AkimaraYouki/SummerProject/docs/reports/jetson_workorder_2026-08-10.md

# 작업지시 — v40 실기 주저앉음 수정 (2026-08-10)

대상: 잿슨 `parksuho@192.168.137.7` 의 `~/rl_walk.py`, `~/rustypot_hwi.py`
로봇: Open Duck Mini V2, 2.7430 kg, XM430-W350 14축, U2D2 `/dev/ttyUSB0`

이 문서만 읽고 작업할 수 있게 썼다. 배경 지식은 아래 "무슨 일이 있었나" 로 충분하다.

---

## 무슨 일이 있었나

10:07 에 배포한 `~/policy_v40/policy.onnx` 로 10:11 에 돌린 `~/rl_walk_log.csv`
(237 스텝 / 4.96 s) 분석 결과, **로봇이 0.5 초 만에 뒤로 주저앉았다.**

| t (s) | 몸통 피치 | 왼무릎 목표 | 왼무릎 실제 | 차 |
|---|---|---|---|---|
| 0.04 | −2.3° | −90.7° | −92.0° | −1.3° |
| 0.30 | −10.1° | −98.7° | −94.1° | +4.6° |
| 0.42 | −12.9° | −82.2° | −102.7° | **−20.5°** |
| 0.50 | −21.7° | −76.2° | −102.9° | **−26.7°** |
| 0.60 | −39.7° | −62.8° | −104.2° | **−41.3°** |

정책은 무릎을 **펴라고** (−99° → −63°) 명령하는데 실제 무릎은 −103° 에 붙박여 있다.
오차가 한 방향으로 단조 증가한다 — 진동이 아니라 밀림이다. 모터가 몸무게에
역구동된 것이다.

원인은 두 가지이고 **서로 독립**이다.

---

## 원인 1 — 전류 상한이 정책이 기대하는 토크의 40 % 밖에 안 된다

`~/rustypot_hwi.py`:
```python
CURRENT_UNIT_MA = 2.69
def __init__(self, port="/dev/ttyUSB0", current_limit=350):
```
`~/rl_walk.py`: `ap.add_argument("--current", type=int, default=350, ...)`

```
350 unit × 2.69 mA = 941 mA
XM430-W350 : 스톨 4.1 N·m @ 2.3 A   (토크 ∝ 전류)
→ 실기에서 낼 수 있는 토크 ≈ 4.1 × 0.941 / 2.3 ≈ 1.68 N·m
```

학습한 심의 `effort_limit_sim` 은 **4.1 N·m** 이다. 심에서 이 정책의 보행 중
무릎 토크를 실측하면:

| 관절 (심, 보행) | RMS | 99 % | 최대 | 실기 천장 |
|---|---|---|---|---|
| left_knee | 1.229 | **3.393** | 4.100 (심 클램프) | **1.68** |
| right_knee | 1.193 | 3.032 | 4.100 | 1.68 |
| left_hip_roll | 1.039 | 2.934 | 4.100 | 1.68 |

평균은 천장 아래지만 **99 퍼센타일이 천장의 두 배**다. 정책이 의존하는 피크
토크를 실기가 못 낸다.

`rl_walk.py` 주석이 이미 예고하고 있었다:
> 전류 제한 (기본 350 unit = 0.94 A) — 다리가 실제 보행 부하를 못 버티고
> 멈추면(주저앉으면) `--current` 를 올릴 것. **이 값은 걷기용으로 검증된 적이 없다.**

### 할 일 1

`--current` 를 **350 → 700** (1.88 A ≈ 3.35 N·m) 으로 올려 시험한다.
**코드 기본값은 바꾸지 말고 실행 인자로만 준다** — 되돌리기 쉽게.

```bash
python3 ~/rl_walk.py --current 700 ...   # 나머지 인자는 기존과 동일하게
```

**안전 조건 (반드시 지킬 것)**
* 로봇을 **매달아 놓고** 먼저 돌린다. 바닥에 세우지 않는다.
* 한 번에 **10 초 이내**로 끊는다.
* 매 시험 전후로 모터 온도를 읽는다. **55 °C 넘으면 즉시 중단하고 식힌다.**
  (XM430 기본 셧다운 온도는 80 °C 지만 그 전에 멈춘다.)
* 스톨 전류를 지속하면 코일이 탄다. 700 은 **피크 여유용**이지 상시 운전값이 아니다.
* 이상한 소리·발열·관절 걸림이 보이면 `sss` + 엔터로 즉시 비상정지.

**700 으로도 무릎이 안 펴지면 더 올리지 말 것.** 그건 전류 문제가 아니라는 뜻이고,
그때는 기계적 간섭이나 감속비/링키지를 의심해야 한다. 보고만 하고 멈춘다.

---

## 원인 2 — 중력 관측이 생 가속도라 오염돼 있다

`~/rl_walk.py` 413 행 근처:
```python
accel_arr = np.array(accel, dtype=np.float32)
grav_norm = np.linalg.norm(accel_arr) or 1.0
projected_gravity = -accel_arr / grav_norm     # ← 생 가속도계를 정규화한 것
```

정책이 학습한 심의 `projected_gravity_b` 는 몸통 쿼터니언에서 뽑은 **참 중력 방향**
이라 잡음이 0 이다. 실기는 접지 충격 가속도가 그대로 섞인다:

| 측정 | 값 |
|---|---|
| accel 크기 평균 | 10.09 m/s² (중력만이면 9.81 고정이어야 함) |
| 9.81 에서 벗어난 정도 | 평균 1.63, 최대 **9.01** m/s² |
| 1 m/s² 넘게 벗어난 스텝 | **64.6 %** |
| 피치 인접샘플 변화 | 평균 7.0°, 최대 **35.1°** (20 ms 간격) |

2.7 kg 로봇이 20 ms 에 35° 를 기울일 수는 없다. **정책이 매 스텝 거짓 자세를
관측하고 있다.** 관측 107 차원 중 3 개가 쓰레기면 그 위에서 나오는 액션도 쓰레기다.

### 이미 칩 안에 정답이 있다

IMU 는 **BNO055** 이고 `~/rl_walk.py` 의 `Imu._wake()` 가 `MODE_NDOF (0x0C)` 로
설정한다 — 9축 센서 융합이 **이미 돌고 있다**. NDOF 모드에서 BNO055 는 융합 결과로
중력만 분리한 벡터를 `GRV_DATA (0x2E)` 에 내놓는다. 그런데 코드는 생 가속도인
`ACC_DATA (0x08)` 를 읽고 있다. **레지스터 주소 하나 문제다.**

BNO055 레지스터 (참고):
| 주소 | 내용 |
|---|---|
| 0x08 | ACC_DATA — 생 가속도 (중력 + 선형가속도) ← 지금 읽는 것 |
| 0x14 | GYR_DATA — 자이로 |
| 0x28 | LIA_DATA — 선형가속도만 (중력 제거) |
| **0x2E** | **GRV_DATA — 중력만 (선형가속도 제거)** ← 써야 할 것 |

`GRV_DATA` 의 LSB 스케일은 `ACC_DATA` 와 같다 (m/s² 단위 모드에서 100 LSB = 1 m/s²).
즉 `ACC_LSB = 100.0` 을 그대로 쓰면 된다.

### 할 일 2

`~/rl_walk.py` 를 다음과 같이 고친다.

**(a) 레지스터 상수 추가** — `REG_ACC_DATA = 0x08` 옆에:
```python
REG_GRV_DATA = 0x2E     # BNO055 NDOF 융합 중력벡터 (선형가속도 제거됨)
```

**(b) `Imu.read()` 가 중력벡터도 돌려주게 한다.** 현재:
```python
def read(self):
    """(gyro_trunk[rad/s], accel_trunk[m/s^2, 중력 포함]) — 몸통 프레임으로 리맵."""
    a = self._vec(REG_ACC_DATA, ACC_LSB)
    g = self._vec(REG_GYR_DATA, GYR_LSB)
    g = tuple(v * math.pi / 180.0 for v in g)
    m = self.axis_matrix
    a_t = tuple(sum(m[i][j] * a[j] for j in range(3)) for i in range(3))
    g_t = tuple(sum(m[i][j] * g[j] for j in range(3)) for i in range(3))
    ...
```
여기에 `grv = self._vec(REG_GRV_DATA, ACC_LSB)` 를 추가하고, **`axis_matrix` 를
가속도와 똑같이 적용해서** (같은 센서 좌표계다) 세 번째 값으로 함께 돌려준다.
생 가속도(`a_t`)는 로그에 계속 남겨야 하니 **지우지 말 것**.

**(c) `projected_gravity` 를 융합 출력으로 바꾼다.**
```python
grv_arr = np.array(grav_trunk, dtype=np.float32)
n = np.linalg.norm(grv_arr) or 1.0
projected_gravity = -grv_arr / n
```
부호 규약은 **기존과 똑같이 유지한다** (`-vec/|vec|`). 심의
`projected_gravity_b` 는 똑바로 섰을 때 `(0, 0, -1)` 이다. 로그 첫 줄에서
기존 코드가 `(0.0394, −0.0488, −0.9980)` 을 냈으니 규약은 맞다 —
**바꾸면 안 된다.**

**(d) CSV 로그에 열 3개를 추가한다**: `grav_x, grav_y, grav_z` (융합 원값).
기존 `accel_*` 와 `proj_grav_*` 열은 **그대로 두고 추가만** 한다. 그래야 이번
로그와 다음 로그를 같은 분석기로 비교할 수 있다.

---

## 검증 (각 수정을 따로 확인할 것)

**두 수정을 한꺼번에 넣고 돌리지 말 것.** 하나씩 넣고 각각 로그를 남긴다.
그래야 어느 쪽이 효과였는지 알 수 있다. 이 프로젝트의 원칙이 "한 번에 하나만" 이다.

순서는 **원인 2 (중력) 먼저** — 코드 한 줄이고 과열 위험이 없다.

### 시험 1 — 중력 수정만 (전류는 350 그대로)
매달아 놓고 정지 명령으로 10 초. 로그를 `~/rl_walk_log_grv.csv` 로 남긴다.

합격 기준 (분석기로 자동 확인 가능):
| 항목 | 지금 | 목표 |
|---|---|---|
| 중력벡터 크기가 9.81 에서 벗어난 정도 (평균) | 1.63 m/s² | **< 0.3** |
| 피치 인접샘플 변화 (최대, 20 ms) | 35.1° | **< 5°** |

중력벡터는 정의상 크기가 항상 ~9.81 이어야 한다. 여전히 흔들리면 융합이 아직
캘리브레이션 안 된 것이다 — BNO055 캘리브레이션 상태 레지스터 `CALIB_STAT (0x35)`
를 읽어서 sys/gyro/accel/mag 각 2 bit 가 3 인지 확인하고 보고할 것.

### 시험 2 — 중력 수정 + 전류 700
**매달아 놓고** 전진 명령으로 10 초 이내. 로그를 `~/rl_walk_log_grv_cur700.csv` 로.

합격 기준:
| 항목 | 지금 | 목표 |
|---|---|---|
| 무릎 목표−실제 오차 RMS (왼) | 28.10° | **< 8°** |
| 무릎 오차가 단조 증가하는가 | 예 (41° 까지) | **아니오** |
| 몸통 피치 평균 | −35.0° | **> −10°** |

무릎 오차가 여전히 단조로 벌어지면 전류 문제가 아니다 — 더 올리지 말고 보고할 것.

### 분석 도구
랩PC 쪽 리포에 심 측정과 **같은 정의**로 재는 분석기가 있다:
```
scripts/hw/analyze_hw_log.py <로그.csv>
```
로그를 랩PC 로 가져가 이걸 돌리면 위 표의 항목이 전부 한 번에 나온다.

---

## 하지 말 것

* **전류를 700 초과로 올리지 말 것.** 안 되면 원인이 다른 데 있는 것이다.
* **바닥에 세워놓고 시험하지 말 것.** 전부 매달아 놓고 한다.
* `projected_gravity` **부호 규약을 바꾸지 말 것** (`-vec/|vec|` 유지).
* 기존 CSV 열을 **지우거나 순서를 바꾸지 말 것** (추가만).
* `~/policy_v40/policy.onnx` 를 포함해 **기존 정책 파일을 지우지 말 것.**
* `rustypot_hwi.py` 의 `current_limit` **기본값(350)을 바꾸지 말 것** — 실행 인자로만.

## 보고할 것

1. 각 시험의 CSV 파일 경로
2. 위 합격 기준 표의 실제 수치
3. 모터 온도 (시험 전/후)
4. `CALIB_STAT (0x35)` 값 (시험 1 에서 중력이 여전히 흔들릴 경우)
5. 눈으로 본 것 — 관절이 걸리는지, 소리, 발열

## 참고

* 원인 분석 전문: 랩PC 리포 `docs/reports/hw_v40_collapse_2026-08-10.md`
* 원본 로그: `docs/hw_logs/rl_walk_v40_2026-08-10.csv`
* 남은 별개 문제 (이번 작업 범위 아님): 제어 주기가 평균 21.0 ms (47.6 Hz),
  최대 76.2 ms 로 튄다. 목표는 20 ms 다. 주된 원인은 아니지만 여유를 깎는다.
* 심 쪽에서는 `effort_limit_sim` 을 실기 천장에 맞춰 재학습하는 작업이 별도로
  진행될 예정이다. 이번 시험에서 확정되는 "실제로 쓸 수 있는 전류/토크" 가
  그 목표값이 된다 — 그래서 위 수치 보고가 중요하다.
