AkimaraYouki/SummerProject/docs/versions.md

# 버전 색인

`scripts/diag/versions.py` 가 cfg 독스트링에서 생성한다. 손으로 고치지 말 것.

점수는 6 방향 우선순위 가중(앞뒤 3 : 회전 2 : 옆 1), 낮을수록 좋다.
roll RMS 는 이동 5 방향 평균, 낙상은 |roll| > 40 도 표본 비율의 최댓값 —
`scoreboard.py` 와 같은 정의다. 빈칸은 아직 측정하지 않은 버전이다.

| 버전 | 부모 | 무엇을 바꿨나 | 점수 | rollRMS | 낙상 |
|---|---|---|---|---|---|
| **V35** | V34C10 | v34c10 + 정지 시 몸통 수직을 중력벡터로 직접 요구 | 0.0232 |  |  |
| **V36** | V35 | v35 + 정지 좌우 대칭 + 액션 저역통과를 학습에 포함 | 0.0195 |  |  |
| **V37** | V36 | v36 에서 저역통과를 정지에만 건다. 한 가지만 바뀐다 | 0.0145 |  |  |
| **V38** | V37 | v37 에서 hip_inward 를 보행 중에만 건다. 한 가지만 바뀐다 |  |  |  |
| **V39** | V38 | 저역통과 필터를 완전히 빼고, 진동을 리워드로 억제한다 | 0.0179 |  |  |
| **V40** | V39 | v39 에서 action_rate 를 절반으로 낮춘다. 한 가지만 | 0.0183 | 6.28 | 2.1% |
| **V41** | V40 | 액추에이터를 DCMotor 로. 토크-속도 결합 하나만 바뀐다 | 0.0205 |  |  |
| **V42** | V41 | 대칭으로 다시 뽑은 레퍼런스(ref_g125sym). 하나만 바뀐다 | 0.0107 | 6.57 | 0.6% |
| **V43** | V42 | 액션 지연을 실측 고정값으로. 하나만 바뀐다 |  |  |  |
| **V44** | V42 | 질량 무작위화 범위를 넓힌다. 하나만 바뀐다 | 0.0336 | 6.31 | 0.6% |
| **V46** | V44 | 몸통을 10 mm 더 세운다 (ref_g135sym). 하나만 바뀐다 | 0.0169 | 6.10 | 0.8% |
| **V47** | V46 | 액션 지연을 실측에 맞춘다 (2~3 스텝). 하나만 바뀐다 | 0.0241 | 5.80 | 0.6% |
| **V48** | V47 | action_rate 를 v40 이전으로 되돌린다 (-0.25 -> -0.5). 하나만 | 0.0314 | 7.57 | 1.2% |
| **V49** | V48 | v48 + 속도 한계를 직접 낮춘다 (4.82 -> 3.50 rad/s) |  |  |  |
| **V50** | V47 | 지면 마찰을 1.0 -> 0.5 로 낮춘다. 하나만 |  |  |  |
| **V51** | V47 | 발 들림을 절반으로 (ref_g135fh20). 레퍼런스만 바뀐다 |  |  |  |
| **V52** | V51 | 보간격을 좁힌다 (feet_spacing 0.18 -> 0.14). 레퍼런스만 |  |  |  |
| **V53** | V48 | 발의 좌우 움직임을 직접 벌한다. 리워드 두 항 |  |  |  |
| **V55** | V48 | 부드러움 패키지. 발은 직선으로, 몸통·다리는 감쇠 | 0.0463 | 2.64 | 0.0% |
| **V56** | V55 | v55 + 부드러운 착지. "퉁퉁거림" 의 정체를 잡았다 |  |  |  |
| **V57** | V47 | 순수 단일축 명령을 학습에 넣는다. 1 순위를 직접 겨냥 | 0.0310 | 5.56 | 0.3% |
| **V58** | V47 | 액션 지연을 다시 넓힌다 (2~3 -> 0~3). 하나만 바뀐다 | 0.0349 | 6.17 | 0.9% |
| **V59** | V58 | v58 + 질량 무작위화를 원래 범위로. 하나만 바뀐다 | 0.0165 | 6.66 | 0.8% |
| **V60** | V59 | v59 + 몸통 각속도 감쇠. 2 순위(안정성)를 정공법으로 | 0.0304 | 3.73 | 0.6% |
| **V61** | V59 | 흔들림의 원인을 친다. 명령 상대 발 좌우 억제 | 0.0221 | 4.97 | 0.7% |
| **V62** | V61 | v61 + 옆 명령일 때 발 좌우 억제를 푼다. 하나만 | 0.0223 | 5.39 | 1.0% |
| **V63** | V59 | v59 + 미끄러운 바닥도 겪게 한다. 하나만 바뀐다 | 0.0294 | 7.06 | 1.4% |
| **V64** | V59 | 보간격을 넓힌다 (0.18 -> 0.22). 레퍼런스만 바뀐다 | 0.0303 | 5.52 | 1.2% |
| **V65** | V59 | 레퍼런스는 몸통을 수평으로 유지하라고 이미 말하고 있다 | 0.0138 | 4.89 | 1.9% |
| **V66** | V65 | 딛는 발은 정지해 있어라. 미끄러짐의 진짜 처방 | 0.0219 | 5.81 | 1.4% |
| **V67** | V65 | 쩍벌을 막는다. 벌어지는 쪽엔 제동이 없었다 | 0.0194 | 5.41 | 2.1% |
| **V68** | V65 | 낙상은 보수적으로, 토크는 세게. 탐색은 넓혀서 벌충 | 0.0204 | 4.05 | 1.1% |
| **V69** | V68 | v68 + 토크 벌점을 절반으로. 후진을 되찾는다 | 0.0232 | 4.22 | 1.8% |
| **V70** | V65 | 몸통 CoM 을 뒤로 10 mm | 0.0307 | 4.32 | 0.9% |
| **V71** | V65 | 몸통 CoM 을 뒤로 15 mm |  |  |  |
| **V72** | V65 | 몸통 CoM 을 뒤로 20 mm |  |  |  |
| **V73** | V70 | v70 + 발바닥 접지면을 키운다. 발 하나만 바뀐다 | 0.0269 | 4.71 | 1.2% |
| **V74** | V73 | 큰 발 + CoM -10 mm 위에 토크·낙상·탐색 묶음 | 0.0140 | 5.05 | 1.1% |
| **V75** | V74 | v74 + 토르소 각속도 벌점. 좌우 휘청거림을 직접 친다 | 0.0170 | 2.25 | 0.0% |
| **V76** | V75 | v75 + robustness. 도메인 랜덤화 폭만 넓힌다 |  |  |  |
| **V77** | V75 | v76 의 재시도. 외란은 그대로 두고 바닥·서보만 넓힌다 | 0.0265 | 3.11 | 0.3% |
| **V33N** | ZNeck | v33 에서 CAD 모델과 보행 궤적만 새것으로 바꾼 것 | 0.0319 |  |  |
| **V34C** | V33N | v33n 그대로 + 정지에서 보행 위상 고정 하나만 | 0.0244 |  |  |
| **V34U** | V34C10 | v34c10 + 정지 목표 자세를 몸통 수직으로 | 0.0191 |  |  |
| **V34C2** | V34C | v34c 로 부족할 때 쓸 후속: 정지 벌점을 5배로 | 0.0242 |  |  |
| **V34C10** | V34C | v34c(정지 위상 고정) + 레퍼런스 높이 +10 mm (ref_g125) | 0.0195 |  |  |
| **V34C20** | V34C | v34c(정지 위상 고정) + 레퍼런스 높이 +20 mm (ref_g135) | 0.0216 |  |  |
