AkimaraYouki/SummerProject/docs/map.md

# 어디에 뭐가 있나

2026-07-30 작성. `scripts/`에 34개 파일이 평평하게 쌓여 있어서 뭘 열어야 할지
알 수 없다는 지적을 받고, 폴더를 나누면서 같이 쓴 지도다.

## 먼저 이것만 알면 된다

거의 모든 일은 `odm` 하나로 한다. 나머지는 대부분 "그때 한 번 쓴 것"이다.

    odm train  [ver] [iters] [envs]   학습
    odm watch  [ver]                  진행 한 줄
    odm play   [ver]                  재생 (네이티브 창)
    odm play   [ver] --joystick       Xbox 패드로 실시간 조종
    odm measure[ver] [iter]           6방향·주기성·리워드 성분 (iter 주면 그 체크포인트)
    odm tb     [from]                 텐서보드 (기본 v26부터 겹침)
    odm test                          테스트 전부
    odm stop / odm list

## 실험을 판정할 때 쓰는 것 (2026-07-30 추가)

학습 중에는 Isaac Sim 을 두 개 못 띄우므로 `odm measure` 를 못 쓴다. 그래서
**학습 중에 쓰는 것**과 **끝난 뒤에 쓰는 것**이 갈린다.

학습 중 (GPU 불필요, 텐서보드 이벤트만 읽는다):

    scripts/train_health.py --run <런디렉터리>
        lr 바닥 / std 붕괴 / 에피소드 포화 / **리워드 해킹**을 판정한다.
        판정 기준은 이 프로젝트가 실제로 겪은 실패에서 가져왔다.
    scripts/diag/compare_runs.py <런A> <런B> [--at 500 1000 ...]
        여러 런을 **같은 iteration** 에서 맞댄다. 최종값 비교는 더 오래 돈 쪽이
        이기므로 무의미하다.

학습 후 (GPU 필요):

    odm measure <ver> [iter]              6방향 명령 추종
    scripts/diag/reward_terms.py          학습된 정책의 항목별 리워드 균형
    scripts/diag/torso_vs_hip.py          몸통 roll RMS, 고관절 이탈, 둘의 상관

**같은 iteration 끼리 재라.** v26 은 v25@1500 의 두 배를 학습하고도 명령 추종이
89% -> 81% 로 나빠졌다. 학습량이 다르면 무엇 때문인지 갈라낼 수 없다.

## 레퍼런스 보행을 새로 만들 때

    odm refgen --height 0.175 --out ref_h175

로봇 키 손잡이는 medium 프리셋의 `walk_com_height` 다 (0.16 -> 서는 높이 121 mm).
`fast.json` 의 0.21 은 `auto_waddle` 이 `preset_speeds = ["medium"]` 로 고정돼
있어 **쓰이지 않는다** — 그걸 고쳐봐야 아무 일도 안 일어난다.

**이 PC 에서 돈다 (2026-08-08 부터).** 전에 "placo 를 못 깐다" 고 적어둔 건 원인
진단이 틀렸다 — 설치하려던 `~/.odm-tools` 의 numpy 가 2.x 라서 cmeel 스택이
wheel 을 못 고르고 소스 빌드로 떨어진 것이었다. numpy==1.26.4 를 먼저 박은 전용
venv(`~/.placo-env`)에 깔면 42개가 전부 wheel 로 들어온다. 랩PC 와 같은 프리셋·
같은 URDF 로 생성해 비교했더니 **500x55 프레임이 비트 단위로 일치**했다.
순수 CPU(32코어, `-j16`) 라 GPU 학습과 병행된다.
랩PC 원격판은 `scripts/setup/gen_reference_remote.sh` 로 남겨 뒀다.

**레퍼런스만 바꿔서는 키가 안 바뀐다.** 이어서:
  1. `scripts/diag/calc_home.py --pkl <새pkl>` -> READY_JOINT_POS
  2. `scripts/diag/settle_height.py --task <새태스크>` -> 실제 안착 높이
     (cfg.ready_base_height / 스폰 높이). settle_pose.py 는 전역 설정만 재서
     새 태스크에 못 쓴다 — legacy/ 로 옮겼다.
  3. 새 cfg 클래스 + 태스크 등록 + 학습
기본 자세와 레퍼런스가 어긋나면 액션이 도달 불가능해진다 — v1~v9 가 아홉 번
실패한 원인이 그것이다.

## 실제 코드는 여기 (source/)

RL 환경과 정책 설정. **고칠 게 있으면 십중팔구 여기다.**

    source/open_duck_mini_isaaclab/
      tasks/velocity/
        joystick_env.py        환경 본체 — 관측·리워드·종료·리셋
        joystick_env_cfg.py    버전별 설정 (v13, v17, v24, v25/v26 Path ...)
        rewards.py             리워드 항 계산식
        observations.py        관측 잡음·지연 버퍼
        events.py              도메인 무작위화
      agents/
        rsl_rl_ppo_cfg.py      PPO·네트워크 설정 (obs_groups 포함)
        rsl_rl_compat.py       rsl-rl 2.x -> 5.0.1 이식 계층
      reference_motion/
        poly_reference_motion.py   레퍼런스 보행을 다항식에서 복원
      joint_order.py           관절 순서·인덱스 — 여기 틀리면 전부 조용히 틀린다
      robot_cfg.py             로봇 자산(USD)·액추에이터 설정
      joystick_input.py        Xbox 패드 (joydev 직접 읽기, 의존성 없음)
      symmetry.py              좌우 미러 (관절·관측) + rsl-rl symmetry_cfg 연결
      tasks/task_registry.py   태스크 -> 환경/러너 설정 매핑 (여기 한 곳만 고친다)

## scripts/ — 목적별로 나눠뒀다

**최상위 = 매일 쓰는 것.** `odm`이 부르거나, 손으로 자주 부르는 것들.

    odm                    진입점
    _isaaclab_launch.py    gym.register 를 먼저 돌리는 런처 shim
    play_fixed_cmd.py      재생 (명령 고정/순환/조이스틱, 오버레이, HUD)
    gait_compare.py        6방향 명령 추종      ┐
    joint_periodicity.py   관절 주기성          ├ odm measure 3단계
    imit_internals2.py     모방 리워드 내부     ┘
    train_health.py        학습 중 건강 체크 + 리워드 해킹 판정 (GPU 불필요)
    joystick_check.py      패드 입력 눈으로 확인 (--raw 로 축 번호)
    leg_fk.py              다리 순기구학 — play_fixed_cmd 가 import 한다
    mujoco_infer.py        sim2real 검증 (ONNX 이식 때 쓸 것, 아직 미착수)

**scripts/diag/ — 진단.** 뭔가 이상할 때만 연다. 대부분 한 번 쓰고 결론이
`docs/training_log.md`에 적힌 것들이다.

    reward_terms.py               학습된 정책의 항목별 리워드 균형 (환경이 기록한 값을 그대로 읽는다)
    torso_vs_hip.py               몸통 roll RMS · 고관절 이탈 · 둘의 상관
    compare_runs.py               여러 런을 같은 iteration 에서 비교 (GPU 불필요)
    settle_height.py              태스크의 READY 자세로 놓았을 때 실제 안착 높이 (GPU 필요)
    derive_mirror.py              좌우 미러 매핑을 레퍼런스에서 유도 (GPU 불필요)
    reward_at_ready.py            READY 자세로 가만히 있을 때 각 항이 주는 값
    contact_diagnostic.py         몸통/머리/발 접촉력 실측
    selfcol_diag.py               자기충돌 켜면 어떤 종료가 터지는지
    eval_policy_stability.py(.sh) 정책 안정성 지표
    check_joint_stability.py(.sh) 액추에이터 게인 점검 (RL 무관)
    ref_stats.py                  레퍼런스 신호 분포
    ref_vs_robot.py               레퍼런스 vs 실제 관절각
    pose_detail.py                몸통 roll/pitch/yaw + 드리프트
    viz_home.py                   홈 자세 시각화
    calc_home.py / head_level.py  홈 자세·머리 수평 계산
    lock_test.py                  머리 관절 잠금이 실제로 먹는지

**scripts/setup/ — 자산 준비.** 로봇을 처음 들여올 때 한 번.

    gen_reference_local.sh                 레퍼런스 보행 생성 (이 PC, odm refgen)
    gen_reference_remote.sh                레퍼런스 보행 생성 (랩PC 원격, 예비)
    convert_urdf.sh / convert_urdf_cd.py   URDF -> USD (cd 는 convex decomposition)
    patch_urdf_for_placo.py                Placo 가 요구하는 프레임 별칭 확인
    apply_local_urdf_overrides.py          임포트가 덮어쓰는 로컬 수정 재적용
    generate_reference_motion.sh           레퍼런스 보행 생성 (placo 필요)

**scripts/legacy/ — 더 나은 것으로 대체됐다.** 지우지 않고 남겼을 뿐,
새로 쓰지 말 것.

    train.sh / play.sh              -> odm
    reward_breakdown.py / _v2.py    -> diag/reward_terms.py
         (리워드 수식을 스크립트에 복제해 놔서 환경과 어긋난다.
          실제로 Path 태스크를 몰라 KeyError 로 죽었다.)
    imit_internals.py               -> imit_internals2.py
    settle_pose.py                  -> diag/settle_height.py
         (전역 설정만 재서 새 태스크에 못 쓴다.)

## 나머지

    tests/                 Isaac Sim 없이 도는 테스트. `odm test` 로 한 번에.
    docs/
      map.md               (이 파일)
      training_log.md      v1~v26 무엇을 왜 바꿨고 어떻게 됐는지 — 가장 중요한 기록
      decisions.md         포팅 단계에서의 설계 결정
      handoff/             기계를 옮기며 남긴 인수인계 + 세션 메모리
      isaaclab_setup.md, onshape_import.md, webrtc_streaming.md
    robot/                 URDF / USD / 메시
    reference_motion_generator/   레퍼런스 보행 생성기 (upstream 코드)
    logs/rsl_rl/...        학습 런 (체크포인트 + 텐서보드 이벤트)
    outputs/               일회성 산출물

## 알아둘 함정

- **경로에 공백이 있다** (`Extreme SSD`). `$(ls ...)`를 `for`에 쓰면 단어가
  쪼개진다. glob 이나 `while read` 를 쓸 것.
- **Isaac Sim 두 개 동시 실행 금지.** 한쪽이 조용히 죽는다. `odm`이 막는다.
- **ROS Humble 의 PYTHONPATH 가 샌다.** Isaac 파이썬(3.11)에 ROS 의 3.10
  site-packages 가 들어와 엉뚱한 곳에서 죽는다. `odm test` 는 그래서
  `env -u PYTHONPATH` 로 돈다.
- **드라이버 595.84 는 RTX 렌더러를 깬다.** 580.173.02 를 쓴다.
  (`docs/handoff/README.md` 참고)
- **안착 높이는 스폰이 낮으면 측정이 오염된다.** 발이 지면을 파고들면 PhysX 가
  튕겨내서 안착값이 스폰보다 높게 나온다. 충분히 높은 데서 떨어뜨릴 것.
- **오래 학습할수록 명령 추종을 잃는다** (v25@1500 > v26@2999,
  v27@1500 > v27@2000). 1500 과 최종을 둘 다 재고 같은 iteration 끼리 비교.
- **리워드 수렴은 행동 수렴이 아니다.** v26 은 곡선이 평평해진 뒤에도
  명령 추종이 계속 나빠졌다.
