AkimaraYouki/SummerProject/docs/poster/poster.html

학부 여름 연구 · 2026-07-17 → 2026-08-14

# 측정이 뒤집은 네 가지 믿음

이족 보행 로봇 Open Duck Mini V2 를 강화학습으로 걷게 하고 실제 하드웨어로 옮기는 과정. 4 주 동안 그럴듯한 가설이 네 번 측정에 뒤집혔고, 그 기록이 이 연구의 실제 내용이다.

발표자 박수호 소속 지도 Isaac Lab 0.54 · rsl-rl 5.0 · RTX 5080 · Jetson Orin Nano

29 일CAD 에서 실기 보행까지

6.3 ×회전 추종 회복

290커밋

59학습 런 (v1 → v59)

14 축Dynamixel XM430-W350

151.8 초최장 연속 보행

## 00결과

2026-08-13, 로봇이 처음으로 자기 발로 걸었다. 시뮬레이터에서 학습한 정책을 수정 없이 그대로 실기에 올려서다. 며칠 동안 "앞으로 꼬꾸라진다" 던 것의 원인은 정책도, 게인도, 무릎 고장도 아니었다.

📷 실기 보행 연속 사진 가로로 긴 사진 또는 스트립 (권장 3:1)

정책은 Isaac Lab 에서 PPO 로 학습한 뒤 ONNX 로 내보내 Jetson 에서 50 Hz 로 추론한다. 관절 목표각은 Dynamixel 전류제한 위치제어(모드 5)로 나간다.

## 01파이프라인

CADOnShape 조립체

→

MODELURDF → USD
질량·관성 기입

→

REFplaco 로 뽑은
모방용 보행 궤적

TRAINIsaac Lab PPO
4096 env · 3000 iter

→

EXPORTONNX
107 → 512 → 256 → 128 → 14

→

DEPLOYJetson 50 Hz
XM430 × 14

정책은 관측 107 차원(관절각·각속도·자이로·투영중력·명령·모방 위상· 이전 액션)을 받아 14 관절의 목표각 오프셋을 낸다. 보행 궤적을 모방하는 리워드가 전체의 지배적 항이다.

## 02연구 방법

이 프로젝트에서 반복해서 확인한 것은 지표가 사람을 속인다 는 사실이다. 그래서 방법을 규칙으로 굳혔다.

- 심과 실기를 같은 자로 잰다. 같은 열 이름, 같은 정의로 로그를 남긴다. 정의가 다르면 sim2real 갭인지 측정 방법 차이인지 구분할 수 없다.
- 한 번에 하나만 바꾼다. 학습 런마다 부모 설정과 바뀐 항목 하나, 그리고 판정 기준을 문서에 적고 시작한다.
- 리워드 계수를 추정하지 않는다. 새 항을 넣기 전에 기존 정책에서 원시값을 재고 목표 비중으로 역산한다.
- 보상으로 걸음을 판정하지 않는다. 보상이 오르면서 걸음이 나빠지는 경우가 실제로 있었다.

규칙이 생긴 계기는 대부분 실패다. 아래 원장의 네 항목이 각각 위 규칙 하나씩을 만들었다.

## 03진단 원장 — 측정이 뒤집은 것들

1 "왼쪽 무릎이 고장났다"

믿음

왼무릎만 목표각을 22.9° 못 따라간다. 분해해 보니 유독 뻣뻣하다. 서보 교체를 검토했다.

측정

서보 49 개 레지스터를 전 축 덤프해 좌우 비교 → 설정 동일. 보행 중 버스 전압을 로깅 → 8.6 V 로 붕괴 (XM430 최소 동작전압 9.5 V).

사실

전원 문제였다. USB-PD 어댑터의 12 V / 3 A 로는 보행 전류를 못 댄다. 측정된 5.22 A 는 로봇의 수요가 아니라 어댑터의 상한이었다.

2 "발을 7 Hz 로 떨고 있다"

믿음

접지 전환을 세니 걸음 주기가 195 ms — 레퍼런스 540 ms 의 4 분의 1. 리워드 해킹으로 판단하고 해당 정책을 실기에서 배제했다.

측정

접지 신호를 디바운스해 다시 계산 → 40 ms 에서 모든 정책이 540 ms 로 수렴.

사실

걸음 주기는 처음부터 옳았다. 달랐던 것은 한 스텝 안에서 발이 착지하며 튀는 정도다. 걸음이 가짜였던 게 아니라 착지가 거칠었던 것 — 사용자가 계속 말한 "퉁퉁거림" 의 정체였다.

3 "발 리워드가 걸음을 부드럽게 했다"

믿음

발의 좌우 속도를 벌하는 항을 넣자 몸통 roll 이 20.7° → 11.0° 로 절반이 됐다. 성공으로 보고했다.

측정

발 링크의 월드 좌표 z 를 찍어 보니 [0.329, 0.016] m. 몸통이 0.19 m 인데 "발" 하나가 0.33 m 에 있을 수 없다.

사실

접촉센서의 body 인덱스를 아티큘레이션에 그대로 썼다. 두 목록의 순서가 달라 [5] 가 발이 아니라 머리였다. roll 이 준 것은 발이 아니라 머리의 좌우 속도를 벌한 결과였고, 그래서 옆걸음이 명령의 60 % 로 무너졌다.

4 "좌우와 회전은 리워드로 고친다"

믿음

측정한 25 개 정책 전부 좌/우가 전진보다 2~4 배 나빴고, 회전은 한 시점에 17 배 꺾인 뒤 돌아오지 않았다. 리워드 계수를 여러 방향으로 바꿨지만 안 고쳐졌다.

측정

학습의 명령 분포를 의심해 순수 단일축 명령을 35 % 넣었다 → 회전 0.0672 → 0.0666, 변화 없음. 가설 기각. 그래서 회전이 꺾인 구간의 변경 셋을 하나씩 되돌리는 대조 실험을 했다.

사실

두 개의 독립된 원인이 서로를 가리고 있었다. 액션 지연 범위를 좁힌 것이 회전을, 질량 무작위화 범위를 넓힌 것이 앞뒤를 망쳤는데 — 좁은 지연이 질량 손해를 가려 주고 있어서 하나만 되돌리면 매번 다른 쪽이 나빠졌다. 둘 다 되돌리자 회전이 6.3 배 회복됐다.

✓ 대조 실험 — 한 번에 하나씩 되돌리기

구성 | 지연 | 질량 | 앞뒤 | 회전 | 점수
v42 | 0~3 | 원래 | 0.0098 | 0.0040 | 0.0131
v47 | 2~3 | 확대 | 0.0115 | 0.0672 | 0.0241
v57 +순수축 명령 | 2~3 | 확대 | 0.0199 | 0.0666 | 0.0310
v58 지연만 되돌림 | 0~3 | 확대 | 0.0377 | 0.0342 | 0.0349
v59 둘 다 되돌림 | 0~3 | 원래 | 0.0153 | 0.0106 | 0.0165

v58 한 줄만 보면 "지연을 넓히면 앞뒤가 6.7 배 나빠진다" 로 읽힌다. 실제로는 넓은 지연이 이미 있던 질량 손해를 드러냈을 뿐이다. 교란된 두 변수는 한쪽만 바꿔서는 정체를 알 수 없다.

## 04전원 — 단일 최대 효과

전원만 바꾸고 다른 것은 하나도 안 바꾼 대조 실험.

항목 | PD 어댑터 | 전원 교체 후
버스 전압 최저 | 8.6 V | 11.2 V
다리 합계 전류 최대 | 5.22 A | 10.12 A
왼무릎 평균 추종오차 | +22.9° | +2.7°
접지 전환 | 1.56 /s | 8.26 /s
몸통 pitch 범위 | −33 ~ +34° | −0.4 ~ +16.9°

부하 쪽 계측만 보고 공급이 충분하다고 판단하면 안 된다. 전류계는 어댑터의 상한을 로봇의 수요로 보여 준다.

## 05sim2real 계약

심의 액추에이터 파라미터와 실기 서보 레지스터를 같은 물리 단위로 환산해 하나씩 맞췄다.

항목 | 심 | 실기 (조정 후) | 일치
관절 강성 | 37.65 | 37.65 (P=1402) | 100 %
관절 감쇠 | 1.352 | 1.010 (D=4700) | 75 %
토크 상한 | 4.10 N·m | 3.16 N·m | 77 %
속도 상한 | 4.82 rad/s | 4.82 rad/s | 100 %

강성 환산: kp = (P/128) × 토크/전류단위 ÷ 틱당 라디안. 기본값 P=800 은 21.48 N·m/rad 로 심의 57 % 였다 — 정책이 명령한 위치에 실제 관절이 못 가던 것의 정체다.

### 관절 추종 · vx = +0.15

관절 | 심 이득 | 실기 이득 | 심 지연 | 실기 지연
L.knee | 0.69 | 0.76 | 40 ms | 64 ms
R.knee | 0.71 | 0.83 | 20 ms | 64 ms
L.hip_roll | 0.70 | 0.86 | 20 ms | 43 ms

강성을 맞추자 실기가 심보다 잘 따라간다. 무릎이 명령보다 25 % 덜 움직이는 것은 하드웨어 부족이 아니라 심에서도 똑같이 일어나는 물리(체중)다. 남은 갭은 지연 하나이고, 그것이 다음 문제로 이어진다.

## 06발 미끄러짐

실기가 걷기 시작하자 제자리에서 도는 드리프트가 나타났다. 두 발이 모두 땅에 있는 이중지지 구간의 요 각속도를 보면 미끄러짐이 직접 드러난다 — 두 발이 땅에 있으면 몸통은 돌 수 없어야 한다.

항목 | 패드 전 | 3 mm 고무패드
이중지지 요 각속도 | 0.672 | 0.167 rad/s
요 드리프트 | 24 °/s | ~1 °/s
연속 보행 시간 | 26.6 s | 151.8 s
수직 가속도 RMS | 6.46 | 3.92
착지 피크 (중앙값) | 2.39 g | 2.12 g

심의 이중지지 요 각속도는 −0.069 rad/s 다. 패드 후 0.167 은 아직 심보다 크지만, 패드 전 0.672 은 물리적으로 불가능한 값이었고 그것이 미끄러짐의 증거였다.

📷 발바닥 고무패드 패드 전 / 후 비교 (권장 4:3)

## 07평가 — 무엇을 재느냐가 결론을 정한다

한동안 판정을 전진 한 방향으로만 했다. 그 자로는 두 정책이 0.0231 대 0.0234 로 구분되지 않았는데, 여섯 방향으로 재자 최악 방향이 0.0298 대 0.0878 로 3 배 갈렸다. 평가 기준을 바꾸자 "성공" 이라고 보고했던 정책이 최하위가 됐다.

### 우선순위 가중 판정 · 앞뒤 3 : 회전 2 : 옆걸음 1

정책 | 앞뒤 | 회전 | 옆걸음 | 가중 점수 | 비고
v40 | 0.0065 | 0.0114 | 0.0294 | 0.0121 | 추종 최고점
v42 | 0.0098 | 0.0040 | 0.0318 | 0.0131 | 회전 최고
v47 | 0.0115 | 0.0672 | 0.0190 | 0.0241 | 액션지연 2~3 스텝
v48 | 0.0211 | 0.0644 | 0.0258 | 0.0307 | action_rate 되돌림
v55 | 0.0242 | 0.0782 | 0.0806 | 0.0463 | 발 인덱스 버그
v59 | 0.0153 | 0.0106 | 0.0263 | 0.0165 | 지연·질량 둘 다 되돌림

### 퇴행 역추적

무엇이 | 언제 | 바뀐 것 | 얼마나
회전 붕괴 | v42 → v47 | 액션 지연 0~3 → 2~3 스텝 | 0.0040 → 0.0672 (17×)
앞뒤 붕괴 | v47 → v48 | action_rate −0.25 → −0.5 | 0.0115 → 0.0211 (1.8×)
회전 회복 | v47 → v59 | 지연 2~3 → 0~3, 질량 확대 → 원래 | 0.0672 → 0.0106 (6.3×)
옆걸음 | 전 버전 | 원인 미확정 | 항상 전진의 2~4 배

지연은 줄일 수 없었다. 통신 타이밍을 직접 재니 매 루프 약 13 ms 로 20 ms 예산의 65 % 다. Return Delay 를 낮추면 반이중 버스의 방향 전환이 모자라 통신이 깨지고, FTDI 지연 타이머는 이미 최소, 읽기는 이미 한 블록으로 합쳐져 있다. 43 ms 는 하드웨어의 사실이므로, 지연을 없애는 대신 그 지연 아래에서 회전을 제대로 가르치는 방향으로 갔다.

## 08도구

결론을 바꾼 것은 모델이 아니라 측정 도구였다. 각 도구는 한 번의 오진에서 태어났다.

- track_stats.py — 심과 실기의 관절추종을 같은 정의로. 강성이 맞았는지 판정
- verdict.py — 6 방향을 우선순위 가중으로 판정. 전진만 보던 것을 교정
- probe_terms.py — 새 리워드 항의 원시 크기를 재고 계수를 역산. 정지 명령에서 0 인지 확인
- bus_timing.py — 제어 루프의 시간이 어디로 가는지. 지연을 못 줄인다는 근거
- gain_report.py — 서보 레지스터를 물리 단위로 환산해 출력. "1402 가 800 보다 크다" 이상을 보려고

📷 실험 환경 로봇 · Jetson · 전원 (권장 4:3)

## 09현재 최고 · 남은 것

### 실기에 올라간 정책

배포 v59 — 우선순위 점수 0.0165. 회전 명령의 99 %, 전진의 109 % 를 달성한다. 토크 제곱합(7.91)과 접지 바운스(1.22)도 측정한 전 버전 중 가장 낮다.

명령 | 달성률 | | 명령 | 달성률
전진 | 109 % | | 좌 | 89 %
후진 | 92 % | | 우 | 89 %
회전 | 99 % | | 정지 | 최대 기울기 16°

### 확인되지 않은 것

- 미확정실기 무게를 아직 안 쟀다. 심 모델은 2.6404 kg 인데 문서에는 2.7430 kg 으로 적혀 103 g 이 어긋나 있다. 질량 무작위화 범위를 실측 근처로 좁히는 것이 다음 개선이다.
- 미확정옆걸음은 여전히 전진의 2 배다. 지연·질량 어느 쪽으로도 설명되지 않았다.
- 미확정실제 바닥 마찰계수. 심은 0.5~1.0 을 가정한다.
- 미확정오도메트리가 없어 실기에서는 경로 오차를 정책에 되먹일 수 없다. 요 드리프트의 잔여분이 여기서 온다.

## 10배운 것

### 측정 없이 말하지 않는다

네 번의 오진이 모두 같은 형태였다 — 그럴듯한 인과를 먼저 세우고 그것에 맞는 지표를 골랐다. 전류계는 어댑터의 상한을 로봇의 수요로 보여 줬고, 접지 카운터는 착지 바운스를 리워드 해킹으로 보여 줬다. 지표가 무엇을 재는지 확인하는 것이 지표를 읽는 것보다 먼저다.

### 평가 기준이 곧 최적화 대상이다

전진만 재는 동안 정책은 전진만 잘하게 됐고, 실제로 한 정책은 우선순위와 정확히 반대로 — 가장 덜 중요한 옆걸음만 제일 잘하도록 — 최적화돼 있었다. 무엇을 재느냐가 무엇을 얻느냐를 정한다.

### 교란된 원인은 하나씩 되돌려야 보인다

회전과 앞뒤를 망친 원인은 서로 달랐고, 한쪽이 다른 쪽을 가리고 있었다. 하나만 되돌릴 때마다 매번 다른 지표가 나빠져서 "이 변경은 해롭다" 는 잘못된 결론이 나왔다. 변경 이력을 하나씩 되돌려 격자로 채우기 전에는 어느 것도 범인이라 부를 수 없다.

### 실패를 기록으로 남긴다

모든 학습 설정에 부모 · 바뀐 항목 하나 · 판정 기준 · 결과를 적었다. 철회한 가설도 지우지 않고 왜 틀렸는지 함께 남긴다. 같은 길을 두 번 파지 않기 위해서다.

Open Duck Mini V2 · Isaac Lab sim-to-real 2026-07-17 → 2026-08-14 · 300+ commits · v1 → v59 측정치는 모두 실측이며 재현 절차가 저장소에 있다
