AkimaraYouki/SummerProject/docs/kspe/figures/그림1_6방향_추종평가.png

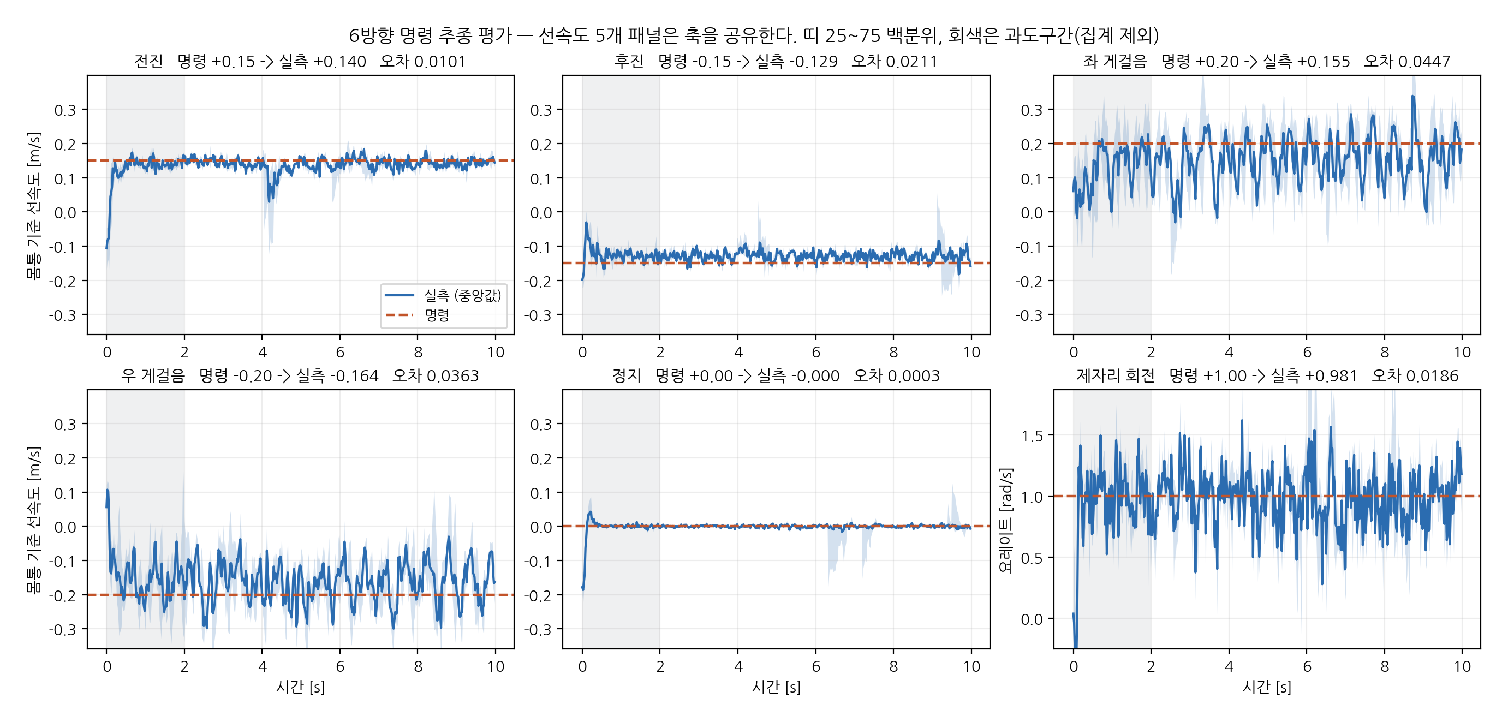
docs/kspe/figures/그림1_6방향_추종평가.png
