AkimaraYouki/SummerProject/docs/kspe/figures/그림2_학습곡선.png

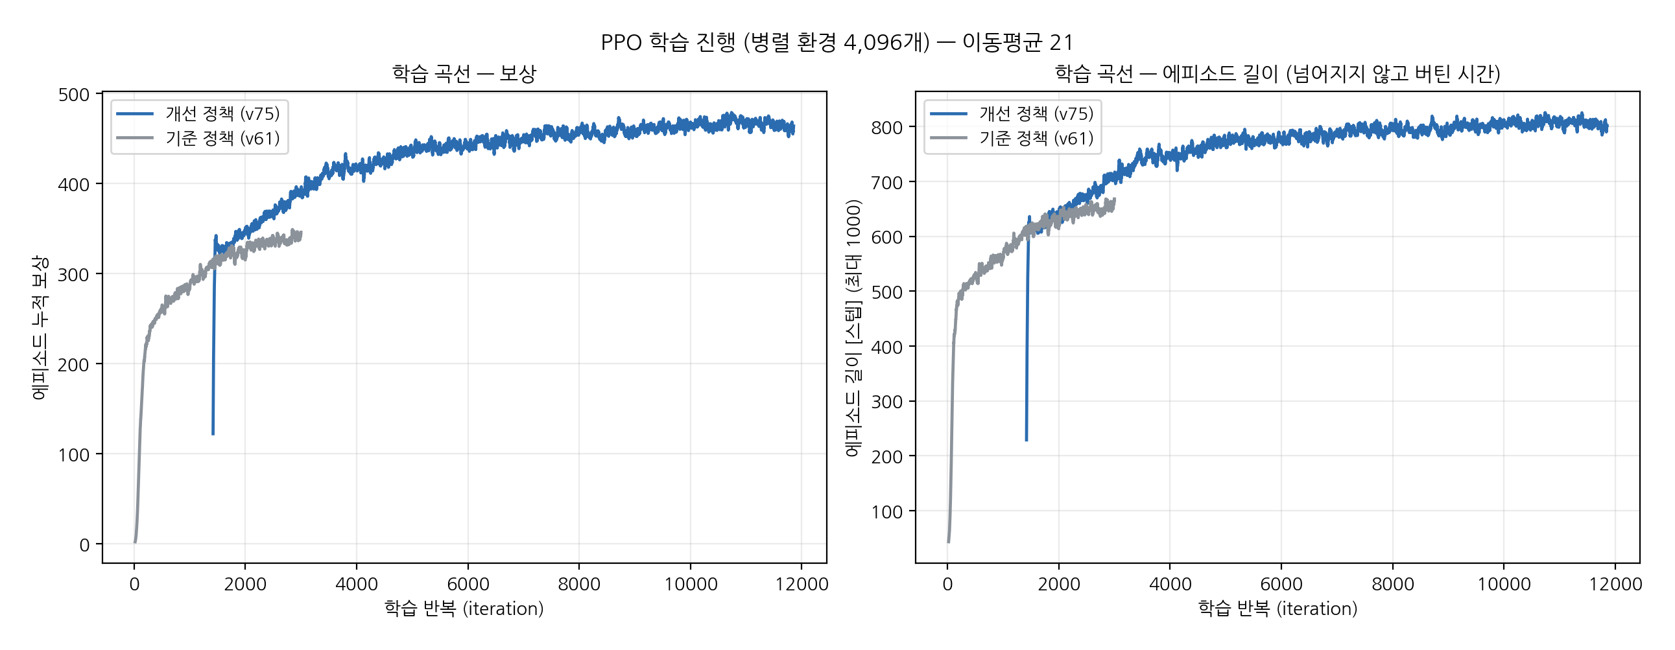
docs/kspe/figures/그림2_학습곡선.png
