AkimaraYouki/SummerProject/docs/kspe/figures/그림3_성능개선_비교.png

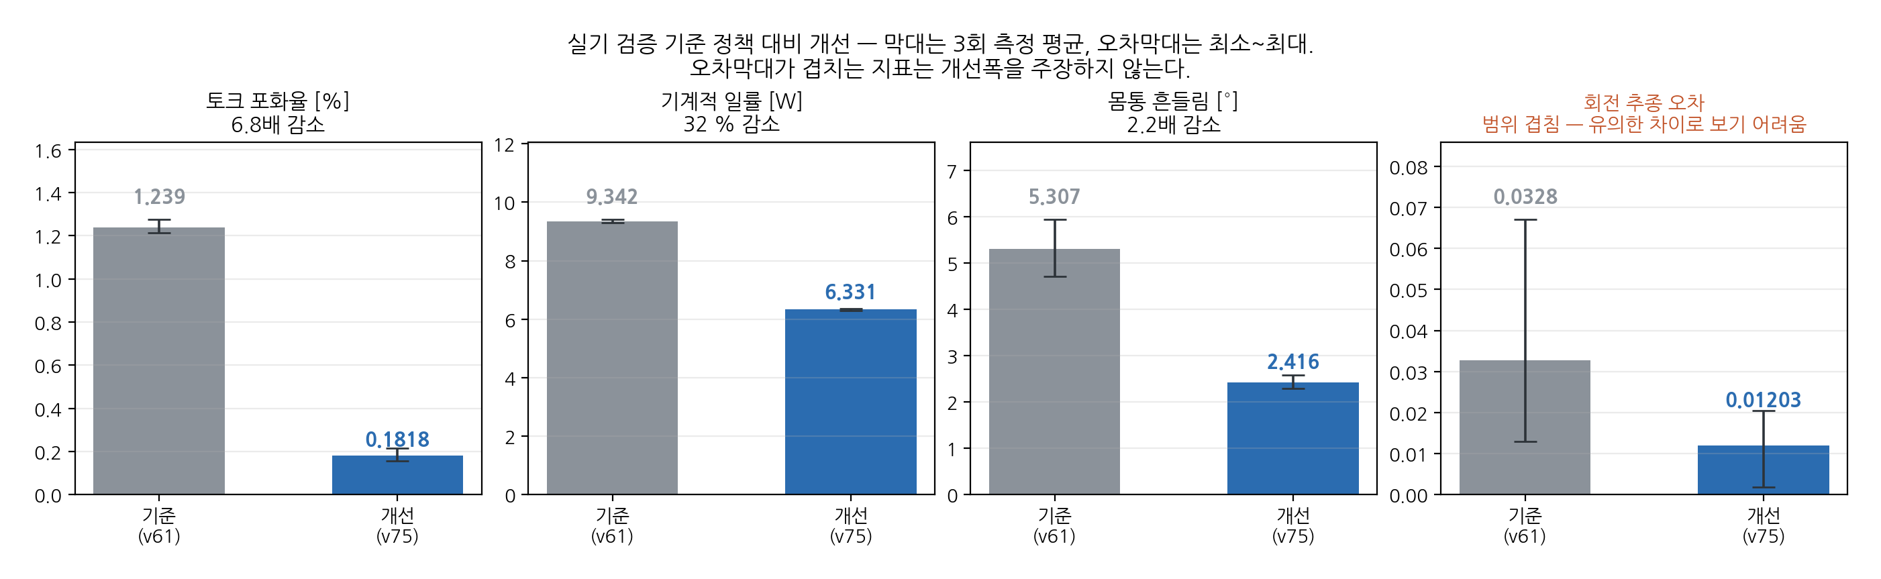
docs/kspe/figures/그림3_성능개선_비교.png
