AkimaraYouki/SummerProject/docs/kspe/figures/그림4_측정_재현성.png

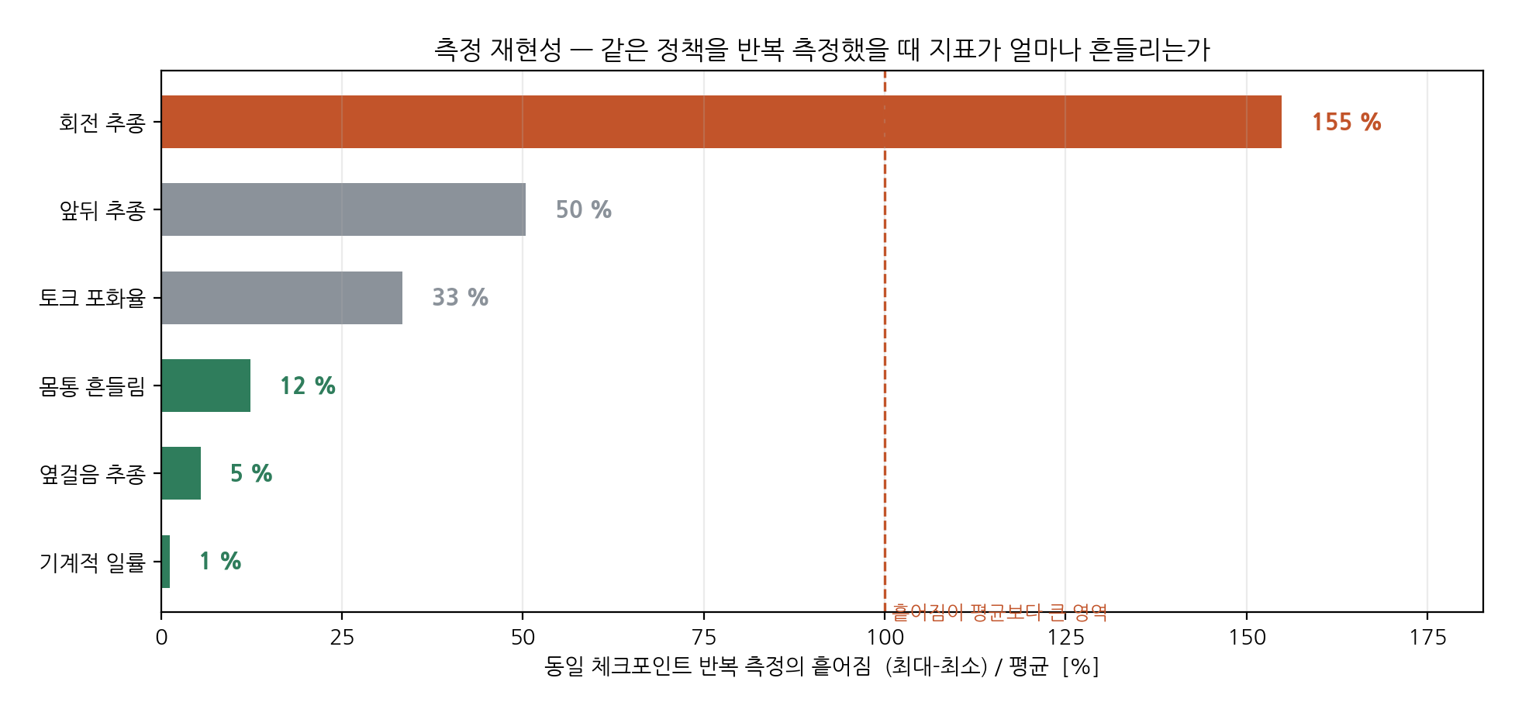
docs/kspe/figures/그림4_측정_재현성.png
