AkimaraYouki/SummerProject/docs/kspe/figures/그림5_관절별_피크토크.png

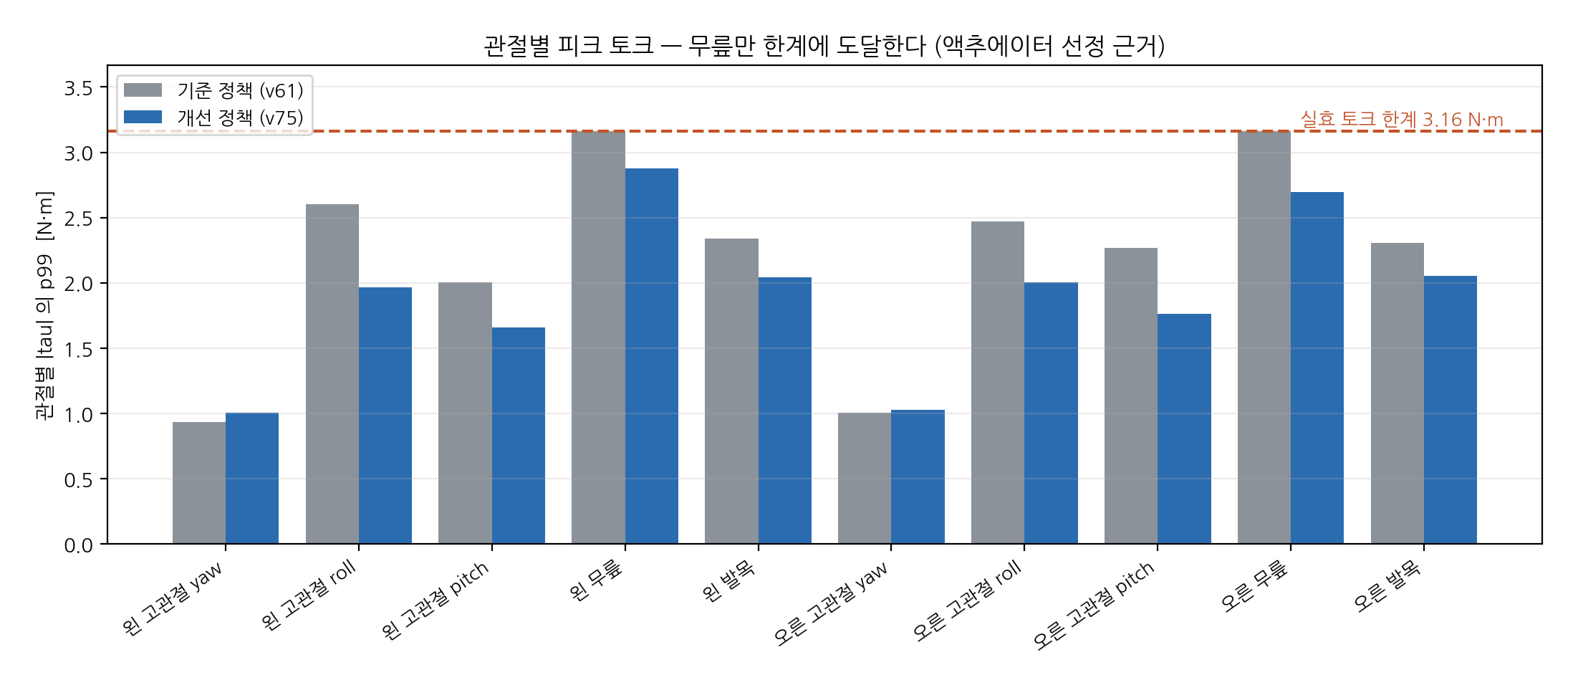
docs/kspe/figures/그림5_관절별_피크토크.png
