AkimaraYouki/SummerProject/docs/kspe/figures/그림6_정책_성능분포.png

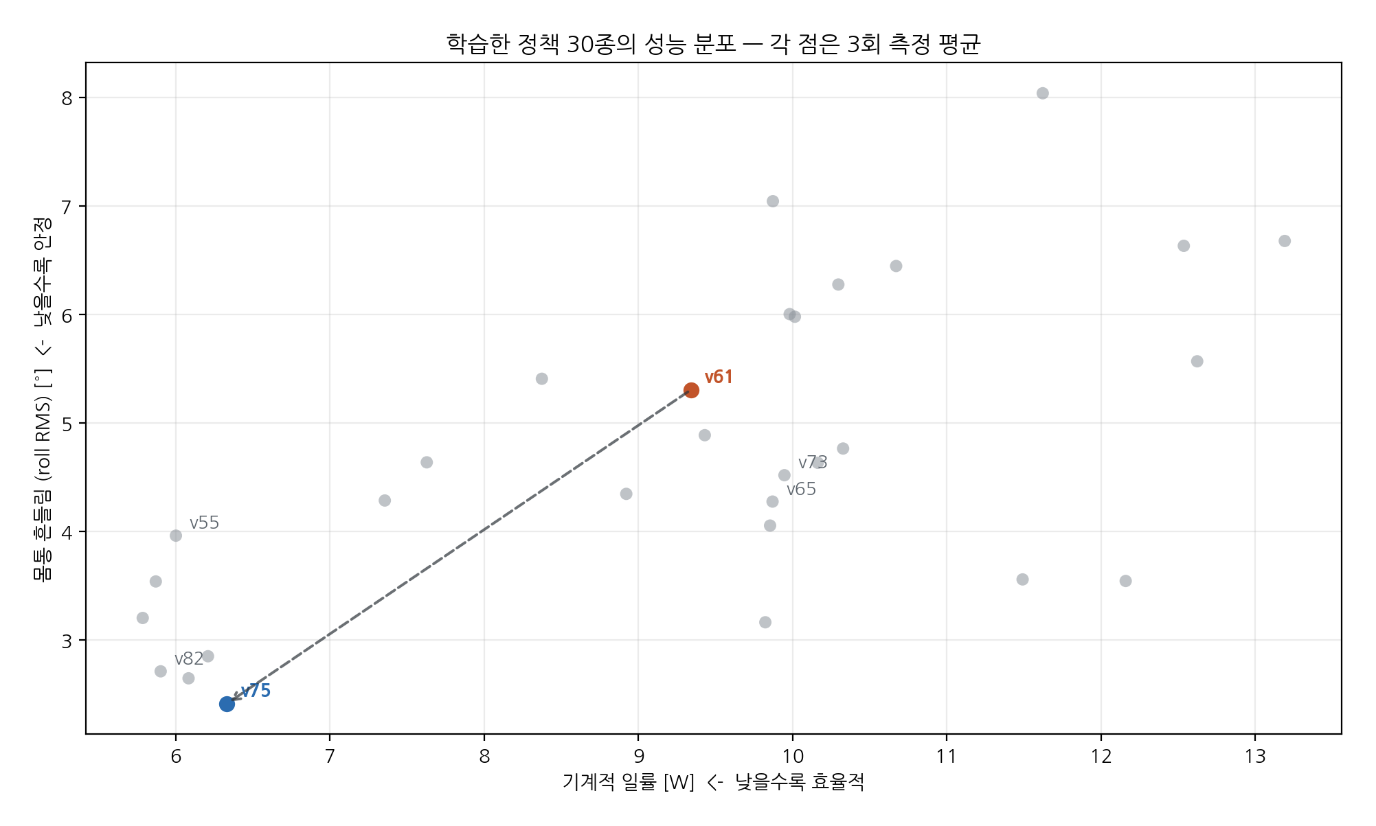
docs/kspe/figures/그림6_정책_성능분포.png
