AkimaraYouki/SummerProject/big_foot/assets/body_middle.stl

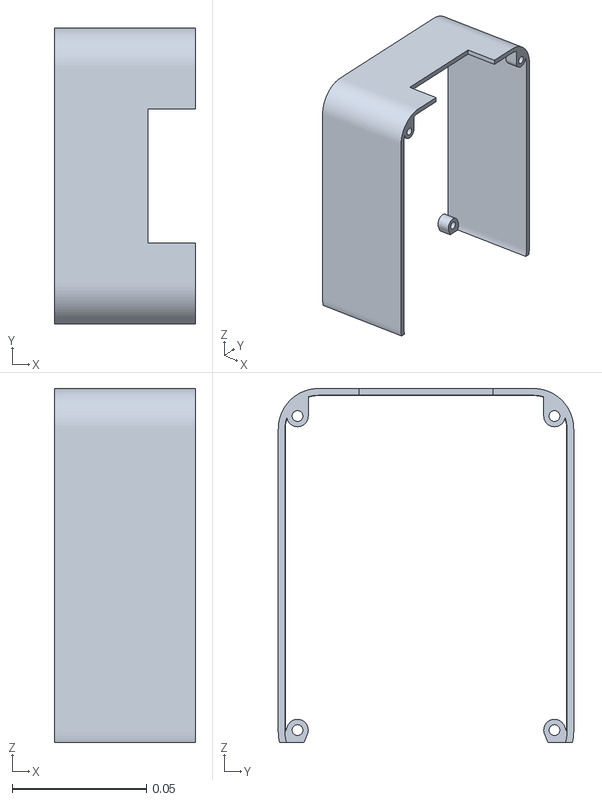
[picture p7: CAD file, 2026-08-19]
big_foot/assets/body_middle.stl
0.0525 x 0.11 x 0.132
