AkimaraYouki/SummerProject/reference_motion_generator/open_duck_reference_motion_generator/robots/go_bdx/assets/head_body_yaw.stl

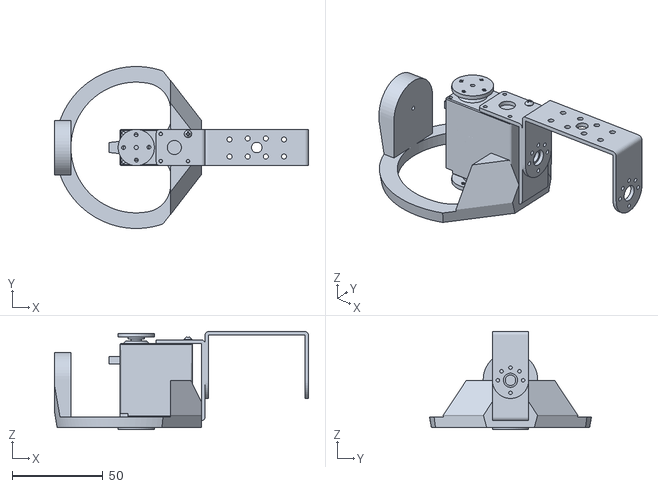
[picture p8: CAD file, 2026-07-16]
reference_motion_generator/open_duck_reference_motion_generator/robots/go_bdx/assets/head_body_yaw.stl
140.0 x 89.2 x 54.1
