AkimaraYouki/SummerProject/reference_motion_generator/open_duck_reference_motion_generator/robots/open_duck_mini_v2/assets/relay.stl

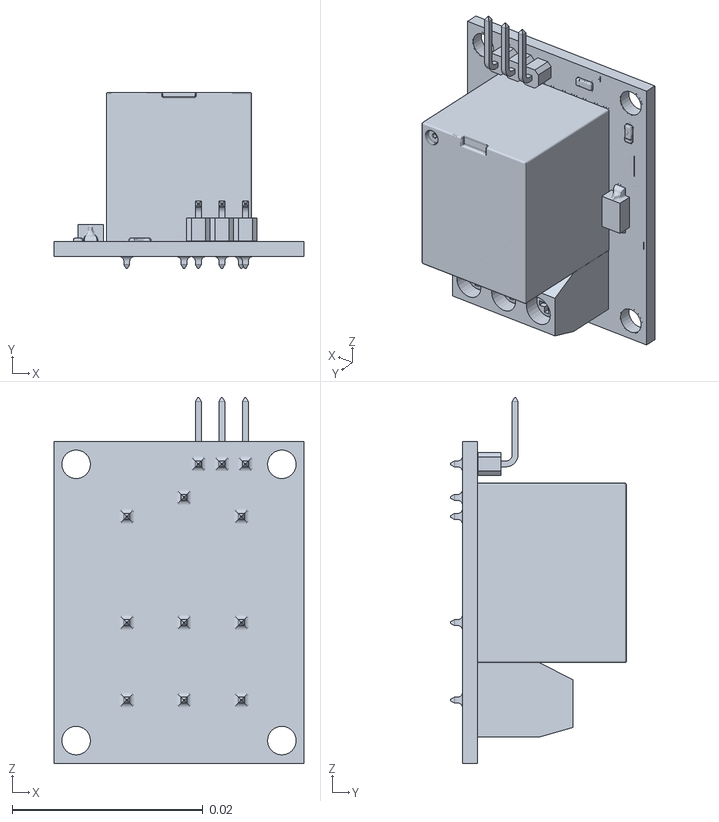
[picture p9: CAD file, 2026-08-06]
reference_motion_generator/open_duck_reference_motion_generator/robots/open_duck_mini_v2/assets/relay.stl
0.0261 x 0.0185 x 0.0383
