AkimaraYouki/SummerProject/robot_bigfoot/assets/head_yaw_to_roll.stl

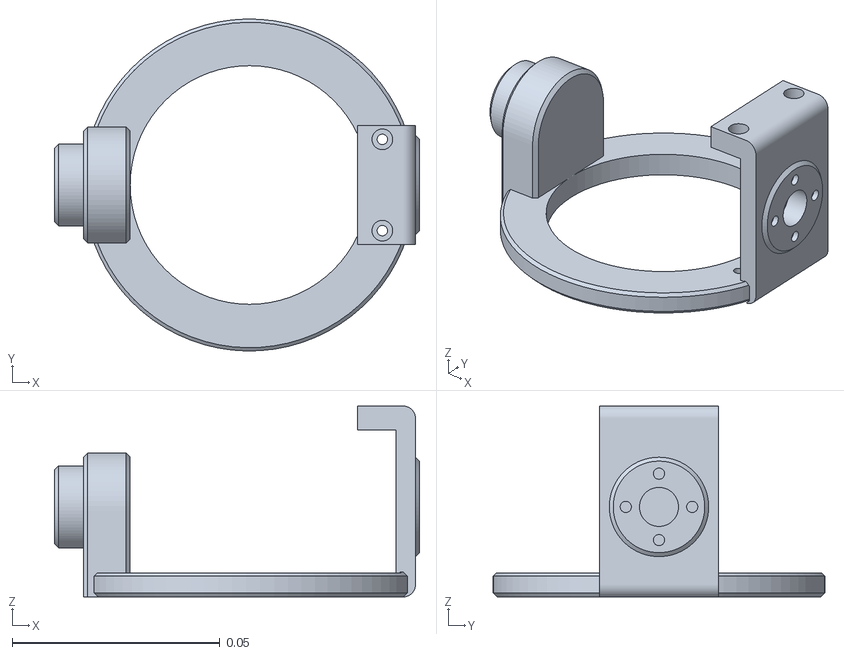
[picture p10: CAD file, 2026-08-19]
robot_bigfoot/assets/head_yaw_to_roll.stl
0.088 x 0.08 x 0.046
