AkimaraYouki/SummerProject/big_foot/assets/neck_left_sheet.stl

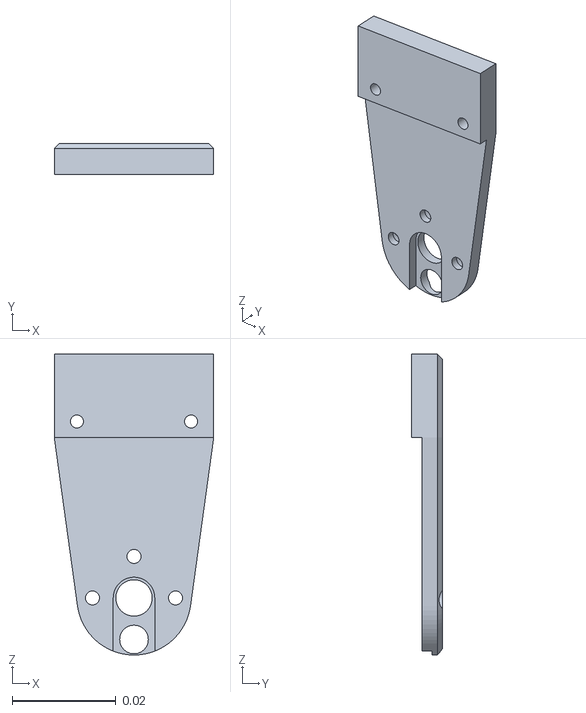
[picture p11: CAD file, 2026-08-19]
big_foot/assets/neck_left_sheet.stl
0.0307 x 0.006 x 0.058
