AkimaraYouki/SummerProject/reference_motion_generator/open_duck_reference_motion_generator/robots/go_bdx/assets/left_thigh.stl

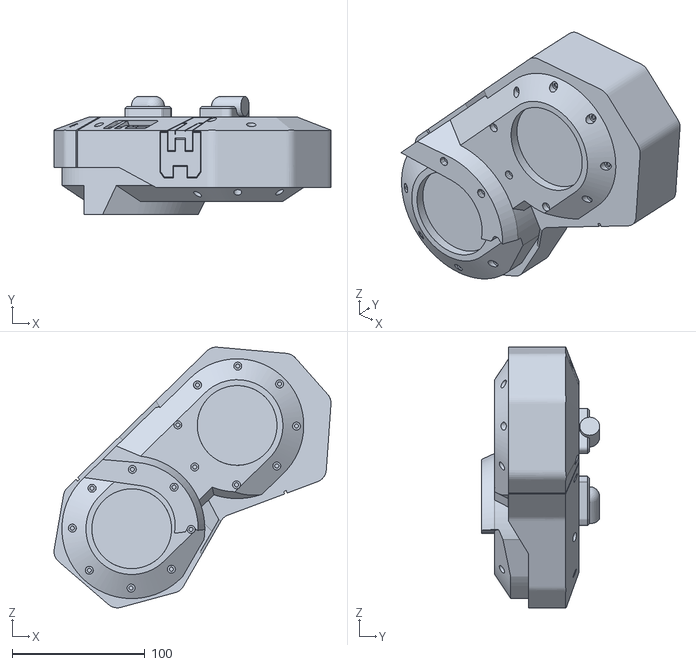
[picture p12: CAD file, 2026-07-16]
reference_motion_generator/open_duck_reference_motion_generator/robots/go_bdx/assets/left_thigh.stl
208.4 x 89.0 x 196.1
