AkimaraYouki/SummerProject/big_foot/assets/trunk_top.stl

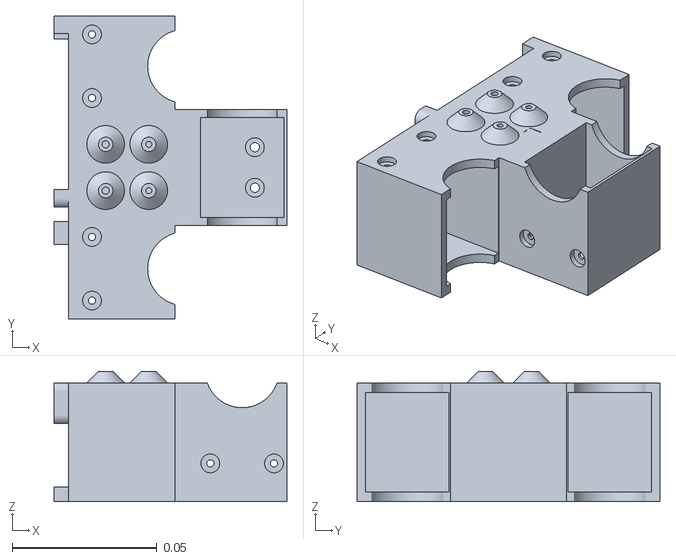
[picture p13: CAD file, 2026-08-19]
big_foot/assets/trunk_top.stl
0.0805 x 0.105 x 0.045
