AkimaraYouki/SummerProject/reference_motion_generator/open_duck_reference_motion_generator/robots/go_bdx/assets/left_hip_rotation.stl

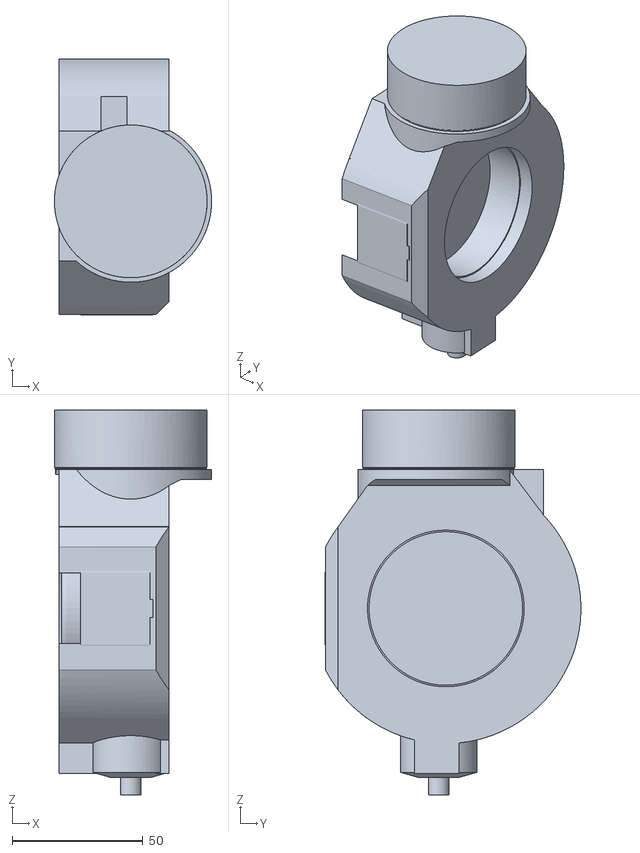
[picture p14: CAD file, 2026-07-16]
reference_motion_generator/open_duck_reference_motion_generator/robots/go_bdx/assets/left_hip_rotation.stl
60.2 x 98.0 x 147.5
