AkimaraYouki/SummerProject/big_foot/assets/body_bottom.stl

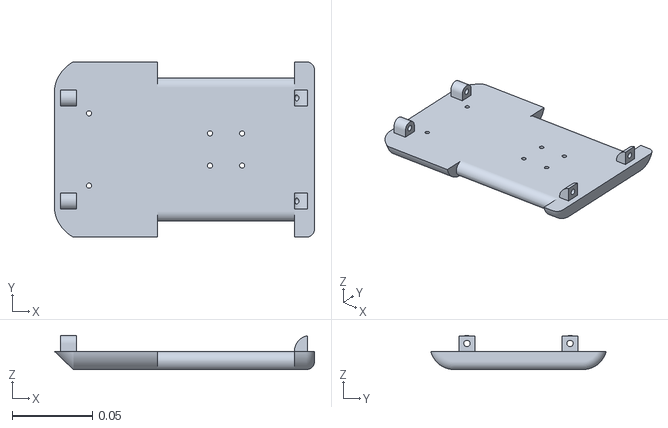
[picture p15: CAD file, 2026-08-19]
big_foot/assets/body_bottom.stl
0.162 x 0.109 x 0.0212
