AkimaraYouki/SummerProject/reference_motion_generator/open_duck_reference_motion_generator/robots/go_bdx/assets/head_body_roll.stl

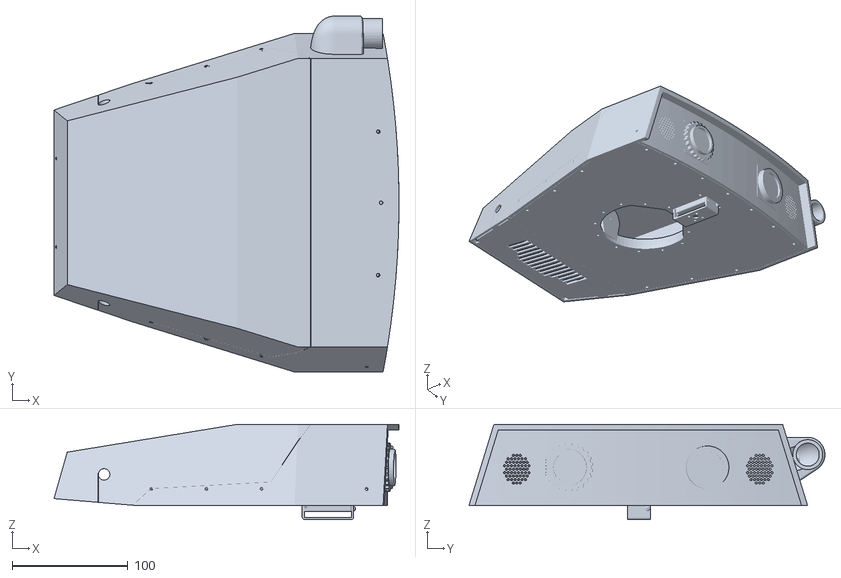
[picture p16: CAD file, 2026-07-16]
reference_motion_generator/open_duck_reference_motion_generator/robots/go_bdx/assets/head_body_roll.stl
298.7 x 308.2 x 82.4
