AkimaraYouki/SummerProject/robot_bigfoot/assets/l_roll_motor_top.stl

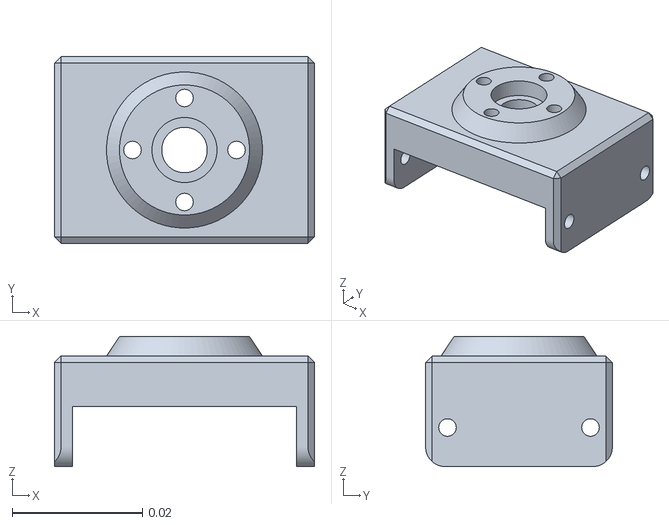
[picture p17: CAD file, 2026-08-19]
robot_bigfoot/assets/l_roll_motor_top.stl
0.04 x 0.0287 x 0.02
