AkimaraYouki/SummerProject/big_foot/assets/foot_bottom_tpu.stl

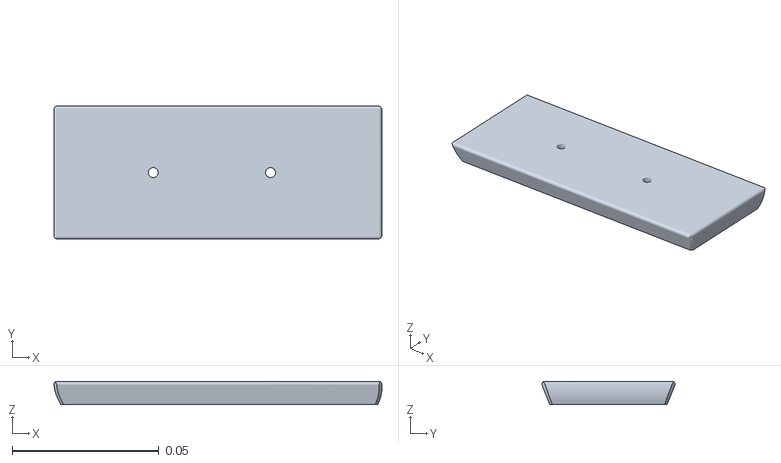
[picture p18: CAD file, 2026-08-19]
big_foot/assets/foot_bottom_tpu.stl
0.112 x 0.0454 x 0.008
