AkimaraYouki/SummerProject/reference_motion_generator/open_duck_reference_motion_generator/robots/go_bdx/assets/right_foot.stl

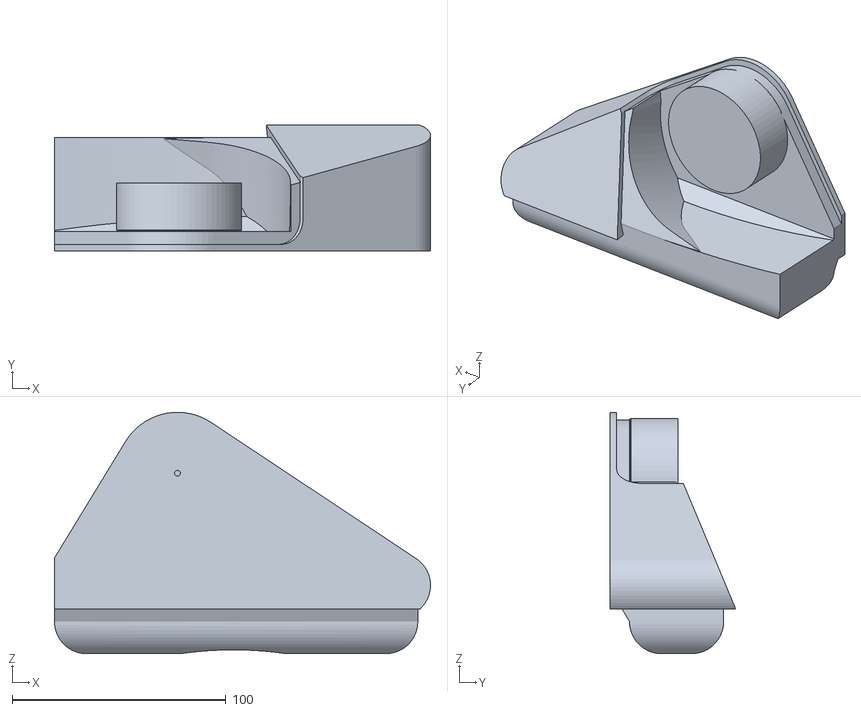
[picture p19: CAD file, 2026-07-16]
reference_motion_generator/open_duck_reference_motion_generator/robots/go_bdx/assets/right_foot.stl
175.9 x 58.7 x 112.9
