AkimaraYouki/SummerProject/robot_bigfoot/assets/body_front.stl

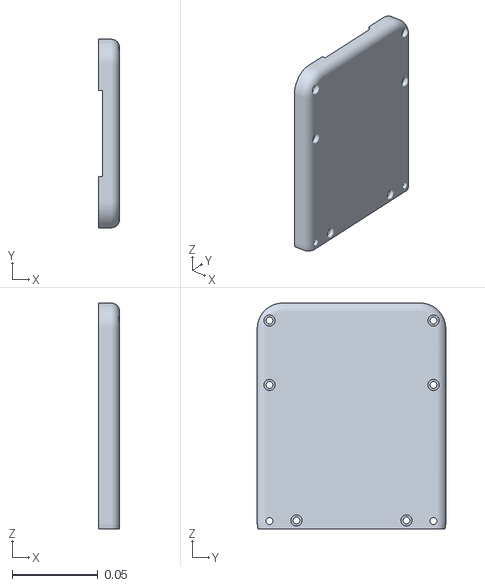
[picture p20: CAD file, 2026-08-19]
robot_bigfoot/assets/body_front.stl
0.0125 x 0.11 x 0.132
