AkimaraYouki/SummerProject/big_foot/assets/head_pitch_to_yaw.stl

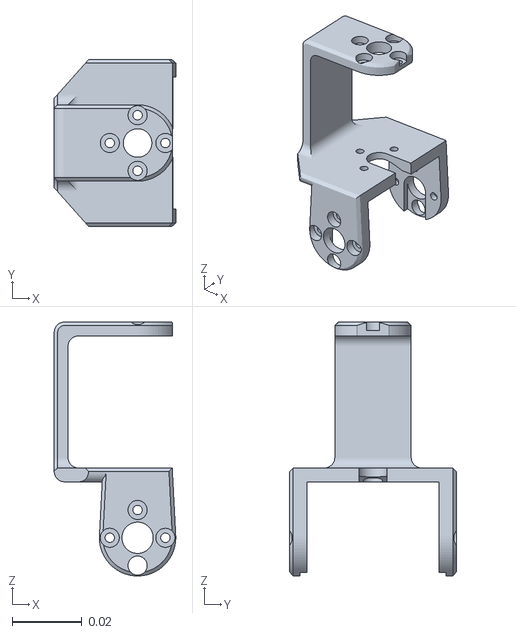
[picture p21: CAD file, 2026-08-19]
big_foot/assets/head_pitch_to_yaw.stl
0.035 x 0.048 x 0.0731
