AkimaraYouki/SummerProject/robot_bigfoot/assets/l_foot_side.stl

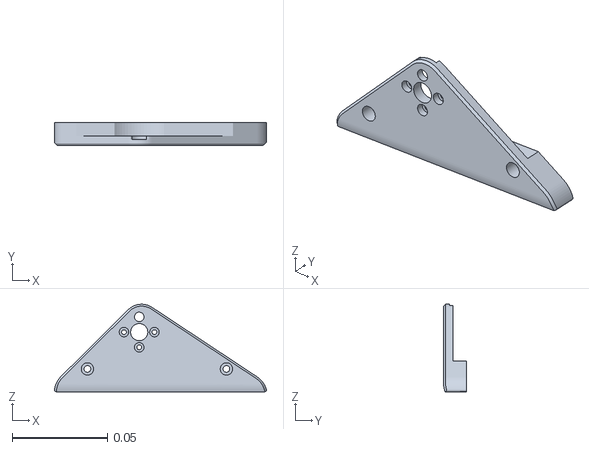
[picture p24: CAD file, 2026-08-19]
robot_bigfoot/assets/l_foot_side.stl
0.111 x 0.012 x 0.046
