AkimaraYouki/SummerProject/big_foot/assets/l_roll_motor_bottom.stl

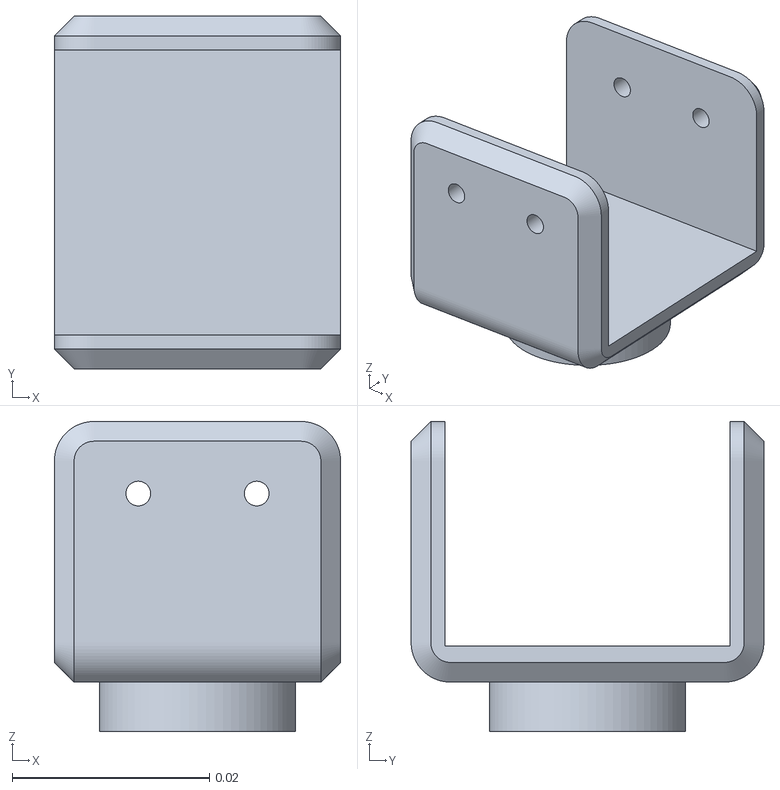
[picture p26: CAD file, 2026-08-19]
big_foot/assets/l_roll_motor_bottom.stl
0.029 x 0.0357 x 0.0314
