AkimaraYouki/SummerProject/robot_bigfoot/assets/left_knee_to_ankle_left_sheet.stl

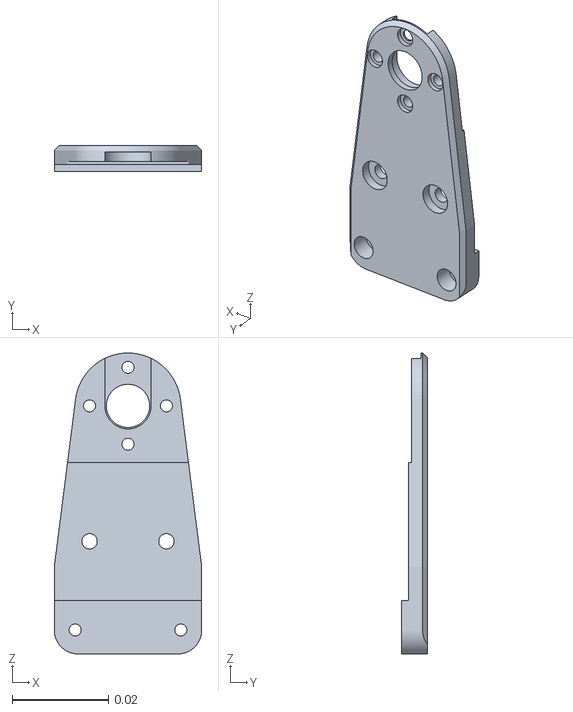
[picture p27: CAD file, 2026-08-19]
robot_bigfoot/assets/left_knee_to_ankle_left_sheet.stl
0.0307 x 0.00535 x 0.0626
