AkimaraYouki/SummerProject/reference_motion_generator/open_duck_reference_motion_generator/robots/go_bdx/assets/head_body_pitch.stl

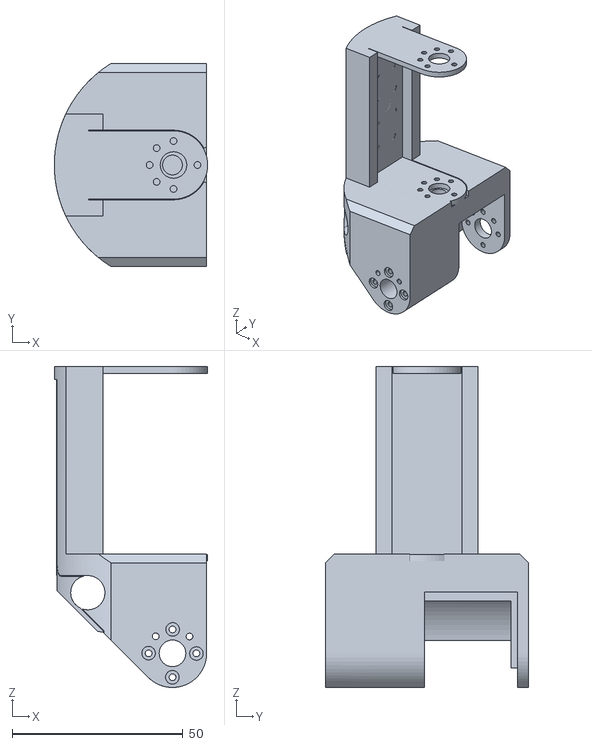
[picture p28: CAD file, 2026-07-16]
reference_motion_generator/open_duck_reference_motion_generator/robots/go_bdx/assets/head_body_pitch.stl
44.9 x 59.5 x 94.0
