AkimaraYouki/SummerProject/big_foot/assets/foot_top.stl

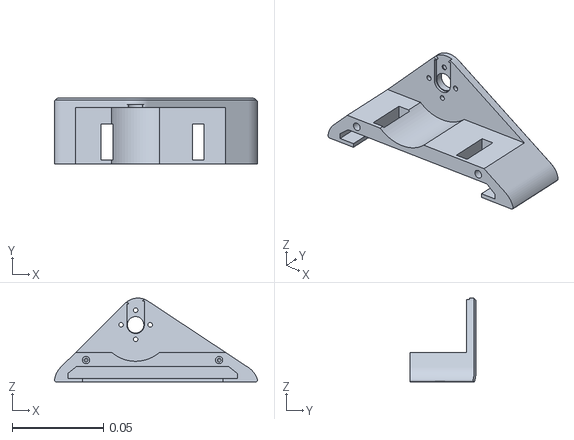
[picture p29: CAD file, 2026-08-19]
big_foot/assets/foot_top.stl
0.111 x 0.036 x 0.046
