AkimaraYouki/SummerProject/big_foot/assets/body_tail.stl

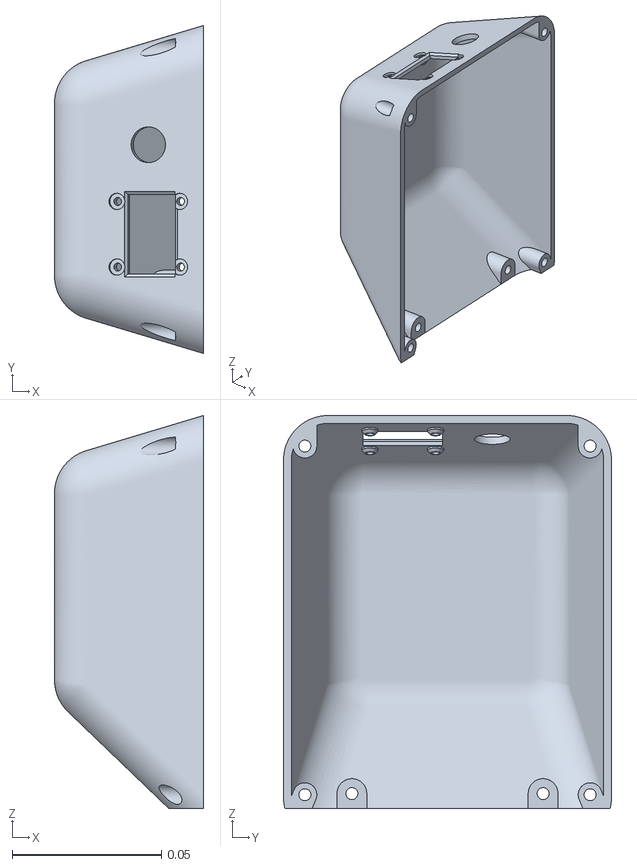
[picture p32: CAD file, 2026-08-06]
big_foot/assets/body_tail.stl
0.05 x 0.11 x 0.132
