AkimaraYouki/SummerProject/robot_bigfoot/assets/part_32.stl

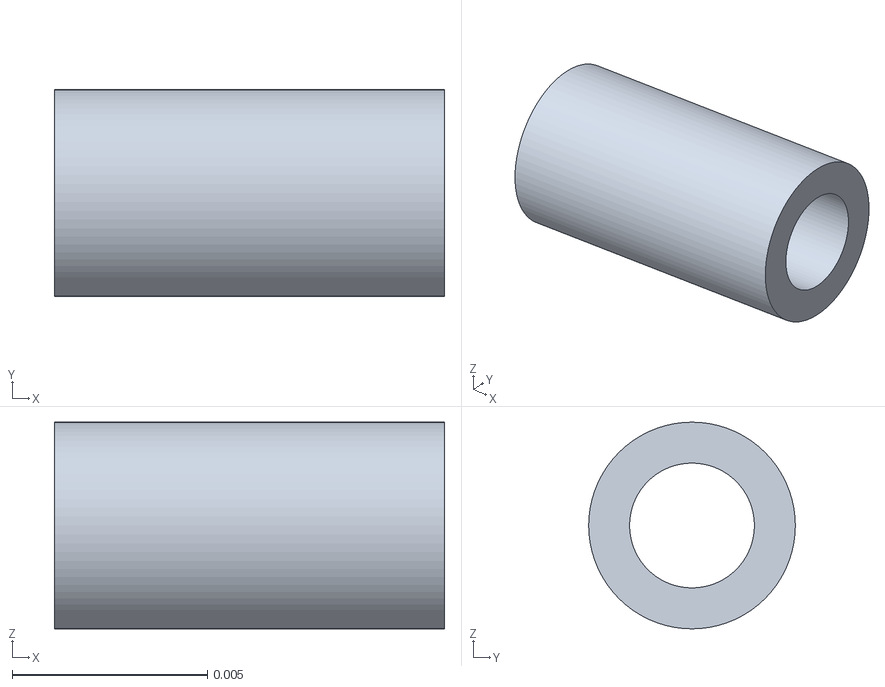
[picture p33: CAD file, 2026-08-06]
robot_bigfoot/assets/part_32.stl
0.01 x 0.0053 x 0.0053
