AkimaraYouki/SummerProject/big_foot/assets/part_1.stl

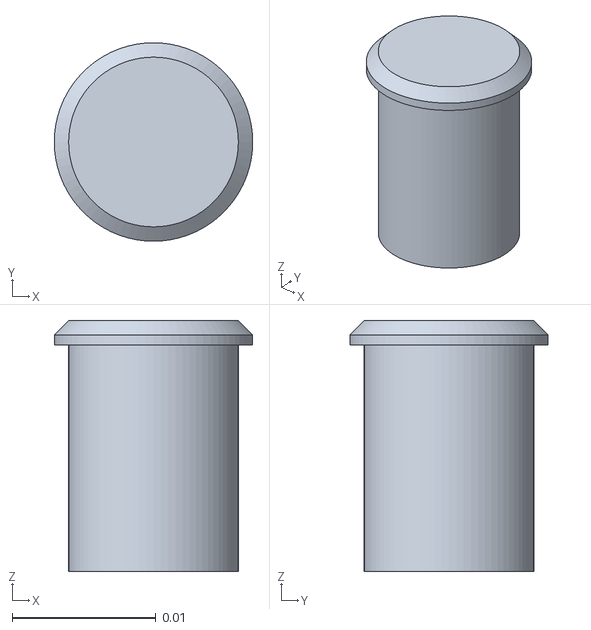
[picture p34: CAD file, 2026-08-06]
big_foot/assets/part_1.stl
0.0138 x 0.0138 x 0.0175
