AkimaraYouki/SummerProject/robot_bigfoot/assets/ss_10_actuator__none.stl

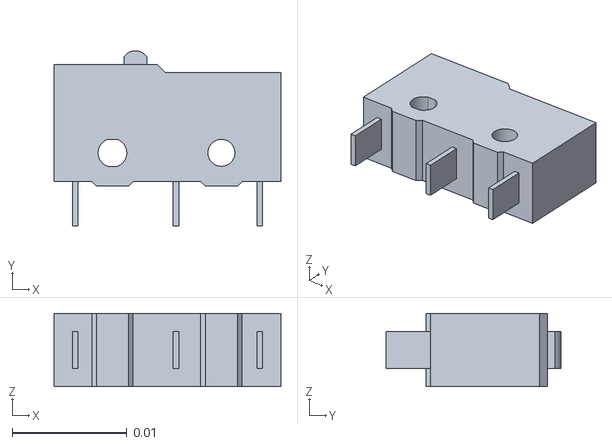
[picture p35: CAD file, 2026-08-06]
robot_bigfoot/assets/ss_10_actuator__none.stl
0.0198 x 0.0153 x 0.0064
