AkimaraYouki/SummerProject/big_foot/assets/left_roll_to_pitch.stl

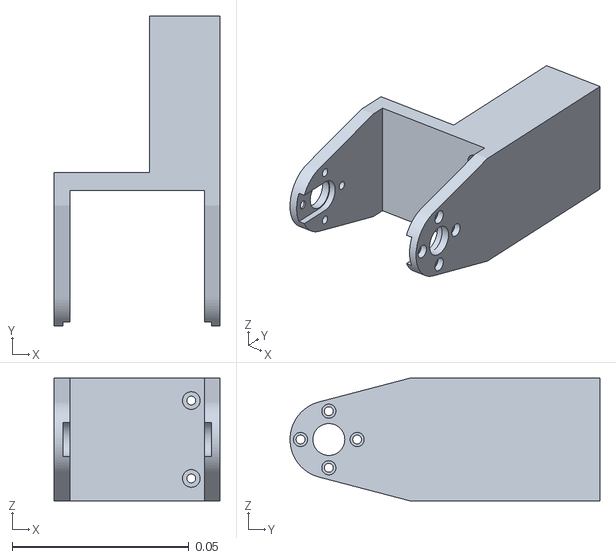
[picture p36: CAD file, 2026-08-06]
big_foot/assets/left_roll_to_pitch.stl
0.0469 x 0.0876 x 0.0347
