AkimaraYouki/SummerProject/robot_bigfoot/assets/part_27.stl

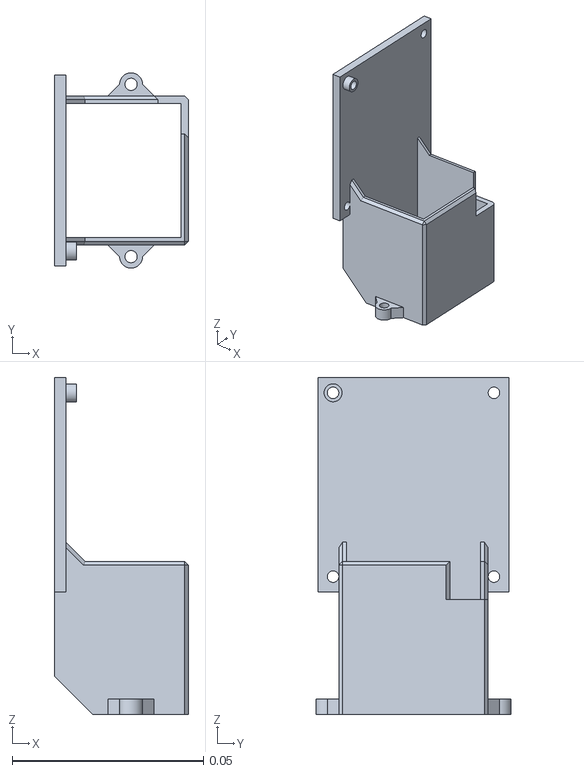
[picture p37: CAD file, 2026-08-06]
robot_bigfoot/assets/part_27.stl
0.035 x 0.051 x 0.088
