AkimaraYouki/SummerProject/big_foot/assets/bno055.stl

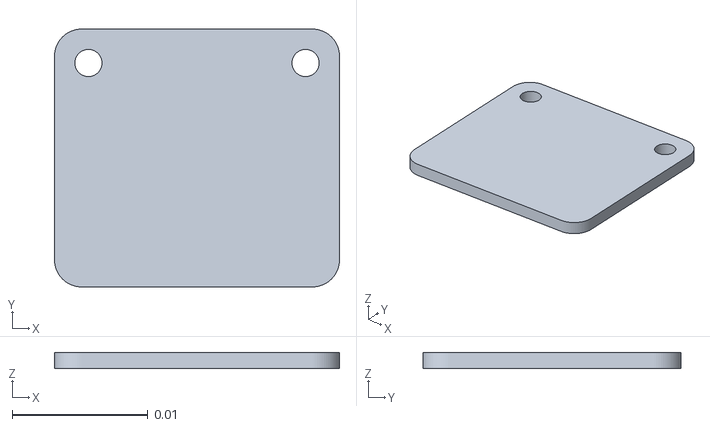
[picture p38: CAD file, 2026-08-06]
big_foot/assets/bno055.stl
0.021 x 0.019 x 0.0012
