AkimaraYouki/SummerProject/robot_bigfoot/assets/extrude___annular_rings.stl

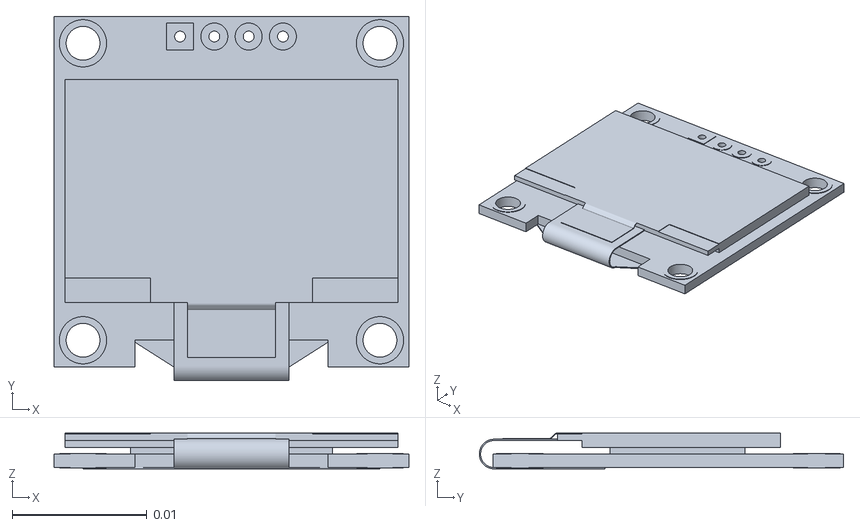
[picture p39: CAD file, 2026-08-06]
robot_bigfoot/assets/extrude___annular_rings.stl
0.0263 x 0.027 x 0.00265
