AkimaraYouki/SummerProject/big_foot/assets/part_1__5.stl

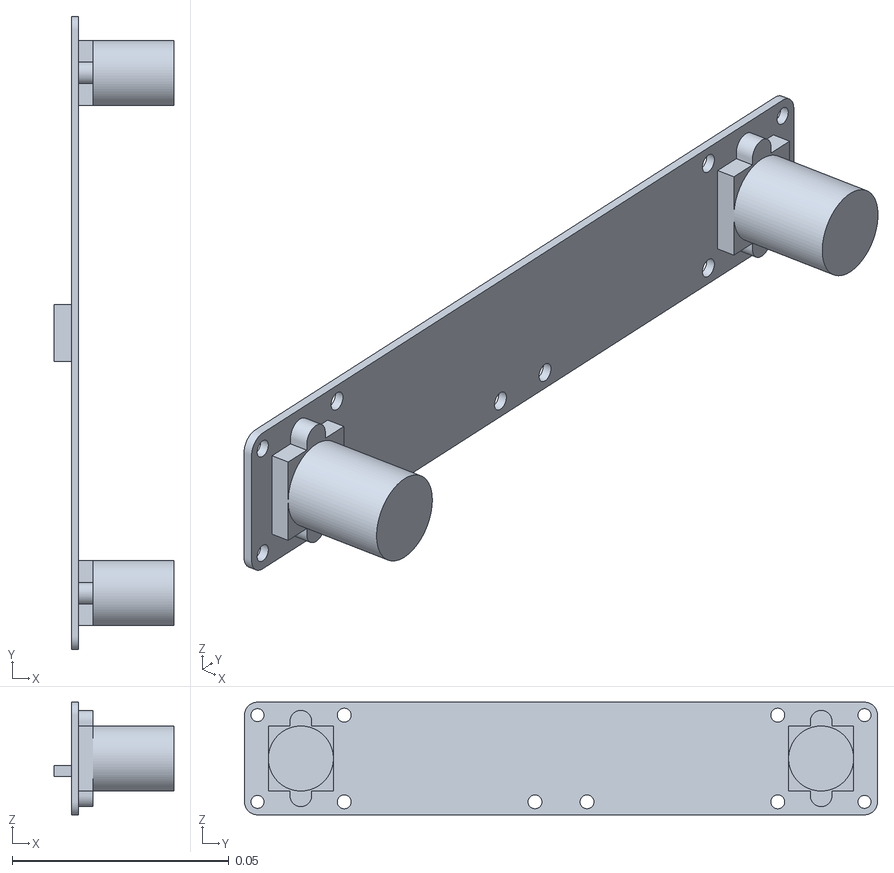
[picture p40: CAD file, 2026-08-06]
big_foot/assets/part_1__5.stl
0.0276 x 0.146 x 0.026
