AkimaraYouki/SummerProject/robot_bigfoot/assets/part_1__2.stl

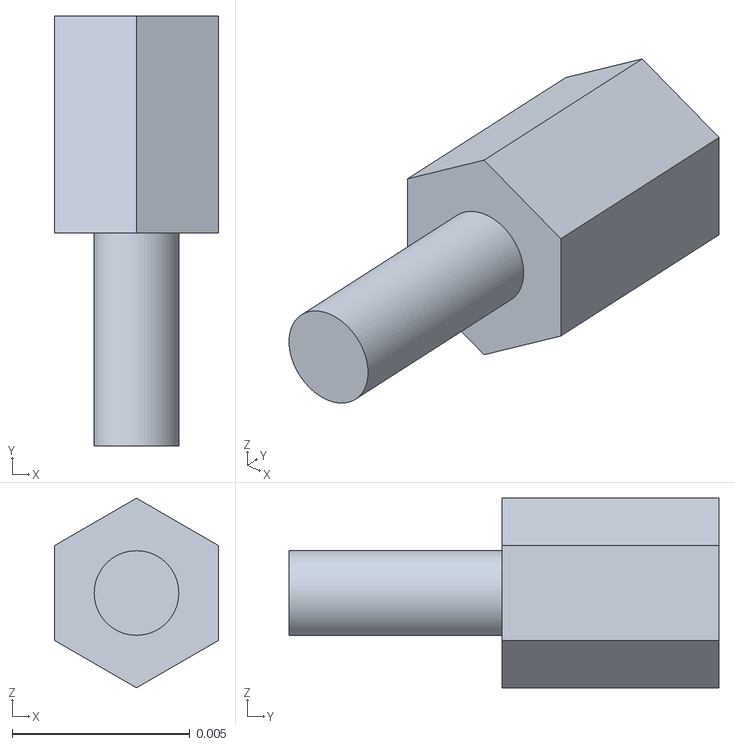
[picture p41: CAD file, 2026-08-06]
robot_bigfoot/assets/part_1__2.stl
0.00462 x 0.0121 x 0.00533
