AkimaraYouki/SummerProject/robot_bigfoot/assets/part_30.stl

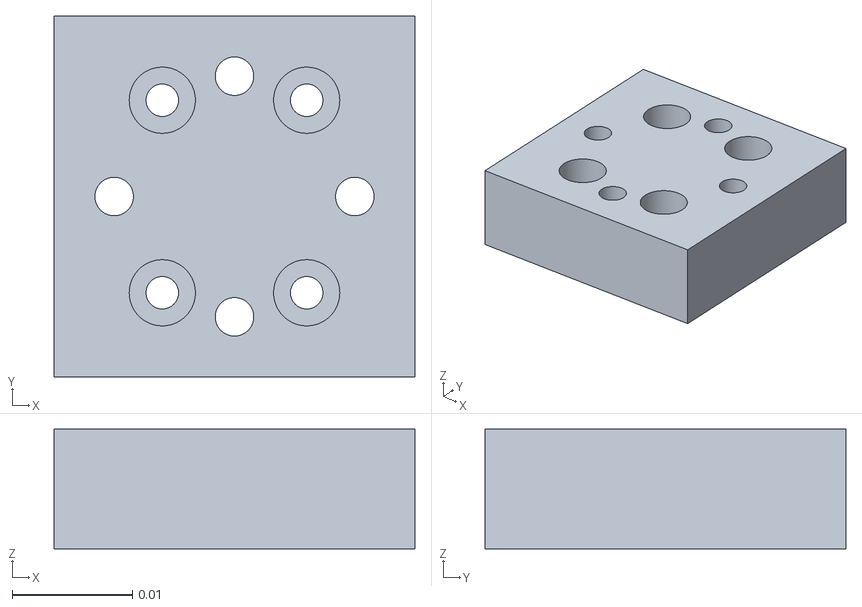
[picture p42: CAD file, 2026-08-06]
robot_bigfoot/assets/part_30.stl
0.03 x 0.03 x 0.00994
