AkimaraYouki/SummerProject/big_foot/assets/body_top_right.stl

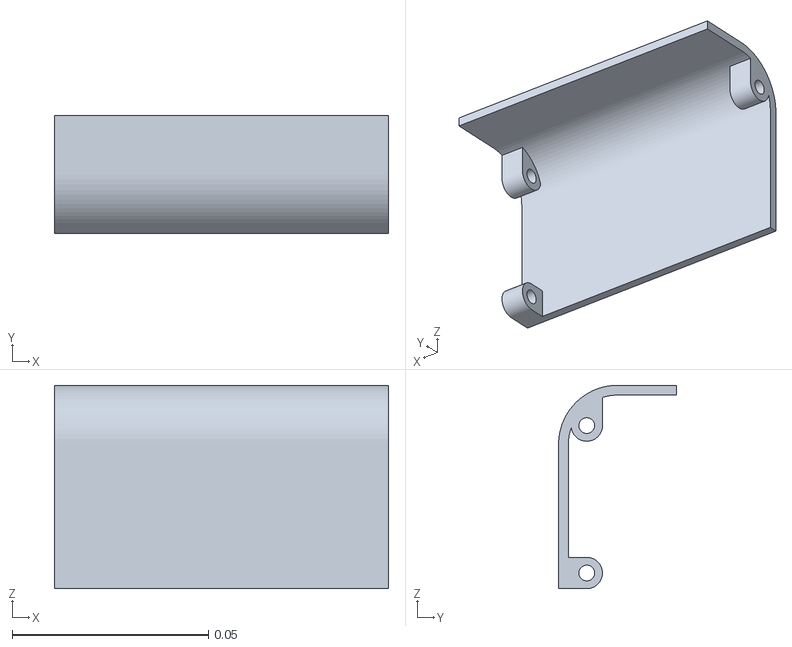
[picture p43: CAD file, 2026-08-06]
big_foot/assets/body_top_right.stl
0.085 x 0.03 x 0.0518
