AkimaraYouki/SummerProject/robot_bigfoot/assets/jst_b4b_eh_a_prt_1_3.stl

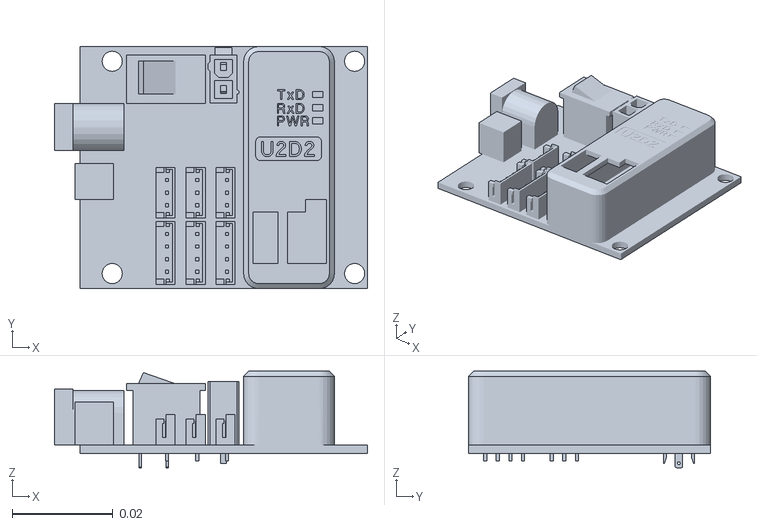
[picture p44: CAD file, 2026-08-06]
robot_bigfoot/assets/jst_b4b_eh_a_prt_1_3.stl
0.062 x 0.048 x 0.0191
