AkimaraYouki/SummerProject/big_foot/assets/part_29.stl

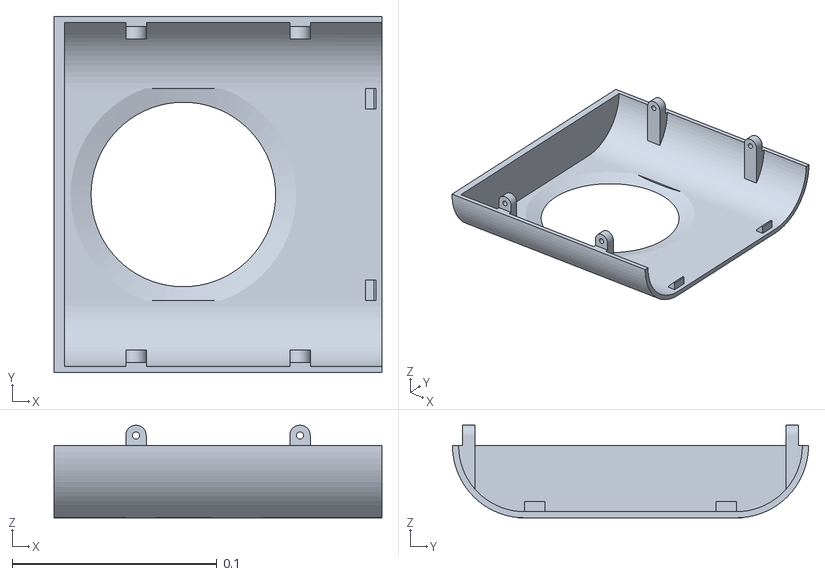
[picture p45: CAD file, 2026-08-06]
big_foot/assets/part_29.stl
0.16 x 0.174 x 0.0452
