AkimaraYouki/SummerProject/robot_bigfoot/assets/head_bot_sheet.stl

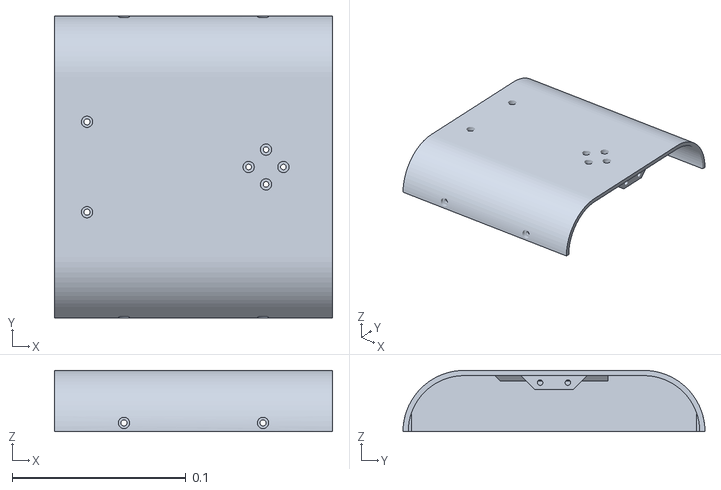
[picture p46: CAD file, 2026-08-06]
robot_bigfoot/assets/head_bot_sheet.stl
0.16 x 0.174 x 0.0352
