AkimaraYouki/SummerProject/robot_bigfoot/assets/part_26.stl

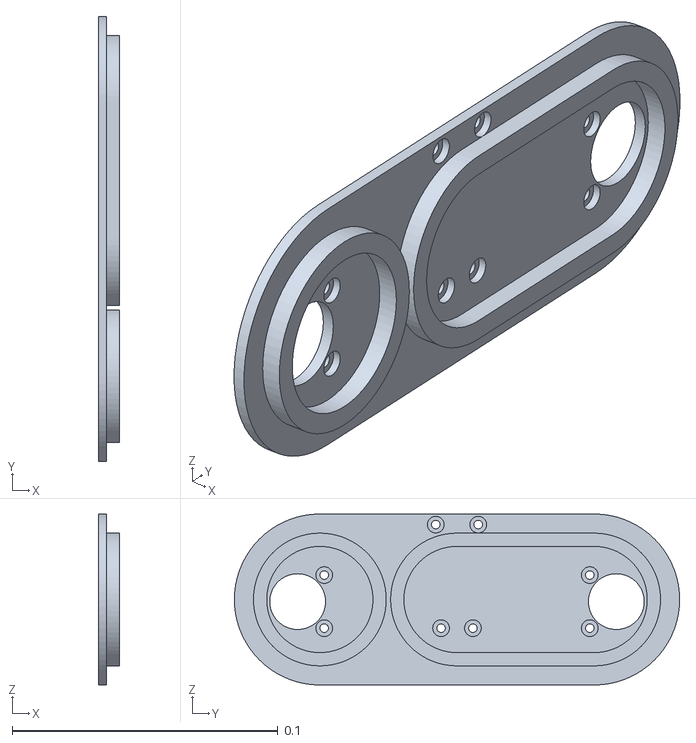
[picture p47: CAD file, 2026-08-06]
robot_bigfoot/assets/part_26.stl
0.008 x 0.168 x 0.0644
