AkimaraYouki/SummerProject/robot_bigfoot/assets/part_31.stl

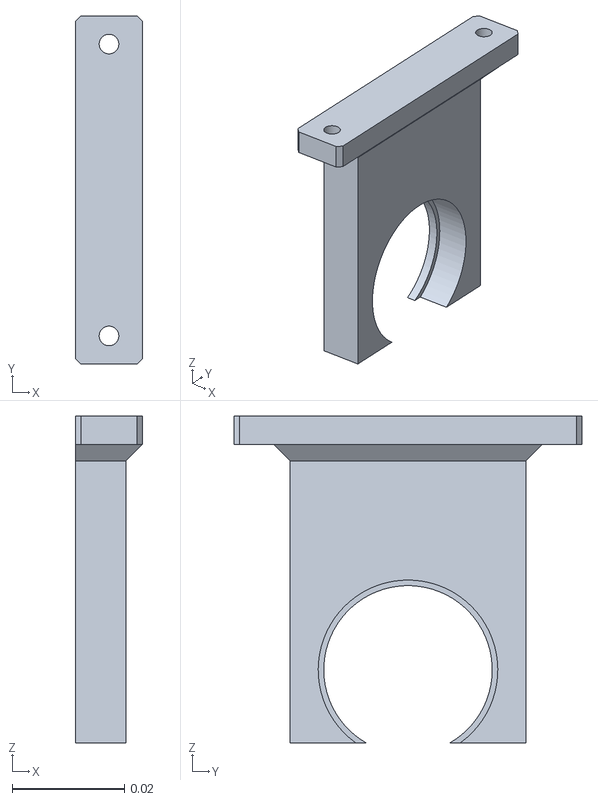
[picture p48: CAD file, 2026-08-06]
robot_bigfoot/assets/part_31.stl
0.012 x 0.062 x 0.0582
