AkimaraYouki/SummerProject/robot_bigfoot/assets/trunk_bottom.stl

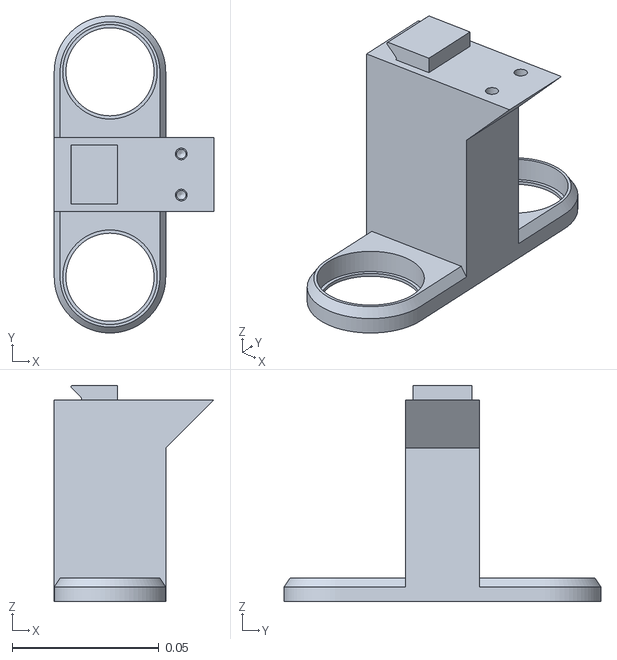
[picture p49: CAD file, 2026-08-06]
robot_bigfoot/assets/trunk_bottom.stl
0.0544 x 0.108 x 0.0737
