AkimaraYouki/SummerProject/big_foot/assets/leg_spacer.stl

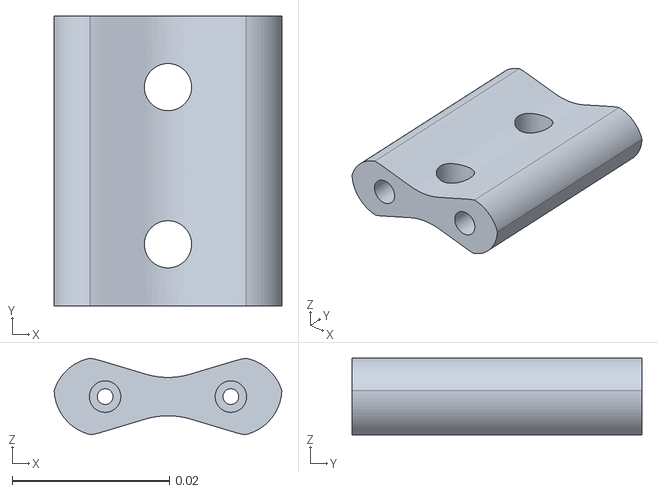
[picture p50: CAD file, 2026-07-26]
big_foot/assets/leg_spacer.stl
0.029 x 0.0369 x 0.00974
