AkimaraYouki/SummerProject/big_foot/assets/batt.stl

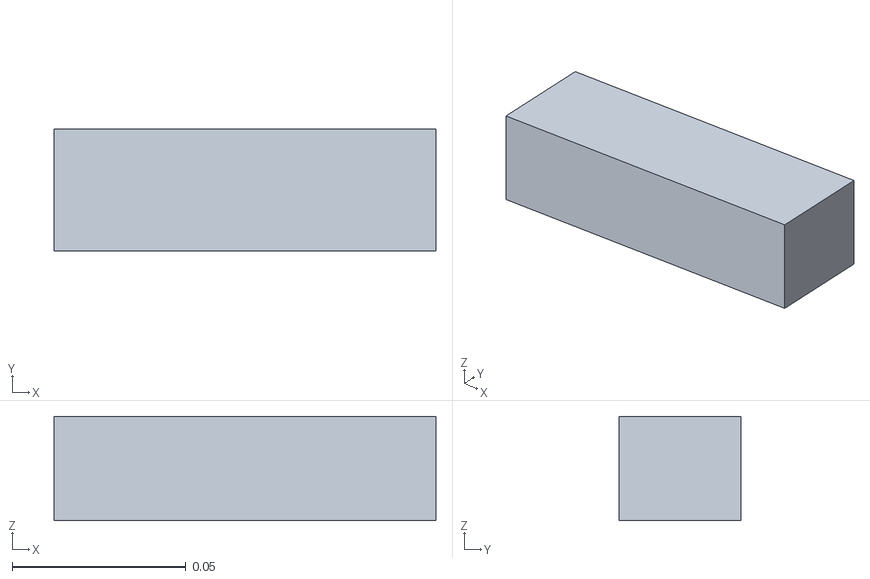
[picture p51: CAD file, 2026-07-26]
big_foot/assets/batt.stl
0.11 x 0.035 x 0.03
