AkimaraYouki/SummerProject/big_foot/assets/part_1__3.stl

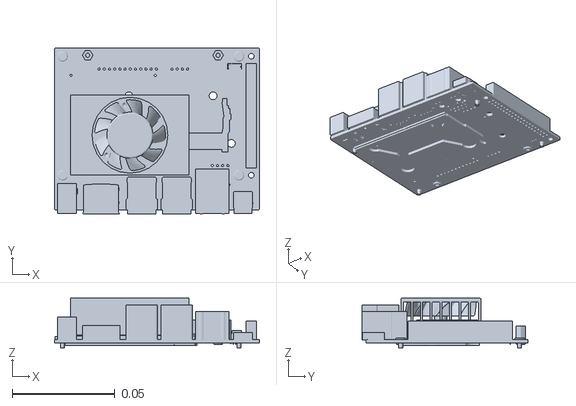
[picture p52: CAD file, 2026-07-25]
big_foot/assets/part_1__3.stl
0.1 x 0.0809 x 0.0242
