AkimaraYouki/SummerProject/big_foot/assets/part_3.stl

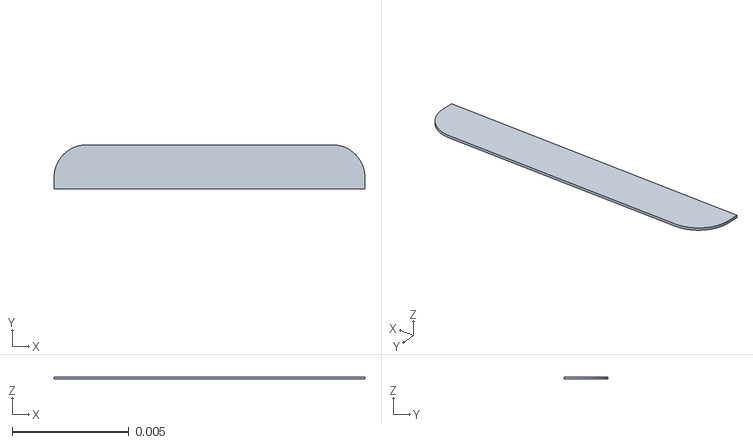
[picture p53: CAD file, 2026-07-25]
big_foot/assets/part_3.stl
0.0133 x 0.0019 x 0.0001
