AkimaraYouki/SummerProject/big_foot/assets/part_9.stl

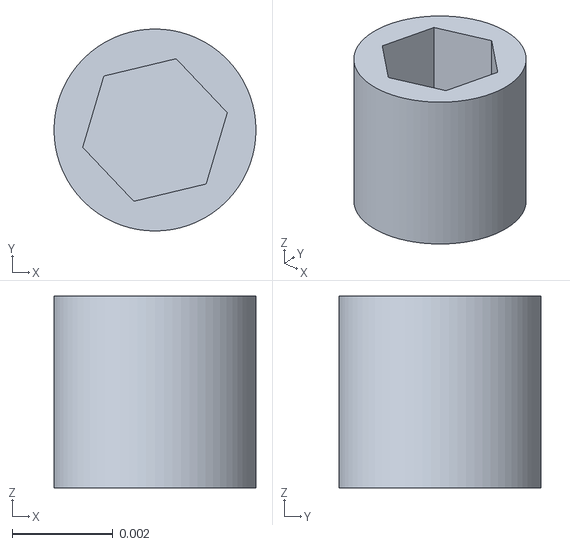
[picture p54: CAD file, 2026-07-25]
big_foot/assets/part_9.stl
0.004 x 0.004 x 0.0038
