AkimaraYouki/SummerProject/robot_bigfoot/assets/part_11.stl

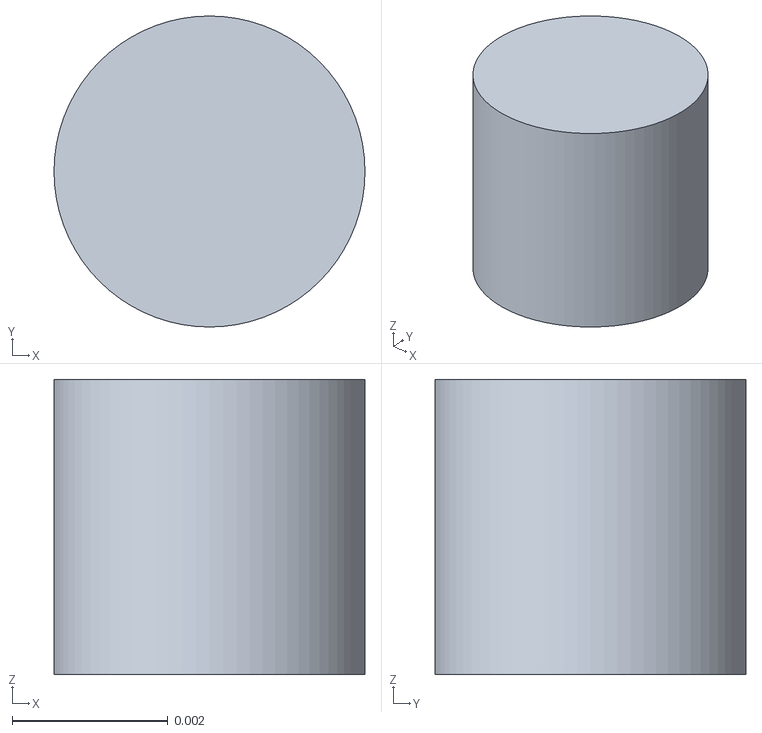
[picture p55: CAD file, 2026-07-25]
robot_bigfoot/assets/part_11.stl
0.004 x 0.004 x 0.0038
