AkimaraYouki/SummerProject/big_foot/assets/part_16.stl

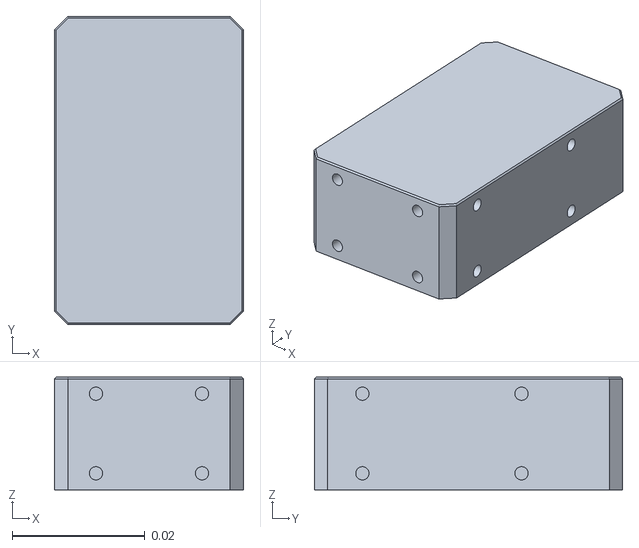
[picture p56: CAD file, 2026-07-25]
big_foot/assets/part_16.stl
0.0285 x 0.0465 x 0.017
