AkimaraYouki/SummerProject/big_foot/assets/foot_bottom_pla.stl

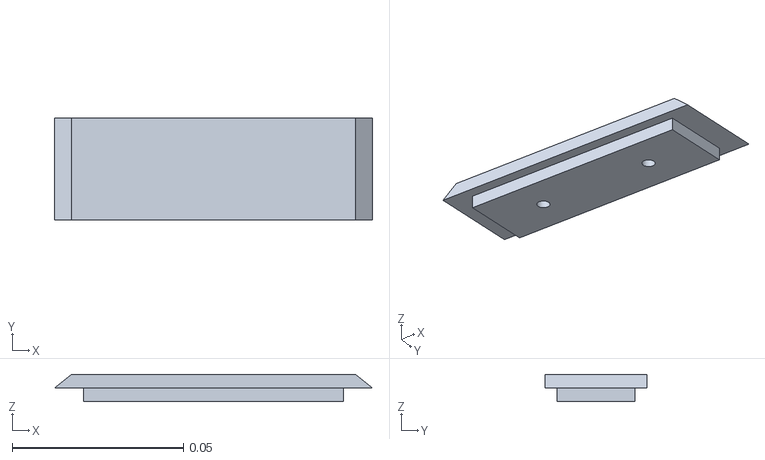
[picture p57: CAD file, 2026-07-25]
big_foot/assets/foot_bottom_pla.stl
0.093 x 0.0299 x 0.008
