AkimaraYouki/SummerProject/robot_bigfoot/assets/part_5.stl

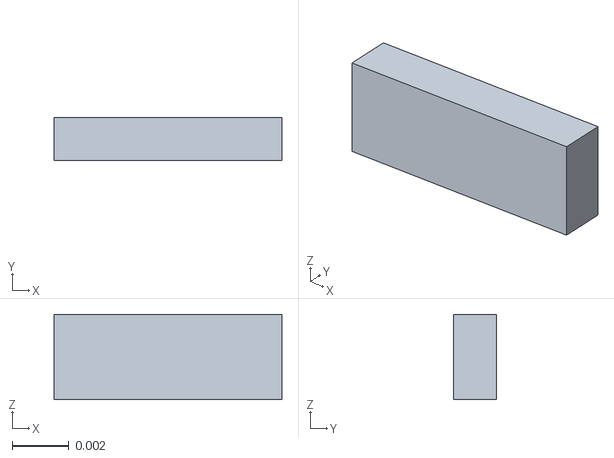
[picture p58: CAD file, 2026-07-25]
robot_bigfoot/assets/part_5.stl
0.008 x 0.0015 x 0.003
