AkimaraYouki/SummerProject/big_foot/assets/part_2.stl

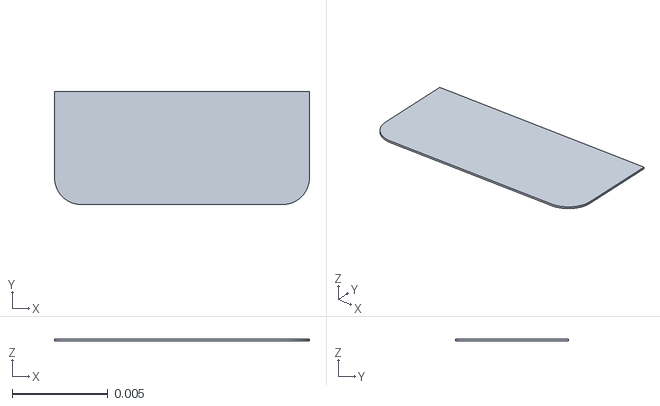
[picture p59: CAD file, 2026-07-25]
big_foot/assets/part_2.stl
0.0133 x 0.0059 x 0.0001
