AkimaraYouki/SummerProject/robot_bigfoot/assets/part_4.stl

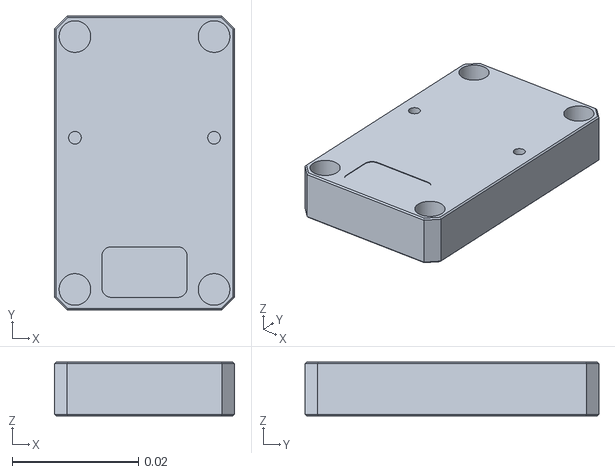
[picture p60: CAD file, 2026-07-25]
robot_bigfoot/assets/part_4.stl
0.0285 x 0.0465 x 0.0085
