AkimaraYouki/SummerProject/big_foot/assets/roll_bearing.stl

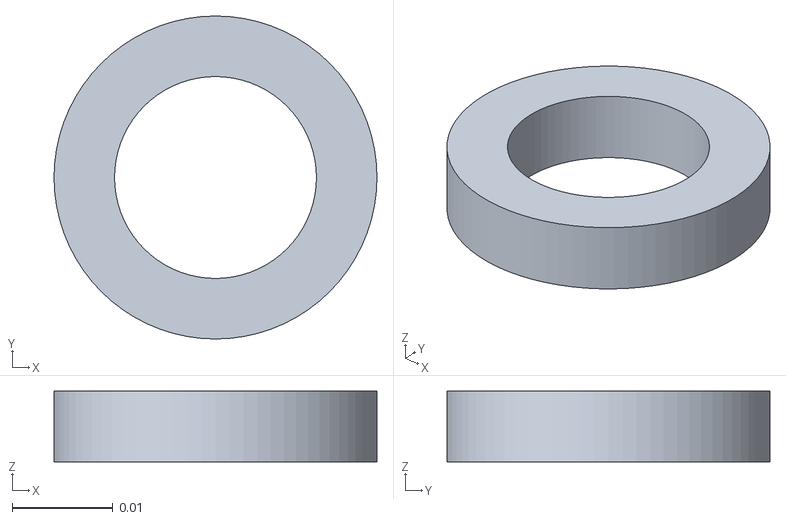
[picture p61: CAD file, 2026-07-16]
big_foot/assets/roll_bearing.stl
0.032 x 0.032 x 0.007
