AkimaraYouki/SummerProject/(list of files, cad)

Other CAD files:
robot_bigfoot/assets/neck_right_sheet.stl
big_foot/assets/neck_right_sheet.stl
reference_motion_generator/open_duck_reference_motion_generator/robots/go_bdx/assets/ear_left.stl
reference_motion_generator/open_duck_reference_motion_generator/robots/go_bdx/assets/left_hip.stl
reference_motion_generator/open_duck_reference_motion_generator/robots/go_bdx/assets/left_foot.stl
reference_motion_generator/open_duck_reference_motion_generator/robots/go_bdx/assets/right_thigh.stl
reference_motion_generator/open_duck_reference_motion_generator/robots/go_bdx/assets/right_shin.stl
reference_motion_generator/open_duck_reference_motion_generator/robots/go_bdx/assets/right_hip_rotation.stl
big_foot/assets/right_roll_to_pitch.stl
robot_bigfoot/assets/right_roll_to_pitch.stl
robot_bigfoot/assets/body_top_left.stl
big_foot/assets/body_top_left.stl
big_foot/assets/part_7.stl
robot_bigfoot/assets/part_8.stl
robot_bigfoot/assets/part_10.stl
big_foot/assets/part_14.stl
robot_bigfoot/assets/part_14.stl
big_foot/assets/part_6.stl
robot_bigfoot/assets/part_6.stl
big_foot/assets/part_8.stl
robot_bigfoot/assets/part_7.stl
big_foot/assets/part_10.stl
big_foot/assets/part_12.stl
big_foot/assets/part_13.stl
big_foot/assets/part_15.stl
big_foot/assets/part_1__4.stl
reference_motion_generator/open_duck_reference_motion_generator/robots/open_duck_mini/assets/39281023.prt.stl
reference_motion_generator/open_duck_reference_motion_generator/robots/open_duck_mini/assets/antenna.stl
reference_motion_generator/open_duck_reference_motion_generator/robots/open_duck_mini/assets/antenna_holder_left.stl
reference_motion_generator/open_duck_reference_motion_generator/robots/open_duck_mini/assets/antenna_holder_right.stl
reference_motion_generator/open_duck_reference_motion_generator/robots/open_duck_mini/assets/antenna_motor_holder.stl
reference_motion_generator/open_duck_reference_motion_generator/robots/open_duck_mini/assets/antenna_tip.stl
reference_motion_generator/open_duck_reference_motion_generator/robots/open_duck_mini/assets/axis_to_axis.stl
reference_motion_generator/open_duck_reference_motion_generator/robots/open_duck_mini/assets/block_to_axis.stl
reference_motion_generator/open_duck_reference_motion_generator/robots/open_duck_mini/assets/bms.stl
reference_motion_generator/open_duck_reference_motion_generator/robots/open_duck_mini/assets/bno055.stl
reference_motion_generator/open_duck_reference_motion_generator/robots/open_duck_mini/assets/board.stl
reference_motion_generator/open_duck_reference_motion_generator/robots/open_duck_mini/assets/body_part.stl
reference_motion_generator/open_duck_reference_motion_generator/robots/open_duck_mini/assets/cage_back.stl
reference_motion_generator/open_duck_reference_motion_generator/robots/open_duck_mini/assets/cage_bottom.stl
reference_motion_generator/open_duck_reference_motion_generator/robots/open_duck_mini/assets/cage_bottom_battery_hold.stl
reference_motion_generator/open_duck_reference_motion_generator/robots/open_duck_mini/assets/cage_top.stl
reference_motion_generator/open_duck_reference_motion_generator/robots/open_duck_mini/assets/cell.stl
reference_motion_generator/open_duck_reference_motion_generator/robots/open_duck_mini/assets/dc15_a01_case_b_dummy.stl
reference_motion_generator/open_duck_reference_motion_generator/robots/open_duck_mini/assets/dc15_a01_case_f_dummy.stl
reference_motion_generator/open_duck_reference_motion_generator/robots/open_duck_mini/assets/dc15_a01_case_m_dummy.stl
reference_motion_generator/open_duck_reference_motion_generator/robots/open_duck_mini/assets/dc15_a01_horn_dummy.stl
reference_motion_generator/open_duck_reference_motion_generator/robots/open_duck_mini/assets/dc15_a01_horn_idle2_dummy.stl
reference_motion_generator/open_duck_reference_motion_generator/robots/open_duck_mini/assets/double_u.stl
reference_motion_generator/open_duck_reference_motion_generator/robots/open_duck_mini/assets/foot.stl
reference_motion_generator/open_duck_reference_motion_generator/robots/open_duck_mini/assets/foot_contact.stl
reference_motion_generator/open_duck_reference_motion_generator/robots/open_duck_mini/assets/front_cover.stl
reference_motion_generator/open_duck_reference_motion_generator/robots/open_duck_mini/assets/head.stl
reference_motion_generator/open_duck_reference_motion_generator/robots/open_duck_mini/assets/head_roll_pitch.stl
reference_motion_generator/open_duck_reference_motion_generator/robots/open_duck_mini/assets/hip_left_roll_to_pitch.stl
reference_motion_generator/open_duck_reference_motion_generator/robots/open_duck_mini/assets/hip_right_roll_to_pitch.stl
reference_motion_generator/open_duck_reference_motion_generator/robots/open_duck_mini/assets/holder.stl
reference_motion_generator/open_duck_reference_motion_generator/robots/open_duck_mini/assets/holder_u2d2_power_hub.stl
reference_motion_generator/open_duck_reference_motion_generator/robots/open_duck_mini/assets/jst-b3b-eh-a.prt.1.stl
reference_motion_generator/open_duck_reference_motion_generator/robots/open_duck_mini/assets/jst-b3b-eh-a.prt.stl
reference_motion_generator/open_duck_reference_motion_generator/robots/open_duck_mini/assets/jst-b4b-eh-a.prt.1.stl
reference_motion_generator/open_duck_reference_motion_generator/robots/open_duck_mini/assets/jst-b4b-eh-a.prt.stl
reference_motion_generator/open_duck_reference_motion_generator/robots/open_duck_mini/assets/jst-b4b-ph-k-s.prt.stl
reference_motion_generator/open_duck_reference_motion_generator/robots/open_duck_mini/assets/micro_usb_2_0_connector__ab_rec.prt.stl
reference_motion_generator/open_duck_reference_motion_generator/robots/open_duck_mini/assets/pcb_u2d2.prt.stl
reference_motion_generator/open_duck_reference_motion_generator/robots/open_duck_mini/assets/power_switch.stl
reference_motion_generator/open_duck_reference_motion_generator/robots/open_duck_mini/assets/rasp_spacer.stl
reference_motion_generator/open_duck_reference_motion_generator/robots/open_duck_mini/assets/raspberrypizerow.stl
reference_motion_generator/open_duck_reference_motion_generator/robots/open_duck_mini/assets/renfort_head_link.stl
reference_motion_generator/open_duck_reference_motion_generator/robots/open_duck_mini/assets/renfort_leg.stl
reference_motion_generator/open_duck_reference_motion_generator/robots/open_duck_mini/assets/sg90.stl
reference_motion_generator/open_duck_reference_motion_generator/robots/open_duck_mini/assets/spacer.stl
reference_motion_generator/open_duck_reference_motion_generator/robots/open_duck_mini/assets/u2d2_casing.prt.stl
reference_motion_generator/open_duck_reference_motion_generator/robots/open_duck_mini/assets/usb_c_charger.stl
robot_bigfoot/assets/part_12.stl
robot_bigfoot/assets/part_13.stl
robot_bigfoot/assets/part_15.stl
robot_bigfoot/assets/part_1__4.stl
