AkimaraYouki/SummerProject/docs/hw_logs/joint_step_left_knee_2026-08-10.csv

t | step_sign | goal_deg_left_knee | pos_deg_left_knee | cur_A_left_knee | vel_rads_left_knee | torque_en_left_knee | hw_err_left_knee
0.0073 | 1 | -97.900 | -92.812 | 0.0000 | 0.0000 | 1 | 1
0.0653 | 1 | -97.900 | -97.383 | 0.2233 | -0.9592 | 1 | 1
0.1214 | 1 | -97.900 | -97.559 | -0.0673 | -0.4317 | 1 | 1
0.1773 | 1 | -97.900 | -97.559 | -0.0619 | 0.0000 | 1 | 1
0.2333 | 1 | -97.900 | -97.559 | -0.0646 | 0.0000 | 1 | 1
0.2894 | 1 | -97.900 | -97.559 | -0.0699 | 0.0000 | 1 | 1
0.3453 | 1 | -97.900 | -97.559 | -0.0726 | 0.0000 | 1 | 1
0.4013 | 1 | -97.900 | -97.559 | -0.0673 | 0.0000 | 1 | 1
0.4573 | 1 | -97.900 | -97.559 | -0.0538 | 0.0000 | 1 | 1
0.5133 | 1 | -97.900 | -97.559 | -0.0646 | 0.0000 | 1 | 1
0.5693 | 1 | -97.900 | -97.559 | -0.0673 | 0.0000 | 1 | 1
0.6253 | 1 | -97.900 | -97.559 | -0.0673 | 0.0000 | 1 | 1
0.6813 | 1 | -97.900 | -97.559 | -0.0673 | 0.0000 | 1 | 1
0.7373 | 1 | -97.900 | -97.559 | -0.0699 | 0.0000 | 1 | 1
0.7937 | 1 | -97.900 | -97.559 | -0.0699 | 0.0000 | 1 | 1
0.8513 | 1 | -97.900 | -97.559 | -0.0673 | 0.0000 | 1 | 1
0.9074 | 1 | -97.900 | -97.559 | -0.0646 | 0.0000 | 1 | 1
0.9633 | 1 | -97.900 | -97.559 | -0.0646 | 0.0000 | 1 | 1
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
