AkimaraYouki/SummerProject/reference_motion_generator/verification_plots/polynomial_fit_quality.png

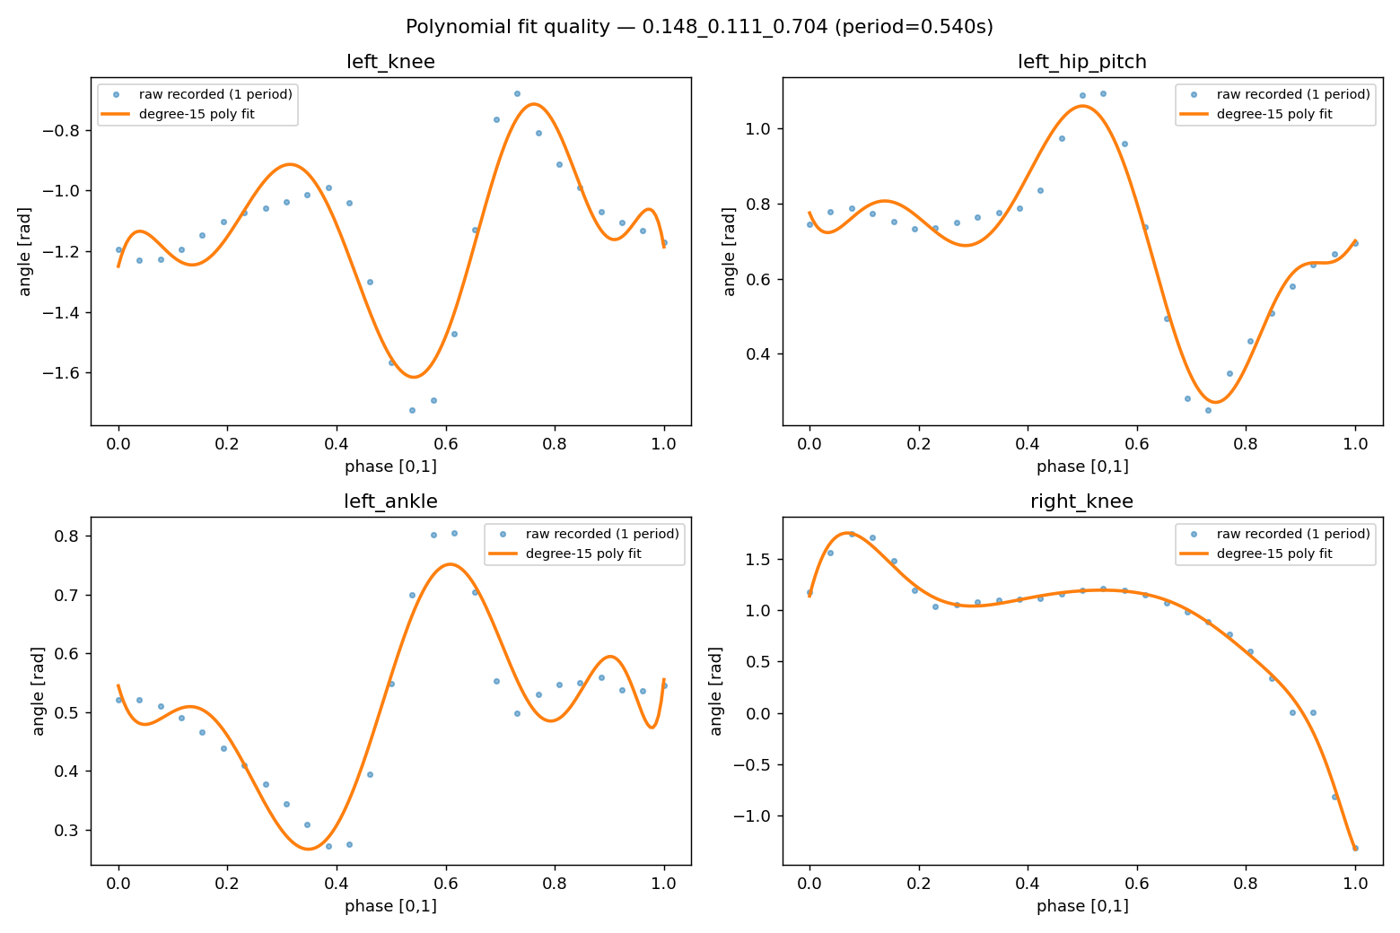
reference_motion_generator/verification_plots/polynomial_fit_quality.png
