AkimaraYouki/SummerProject/reference_motion_generator/verification_plots/single_gait_verification.png

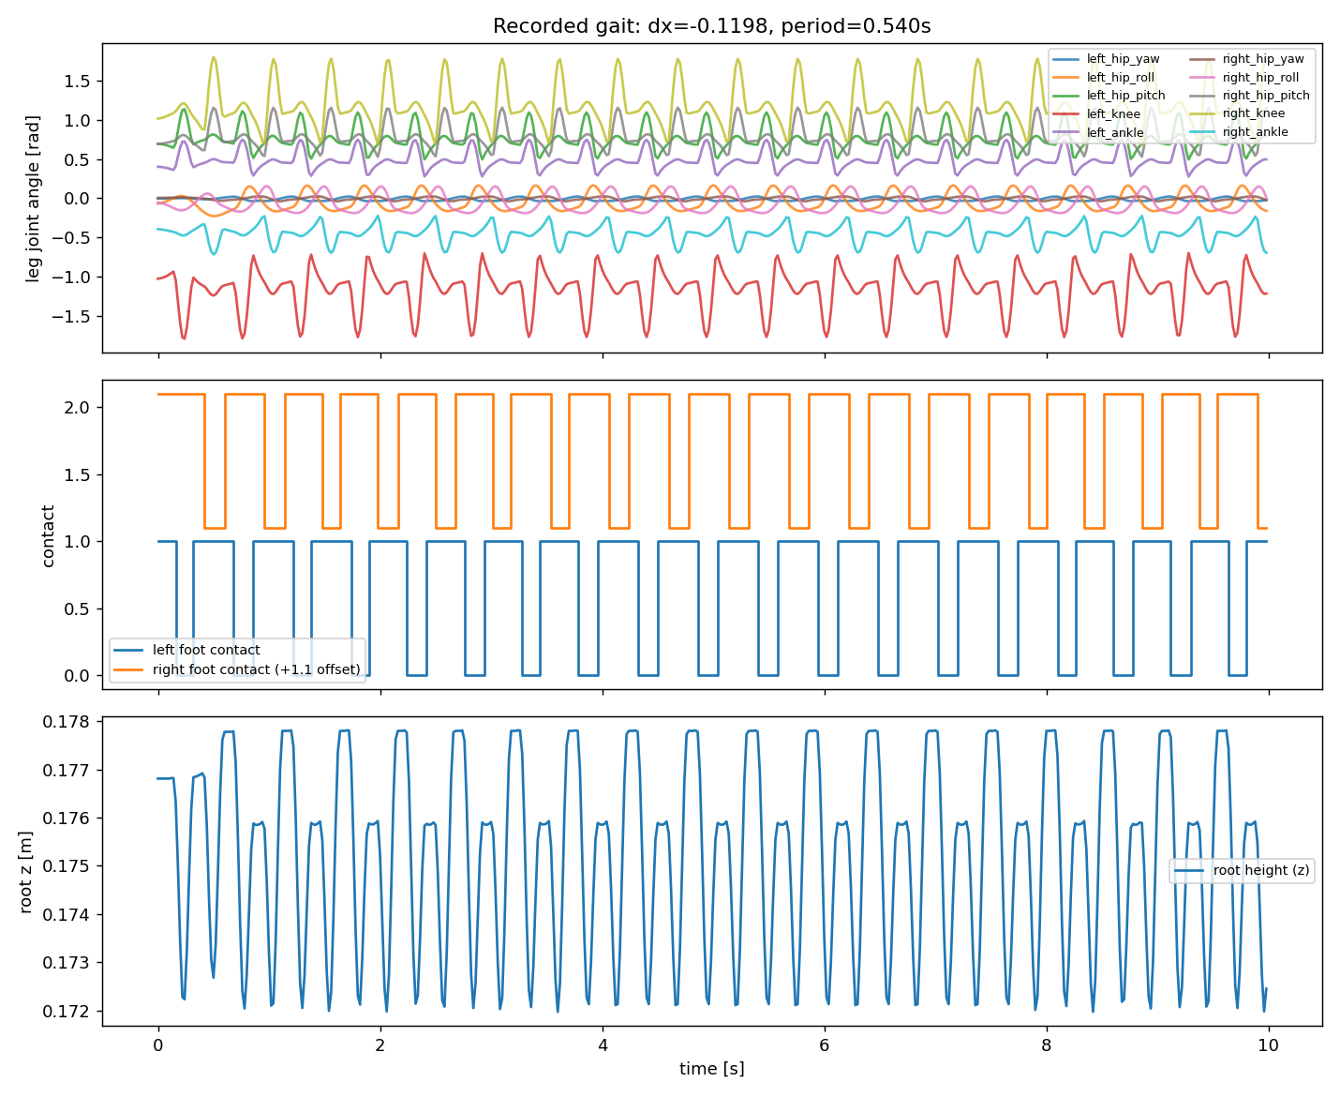
reference_motion_generator/verification_plots/single_gait_verification.png
