AkimaraYouki/SummerProject/reference_motion_generator/verification_plots/sweep_coverage_120.png

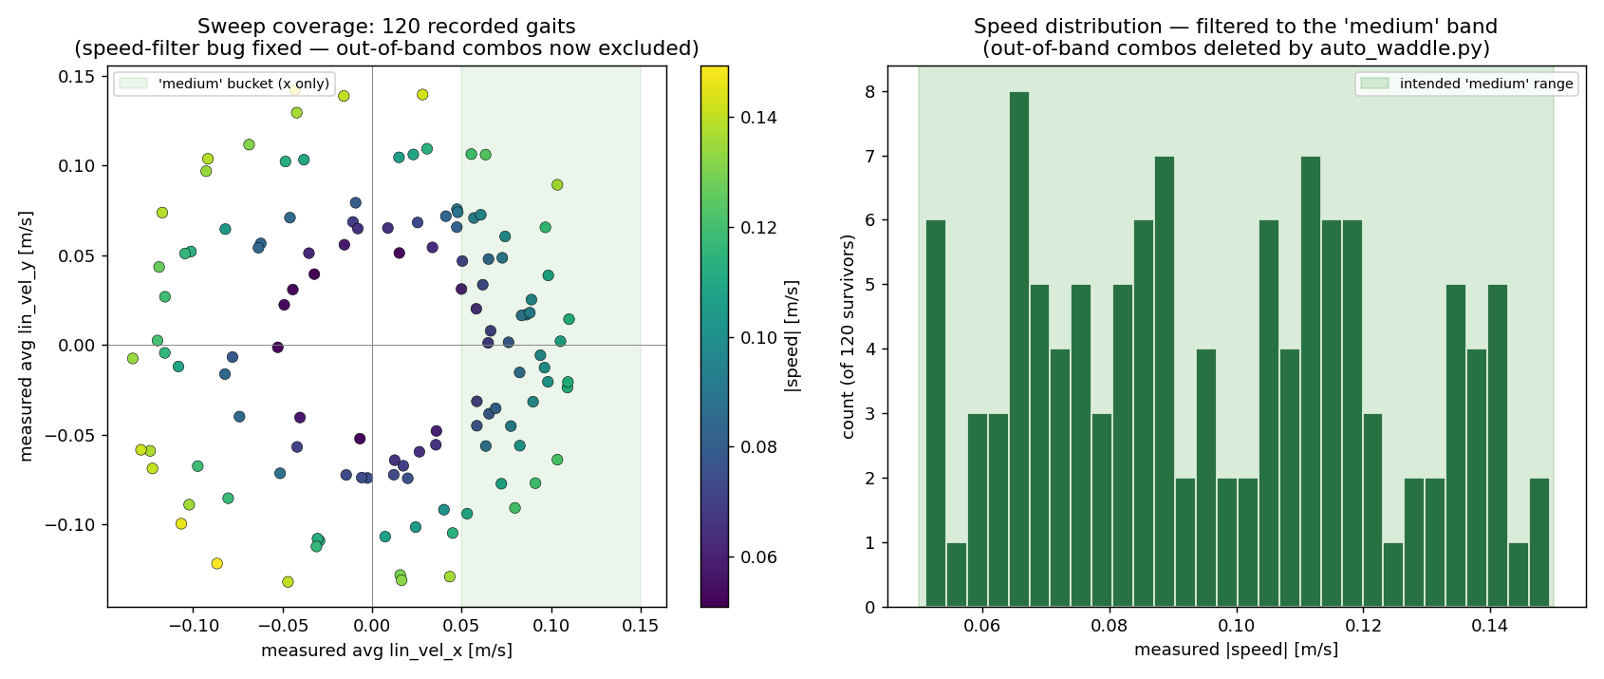
reference_motion_generator/verification_plots/sweep_coverage_120.png
