AkimaraYouki/SummerProject/big_foot/robot.urdf

<?xml version="1.0" ?>
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
<robot name="foot_big">
  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
  <link name="trunk_assembly">
    <inertial>
      <origin xyz="-0.0640311 0.0003319 0.0422838" rpy="0 0 0"/>
      <mass value="1.15295"/>
      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
    </inertial>
    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
  </link>
  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
  <link name="trunk">
    <origin xyz="0 0 0" rpy="0 -0 0"/>
    <inertial>
      <origin xyz="0 0 0" rpy="0 0 0"/>
      <mass value="1e-9"/>
      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
    </inertial>
  </link>
  <joint name="trunk_frame" type="fixed">
    <origin xyz="-0.024 -0 0.0893424" rpy="-0 -0 -0"/>
    <parent link="trunk_assembly"/>
    <child link="trunk"/>
    <axis xyz="0 0 0"/>
  </joint>
  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
  <link name="imu">
    <origin xyz="0 0 0" rpy="0 -0 0"/>
    <inertial>
      <origin xyz="0 0 0" rpy="0 0 0"/>
      <mass value="1e-9"/>
      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
    </inertial>
  </link>
  <joint name="imu_frame" type="fixed">
    <origin xyz="-0.038493 0 0.0896424" rpy="-0 -0 0"/>
    <parent link="trunk_assembly"/>
    <child link="imu"/>
    <axis xyz="0 0 0"/>
  </joint>
  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
  <link name="hip_roll_assembly">
    <inertial>
      <origin xyz="-0.000681614 -0.000101097 0.0336873" rpy="0 0 0"/>
      <mass value="0.100996"/>
      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
    </inertial>
    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
  </link>
  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
  <link name="left_roll_to_pitch_assembly">
    <inertial>
      <origin xyz="0.0516121 0.000186598 -0.021323" rpy="0 0 0"/>
      <mass value="0.106996"/>
      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
    </inertial>
    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
  </link>
  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
  <link name="knee_and_ankle_assembly">
    <inertial>
      <origin xyz="-1.87036e-07 0.0601954 -0.0183304" rpy="0 0 0"/>
      <mass value="0.102496"/>
      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
    </inertial>
    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
  </link>
  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
  <link name="knee_and_ankle_assembly_2">
    <inertial>
      <origin xyz="-1.87036e-07 0.0601954 -0.0183304" rpy="0 0 0"/>
      <mass value="0.102496"/>
      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
    </inertial>
    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
  </link>
  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
  <link name="foot_assembly">
    <inertial>
      <origin xyz="0.0106462 0.0244212 -0.0187472" rpy="0 0 0"/>
      <mass value="0.0799077"/>
      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
    </inertial>
    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
  </link>
  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
  <link name="left_foot">
    <origin xyz="0 0 0" rpy="0 -0 0"/>
    <inertial>
      <origin xyz="0 0 0" rpy="0 0 0"/>
      <mass value="1e-9"/>
      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
    </inertial>
  </link>
  <joint name="left_foot_frame" type="fixed">
    <origin xyz="0.0005 0.036225 -0.01955" rpy="1.5708 0 0"/>
    <parent link="foot_assembly"/>
    <child link="left_foot"/>
    <axis xyz="0 0 0"/>
  </joint>
  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
  <joint name="left_ankle" type="revolute">
    <origin xyz="0 0.07865 1.537e-09" rpy="-0 0 0"/>
    <parent link="knee_and_ankle_assembly_2"/>
    <child link="foot_assembly"/>
    <axis xyz="0 0 1"/>
    <limit effort="10" velocity="10" lower="-1.5708" upper="1.5708"/>
  </joint>
  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
  <joint name="left_knee" type="revolute">
    <origin xyz="-0 0.07865 1.537e-09" rpy="0 0 -0"/>
    <parent link="knee_and_ankle_assembly"/>
    <child link="knee_and_ankle_assembly_2"/>
    <axis xyz="0 0 1"/>
    <limit effort="10" velocity="10" lower="-2.0944" upper="2.0944"/>
  </joint>
  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
  <joint name="left_hip_pitch" type="revolute">
    <origin xyz="0.0755 -1.7e-11 -0.035685" rpy="3.14159 -1.5708 0"/>
    <parent link="left_roll_to_pitch_assembly"/>
    <child link="knee_and_ankle_assembly"/>
    <axis xyz="0 0 1"/>
    <limit effort="10" velocity="10" lower="-0.523599" upper="1.22173"/>
  </joint>
  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
  <joint name="left_hip_roll" type="revolute">
    <origin xyz="0.019 -0.00011 0.04599" rpy="-1.5708 2.2e-10 -1.5708"/>
    <parent link="hip_roll_assembly"/>
    <child link="left_roll_to_pitch_assembly"/>
    <axis xyz="0 0 1"/>
    <limit effort="10" velocity="10" lower="-0.436332" upper="0.436332"/>
  </joint>
  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
  <joint name="left_hip_yaw" type="revolute">
    <origin xyz="-0.019 0.035 0.0474424" rpy="3.14159 0 0"/>
    <parent link="trunk_assembly"/>
    <child link="hip_roll_assembly"/>
    <axis xyz="0 0 1"/>
    <limit effort="10" velocity="10" lower="-0.523599" upper="0.523599"/>
  </joint>
  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
  <link name="neck_pitch_assembly">
    <inertial>
      <origin xyz="-2.01816e-07 0.0512025 0.0197247" rpy="0 0 0"/>
      <mass value="0.0949947"/>
      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
    </inertial>
    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
  </link>
  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
  <link name="head_pitch_assembly">
    <inertial>
      <origin xyz="-0.00908431 -0.0264769 -0.019" rpy="0 0 0"/>
      <mass value="0.0139999"/>
      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
    </inertial>
    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
  </link>
  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
  <link name="neck_yaw_assembly">
    <inertial>
      <origin xyz="0.000944043 1.54606e-07 -0.0213254" rpy="0 0 0"/>
      <mass value="0.124002"/>
      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
    </inertial>
    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
  </link>
  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
  <link name="xm430_assem">
    <inertial>
      <origin xyz="0.0160191 -6.80304e-05 0.00792267" rpy="0 0 0"/>
      <mass value="0.380052"/>
      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
    </inertial>
    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
  </link>
  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
  <link name="head">
    <origin xyz="0 0 0" rpy="0 -0 0"/>
    <inertial>
      <origin xyz="0 0 0" rpy="0 0 0"/>
      <mass value="1e-9"/>
      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
    </inertial>
  </link>
  <joint name="head_frame" type="fixed">
    <origin xyz="0.05369 -0 0.0228062" rpy="1e-12 1.5708 0"/>
    <parent link="xm430_assem"/>
    <child link="head"/>
    <axis xyz="0 0 0"/>
  </joint>
  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
  <joint name="head_roll" type="revolute">
    <origin xyz="0.04095 0 -0.0205" rpy="-0 -1.5708 0"/>
    <parent link="neck_yaw_assembly"/>
    <child link="xm430_assem"/>
    <axis xyz="0 0 1"/>
    <limit effort="10" velocity="10" lower="-0.523599" upper="0.523599"/>
  </joint>
  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
  <joint name="head_yaw" type="revolute">
    <origin xyz="0 -0.0581 -0.019" rpy="1.5708 -0 0"/>
    <parent link="head_pitch_assembly"/>
    <child link="neck_yaw_assembly"/>
    <axis xyz="0 0 1"/>
    <limit effort="10" velocity="10" lower="-2.79253" upper="2.79253"/>
  </joint>
  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
  <joint name="head_pitch" type="revolute">
    <origin xyz="-0 0.066 -0" rpy="3.14159 0 0"/>
    <parent link="neck_pitch_assembly"/>
    <child link="head_pitch_assembly"/>
    <axis xyz="0 0 1"/>
    <limit effort="10" velocity="10" lower="-0.872665" upper="0.872665"/>
  </joint>
  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
  <joint name="neck_pitch" type="revolute">
    <origin xyz="0.0009 0.019 0.0911524" rpy="1.5708 -0 -0"/>
    <parent link="trunk_assembly"/>
    <child link="neck_pitch_assembly"/>
    <axis xyz="0 0 1"/>
    <limit effort="10" velocity="10" lower="-0.349066" upper="1.13446"/>
  </joint>
  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
  <link name="hip_roll_assembly_2">
    <inertial>
      <origin xyz="-0.000681614 -0.000101097 0.0336873" rpy="0 0 0"/>
      <mass value="0.100996"/>
      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
    </inertial>
    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
  </link>
  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
  <link name="right_roll_to_pitch_assembly">
    <inertial>
      <origin xyz="-0.0512944 -0.000345831 0.021323" rpy="0 0 0"/>
      <mass value="0.106996"/>
      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
    </inertial>
    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
  </link>
  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
  <link name="knee_and_ankle_assembly_3">
    <inertial>
      <origin xyz="-1.87036e-07 0.0601954 0.0196696" rpy="0 0 0"/>
      <mass value="0.102496"/>
      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
    </inertial>
    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
  </link>
  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
  <link name="knee_and_ankle_assembly_4">
    <inertial>
      <origin xyz="-1.87036e-07 -0.0601954 0.0183304" rpy="0 0 0"/>
      <mass value="0.102496"/>
      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
    </inertial>
    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
  </link>
  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
  <link name="foot_assembly_2">
    <inertial>
      <origin xyz="0.0106462 -0.0244212 0.0187472" rpy="0 0 0"/>
      <mass value="0.0799077"/>
      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
    </inertial>
    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
  </link>
  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
  <link name="right_foot">
    <origin xyz="0 0 0" rpy="0 -0 0"/>
    <inertial>
      <origin xyz="0 0 0" rpy="0 0 0"/>
      <mass value="1e-9"/>
      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
    </inertial>
  </link>
  <joint name="right_foot_frame" type="fixed">
    <origin xyz="0.0005 -0.036225 0.01955" rpy="-1.5708 -0 -0"/>
    <parent link="foot_assembly_2"/>
    <child link="right_foot"/>
    <axis xyz="0 0 0"/>
  </joint>
  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
  <joint name="right_ankle" type="revolute">
    <origin xyz="0 -0.07865 -1.537e-09" rpy="-0 0 0"/>
    <parent link="knee_and_ankle_assembly_4"/>
    <child link="foot_assembly_2"/>
    <axis xyz="0 0 1"/>
    <limit effort="10" velocity="10" lower="-1.5708" upper="1.5708"/>
  </joint>
  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
  <joint name="right_knee" type="revolute">
    <origin xyz="0 0.07865 0.038" rpy="-3.14159 -0 -0"/>
    <parent link="knee_and_ankle_assembly_3"/>
    <child link="knee_and_ankle_assembly_4"/>
    <axis xyz="0 0 1"/>
    <limit effort="10" velocity="10" lower="-2.0944" upper="2.0944"/>
  </joint>
  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
  <joint name="right_hip_pitch" type="revolute">
    <origin xyz="-0.0751 -0.0002 0.035685" rpy="0 1.5708 0"/>
    <parent link="right_roll_to_pitch_assembly"/>
    <child link="knee_and_ankle_assembly_3"/>
    <axis xyz="0 0 1"/>
    <limit effort="10" velocity="10" lower="-0.523599" upper="1.22173"/>
  </joint>
  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
  <joint name="right_hip_roll" type="revolute">
    <origin xyz="0.019 -0.00011 0.04599" rpy="1.5708 -0 -1.5708"/>
    <parent link="hip_roll_assembly_2"/>
    <child link="right_roll_to_pitch_assembly"/>
    <axis xyz="0 0 1"/>
    <limit effort="10" velocity="10" lower="-0.436332" upper="0.436332"/>
  </joint>
  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
  <joint name="right_hip_yaw" type="revolute">
    <origin xyz="-0.019 -0.035 0.0474424" rpy="3.14159 -0 0"/>
    <parent link="trunk_assembly"/>
    <child link="hip_roll_assembly_2"/>
    <axis xyz="0 0 1"/>
    <limit effort="10" velocity="10" lower="-0.523599" upper="0.523599"/>
  </joint>
</robot>
