AkimaraYouki/SummerProject/reference_motion_generator/open_duck_reference_motion_generator/robots/open_duck_mini/open_duck_mini.urdf

<robot name="open_duck_mini">
    <mujoco>
        <compiler meshdir="assets/" balanceinertia="true" discardvisual="false" fusestatic="true"/>
    </mujoco>
    <link name="body_module">
        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
        <inertial>
            <origin xyz="-0.00675679511969270747 -0.006637466546945220737 0.0078705246973564610413" rpy="0 0 0"/>
            <mass value="0.50186117579999178773"/>
            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
        </inertial>
    </link>
    <link name="trunk">
        <inertial>
            <origin xyz="0 0 0" rpy="0 0 0"/>
            <mass value="1e-9"/>
            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
        </inertial>
    </link>
    <joint name="trunk_frame" type="fixed">
        <origin xyz="0.032527100485028298538 -0.0066038964305764145252 0.012578922950962011587" rpy="1.5111348801390835856e-14 -6.2433989600656048221e-14 9.1593399531630240418e-16"/>
        <parent link="body_module"/>
        <child link="trunk"/>
        <axis xyz="0 0 0"/>
    </joint>
    <link name="double_u_module">
        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
        <inertial>
            <origin xyz="-0.017000000000027194746 -8.4248510725113835815e-05 0.01158451252812944636" rpy="0 0 0"/>
            <mass value="0.018818301231819770797"/>
            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
        </inertial>
    </link>
    <link name="right_hip_pitch_roll_module">
        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
        <inertial>
            <origin xyz="0.011912825164996051694 -0.011752076745460894591 -0.0064503420228230780309" rpy="0 0 0"/>
            <mass value="0.050685765935093662904"/>
            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
        </inertial>
    </link>
    <link name="leg_module">
        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
        <inertial>
            <origin xyz="-0.039901628351739881762 -7.7113301695330656099e-06 0.011400440323216621402" rpy="0 0 0"/>
            <mass value="0.034530807353386039349"/>
            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
        </inertial>
    </link>
    <link name="leg_module_2">
        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
        <inertial>
            <origin xyz="-0.039901628351740887901 -7.7113301699271358301e-06 0.011400440323216496502" rpy="0 0 0"/>
            <mass value="0.034530807353386039349"/>
            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
        </inertial>
    </link>
    <link name="foot_module">
        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
        <inertial>
            <origin xyz="-0.026873167661377921067 0.0076028406460558663887 0.011556240850102265233" rpy="0 0 0"/>
            <mass value="0.028234070013912770242"/>
            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
        </inertial>
    </link>
    <link name="right_foot">
        <inertial>
            <origin xyz="0 0 0" rpy="0 0 0"/>
            <mass value="1e-9"/>
            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
        </inertial>
    </link>
    <joint name="right_foot_frame" type="fixed">
        <origin xyz="-0.037499999999999034106 -6.6570013390609972248e-17 0.011499999999999982458" rpy="1.5707963267948954478 -9.9920072216265019494e-15 1.570796326794896558"/>
        <parent link="foot_module"/>
        <child link="right_foot"/>
        <axis xyz="0 0 0"/>
    </joint>
    <joint name="right_ankle" type="revolute">
        <origin xyz="-0.065000000000002070011 -9.0726037793587011038e-16 1.249000902703301108e-16" rpy="-1.028864493624538396e-14 7.7715611723731079723e-16 2.0438598593485175549e-14"/>
        <parent link="leg_module_2"/>
        <child link="foot_module"/>
        <axis xyz="0 0 1"/>
        <limit effort="0.80" velocity="8.48" lower="-1.570796326794896558" upper="1.570796326794896558"/>
        <joint_properties friction="0.1"/>
    </joint>
    <joint name="right_knee" type="revolute">
        <origin xyz="-0.065000000000000890399 -1.8409752888803865289e-16 2.3592239273284576484e-16" rpy="1.1102230529243367767e-16 2.2204460492507932999e-16 -1.1500818382616808057e-13"/>
        <parent link="leg_module"/>
        <child link="leg_module_2"/>
        <axis xyz="0 0 1"/>
        <limit effort="0.80" velocity="8.48" lower="-2.0943951023931952626" upper="2.0943951023931952626"/>
        <joint_properties friction="0.1"/>
    </joint>
    <joint name="right_hip_pitch" type="revolute">
        <origin xyz="0.025000000000000646705 -0.024500000000000743405 -0.013499999999999783007" rpy="1.5707963267948972241 -9.4876329561990965088e-14 -3.141592653589793116"/>
        <parent link="right_hip_pitch_roll_module"/>
        <child link="leg_module"/>
        <axis xyz="0 0 1"/>
        <limit effort="0.80" velocity="8.48" lower="-0.52359877559829881566" upper="1.570796326794896558"/>
        <joint_properties friction="0.1"/>
    </joint>
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
        <parent link="body_module"/>
        <child link="head_link"/>
        <axis xyz="0 0 1"/>
        <limit effort="0.4" velocity="10.7" lower="-1.3089969389957472057" upper="0.1745329251994329478"/>
        <joint_properties friction="0.1"/>
    </joint>
</robot>
