AkimaraYouki/SummerProject/scripts/hw/rustypot_hwi.py

#!/usr/bin/env python3
"""14축 다이나믹셀(XM430) ↔ 실기 하드웨어 인터페이스. rustypot(Rust) 백엔드.

원본 리포(Open_Duck_Mini_Runtime)의 rustypot_position_hwi.py 를 이 로봇의 실기
구성(ID/부호/제한각)에 맞춰 이식한 것. dxl_bridge.py/play_ref_gait.py 가 쓰던
dynamixel_sdk(순수 파이썬) 대신 rustypot(Rust + PyO3 바인딩)을 쓴다.

rustypot 은 XM430 전용 클래스가 없지만, XM430 은 XL430 과 같은 Protocol 2.0
X-시리즈 레지스터 맵(주소 완전 동일: torque_enable=64, goal_current=102,
goal_position=116, present_position=132, hw_error_status=70 등)을 쓰므로
`Xl430PyController` 를 그대로 쓸 수 있다. 2026-08-07 실기 14축 전부 ping/읽기
확인 완료.

JOINTS 표는 기본적으로 dxl_bridge.py 와 같다 — 2026-08-06 실기에서 부호까지
확인된 값이다. neck_pitch(ID2)/head_pitch(ID12)는 2026-08-08 실측(Z자 목
수평유지 테스트로 확인)으로 부호를 뒤집었고, dxl_bridge.py/goto_ready.py/
play_ref_gait.py 도 같은 날 전부 맞춰 고쳤다 — 이제 네 파일 모두 일치한다.
"""

import math
import os
import struct
import time

import rustypot

BAUD = 1_000_000
TICK_RAD = 2.0 * math.pi / 4096.0
CENTER = 2048
CURRENT_UNIT_MA = 2.69
VEL_UNIT_RAD_S = 0.229 * 2.0 * math.pi / 60.0  # 0.229 rpm/unit -> rad/s

ADDR_OPERATING_MODE = 11
ADDR_HW_ERROR_STATUS = 70
MODE_CURRENT_POSITION = 5

# (관절, ID, 부호, URDF 하한, 상한) — dxl_bridge.py / goto_ready.py / play_ref_gait.py 와 같은 표.
JOINTS = [
    ("left_hip_yaw",     3, -1, -0.5236, 0.5236),
    ("left_hip_roll",    8, -1, -0.4363, 0.4363),
    ("left_hip_pitch",   9, -1, -0.5236, 1.2217),
    ("left_knee",       10, +1, -2.0944, 2.0944),
    ("left_ankle",      11, +1, -1.5708, 1.5708),
    ("neck_pitch",       2, +1, -0.3491, 1.1345),  # 2026-08-08: -1 이었으나 실측(손으로 앞으로 젖히면 reading 증가,
                                                     # +45 명령 시 실제로 앞으로 쏠림 확인)으로 부호 반전. 아래 참고.
    ("head_pitch",      12, -1, -0.7854, 0.7854),  # 2026-08-08: +1 이었으나 실측(+30 명령이 반대로 움직임)으로 부호 반전.
    ("head_yaw",        13, -1, -2.7925, 2.7925),
    ("head_roll",       14, -1, -0.5236, 0.5236),
    ("right_hip_yaw",    1, -1, -0.5236, 0.5236),
    ("right_hip_roll",   4, +1, -0.4363, 0.4363),
    ("right_hip_pitch",  5, +1, -0.5236, 1.2217),
    ("right_knee",       6, -1, -2.0944, 2.0944),
    ("right_ankle",      7, -1, -1.5708, 1.5708),
]
NAMES = [j[0] for j in JOINTS]
IDS = [j[1] for j in JOINTS]
BY_NAME = {j[0]: j for j in JOINTS}

# lock_head_joints=True 환경에서는 머리 4축을 정책이 안 건드리고 항상 READY로
# 고정 명령만 나간다 — 매 루프 SyncRead 에 넣을 이유가 없다. 뺀 만큼(14->10축)
# 버스 시간이 대략 비례해서 줄어든다(SyncRead 는 ID 당 응답 패킷 하나).
HEAD_NAMES = ("neck_pitch", "head_pitch", "head_yaw", "head_roll")
LEG_NAMES = [n for n in NAMES if n not in HEAD_NAMES]
LEG_IDS = [BY_NAME[n][1] for n in LEG_NAMES]

# 머리 3축(head_pitch 12 / head_yaw 13 / head_roll 14) 위치 PID 게인.
#
# 2026-08-08 에 head_roll 떨림을 잡겠다고 P=800->200, D=4700->0 으로 낮췄었는데
# **그게 틀렸다.** 그때는 평형 위치에서만 봐서 조용해 보였을 뿐, D=0 은 감쇠를
# 완전히 없앤 것이라 외란(런 중 몸통 진동)이 들어오면 크게 출렁인다.
#
# 2026-08-09 계단응답 실측(+100 tick, 정착 후 잔여 변동):
#     축          P=200/D=0    P=200/D=2000   P=800/D=4700(모드5 기본)
#     head_pitch    9 tick        1 tick          1 tick
#     head_yaw     66 tick        0 tick          1 tick
#     head_roll    95 tick        1 tick          3 tick
# P=200/D=2000 이 세 축 모두에서 잔여 진동이 가장 작고 오버슈트도 작다
# (head_roll +4 tick). 기본값도 안정적이지만 강성이 높아 전류를 더 쓴다.
# neck_pitch(ID2)는 요청 범위 밖이라 기본값 그대로 둔다.
HEAD_GAIN_IDS = (12, 13, 14)
#
# 2026-08-19: **축마다 다르게** 건다.
#
# 세 축을 다 800/4700 으로 올렸더니 실측 잔여 진동이 이렇게 나왔다
# (토크 ON, 자세 유지 중 10 초, p-p tick):
#
#     head_pitch(12)  1 tick  (0.09 도)   <- 4 축 중 가장 조용하다
#     head_yaw(13)    5 tick  (0.44 도)
#     head_roll(14)   6 tick  (0.53 도)
#
# 처짐이 문제인 축은 **중력 모멘트를 받는 head_pitch 하나뿐**이다. yaw 와
# roll 은 축이 중력과 나란해서 눌릴 일이 없으므로 강성을 올릴 이유가 없고,
# 올린 만큼 떨림만 늘었다. 그래서 12 만 높게 두고 13/14 는 되돌린다.
HEAD_P_PITCH = int(os.environ.get("ODM_HEAD_P", 800))
HEAD_D_PITCH = int(os.environ.get("ODM_HEAD_D", 4700))
HEAD_P_YAWROLL = int(os.environ.get("ODM_HEAD_P_YR", 200))
HEAD_D_YAWROLL = int(os.environ.get("ODM_HEAD_D_YR", 2000))
#: 옛 이름 호환 (다른 스크립트가 참조할 수 있다).
HEAD_P, HEAD_D = HEAD_P_PITCH, HEAD_D_PITCH


def head_gain(i: int) -> tuple[int, int]:
    """머리 축 ID -> (P, D). 12 만 높고 13/14 는 낮다 — 위 주석 참고."""
    return ((HEAD_P_PITCH, HEAD_D_PITCH) if i == 12
            else (HEAD_P_YAWROLL, HEAD_D_YAWROLL))

# ── 위치 PID 게인이 어디서 오는가 ─────────────────────────────────────────
#
# 800/0/4700 은 **아무도 쓰지 않았다.** Operating Mode(11) 를 바꾸면 펌웨어가
# 그 모드에 맞는 게인을 다시 넣는다. 2026-08-12 실측 (left_knee, 토크 off):
#
#     모드 3 (위치제어)          P 800  I 0  D    0
#     모드 5 (전류기반 위치제어)  P 800  I 0  D 4700   <- 우리가 쓰는 모드
#     모드 4 (확장위치제어)       P 800  I 0  D    0
#
# 그래서 이 값들은 RAM 이고, 전원 재인가·reboot **그리고 모드 전환** 때마다
# 되돌아간다. arm() 이 모드를 5 로 쓴 **뒤에** 게인을 걸어야 하는 이유다.
# 순서를 뒤집으면 조용히 무효가 된다.
#
# e매뉴얼 환산: KPP = P/128, KPI = I/65536, KPD = D/16.

#: 위치 PID 출력 1 단위가 만드는 관절 토크 (N·m).
#: 모드 5 에서 위치 PID 의 출력은 곧 목표 전류다 (Goal Current 로 잘린다).
#: 전류 1 단위 = 2.69 mA, 토크 = 1.96·(I − 0.27) 이므로 기울기는 1.96 N·m/A
#: (robot_cfg.py 와 같은 값 — ROBOTIS 성능그래프에서 뽑았다).
TORQUE_PER_AMP = 1.96
TORQUE_PER_CURRENT_UNIT = TORQUE_PER_AMP * CURRENT_UNIT_MA / 1000.0


def joint_stiffness(p_gain: int) -> float:
    """Position P Gain 레지스터값 -> 실효 관절강성 (N·m/rad).

    심의 액추에이터 `stiffness` 와 **같은 단위**라 바로 비교할 수 있다.

        kp = (P/128) [전류단위/tick] × TORQUE_PER_CURRENT_UNIT [N·m/전류단위]
                                     ÷ TICK_RAD [rad/tick]

    2026-08-12: P=800 -> 21.5 N·m/rad. 심은 37.65 다 — **실기가 1.75 배 무르다.**
    같은 부하에서 실기 관절이 1.75 배 더 밀린다는 뜻이고, 정책이 명령한
    위치에 실제 관절이 못 따라가던 것의 정체다.
    """
    return (p_gain / 128.0) * TORQUE_PER_CURRENT_UNIT / TICK_RAD


def p_gain_for_stiffness(stiffness: float) -> int:
    """원하는 관절강성(N·m/rad) 을 내는 Position P Gain 레지스터값. 위의 역함수."""
    return int(round(stiffness * TICK_RAD / TORQUE_PER_CURRENT_UNIT * 128.0))


#: 위치 PID 제어주기 (s). X 시리즈 펌웨어의 위치 루프는 1 kHz 다.
#: D 항이 이 주기당 오차 변화에 곱해지므로 감쇠 환산에 들어간다.
POS_LOOP_DT = 1.0e-3


def joint_damping(d_gain: int) -> float:
    """Position D Gain 레지스터값 -> 실효 관절감쇠 (N·m·s/rad).

    심의 액추에이터 `damping` 과 **같은 단위**라 바로 비교할 수 있다.

        kd = (D/16) [전류단위/(tick/주기)] × TORQUE_PER_CURRENT_UNIT [N·m/전류단위]
                                           ÷ TICK_RAD [rad/tick]
                                           × POS_LOOP_DT [s/주기]

    마지막 항이 핵심이다. 펌웨어는 미분을 **주기당 오차 차분**으로 계산하지
    dt 로 나누지 않는다. 나눈다고 보면 D=4700 이 1010 N·m·s/rad 가 나와
    물리적으로 말이 안 된다 (심이 1.352 다).

    ⚠️ 이 1 ms 가정은 e매뉴얼 블록도에서 읽은 것이고 **실측한 적 없다.**
    다만 자기점검이 하나 붙는다: 펌웨어 기본값 D=4700 을 넣으면 1.010 이
    나와 심의 1.352 와 25 % 안에 든다. 같은 실물 모터를 두고 각각 정한
    값이므로 이 정도로 맞는 것은 우연이 아닐 가능성이 높다. 그래도
    실기에서 감쇠를 바꿔야 한다면 추종오차를 재고 결정할 것.

    2026-08-14: 기본 4700 -> 1.010, 심 1.352. P 가 기본 800 에서 1.75 배
    어긋났던 것에 비하면 D 는 이미 거의 맞다.
    """
    return (d_gain / 16.0) * TORQUE_PER_CURRENT_UNIT / TICK_RAD * POS_LOOP_DT


def d_gain_for_damping(damping: float) -> int:
    """원하는 관절감쇠(N·m·s/rad) 를 내는 Position D Gain. 위의 역함수."""
    return int(round(damping * TICK_RAD / TORQUE_PER_CURRENT_UNIT / POS_LOOP_DT * 16.0))


#: 레지스터가 받을 수 있는 최대값 (XM430-W350).
#: 전류 1193 틱 = 3.21 A 인데 12 V 스톨 전류가 2.3 A(=855 틱)라 855 를 넘기면
#: **물리적으로 안 걸린다** — 1193 은 "전류 상한 없음" 과 같은 뜻이다.
CURRENT_LIMIT_MAX = 1193
#: 1023 틱 = 234 rpm. 출하 초기값 200(=45.8 rpm)이 이 모델의 무부하 속도라
#: 여기를 올려도 더 못 돈다. 중력에 끌려 순간적으로 넘을 때 서보가 제동을
#: 거는 것만 없어진다.
VEL_LIMIT_MAX = 1023

#: 심 `robot_cfg.py` 의 다리 액추에이터 stiffness. 실기를 여기에 맞춘다.
SIM_STIFFNESS = 37.65
#: 위 강성을 내는 P 게인 (= 1402). 기본값 800 이 아니라 이 값을 걸어야
#: 실기 관절이 심에서 학습한 만큼 따라간다.
LEG_P_MATCHED = p_gain_for_stiffness(SIM_STIFFNESS)

#: robot_cfg.py 의 액추에이터 `damping`.
SIM_DAMPING = 1.352
#: 위 감쇠를 내는 D 게인. 펌웨어 기본 4700 은 1.010 이라 이미 25 % 안이다.
#: 기본값을 이걸로 바꾸지 않는 이유는, 추종오차를 재기 전에 두 변수를 동시에
#: 움직이면 무엇이 들었는지 못 가리기 때문이다.
LEG_D_MATCHED = d_gain_for_damping(SIM_DAMPING)
#: 펌웨어가 모드 전환 때 되돌려 놓는 값 (모드 5 기준).
LEG_D_FIRMWARE_DEFAULT = 4700


def tick_of(name, rad):
    _, _, sign, lo, hi = BY_NAME[name]
    a, b = CENTER + sign * lo / TICK_RAD, CENTER + sign * hi / TICK_RAD
    lo_t, hi_t = int(round(min(a, b))), int(round(max(a, b)))
    return max(lo_t, min(hi_t, int(round(CENTER + sign * rad / TICK_RAD))))


def rad_of(name, tick):
    return BY_NAME[name][2] * (tick - CENTER) * TICK_RAD


class HWI:
    """14축 일괄 read/write. 각도는 전부 rad (URDF 관절각), 내부에서만 tick 변환."""

    def __init__(self, port="/dev/ttyUSB0", current_limit=350, leg_p=None, leg_d=None,
                 vel_limit=None):
        #: 다리 10축 Position P/D Gain. None 이면 펌웨어 모드 기본값(800/4700)
        #: 을 그대로 둔다. arm() 이 모드를 건 **뒤에** 적용한다 — 위 주석 참고.
        self.leg_p = leg_p
        self.leg_d = leg_d
        self.current_limit = current_limit
        #: 버스 통계. 런 끝에 찍어서 배선/전원이 나빠지는 걸 추세로 본다.
        self.read_timeouts = 0            # 타임아웃 발생 횟수(재시도 포함)
        self.read_timeout_recovered = 0   # 그 중 재시도로 살린 스텝 수
        self.read_corrupt = 0             # 응답 길이 손상 횟수
        #: Velocity Limit(44). None 이면 안 건드린다. **EEPROM 이라 한 번 쓰면
        #: 전원을 내려도 남는다** — 매번 쓰지 않고 값이 다를 때만 쓴다.
        self.vel_limit = vel_limit
        self.io = rustypot.Xl430PyController(port, BAUD, 0.05)
        # Shutdown 레지스터(addr 63, EEPROM)에 켜진 비트만 실제로 토크를 끊는다.
        # 여기 없는 에러 비트는 상태 기록일 뿐 모터는 계속 돈다. 이 로봇은
        # 0b00110100 = 과열(2)/전기충격(4)/과부하(5) 이고 **Input Voltage(0)는
        # 빠져 있다** — 2026-08-09 확인. 이걸 모르고 전압 비트에 반응해 리부팅
        # 하다가 보행 중 1초마다 400ms 씩 제어를 멈추는 사고를 냈다.
        self.shutdown_mask = [b[0] for b in self.io.sync_read_raw_data(IDS, 63, 1)]

    def arm(self):
        """토크 켜기 전 준비: 토크 끄고 -> 전류제한위치제어 모드 -> 전류상한 -> 토크 켜기.

        이전 세션에서 겪은 문제(재연결 후 stale 레지스터로 예상 밖 동작)를
        피하려고 매번 명시적으로 전 축을 같은 상태로 강제한다.
        """
        self.io.sync_write_torque_enable(IDS, [0] * 14)
        self.io.sync_write_operating_mode(IDS, [MODE_CURRENT_POSITION] * 14)
        self.io.sync_write_current_limit(IDS, [self.current_limit] * 14)
        self._apply_vel_limit()
        self.io.sync_write_torque_enable(IDS, [1] * 14)

        # 게인은 반드시 모드 전환 **뒤** — 모드를 쓰면 펌웨어가 게인을 덮는다.
        self._apply_head_gains()
        self._apply_leg_gains()

    def _apply_vel_limit(self):
        """Velocity Limit(44) 을 vel_limit 으로 맞춘다. 토크가 꺼진 동안만 쓸 수 있다.

        EEPROM 이라 쓰기 수명이 있다 — **이미 그 값이면 안 쓴다.** ProfileVelocity
        가 0(궤적생성 끔)이면 이 레지스터가 곧 속도 캡이 된다.
        """
        if self.vel_limit is None:
            return
        want = int(self.vel_limit)
        cur = self.io.sync_read_velocity_limit(IDS)
        if all(v == want for v in cur):
            return
        self.io.sync_write_velocity_limit(IDS, [want] * 14)
        got = self.io.sync_read_velocity_limit(IDS)
        bad = [(NAMES[k], got[k]) for k in range(14) if got[k] != want]
        if bad:
            print(f"[hwi] !! Velocity Limit {want} 을 못 걸었다: {bad}")
        else:
            print(f"[hwi] Velocity Limit {cur[0]} -> {want} (EEPROM 에 저장됐다)")

    def _apply_leg_gains(self):
        """다리 10축 위치 PID 게인. leg_p/leg_d 가 None 이면 건드리지 않는다."""
        if self.leg_p is None and self.leg_d is None:
            return
        for i in LEG_IDS:
            if self.leg_p is not None:
                self.io.write_position_p_gain(i, int(self.leg_p))
            if self.leg_d is not None:
                self.io.write_position_d_gain(i, int(self.leg_d))

    def read_leg_gains(self):
        """다리 10축의 (P, D) 를 LEG_NAMES 순서로 읽어 온다. 검증용."""
        raw = self.io.sync_read_raw_data(LEG_IDS, 80, 6)   # D(80,2) I(82,2) P(84,2)
        out = []
        for b in raw:
            if len(b) != 6:
                out.append((None, None))
                continue
            d, _i, p = struct.unpack("<HHH", bytes(b))
            out.append((p, d))
        return out

    def read_leg_limits(self):
        """다리 10축의 (전류상한, 속도상한) 을 실제로 읽어 온다. 검증용."""
        return list(zip(self.io.sync_read_current_limit(LEG_IDS),
                        self.io.sync_read_velocity_limit(LEG_IDS)))

    def _apply_head_gains(self, ids=None):
        """머리 3축(head_pitch/yaw/roll)의 위치 PID 게인을 HEAD_P/HEAD_D 로 건다.

        P/D 는 RAM 레지스터라 전원 재인가·reboot 시 공장값으로 돌아간다 —
        arm() 과 reboot 복구에서 매번 다시 걸어야 한다.
        """
        for i in (ids if ids is not None else HEAD_GAIN_IDS):
            if i in HEAD_GAIN_IDS:
                gp, gd = head_gain(i)
                self.io.write_position_p_gain(i, gp)
                self.io.write_position_d_gain(i, gd)

    def disarm(self):
        self.io.sync_write_torque_enable(IDS, [0] * 14)

    def set_position_all(self, joints_rad: dict):
        """joints_rad: {관절이름: rad}. 없는 관절은 건드리지 않는다."""
        ids, ticks = [], []
        for name, rad in joints_rad.items():
            ids.append(BY_NAME[name][1])
            ticks.append(tick_of(name, rad))
        self.io.sync_write_goal_position(ids, ticks)

    def set_position_vec(self, rad_vec):
        """rad_vec: NAMES 순서의 14-길이 배열/리스트.

        **실제로 서보에 나간 각도를 rad 로 돌려준다** (14-길이). tick_of 가 URDF
        한계에서 자르므로 이 값이 지령과 다를 수 있다 — 로그에는 이걸 남겨야
        한다. 2026-08-10 에 이걸 안 남겨서, 계단시험의 "18.7° 잔여오차" 가 실제
        추종오차인지 클램프인지 구분하느라 한참 헤맸다 (클램프였다).
        """
        ticks = [tick_of(NAMES[k], rad_vec[k]) for k in range(14)]
        self.io.sync_write_goal_position(IDS, ticks)
        return [rad_of(NAMES[k], ticks[k]) for k in range(14)]

    def get_present_positions(self):
        """NAMES 순서의 14-길이 리스트 (rad)."""
        ticks = self.io.sync_read_present_position(IDS)
        return [rad_of(NAMES[k], ticks[k]) for k in range(14)]

    def get_present_velocities(self):
        """NAMES 순서의 14-길이 리스트 (rad/s). 부호는 위치와 같은 관절 부호를 따른다."""
        raw = self.io.sync_read_present_velocity(IDS)
        return [BY_NAME[NAMES[k]][2] * raw[k] * VEL_UNIT_RAD_S for k in range(14)]

    def _sync_read_pos_vel_raw(self, ids, retries=6, timeout_retries=2):
        """sync_read_raw_data(ids, 124, 12) 을 하되, 응답이 손상된(12바이트가 아닌)
        축이 있으면 몇 번 재시도한다.

        2026-08-08 실기에서 겪음: arm() 직후 램프인(연속 SyncWrite)이 끝나자마자
        첫 SyncRead 가 struct.unpack 에서 죽었다 — 축 하나의 응답이 8바이트가
        아니었다(버스 전환 시점의 일시적 충돌로 추정, 재현은 못 함). 한 축
        읽기가 가끔 깨지는 것 때문에 전체 루프가 죽으면 안 되니 재시도로
        흡수한다. 재시도로도 안 되면 진짜 문제이니 그대로 예외를 던진다 —
        조용히 stale 값을 쓰는 것보다 멈추는 게 안전하다.

        2026-08-09: FTDI latency_timer 를 16->1ms 로 낮추자 이 손상이 훨씬 잦아졌다
        (응답 패킷이 USB 전송 여러 개로 쪼개져 도착하는 빈도가 늘어난 것으로 추정).
        2ms 로 절충하고, 재시도 횟수도 2->6 으로 올려 여유를 더 뒀다.

        2026-08-10: 주소를 128->126 으로 내리고 8->10 바이트로 늘렸다. 126 은
        present_current 라, 전류를 **공짜로** 같이 얻는다 (레지스터가 126/128/132
        로 붙어 있어 read 가 하나 더 늘지 않는다; 실측 12.1 -> 12.4 ms). 전류는
        토크 포화를 직접 재는 유일한 신호다 — current_limit=350 이 심의
        effort_limit_sim=4.1 N·m 의 41% 밖에 안 된다는 게 v40 주저앉음의 1번
        원인으로 지목됐고, 다음 런에서 그걸 로그로 확인해야 한다.

        2026-08-10(2): 다시 124/12 로 늘려 present_pwm 까지 넣었다. 보행 중
        left_knee 가 목표에서 33° 벌어진 채 **전류 0.000 A, 속도 0** 으로 100~240ms
        씩 멈춰 서는 구간이 7번 나왔는데(다른 축은 없음), 전류만으로는
        "제어기가 출력을 안 낸다" 와 "출력은 내는데 전류가 안 흐른다" 를 못 가른다.
        PWM 은 제어기 출력 그 자체라 그 둘을 가른다:
          PWM 0    + 오차 큼 -> 제어기가 목표를 그 위치로 알고 있다(토크off/지령문제)
          PWM 최대 + 전류 0  -> 구동단/배선 쪽

        2026-09-18: **타임아웃도 재시도한다.** 이 재시도는 지금까지 "응답이
        왔는데 길이가 틀린" 경우만 흡수했고, 아예 응답이 없어 rustypot 이
        RuntimeError("Operation timed out") 를 던지면 루프를 그냥 뚫고 나가
        런이 통째로 죽었다. 실제로 18.1 초까지 잘 걷던 런이 패킷 하나 빠진
        것으로 끝났다 (그 런 전압 최소 11.0 V — 전원은 정상이었다).
        1 Mbps 버스에서 10 축을 50 Hz 로 읽으면 수천 번에 한 번은 빠진다.

        예산을 손상/타임아웃으로 나눈 이유: 손상 응답은 **바로** 돌아와서
        재시도가 싸지만(6 회 써도 몇 ms), 타임아웃은 한 번에 컨트롤러
        timeout(50 ms)을 통째로 쓴다. 6 회면 300 ms 동안 제어가 멈춰 오히려
        더 위험하므로 타임아웃은 2 회(≈100 ms)까지만 본다.

        여기서 stale 값을 돌려주지 않는 것은 의도적이다 — 관측이 한 스텝
        밀리면 정책이 그걸 모르고 전 관절에서 어긋난 명령을 낸다.
        """
        timeouts = 0
        for attempt in range(retries + 1):
            try:
                raw = self.io.sync_read_raw_data(ids, 124, 12)
            except RuntimeError as e:
                if "time" not in str(e).lower():
                    raise            # 타임아웃이 아닌 RuntimeError 는 그대로
                timeouts += 1
                self.read_timeouts += 1
                if timeouts > timeout_retries:
                    raise RuntimeError(
                        f"SyncRead 무응답 — 타임아웃 {timeouts}회 연속"
                        f"{self._volt_hint()}") from e
                continue
            bad = [i for i, r in enumerate(raw) if len(r) != 12]
            if not bad:
                if timeouts:
                    self.read_timeout_recovered += 1
                return raw
            self.read_corrupt += 1
            if attempt == retries:
                raise RuntimeError(
                    f"SyncRead 응답 손상 (ID {[ids[i] for i in bad]}, "
                    f"바이트수 {[len(raw[i]) for i in bad]}) — 재시도 {retries}회 실패")
        return raw  # unreachable

    def _volt_hint(self):
        """예외 메시지에 붙일 전압 힌트. 이것도 실패하면 조용히 포기한다."""
        try:
            b = self.io.sync_read_raw_data(LEG_IDS[:1], 144, 2)[0]
            v = struct.unpack("<H", bytes(b[:2]))[0] / 10.0
            tag = " — 전원이 원인이다" if v < 11.0 else " — 전원은 정상, 버스/배선을 볼 것"
            return f" (지금 {v:.1f} V{tag})"
        except Exception:
            return " (전압도 못 읽었다 — 버스가 죽었거나 전원이 끊겼다)"

    def get_present_pos_vel(self):
        """위치+속도를 한 번의 SyncRead 로. (positions_rad, velocities_rad_s) 튜플, 둘 다 NAMES 순서.

        Present Velocity(addr 128, 4바이트) 와 Present Position(addr 132, 4바이트)이
        레지스터 맵에서 붙어 있어(128~135) 8바이트 한 번에 읽을 수 있다 — read를
        둘로 나누면 각각 고정 오버헤드(~16ms/축14개)가 또 붙는다. 이 버스에서
        14축 SyncRead 하나가 ~16-28ms 걸리는 게 실측됐다(2026-08-08) — 50Hz(20ms)
        예산 안에서 read를 여러 번 쪼개면 못 맞춘다.
        """
        raw = self._sync_read_pos_vel_raw(IDS)
        pos, vel = [], []
        for k in range(14):
            _w, _c, v_raw, p_raw = struct.unpack("<hhii", raw[k])
            sign = BY_NAME[NAMES[k]][2]
            pos.append(rad_of(NAMES[k], p_raw))
            vel.append(sign * v_raw * VEL_UNIT_RAD_S)
        return pos, vel

    def get_leg_pos_vel(self):
        """다리 10축만 pos+vel+current+pwm 을 한 번의 SyncRead 로.
        (positions_rad, velocities_rad_s, currents_A, pwm_frac) 튜플, 넷 다 LEG_NAMES 순서. 머리 4축을 뺀 버전 — get_present_pos_vel() 참고
        (같은 8바이트 결합 read, ID 수만 14->10).

        2026-08-08 실측: 14축 combined read 가 ~28ms 로 50Hz(20ms) 예산을 그 자체로
        넘겼다. 머리 4축(lock_head_joints=True 라 정책이 안 씀)을 빼면 ID 수가
        10/14 로 줄어 버스 시간도 대략 그 비율로 준다.
        """
        raw = self._sync_read_pos_vel_raw(LEG_IDS)
        pos, vel, cur, pwm = [], [], [], []
        for k, name in enumerate(LEG_NAMES):
            w_raw, c_raw, v_raw, p_raw = struct.unpack("<hhii", raw[k])
            sign = BY_NAME[name][2]
            pos.append(rad_of(name, p_raw))
            vel.append(sign * v_raw * VEL_UNIT_RAD_S)
            cur.append(c_raw * CURRENT_UNIT_MA / 1000.0)   # A, 부호는 모터 방향
            pwm.append(w_raw / 885.0)                      # -1..+1 (885 = 100% 듀티)
        return pos, vel, cur, pwm

    def get_hw_errors(self, confirm=True):
        """NAMES 순서의 14-길이 리스트. 값은 원본 hw_error_status 비트마스크
        (0=정상, bit0=Input Voltage, bit2=Overheating, bit3=MotorEncoder,
        bit4=ElectricalShock, bit5=Overload).

        confirm=True 면 두 번 연속 읽어서 같은 축이 에러일 때만 믿는다 —
        sync_read_raw_data 처럼 길이체크가 있는 게 아니라 rustypot 내장 파서라,
        응답이 쪼개져 도착하면 예외 없이 조용히 틀린 값을 만들 수 있어서다.

        confirm=False 는 **한 번만** 읽는다(SyncRead 1회 ~16ms). 제어 루프처럼
        예산이 빡빡한 곳에서 쓰고, 확인은 다음 루프에서 다시 읽어서 하면 된다.
        (2026-08-09: 보행 중 Input Voltage 비트가 거의 항상 떠 있어 confirm 경로가
        상시 2회 read 로 동작했고, 루프에서 이 함수를 두 번 부르는 바람에 10스텝마다
        4회 read = +65ms 스톨이 났다.)

        2026-08-09 실기 확인: 램프인 직후 첫 체크에서 여러 축에 Input Voltage
        Error(bit0)가 반복적으로 뜬다(그때그때 다른 조합) — 전압 자체는 재보면
        14축 다 11.7~11.8V 로 정상이라, 급격해진 다축 동시 가감속의 역기전력
        스파이크가 래치되는 것으로 추정(latency_timer 를 낮춰 루프가 빨라진 뒤
        생겼다). reboot 로 풀리는 걸 확인했다 — recover_input_voltage_errors() 참고.
        """
        first = list(self.io.sync_read_hardware_error_status(IDS))
        if not confirm or not any(first):
            return first
        second = list(self.io.sync_read_hardware_error_status(IDS))
        return [a if (a and b) else 0 for a, b in zip(first, second)]

    def mask_fatal(self, raw_errors):
        """이미 읽어둔 원본 에러 리스트를 Shutdown 마스크로 거른다. 루프에서
        read 를 한 번만 하고 치명/비치명을 둘 다 판단할 때 쓴다."""
        return [e & m for e, m in zip(raw_errors, self.shutdown_mask)]

    def get_fatal_errors(self):
        """get_hw_errors() 를 각 축의 Shutdown 마스크로 걸러, **실제로 토크가
        끊기는 에러만** 남긴 14-길이 리스트. 정지 판단은 이걸로 해야 한다.

        마스크 밖 비트(이 로봇에서는 Input Voltage)는 모터가 계속 도는 상태라
        멈출 이유가 없다 — 알고 싶으면 get_hw_errors() 원본을 따로 보면 된다.
        """
        return self.mask_fatal(self.get_hw_errors())

    def recover_input_voltage_errors(self, raw_errors):
        """get_hw_errors() 결과 중 **Input Voltage Error(bit0)만 단독으로** 켜진
        축을 reboot 후 재설정해서 복구한다. 다른 비트가 섞였으면 안 건드리고
        그대로 돌려준다 — 과열/과부하/전기충격/인코더 에러는 진짜 문제일 수
        있으니 호출자가 정지 여부를 판단해야 한다.

        reboot 은 그 축의 RAM 설정(토크/모드/전류상한, head_roll 이면 P/D 게인)을
        전부 날리므로 arm() 과 같은 순서로 다시 건다.

        반환: (recovered_names, remaining_names).
        """
        recovered_names, remaining_names, recovered_ids = [], [], []
        for name, err in zip(NAMES, raw_errors):
            if not err:
                continue
            if err == 1:  # bit0 단독
                recovered_names.append(name)
                recovered_ids.append(BY_NAME[name][1])
            else:
                remaining_names.append(name)
        if recovered_ids:
            for i in recovered_ids:
                self.io.reboot(i)
            time.sleep(0.3)
            self.io.sync_write_torque_enable(recovered_ids, [0] * len(recovered_ids))
            self.io.sync_write_operating_mode(recovered_ids, [MODE_CURRENT_POSITION] * len(recovered_ids))
            self.io.sync_write_current_limit(recovered_ids, [self.current_limit] * len(recovered_ids))
            self.io.sync_write_torque_enable(recovered_ids, [1] * len(recovered_ids))
            self._apply_head_gains(recovered_ids)
        return recovered_names, remaining_names

    def hold_here(self):
        """현재 위치를 목표로 덮어써 그 자리에 고정한다 (토크는 켠 채)."""
        pos = self.get_present_positions()
        self.set_position_vec(pos)
        return pos
