AkimaraYouki/SummerProject/(commit log)

2026-07-16 Initial commit: Open Duck Mini v2 Isaac Lab training pipeline
    Isaac Lab (PyTorch/PhysX) port of the Open Duck Mini v2 gait RL
    pipeline, replacing the previous MJX/Brax-based training. Wraps
    IsaacLab's own train/play scripts rather than reimplementing them,
    and adds a pure-MuJoCo CPU verification step (mujoco_infer.py) that
    runs independent of Isaac Sim.
    Two CPU-only unit tests pass on macOS:
    - test_poly_reference_motion_cpu.py
    - test_reward_leg_index_alignment.py
    Everything requiring Isaac Sim (URDF->USD conversion, train, play)
    needs a Linux/NVIDIA GPU machine — see README.md.
    [39281023.prt.stl, antenna.stl, antenna_holder_left.stl, antenna_holder_right.stl, antenna_motor_holder.stl, antenna_tip.stl, axis_to_axis.stl, battery_pack_lid.stl]
2026-07-20 Initial commit: miniduck — ManagerBasedRLEnv/skrl walking pipeline
    Backs up 원우's Open Duck Mini walking RL work: the miniduck IsaacLab
    extension package (skrl PPO, ManagerBasedRLEnv, 4-DOF knee/ankle-only
    action space, 18-term hand-crafted reward, no imitation), plus 49
    training runs (2026-04-28 to 2026-05-11, 200k timesteps each) with
    full checkpoint ladders and TensorBoard logs.
    Also includes external/isaaclab_assets_robots/open_duck_mini.py, a
    backup copy of the untracked custom robot definition that miniduck's
    env cfg imports from an IsaacLab checkout (robot make/IsaacLab) —
    that file was previously unprotected (untracked inside the official
    isaac-sim/IsaacLab clone).
    Known lim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
2026-07-20 Gate reference-motion/imitation behind use_imitation flag
    Stage 1 (use_imitation=False, new default) trains without the reference
    motion subsystem at all: PolyReferenceMotion is never instantiated, so
    reference_motion_pkl doesn't need to exist yet, and the "imitation"
    reward term is omitted from _get_rewards entirely rather than
    zero-weighted (avoids scoring against an all-zero reference frame).
    The 101-dim observation layout is unchanged either way — the
    imitation_phase (cos, sin) channel still runs off a periodic gait-phase
    counter, now driven by cfg.gait_period_steps as a fallback when no
    PolyReferenceMotion is loaded, instead of the reference motion's own
    nb_steps_in_period.
    Stage 2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
2026-07-25 Establish robot/ as canonical OnShape import location + record first import
    [bno055.stl, foot_bottom_pla.stl, foot_bottom_tpu.stl, foot_top.stl, head_bot_sheet.stl, head_pitch_to_yaw.stl, head_yaw_to_roll.stl, l_foot_side.stl]
2026-07-25 Verify no-mass warnings dont produce zero-mass links; refresh robot/ re-import
    [module_board_me.stl, part_1.stl, part_1__2.stl, part_1__3.stl, part_27.stl, robot.urdf]
2026-07-25 Close out board-inclusion investigation: was a stale name, not a bug
    [robot.urdf]
2026-07-25 Set --joint-damping from BAM XM430 characterization
2026-07-25 Confirm Korean-name USD path warning resolved after OnShape rename
    [robot.urdf]
2026-07-25 Fix body name mismatches against the real OnShape-derived URDF
2026-07-25 Set effort/velocity limits from XM430-W350 datasheet at confirmed 12.0V
2026-07-25 Fix stale docs claiming STS3215 is the real actuator (its XM430)
2026-07-25 Symlink reference_motion_generator URDF/assets to robot/ (was 10 days stale)
    [antenna.stl, battery_pack_lid.stl, bms.stl, bno055.stl, board.stl, body_back.stl, body_front.stl, body_middle_bottom.stl]
2026-07-25 Fix: restore URDF/assets as real files (exFAT cannot symlink, unlike Mac)
    [bno055.stl, body_bottom.stl, body_middle.stl, body_tail.stl, foot_bottom_pla.stl, foot_bottom_tpu.stl, foot_top.stl, head_bot_sheet.stl]
2026-07-25 Fix Stage 2 pipeline: pin placo==0.6.3, patch URDF with Placo frame aliases
    [open_duck_mini_v2.urdf]
2026-07-25 Fix Placo crash: remove antenna joint references (our rebuild has none)
2026-07-25 Log Stage 2 pipeline bug hunt (3 fixes) in training_log.md
2026-07-25 Remove antenna joint concept from reference-motion pipeline entirely
2026-07-25 Generate the first real polynomial_coefficients.pkl (240 gait samples)
2026-07-25 Log Stage 2 pipeline full success: antenna removal + auto_waddle python3 fix
2026-07-25 Flip use_imitation=True, restore alive_scale=20.0 (Stage 2 launch)
2026-07-25 Fix hardcoded 40-dim reference-frame allocation
2026-07-25 Log Stage 2 first real training launch (imitation_v1) + 2 more bugs fixed
2026-07-26 docs: Stage2 imitation_v1 결과 기록 - FAIL, twitching/reward-hacking
2026-07-26 fix: auto_waddle.py 속도필터가 preset_name의 인덱스 접두사 때문에 한 번도 매치 안 되던 버그 수정
2026-07-26 docs: 속도필터 버그 수정 후 레퍼런스 모션/검증 플롯 재생성 (117/117 in-band)
2026-07-26 docs: 좌우 비대칭 CAD/익스포트 이슈 기록, 학습 보류 결정
2026-07-26 docs: 재임포트로 무릎 관절방향/프레임 이슈 해결 확인, 질량 비대칭은 CAD에서 마저 수정 예정
2026-07-26 fix: HOME_JOINT_POS→0/HOME_BASE_HEIGHT→0.193 for new upright-fixed URDF; frame aliases now native from OnShape; sparse-grid nearest-neighbor fallback in PolyReferenceMotion
2026-07-26 docs: 좌우 비대칭 최종 해결 - OnShape 네이티브 프레임 메이트로 근본 수정
2026-07-26 docs: 좌우 대칭 최종 수정 후 검증 플롯 재생성 (120개, 100% in-band, 진짜 대칭)
2026-07-26 fix: enable Placo joint-limit enforcement + lower walk_com_height 0.2->0.16m
2026-07-26 fix: medium.json neck/head joint_angles + revert solver weight
2026-07-26 fix: medium.json walk_com_height 0.16 + feet_spacing 0.18
    [batt.stl, frame.stl, open_duck_mini_v2.urdf]
2026-07-26 fix: 무릎 굽힘 방향 강제 (left<0, right>0)
2026-07-26 data/viz: 무릎방향 강제 최종 pkl + 재생 뷰어 스크립트
2026-07-26 fix: 참조 속도채널 드리프트 편향 제거
2026-07-26 data: 드리프트 편향 제거된 pkl 재피팅
2026-07-26 docs: Run 7 착수 기록
2026-07-26 docs: Run 7 중단 기록
2026-07-26 fix: 무릎 ±120° + URDF-따라가는 방향강제, 무릎 ROM 부활 pkl
    [batt.stl, body_bottom.stl, body_middle.stl, body_tail.stl, frame.stl, left_knee_to_ankle_left_sheet.stl, leg_spacer.stl, open_duck_mini_v2.urdf]
2026-07-26 docs: Run 7 결과 기록 - FAIL
2026-07-26 feat: alive x w_joint_pos 조합 스윕 4종
2026-07-26 docs: BAM 재측정 불필요로 판정
2026-07-26 docs: 스윕 결과 기록
2026-07-26 feat: 몸통/머리 접촉 기반 종료조건 추가 (Disney BD-X 논문 V-B 참고)
    높이비율/뒤집힘 조건만으로는 우회 가능한 붕괴 자세가 있었음.
    ContactSensor로 trunk_assembly/head의 지면 접촉을 직접 감지해
    기존 조건에 OR로 추가 - 논문(Grandia et al. 2024)이 쓰는 접촉
    기반 종료조건과 동일한 방식.
2026-07-26 fix: 접촉기반 종료조건의 head 바디명 오류 수정 (head -> head_pitch_assembly)
    URDF의 head 링크는 관성이 없어 물리 바디로 안 남고 부모(head_pitch_assembly)에
    병합됨 - find_bodies가 head를 못 찾아 eval 실행 시 즉시 크래시했음.
2026-07-26 docs: imitation_v3(A20J5 풀런) FAIL 기록 + 리워드 클램프/rewbuffer 조사 + 접촉기반 종료조건 도입 배경
2026-07-27 docs: 접촉기반 종료조건 검증 통과 + WebRTC 육안 확인 기록, imitation_v4 착수
2026-07-27 feat: A30J25 (alive_scale=30, w_joint_pos=25) config 추가
    imitation_v3(A20J5 풀런)가 v2보다 악화된 뒤, 사용자 지시로 스윕 방향을
    뒤집어 시험: alive_scale/w_joint_pos 둘 다 낮추는 대신 올려본다.
    스윕 근거(alive=5 붕괴, w_joint_pos=15가 v2 트위칭 용의자)와는 반대
    방향이라 미검증 영역 - imitation_v4 완료 후 이어서 실행 예정.
2026-07-27 feat: imitation_v6 사전승인 fallback 추가 (imitation_scale=2.0 + init_noise_std=2.0)
    imitation_v5(A30J25)도 실패할 경우를 대비한 다음 레버 - 사용자 지시:
    이미테이션 관련 가중치 전체(imitation_scale 1.0→2.0)를 더 올리고,
    PPO 초기 탐험 노이즈(init_noise_std 1.0→2.0)도 넓혀서 로컬미니멈
    ("관절 고착 후 튕겨나감") 탈출을 시도. gym task
    Isaac-OpenDuckMini-Joystick-A30J25Im2N2-v0로 등록, v5 실패 시에만 실행.
2026-07-27 docs: imitation_v4 크래시(iter 2983 value function 폭주) + model_2900 eval FAIL 기록
2026-07-27 fix: 몸통/머리 종료조건 임계값을 발접촉 리워드와 분리, 0.5N으로 낮춤
    사용자가 WebRTC로 정책이 머리+발로 플랭크 자세를 잡아 종료조건을
    우회하는 걸 직접 목격 - 자기충돌이 꺼져있어 머리가 자기 다리에
    기대도 힘이 안 생기는 게 원인 후보. 발접촉 리워드용 임계값은
    그대로 두고 종료조건 전용 임계값만 1.0N -> 0.5N으로 분리.
2026-07-27 fix: 크로치 리워드해킹 대응 - min_base_height_ratio 상향 + 무릎/발목 접촉종료 추가
    contact_diagnostic.py로 확인: imitation_v4 수렴 정책이 base_z=0.133~0.134
    (HOME 대비 ratio~0.69)에서 완벽히 안정된 크로치 자세를 잡고 있었고, 이
    자세는 뒤집힘/높이(0.6)/몸통·머리 접촉(0N) 종료조건을 전부 동시에 피함.
    - min_base_height_ratio: 0.6 -> 0.75 (이 크로치가 새 기준 밑으로 들어감)
    - 접촉기반 종료조건에 양쪽 다리 knee_and_ankle_assembly(1~4) 추가
    (트렁크/머리는 안 닿아도 다리가 접혀서 자세를 낮추는 경우 감지 못했음)
2026-07-27 docs+feat: 크로치 리워드해킹 발견/대응 기록, contact_diagnostic.py 저장소에 추가, imitation_v5 시작
2026-07-27 fix: reward_breakdown.py가 --task 무관하게 A20J5 cfg로 하드코딩돼있던 버그 수정
    parse_env_cfg로 --task의 실제 등록된 env_cfg를 쓰도록 변경 - v5(A30J25)
    체크포인트 대상으로 처음 돌릴 때 발견, 안 고치면 alive=20/w_joint_pos=5로
    잘못 계산될 뻔했음.
2026-07-27 feat: Reference State Initialization(RSI) 도입 - DeepMimic/Disney 계보의 표준 기법
    v3(A20J5)/v4(A20J5+접촉종료)/v5(A30J25, 최악의 toggle=159.1)까지 alive_scale/
    w_joint_pos만 계속 조정했지만 전부 실패. 문헌조사 결과 원조 DeepMimic(Peng et
    al. 2018)이 쓰는 RSI를 우리는 빼먹고 있었음이 확인됨 - 매 에피소드가 항상
    레퍼런스 모션 phase=0(그리고 항상 같은 기본자세)에서 시작해서, 정책이 걸음
    주기 중간 구간을 아예 연습해볼 기회가 없었을 가능성.
    _reset_idx()에서 imitation_i를 0 고정 대신 [0, gait_period_steps) 균등샘플로
    바꾸고, 다리 관절(ACT_LEG_JOINT_IDX)의 초기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
2026-07-27 fix: RSI가 액추에이터 순서 인덱스를 네이티브 순서 텐서에 잘못 적용하던 버그 수정
    검증학습(rsi_validation)에서 에피소드 길이가 8 근처에 고정된 걸로 발견 -
    ACT_LEG_JOINT_IDX는 ACTUATOR_JOINT_NAMES 순서인데 joint_pos/joint_vel은
    네이티브(USD) 순서라 self._joint_ids로 매핑해야 했음.
2026-07-27 docs: imitation_v5 FAIL(toggle 159.1, 최악) 기록 + RSI 도입/버그수정 + imitation_v6 착수
2026-07-27 docs: v6 크래시(USD출력 실험 후 렌더파이프라인 손상)+재시작 경위 기록
2026-07-27 docs: imitation_v6 결과(toggle 29.4 역대최저, ROM 1.31 역대최대 - 첫 유의미 진전) + imitation_v7(RSI+num_envs 4096 스케일업) 착수 기록
2026-07-27 feat: RSI 켜고끄기 플래그(use_rsi) 추가 - Disney 논문엔 RSI가 없음을 확인
    사용자가 디즈니의 간단한 모방학습만 쓰고싶다고 요청. RSI(DeepMimic
    기법)는 확인 결과 Disney BD-X 논문 원문 어디에도 없음 - Disney는 항상
    고정된 레퍼런스 상태에서 에피소드를 시작하는 것으로 보임.
    RSI 코드를 삭제하는 대신 cfg.use_rsi 플래그로 켜고끌 수 있게 해서
    RSI 켠 버전(v6/v7)과 Disney 원본 방식(항상 phase=0)을 같은
    코드베이스에서 직접 비교 가능하게 함. 접촉기반 종료조건/크로치방지는
    그대로 유지 - 이건 Disney 논문에 실제로 나오는 방식(머리/몸통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
2026-07-27 docs: Disney 논문에 RSI 없음 확인 + use_rsi 토글 구현 배경 + v8(No-RSI) 계획 기록
2026-07-27 docs: imitation_v7 FAIL(toggle 90.6, v6보다 3배악화) 기록 - num_envs 스케일업이 오히려 역효과, v8(No-RSI) 착수
2026-07-27 docs: v8(No-RSI) 검증통과+본학습 시작 기록
2026-07-27 docs: imitation_v8 FAIL(toggle 96.7) 기록 + v6/v7/v8 RSI on/off 종합비교 결론
2026-07-28 docs: v7 WebRTC 육안확인(FAIL 정합) + reward_breakdown 재시도 계획 기록
2026-07-28 fix: reward_breakdown.py를 parse_env_cfg 대신 직접 cfg 인스턴스화로 되돌림
    parse_env_cfg 도입 후 매번 원인불명으로 조용히 크래시(5회 연속) -
    contact_diagnostic.py의 검증된 직접 인스턴스화 패턴으로 되돌리되,
    --task별 정확한 cfg 클래스 매핑 딕셔너리로 잘못된 가중치 버그는 유지 수정.
2026-07-28 feat: 리워드 쉐이핑 - imitation 관절각 항을 exp로 제한 (클램프 81.6%->0%)
    reward_breakdown_v2.py 실측: alive +0.400/step vs imitation -1.011/step,
    합계 -0.585 -> 81.6% 스텝이 clip으로 0이 되어 학습신호 소멸.
    원인은 관절각 항만 상한 없는 -err^2*w 형태였던 것.
    조치: bounded_joint_pos(exp 제한) + w 5.0->0.25(포화방지) +
    imitation_scale 1.0->4.0(alive와 균형). 검증 후 클램프 0.0% 확인.
2026-07-28 docs: 리워드 항목별 실측(클램프 81.6%) + 쉐이핑 수정(->0%) + imitation_v9 착수 기록
2026-07-28 fix: READY 자세 도입 - 액션이 레퍼런스에 도달 불가능하던 근본원인 해결 (action 8.1시그마 -> 1.30, joint_pos_rew 0.012 -> 0.510, 클램프 0%)
2026-07-28 feat: 다리만 학습(머리 잠금) + Z자 목 자세 + 리워드 해킹 3종 대응 (contact 스윙전용/alive 20->10/tracking_lin_vel 2.5->10)
2026-07-28 imitation_v12: fix lin_vel_xy reward discrimination + restore RSI
    Root cause of v10/v11: ~92% of imitation reward collectable while standing
    still; lin_vel_xy exp sharpness k=8 paid 0.57/1.0 for missing the reference
    speed entirely. Walk2 = k 8->20, w_lin_vel_z 1.0->0.1, w_ang_vel_xy 0.5->0.1,
    w_contact 1.0->2.0, alive_scale 10->3, use_rsi on.
    [antenna.stl, battery_pack_lid.stl, bms.stl, bno055.stl, board.stl, body_back.stl, body_front.stl, body_middle_bottom.stl]
2026-07-29 spawn 130mm; playback no pushes
2026-07-29 imitation_v25: path frame
2026-07-29 port to rsl-rl 5.0.1 so lab-PC checkpoints open here
    기계를 옮기며 IsaacLab이 바뀌었다: 랩PC는 isaaclab_rl 0.2.0 + rsl-rl 2.x,
    이 PC는 0.5.1 + rsl-rl 5.0.1. 그 사이 API가 두 군데 끊겨 재생/측정이 전부
    `KeyError: 'class_name'`으로 죽었다.
    1. 설정 스키마 — `policy` 하나가 `actor`/`critic` + `obs_groups`로 갈라졌다.
    상류의 `handle_deprecated_rsl_rl_cfg`를 부른다. 설정은 계속 `policy`로
    적어 두 세대 모두에서 뜨게 한다.
    2. 체크포인트 포맷 — `model_state_dict` 한 덩어리(정규화기는 러너 밖)에서
    `actor_state_dict`/`critic_state_dict`(정규화기는 모델 안)로 바뀌었다.
    v25의 mod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
2026-07-29 handoff: rsl-rl 5.0.1 이식 결과와 남은 RTX 문제 기록
2026-07-29 handoff: RTX 크래시 원인은 드라이버 595.84 — 580.173.02로 해결
    랩PC(같은 RTX 5080, 같은 커널/OS)와 비교하니 렌더러 바이너리의 GPU 아키텍처
    목록과 번들 CUDA가 완전히 동일한데 거기서는 멀쩡했다. 남는 변수는 드라이버뿐.
    595.84 -> 580.173.02 로 내리니 네이티브 창이 정상 동작한다.
    혼자 세웠던 가설(IOMMU / sm_120 미지원 / IsaacLab 설정 / 셰이더 캐시 /
    Isaac Sim 6.0 업그레이드 필요)은 전부 틀렸음도 함께 기록했다.
2026-07-29 odm: tb는 v26부터만 겹치고, watch의 잠복 실패 두 개를 고친다
    tb — v25 이하는 rsl-rl 2.x 산출물이라 5.0.1 런과 같은 그래프에 놓으면
    구현 차이를 알고리즘 차이로 오독한다. 기본 임계값을 v26으로 두고
    'odm tb 1' 처럼 낮춰 부르면 옛 런도 볼 수 있게 남겨뒀다.
    watch — 두 군데가 set -e 와 맞물려 조용히 죽고 있었다.
    1) grep -c 는 0건일 때 exit 1 이라, 크래시가 없는 정상 상황에서만 실패했다.
    2) rsl-rl 이 로그 문구를 'Mean action noise std:' -> 'Mean action std:' 로
    바꿔 해당 grep 이 빈손이 됐다. 양쪽 문구를 다 받도록 했다.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
2026-07-29 Xbox 패드로 시뮬을 실시간 조종한다 + 학습 중 건강 체크
    joystick_input.py — 리눅스 joydev(/dev/input/js0)를 직접 읽는다. pygame/evdev를
    안 쓰는 이유는 Isaac 파이썬에 그것들이 있으리라는 보장이 없고, joydev가 8바이트
    고정 구조라 struct 만으로 충분하기 때문이다. 의존성이 없으니 컨트롤러도 Isaac Sim
    도 없이 테스트가 돈다 — 파이프에 같은 바이트를 흘리면 커널과 구분되지 않는다.
    붙잡아 둔 함정들(테스트로 고정):
    - 장치를 열면 커널이 현재 상태를 JS_EVENT_INIT 로 한 번 보낸다. 버리면
    사용자가 스틱을 건드리기 전까지 축 상태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
2026-07-29 조이스틱: 축 배치를 하드코딩하지 말고 판별한다 + 확인용 스크립트
    실제 Xbox Wireless 패드에 물려보니 틀렸다. 오른쪽 스틱 X라고 믿은 3번이 그
    패드에서는 오른쪽 스틱 Y였고, 스틱에서 손을 뗐는데 yaw 명령이 -1.0 rad/s 로
    꽉 차 있었다 -- 로봇이 계속 제자리에서 도는 상태.
    실측한 두 배치:
    고전 xpad (유선) 2=LT, 5=RT -> 오른쪽 스틱 X = 3
    최신 hid (무선) 4=LT, 5=RT -> 오른쪽 스틱 X = 2
    트리거는 안 누르면 -1, 스틱은 0에서 쉰다. 장치를 열 때 커널이 보내주는 초기
    상태 이벤트로 그걸 보고 첫 poll 에서 배치를 확정한다.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
2026-07-29 조이스틱: 시간초과 리셋 해제 + 두 스틱의 가로축 맞바꿈
    사용자 요청 두 가지.
    1) 조이스틱 모드에서 20초마다 원점으로 되돌아가 조종이 끊겼다.
    episode_length_s 를 사실상 무한으로 두어 time_out 만 없앤다. 넘어짐/뒤집힘
    종료는 남긴다 — 그것까지 끄면 쓰러진 채로 영영 누워 있게 된다.
    2) 가로축 교환. 왼쪽 가로=회전, 오른쪽 가로=게걸음.
    (세로는 그대로 왼쪽=전후)
    덤으로 배치 판별을 한 자리에서 두 자리로 고쳤다. 2번만 보고 판별하면, 연결
    순간에 오른쪽 스틱을 왼쪽으로 밀고 있을 때 그 -1 을 LT 로 오인해 고전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
2026-07-29 리워드 항목별 로깅 + scripts 폴더 정리 + 지도 문서
    리워드 항목별 로깅 — 여태 텐서보드에 총합만 올라가서 리워드 해킹을 곡선으로
    볼 수 없었다. v26(3000 iter)에서 모방 리워드는 v25@1500보다 올랐는데
    (2.79 -> 2.85) 명령 추종은 오히려 내려간 것(전진 89% -> 81%)이 딱 그 사각지대다.
    _get_rewards 가 항목별 값에 dt 를 곱해 extras["log"] 에 넣는다. dt 를 곱하는
    이유는 항목 합이 스텝당 총 리워드와 같아져 "이 항이 전체의 몇 할인가"를
    그래프에서 바로 읽기 위해서다. 4 iter 로 확인했고, 첫 눈에 tracking_lin_vel
    (0.030)이 path_tracking(0.177)의 1/6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
2026-07-29 imitation_v27: 정책 관측에 중력 방향 + 태스크 매핑 중앙화 + 진단 2종
    v26 측정이 근거다. 3000 iter 로 v25@1500 의 2배를 학습했는데 명령 추종은
    오히려 내려갔고(전진 89% -> 81%, 관절오차 7.9 -> 8.5도) 모방 리워드는 올랐다.
    왜인지 재보니:
    몸통 roll RMS 7.20 deg (보행 중 8.2, 정지 4.1)
    모방 ang_vel_xy 항 최댓값의 3.6%
    고관절 roll/yaw 이탈 3.9 / 4.5 deg — 무릎·발목(5.3)보다 오히려 작다
    즉 고관절이 특별히 나쁜 게 아니라 몸통 자세 자체가 안 잡힌다. 그런데 정책
    관측에 중력 방향이 없다 — 자이로와 가속도계로 기울기를 유추해야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
2026-07-29 train_health: 리워드 항목별 추세로 리워드 해킹을 직접 판정
    v27부터 Episode_Reward/* 가 텐서보드에 남으므로, '어느 항만 오르고 명령 추종은
    정체'를 곡선에서 바로 잡을 수 있다. v26 이 정확히 그 양상이었다 — 모방 리워드는
    오르고(2.79 -> 2.85) 명령 추종은 내려갔는데(전진 89% -> 81%) 총합 곡선은
    예쁘게 올라갔다. 총합만 보던 계기판으로는 못 잡는다.
    판정: 추종과 경쟁하는 최대 양의 항이 +2% 넘게 오르는데 tracking_* 합계가
    +1% 미만이면 경고. alive 는 상수라 비교에서 뺀다.
2026-07-29 train_health: 에피소드 상한을 런 설정에서 읽는다 (오탐 수정)
    500 으로 박아뒀다가 v27 감시에서 '552/500 포화' 라는 오탐이 났다. 실제 상한은
    episode_length_s 20.0 / (dt 0.002 * decimation 10) = 1000 스텝이라 55% 였다.
    비율이 1을 넘는 게 단서였다.
    이제 런의 params/env.yaml 에서 읽는다. 조이스틱 재생처럼 episode_length_s 를
    바꿔 도는 경우도 있으니 상수로 두면 안 된다.
2026-07-29 모션 생성 파이프라인: 랩PC 원격 실행 + 런 비교 도구
    gen_reference_remote.sh — 레퍼런스 보행을 랩PC에서 생성한다.
    이 PC에는 placo 를 못 깐다: 0.6.3 을 설치하면 의존성 하나가 소스 빌드
    (cythonize)로 빠져 실패한다. 랩PC에는 placo 0.6.3 + pinocchio + scipy +
    matplotlib 이 이미 있고 **지금 쓰는 레퍼런스를 만든 게 그 환경**이라, 로컬에
    미묘하게 다른 환경을 새로 만드는 것보다 안전하다. 순수 CPU라 GPU 학습과
    충돌하지 않는다.
    로봇 키 손잡이는 medium 프리셋의 walk_com_height 다 (현재 0.16 -> 서는 높이
    121 mm). auto_waddle 이 preset_speeds = [medium] 로 고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
2026-07-29 calc_home: 레퍼런스 pkl 경로를 인자로 받는다
    하드코딩돼 있어서 새로 만든 레퍼런스(키를 높인 ref_h175.pkl 등)에는 쓸 수
    없었다. 레퍼런스를 바꾸면 이 스크립트로 READY_JOINT_POS 를 반드시 다시
    뽑아야 한다 — 기본 자세와 레퍼런스가 어긋나면 액션이 도달 불가능해지고,
    그게 v1~v9 를 아홉 번 실패시킨 원인이었다.
2026-07-29 붕괴 판정 기준 높이를 설정 필드로 (v28 키 높이기 준비)
    READY_BASE_HEIGHT 가 joystick_env.py 에 전역 상수로 박혀 있어 버전마다 다른
    안착 높이를 쓸 수 없었다. 레퍼런스의 walk_com_height 를 바꾸면 안착 높이가
    달라지는데, 전역을 고치면 v25~v27 체크포인트의 붕괴 판정 기준까지 함께 바뀐다.
    cfg.ready_base_height 로 빼서 버전마다 자기 값을 갖게 했다. 기본값은 기존
    전역 그대로라 v25~v27 동작은 변하지 않는다.
    검증 상태: py_compile 통과. 설정 인스턴스화 검증은 Isaac Sim 이 필요한데
    v27 학습 중이라 두 개를 못 띄운다 — v27 종료 직후 measure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
2026-07-29 odm measure: iteration 을 지정해 그 체크포인트를 잰다
    odm measure v27 1500 처럼. 왜 필요한가 — v26 이 v25@1500 보다 두 배 학습하고도
    명령 추종이 나빠졌다(89% -> 81%). 학습량이 다르면 비교가 성립하지 않으므로
    같은 iteration 끼리 재야 한다. v25/v26/v27 모두 model_1500.pt 가 있어
    3자 비교가 가능하다.
2026-07-29 map: 오늘 추가한 진단·생성 도구를 지도에 반영
    train_health / reward_terms / torso_vs_hip / compare_runs / gen_reference_remote.
    학습 중에 쓰는 것(GPU 불필요)과 끝난 뒤에 쓰는 것을 갈라 적었다 — Isaac Sim 을
    두 개 못 띄우는 제약이 실제로 도구 선택을 가른다.
    '같은 iteration 끼리 재라'도 적었다. v26 이 v25@1500 의 두 배를 학습하고도
    추종이 89% -> 81% 로 나빠진 게 이 규칙이 필요한 이유다.
2026-07-29 training_log: imitation_v27 결과 — 같은 학습량에서 추종 오차 22% 감소
    중력 관측 3차원 추가. v26@1500 대비 평균 추종 오차 0.0250 -> 0.0195.
    노린 지표(모방 리워드의 ang_vel_xy)도 0.0184 -> 0.0250 (+36%).
    다만 몸통 안정화 자체는 미미하다 — roll 7.20 -> 6.77도(-6%)인데 pitch 는
    3.88 -> 4.79도로 오히려 나빠졌다. 추종 개선은 실측이지만 '몸통을 안정화해서'
    라는 기전 설명은 확정이 아니다. 그대로 적었다.
    '더 오래 학습하면 나빠진다'가 v27 에서도 재현됐다(1500 0.0195 < 2000 0.0213).
    v25@1500 > v26@2999 에 이어 두 번째다.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
2026-07-30 imitation_v28: 로봇을 더 세운다 (레퍼런스 walk_com_height 0.16 -> 0.175)
    사용자 요청. 기존 로봇은 121 mm 로 상당히 웅크리고 걷는다.
    레퍼런스부터 다시 만들었다. 서는 높이는 임의 값이 아니라 레퍼런스 보행의 평균
    자세에서 나오므로(calc_home.py), READY 자세만 높이면 모방 리워드가 매 스텝
    웅크린 레퍼런스로 되돌리고 액션이 도달 불가능해진다 — v1~v9 를 아홉 번
    실패시킨 상황이다.
    무릎 2.032 -> 1.816 rad (12.4도 펴짐)
    고관절pitch 1.120 -> 1.011 rad (6.2도)
    필요 액션 최대 1.30 -> 1.46 (v1~v9 를 죽인 값은 8.1. 안전)
    안착 높이 121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
2026-07-30 좌우 미러 매핑을 레퍼런스 데이터에서 유도한다 (v29 준비)
    순진한 가정이 실제로 틀렸다. '왼쪽 i <-> 오른쪽 i, roll/yaw 부호 반전' 으로
    짰으면 세 관절이 틀렸을 것이다:
    가정 데이터
    hip_roll -1 +1
    knee +1 -1
    ankle +1 -1
    이 로봇 URDF 는 좌우 관절 축이 대칭이 아니다(같은 자세에서 left_knee -1.785 vs
    right_knee +1.816). 잘못 짜도 터지지 않고 그냥 나쁜 정책이 나오므로 특히
    알아채기 어렵다.
    유도 원리: ref(dx,+dy,+dth)[t][j] == s_j * ref(dx,-dy,-dth)[t+N/2][perm(j)].
    좌우를 뒤집으면 디딤발과 흔드는 발이 바뀌므로 반 주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
2026-07-30 좌우 미러: 관측 107차원까지 확장 + 테스트 11개 (v29 준비)
    관절 매핑(유도한 것)에 더해 관측 전체의 반사 규칙을 정했다. 핵심은 참벡터와
    유사벡터를 갈라야 한다는 것:
    참벡터 (x,y,z) -> ( x,-y, z) 가속도, 중력
    유사벡터 (x,y,z) -> (-x, y,-z) 자이로, 회전 명령
    반사는 det = -1 이라 유사벡터는 부호가 한 번 더 뒤집힌다. 자이로와 가속도에
    같은 부호를 먹이면 조용히 틀린다 — 테스트로 못 박았다.
    위상도 뒤집힌다. 좌우를 뒤집으면 디딤발과 흔드는 발이 바뀌어 보행 위상이
    반 주기 어긋나므로 imitation_phase (cos, sin) 는 둘 다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
2026-07-30 imitation_v29 배선: 좌우 미러 손실 (v28 종료 후 기동 예정)
    환경은 v28(Tall)과 동일하고 러너에 symmetry_cfg 만 더한다 — 한 번에 하나만.
    데이터 증강은 끄고 미러 손실만 켠다. rsl-rl 의 ppo.py 를 읽어 확인한 것:
    use_data_augmentation=False 이면 증강된 관측을 읽는 것은 액터뿐이고, 크리틱
    값은 그 전에 원본으로 이미 계산된다. 덕분에 정책 관측 107차원만 정확히
    뒤집으면 되고, 월드 좌표계 각속도가 섞인 크리틱 관측 211차원은 건드릴 필요가
    없다. 안 쓰는 것을 억지로 뒤집으면 틀릴 기회만 늘어난다.
    검증 상태: 미러 함수는 테스트 11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
2026-07-30 handoff: 야간 실험(v26~v29) 결과와 이번에 밟은 함정들 기록
    맨 위 '지금 상태 한 줄'이 v25 에서 멈춰 있어 오해를 부른다. 갱신 표시를 달고
    아래에 야간 실험 절을 붙였다.
    핵심: 현재 최고는 v27@1500(평균 추종 오차 0.0195). 그리고 '오래 학습하면
    나빠진다'가 두 번 재현됐다(v25@1500 > v26@2999, v27@1500 > v27@2000) —
    리워드 수렴은 행동 수렴이 아니다.
    밟은 함정도 남겼다: v27 의 기전 설명은 미확정, 스폰이 낮으면 안착 측정이
    오염됨, 좌우 미러를 가정으로 짜면 세 관절이 틀림, 홀수 주기라 반 주기가
    정수가 아님, v28 은 레퍼런스가 달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
2026-07-30 train_health: 수렴 판정을 구간 평균으로 자동화
    두 점 비교는 잡음에 속는다. v27 감시 중 실제로 한 번 속았다 — 두 점으로는
    정체처럼 보였는데 구간 평균으로는 상승 중이었다. 그때는 수동으로 다시 계산해서
    판정했는데, 매번 그럴 수 없으니 스크립트에 넣는다.
    최근 500 iter 의 양 끝을 40 iter 폭으로 평균해 비교하고, 1% 미만이면 수렴으로
    본다. 수렴이라고 찍을 때 '리워드 수렴은 행동 수렴이 아니다'도 같이 경고한다 —
    v26 은 곡선이 평평해진 뒤에도 명령 추종이 계속 나빠졌다.
2026-07-30 map: 새 도구 3종과 야간에 확인된 함정 4개 추가
    settle_height / derive_mirror / symmetry.py / task_registry 가 빠져 있었다.
    함정 절에도 스폰-안착 측정 오염, '오래 학습하면 나빠진다', '리워드 수렴은
    행동 수렴이 아니다' 를 넣었다 — 전부 이번 야간에 실제로 겪은 것이다.
2026-07-30 대체된 진단 스크립트 4개를 legacy 로 + 지도의 잘못된 안내 수정
    옮긴 것 (지우지 않았다):
    reward_breakdown.py / _v2.py -> diag/reward_terms.py
    리워드 수식을 스크립트에 복제해 놔서 환경과 어긋난다. 실제로 Path 태스크를
    몰라 KeyError 로 죽었고, 그게 task_registry 를 만든 계기였다.
    imit_internals.py -> imit_internals2.py
    settle_pose.py -> diag/settle_height.py
    전역 설정만 재서 새 태스크(Tall)에 못 쓴다.
    코드에서 import 하는 곳은 없고 문서·주석만 언급하고 있었다.
    그리고 내가 쓴 map.md 에 오류가 있었다 — 키를 바꿀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
2026-07-30 미러 layout 이 환경의 관측 조립 순서와 어긋나면 잡는 테스트
    symmetry.build_obs_layout 은 joystick_env.py 의 state = torch.cat([...]) 순서를
    복제하고 있다. 누가 환경 쪽 순서를 바꾸면 **총 폭은 그대로인데** 미러만 조용히
    틀린다 — 기존 폭 검사로는 절대 못 잡는 종류다.
    joystick_env.py 를 실제로 읽어 조립 순서를 뽑고 layout 과 대조한다.
    '항상 통과하는 테스트' 가 아닌지도 확인했다 — gyro 와 accel 을 일부러 뒤바꾸니
    제대로 실패한다.
2026-07-30 training_log: imitation_v28 — 키 +12%, 횡방향 오차 절반
    측정을 두 번씩 해서 잡음과 실제 개선을 갈랐다.
    확실한 것: 횡방향 오차가 절반으로 줄었다(좌 0.040 -> 0.017, 우 0.035 -> 0.018).
    두 번 다 같은 방향이고 잡음 폭 밖이다. v13 부터 이어진 최대 결함이었다.
    불확실한 것: 왜 좋아졌는지. 바꾼 건 키뿐인데 좌우가 좋아졌다. 추측은 있지만
    확인하지 않았고, 그대로 적었다. 전진 오차는 0.004~0.032 로 흔들려 개별 수치를
    믿으면 안 된다.
    '오래 학습하면 나빠진다'가 세 번째로 재현됐다(v28@1500 < v28@2000).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
2026-07-30 train_health: 미러 손실(Loss/symmetry) 감시 추가
    v29 의 성패를 가르는 지표다. 켜놓고 안 내려가면 계수가 너무 작거나 미러 매핑이
    틀린 것인데, 미러가 틀려도 학습은 터지지 않고 그냥 나쁜 정책이 나오므로
    곡선으로라도 잡아야 한다. 표본이 60개 넘게 쌓인 뒤에도 하락세가 아니면 경고하고,
    어디부터 보라고(tests/test_symmetry.py, diag/derive_mirror.py) 같이 찍는다.
2026-07-30 train_health: 미러 손실 경고를 최고점 기준으로 (두 번 틀리고 고침)
    첫 판정은 '최근 추세'만 봤다 -> 바닥에 수렴한 정상 상태와 매핑 오류를 구분
    못 한다. v29 에서 실제로 오탐이 났다.
    두 번째 판정은 '초기값 대비'로 바꿨는데 이것도 틀렸다. 학습 시작 시점엔
    정책의 평균 액션이 거의 0 이라 **자동으로 대칭**이고 미러 손실이 인위적으로
    낮다. v29 는 0.0135 로 시작해 0.0188 까지 올랐다가 0.0138 로 내려왔는데,
    초기값과 비교하면 '안 줄었다'로 보인다.
    셋째로 최고점 기준으로 고쳤다. 최고점 대비 -27% 로 정상 하락 중이고 경고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
2026-07-30 training_log: imitation_v29 — 미러 손실은 이득 없음 (음성 결과)
    v28 과 통계적 동률(0.0156 vs 0.0153). 노린 표적인 좌우에서도 평균은 그대로이고
    분산만 커졌다.
    분석 중 내렸던 결론 하나를 철회했다. v29@1500 만 보고 '미러 손실이 좌우 대칭을
    깨뜨렸다'고 적었는데, @1600 에서는 좌가 멀쩡하고 대신 우가 나빴다 — 어느 쪽이
    나쁜지가 측정마다 뒤바뀐다. 계통적 결함이 아니다.
    배운 것: 명령별 오차는 표본당 ±0.02 로 흔들린다. 한두 번 측정으로 특정 명령을
    논하면 안 된다.
    왜 안 통했는지 추측도 남겼다(미검증): 미러 손실이 멈춘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
2026-07-30 imitation_v30: 키를 한 단계 더 (walk_com_height 0.175 -> 0.19)
    v28 이 지금까지 유일하게 명확한 개선이었다 — 키를 121 -> 136 mm 로 올렸더니
    최대 결함이던 횡방향 오차가 절반이 됐고(좌 0.040 -> 0.017, 우 0.035 -> 0.018),
    각 4표본으로 구간이 겹치지 않는다. v29(미러 손실)는 같은 표적을 노렸으나 이득이
    없었으므로, 통한 쪽을 한 번 더 민다.
    무릎 2.032 -> 1.816 -> 1.514 rad
    안착 높이 121 -> 136 -> 154 mm (원래 대비 +27%)
    필요 액션 1.30 -> 1.46 -> 1.87
    필요 액션이 계속 오르는 것을 주석에 남겼다. v1~v9 를 죽인 값은 8.1 이라 아직
    여유가 크지만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
2026-07-30 handoff: 결과 표를 v30 까지 갱신, 최고는 v28@1500
    v27 에서 멈춰 있던 표를 v28/v29 결과까지 채웠다. v28 이 유일하게 명확한
    개선이고(횡방향 절반) v29 는 이득 없음. 측정 잡음(±0.02)과 2회 측정 원칙도
    적었다 — 한두 번으로 특정 명령을 논하면 안 된다.
2026-07-30 최고 모델 보행 그림 4장 (diag/plot_best.py)
    odm measure 가 떨어뜨린 npz 만 읽는다 — GPU 를 안 쓰므로 학습 중에도 돌아간다.
    1 명령 추종 6방향 시간축 + 명령선. 막대로 평균만 찍으면 흔들림이 사라진다.
    2 보행 다이어그램 좌우 발 접지 + 레퍼런스 위상
    3 관절 궤적 다리 10관절 정책 vs 레퍼런스, 한 주기로 접어 평균
    4 경로 이탈 path frame 대비 횡방향
    그리면서 잡은 실제 버그 두 개. joint npz 의 phase 는 라디안이 아니라
    0..period-1 정수 카운터(_imitation_i)다:
    - 보행 다이어그램의 레퍼런스 접지 행이 그 오해로 의미 없는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
2026-07-30 graphs: write down the conventions the v28 figures broke
    The v28 figures drew each of six comparison panels on its own autoscaled y-axis
    (stop spanned -0.8..0.2 for data that never left +-0.05, because the 10-90
    percentile band drove the scale), left and right knee with opposite signs so the
    left/right asymmetry the figure existed to show could not be read, a contact
    diagram with no reference to compare against on an imitation task, a subtitle
    overlapping a row label, and a caption rendered as a Python tuple repr because a
    trailing comma made the string a 1-tuple.
    None of that is visible from the code -- only from opening the PNG -- so the
    guide says to open it. It lives in docs/ to be vers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
2026-07-30 graphs: the tuple caption bug was already fixed; point at the real script
    Re-fetched the PNGs and found they had been regenerated between my two reads --
    the caption renders correctly now. Downgraded that item to an example of why the
    guide says to open the file, since it is the clearest case of a defect that is
    invisible in the code. The y-axis item stands: sharey is still unused.
    Also names scripts/diag/plot_best.py as the file to change, rather than leaving
    the reader to find it.
2026-07-30 graphs: redo v28 figures to the conventions in docs/graph_conventions.md
    The four figures broke nine house rules at once. The two that mattered:
    Axis ranges (rule 1). Six panels, six different y-scales, so the one thing
    the figure exists for -- comparing directions -- was impossible. The stop
    panel's real signal is +-0.05 m/s but the axis ran to -0.8 because the
    10-90 band's extremes and the warmup transient were both in the autoscale.
    Now the five m/s panels share an axis, turn is split off as rad/s, and
    set_ylim comes from the mean trace with warmup excluded; the band is left
    to clip and the caption says so.
    Left/right sign (rule 2). Right knee read +100..+120 against lef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
2026-07-30 measure: record base height; rule out joint asymmetry as the drift cause
    Aligning left and right correctly (sign flip + half-period shift) puts
    v28's joint asymmetry at 1.4-2.8deg against a reference floor of
    0.4-3.7deg -- the policy is already as symmetric as the reference motion
    allows, so the lateral drift asymmetry has to come from somewhere else.
    Recorded in the open-questions list with the alignment caveat, since
    skipping the shift reads phase offset as asymmetry (the reference, which
    is symmetric by construction, scores 14.0deg unaligned).
    This also corroborates the v29 write-up from the other direction: that
    entry blamed the mirror loss's floor on the reference's own left/right
    resi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
2026-07-30 log: v30 gets the height it was for, and loses 47% of tracking for it
    The experiment changed the reference motion's height, and every
    measurement in this repo reported tracking error -- nothing recorded how
    tall the robot actually walks, so there was no way to say whether it
    worked. With base_h now recorded: +16.4mm on average, matching the
    intended +15 to +17.7mm, with no increase in spread. Tracking goes
    0.0158 -> 0.0233.
    Best checkpoint stays v28 model_1500.pt. v30 is a trade, not a
    regression to revert -- it was aimed at something else.
    Two old lessons repeated: v30@1500 measured 0.0245 then 0.0157, so one
    measurement still cannot judge a version; and tracking again degraded
    between it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
2026-07-30 ref: kill three left/right-asymmetry hypotheses before spending a GPU on them
    v29 and v30 pointed at the same next experiment from different directions:
    symmetrize the reference motion. Measured the reference first instead of
    training against it, and the ~1.5deg left/right residual turns out to sit
    in placo's raw output -- 1.47deg before the polynomial fit, 1.53deg after.
    Yaw grid. min/max_sweep_theta +-0.3 at granularity 0.07 does not divide
    evenly, so the grid lands on -0.02/+0.05, zero is never sampled, and not
    one of 118 commands has a sign-flipped partner. Left and right turns were
    being interpolated from differently-placed grids. Real defect -- kept the
    fix (--yaw-sweep 0.28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
2026-07-30 handoff: close the reference-side branch of the left/right asymmetry
    The remaining candidates are closed-loop -- torso attitude and contact
    timing. Also notes the grid defect that turned up on the way: the
    reference command grid has no zero-yaw command at all.
    Claude-Session: https://claude.ai/code/session_01Ktvp75ksqEpSsRvABxjE7i
2026-07-30 diag: measure leg-trunk clearance on exact meshes; v28 is at 11.5%, not 56.7%
    The 56.7% in the handoff is v25's number and it moved: v28 measures 11.5%
    contact, tracking the drop in hip roll/yaw deviation from ~8-9deg to
    3.7/2.8deg. Still not zero, and for hardware zero is the requirement.
    Runs off the trajectories gait_compare.py already saves -- leg-to-trunk
    distance depends only on the leg joint angles -- so it needs no new
    rollout. pinocchio cannot be imported inside Isaac Sim's python, so the
    distance step runs on the lab PC, which has 2.7 + hppfcl via placo.
    Validated against the known reference figure before trusting the policy
    number: reference comes out 0% contact at 5.9mm minimum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
2026-07-30 v31: bound hip roll/yaw deviation from the reference (sim-to-real, contact breaks hardware)
    Target is hardware now, so leg-trunk contact is not a quality issue --
    it is breakage. Measured v28 on exact meshes: 11.5% contact, 0.0mm
    minimum, worst laterally (left 25%, forward 19%; stop and backward are
    already clean). Reference is 0% at 5.9mm.
    v25 was 56.7% and nothing was done about it -- it fell to 11.5% because
    hip roll/yaw deviation fell with it. Contact rides on that deviation, so
    bound the deviation directly.
    An absolute joint-range limit does nothing here. The reference already
    sweeps +-16.5deg of hip roll and +-10.2deg of yaw, and the policy's
    absolute angles stay inside that; what va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
2026-07-30 v31 failed: clamping hip targets tripled leg-trunk contact
    11.5% -> 30.2%, median clearance 7.5mm -> 1.6mm, tracking unchanged at
    0.0163. Config was live in params/env.yaml, so the clamp ran and made
    things worse.
    Two mistakes at once. The clamp binds _motor_targets, but measured joint
    deviation went *up*, 7.03 -> 9.44deg -- PD control and contact forces
    carry the achieved position past the target, so the quantity that matters
    was never bounded. And it did not clip a tail: the median clearance moved,
    which means the whole posture shifted inward once the policy lost
    authority over those joints. torso_vs_hip had flagged that risk at
    |r| = 0.404; the cost showed up as posture drift rather than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
2026-07-30 v32: penalize only inward hip deviation, on the measured joint angle
    Redesign of v31, which clamped motor targets in both directions and
    tripled contact (11.5% -> 30.2%). Two fixes, one per failure mode.
    Measured which joint and which direction actually closes the gap, which
    is what I skipped before (300 v28 poses, 13% contacting):
    right_hip_yaw r = -0.472 +4.8deg contacting vs -0.3deg not
    left_hip_yaw r = +0.412 -4.4deg vs -2.6deg
    right_hip_roll r = +0.352 -5.0deg vs -1.0deg
    left_hip_roll r = -0.064 no signal
    The signs are physically coherent: hip_yaw mirrors with sign -1, so left
    negative and right positive are the same direction -- both legs yawing
    inward. hip_r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
2026-07-30 clearance: judge against a 5mm hardware margin, not bare contact
    User set the hardware safety threshold: 5mm. Part tolerances mean 'did
    not touch' is not the bar -- the legs have to stay that far off the trunk.
    Contact rate understates the problem by about three to one. On v28's 300
    sampled poses: 13.0% contacting, 29.3% under 3mm, 38.0% under 5mm. The
    11.5% figure this work has been steering by is the wrong number for a
    hardware target.
    Also note for calibration: inward hip deviation separates contacting from
    non-contacting poses well (r = -0.472 per joint) but separates 5mm
    violations poorly (r = -0.301 on the max-over-joints measure, with the
    detection rate barely above the false-positi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
2026-07-30 safety: 5mm is the bar, and no per-joint limit can hold it
    User fixed the hardware criterion: leg-to-trunk contact breaks the
    actuator, so the legs must stay 5mm clear, strictly.
    Contact rate was understating the problem threefold. v28 measures 13.0%
    contacting but 38.0% under 5mm. Every judgement in this log up to now
    used the wrong number.
    That also rules out the soft penalty v32 is training on -- a reward term
    reduces violations statistically and cannot promise none.
    Hard joint limits would be enforced by physics, which is what v31 lacked,
    so I tested whether the reference's own joint box is safe throughout:
    4000 random combinations inside it, 8.0% violate 5mm, minimum 0.0mm. The
    worst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
2026-07-30 v32 works: contact eliminated, 5mm violations 38% -> 1.0%
    Median clearance moved 6.7 -> 13.8mm, so the whole posture backed away
    from the trunk -- the exact opposite of v31, which pushed it from 7.5 to
    1.6mm. Two experiments aimed at the same thing landed in opposite
    directions, and the difference is only that v31 clamped both directions
    on the motor target while v32 penalized the inward direction on the
    measured angle.
    Cost is tracking 0.0158 -> 0.0200, concentrated laterally (left/right go
    from about 0.018/0.021 to 0.034/0.047). hip_roll is what produces lateral
    motion, so penalizing it is directly responsible.
    Remaining 1.0% is entirely the turn command, minimum 4.0mm. The reference
    its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
2026-07-30 cbf: learn the barrier in 5D after two geometric approximations failed
    Approximating the shapes does not work at this scale. A single capsule
    puts the trunk at a 112.8mm radius. Sphere sets (64 trunk + 24 per shin)
    are properly conservative -- zero cases of reporting more clearance than
    the mesh -- but sit 30.8mm below the true distance on average, so every
    pose reads as deep penetration when the real clearance is 5-14mm.
    Reaching ~2mm radii would need thousands of spheres.
    Measured two structural facts instead (check_barrier_dims.py): trunk-to-
    shin clearance is completely independent of the opposite leg (0.0000mm
    across 60 poses) and left/right are mirror images to within 0.22mm. So
    the b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
2026-07-30 cbf: filter verified on exact meshes -- 38% of 5mm violations down to 0%
    Applied to v28's poses, the worst trajectory we have, and re-measured
    with hppfcl rather than the learned h (checking an approximation with the
    same approximation verifies nothing): 5mm violations 38.0% -> 0.0%,
    contact 13.0% -> 0.0%, minimum clearance 0.0 -> 6.36mm. That minimum
    lands where the design predicts, at the 5mm bar plus the 1.9mm
    conservative offset.
    Cost is small: it touches 55% of poses but moves joints 0.54deg on
    average.
    Two deliberate departures from the textbook formulation. No QP -- the
    constraint is a single scalar per leg, so each step has a closed form and
    a solver would be wasted. And it iterate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
2026-07-30 cbf: closed-loop verification passes -- 0% of 5mm violations on every command
    Static poses were not enough: the filter changes what the policy sees, so
    the whole trajectory moves. Ran v32 through all six commands with the
    filter live and re-measured the resulting trajectory on exact meshes.
    5mm violations v28 38.0% -> v32 1.0% -> v32+filter 0.0%
    minimum clearance 0.0mm -> 4.0mm -> 7.5mm
    tracking 0.0158 -> 0.0230 -> 0.0250
    Zero on every command individually. The turn command, the one case v32
    alone still failed (6.0%, 4.0mm), comes up to 8.0mm.
    Tracking costs 9% over v32 because the filter rarely has to engage --
    v32 was already w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
2026-07-30 cbf: all three pre-hardware checks pass, and the filter smooths motion
    Compute: 0.881ms per step on CPU for one env, 4.4% of the 20ms budget.
    No GPU needed -- CPU is faster here, the net is small enough that kernel
    launch dominates arithmetic.
    Disturbances: no extra run needed. push_robot is defined in the cfg and
    gait_compare does not disable it, so the closed-loop result that measured
    0% violations already had pushes active. Terrain is still flat.
    Smoothness: expected the filter to introduce sharp target changes and
    found the opposite. Peak joint velocity drops 422.7 -> 314.3 deg/s and
    per-step change is flat at 1.41 -> 1.36deg. Violating poses are the ones
    where a joint has swung far ou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
2026-07-30 filter: hand-write the backward pass so inference_mode cannot kill it
    Driving the robot crashed on launch. play_fixed_cmd.py steps the env
    inside torch.inference_mode(), where autograd is disabled outright, so
    the filter's autograd.grad call died with the element-0-does-not-require-
    grad error. Measurement never hit this because gait_compare wraps only
    the policy call, not env.step.
    The barrier is a four-layer MLP, so the gradient is a few lines by hand.
    Doing it manually drops the autograd dependency entirely -- code that
    runs every control step should not depend on the caller's grad mode.
    Checked against central differences (max deviation 0.013 mm/rad) and
    confirmed working inside inferen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
2026-07-30 demo: restore the Z-neck, colour the robot, and put it all behind demo.sh
    Three things surfaced while driving the robot.
    The head sat straight. READY_JOINT_POS_H175 and _H190 carry
    neck_pitch/head_pitch at 0 because calc_home.py derives them from the
    reference motion and the reference does not move the head -- not because
    0 is the right pose. The base READY_JOINT_POS has both at 0.785, which is
    what gives the BD-X neck its Z. The head is excluded from the imitation
    reward and held by lock_head_joints, so restoring it changes nothing in
    training.
    The robot rendered grey. The URDF defines 42 distinct visual colours and
    IsaacLab's converter drops all of them -- the converted USD has zero
    Mate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
2026-07-30 sleep 20; echo "재촬영 시작됨" revert: put the head back to 0 -- posing it moved the centre of mass
    Restoring the BD-X Z-neck (neck_pitch/head_pitch to 0.785) made the robot
    lean forward and topple in playback. I had claimed it was free because
    the head is excluded from the imitation reward and held by
    lock_head_joints. That reasoning was wrong: being absent from the reward
    is not the same as being absent from the dynamics.
    Measured with pinocchio, standing the head up moves the centre of mass
    14.3mm in x (-8.8 to -23.1mm) on a robot whose feet are 60mm long. The
    policy was trained around the head-at-zero mass distribution, so shifting
    it is a disturbance it has never seen.
    Wanting t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
2026-07-30 v33: config for training with the Z-neck, since posing it alone does not work
    Setting the head pose on a trained policy makes it topple -- standing the
    head up moves the centre of mass 14.3mm in x on a robot with 60mm feet,
    and the policy was trained around the head-at-zero distribution. The head
    being outside the imitation reward does not make it outside the dynamics.
    So the Z-neck needs its own run. This config is v32 with one thing
    changed: READY_JOINT_POS_H175 with neck_pitch and head_pitch at 0.785.
    lock_head_joints still holds the head, so the policy is still driving ten
    leg joints -- what differs is the mass distribution it learns to balance.
    ./scripts/odm train v33 3000
    ./scrip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
2026-08-06 hw: bring the real robot up — joint calibration, IMU axis map, teleop
    The 14 Dynamixel axes are calibrated (IDs, zero offsets, signs) and the
    BNO055 is awake with its mounting orientation measured. Both are now
    single sources of truth the way joint_order.py is for the sim.
    The trunk frame is +x forward / +y left / +z up. An earlier note claimed
    -x was forward, reasoning from "raising the head moves the CoM -14.3 mm
    and the robot fell forward". The CoM figure reproduces, but that tip was
    a policy collapse rather than a static rollover, so it could not settle
    the axis. Two independent measurements do: under a forward command the
    stance foot drifts -29.8 mm in x (+42.9 mm under backward), an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
    [cad_teleop.py, dxl_bridge.py, export_ref_gait.py, goto_ready.py, imu_check.py, joint_cal.py]
2026-08-06 odm: add teleop and refgait, so the hardware tools work from any directory
    The repo lives on an external SSD and its path contains a space, so
    `python scripts/hw/cad_teleop.py` from the home directory just fails to
    find the file. That happened. Both subcommands cd into the project
    themselves and print the Jetson-side command that has to run first.
    teleop uses ~/.odm-tools (pinocchio, meshcat) rather than the Isaac
    python, which has neither.
    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
2026-08-06 robot: re-import the finished CAD — 2.7140 kg, and a clean import log
    The mass is real now: densities replace the old overrides, so mass and
    inertia come from the same source. Every link's radius of gyration lands
    between 0.42 and 0.56 of its mesh radius, tightly clustered — the
    signature of consistent density, and the thing that goes wrong when only
    mass is overridden. Total is 2.7140 kg against the CAD's 2.7152 (+1.2 g).
    Getting here took three imports, and the first two each found something:
    * config.json pointed at a stale *workspace* of the same document. Same
    document and element id, different w/ — so the URL looked unchanged
    while the geometry was months old. Fixed t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
    [bno055.stl, body_bottom.stl, body_front.stl, body_tail.stl, body_top_left.stl, body_top_right.stl, extrude___annular_rings.stl, foot_top.stl]
2026-08-06 robot: real appearances from CAD, and bring the import onto this machine
    45 of the 56 parts had been sitting on onshape-to-robot's default lavender;
    they now carry the colours set in CAD — pink body, dark grey legs and
    motors, near-black battery and boards. Geometry is untouched: mass, link
    set, joint origins and joint limits all diff to zero against the previous
    import, so only the rgba values moved.
    The import no longer needs the lab PC. onshape-to-robot lives in
    ~/.odm-tools and the API keys in ~/.onshape_env (mode 600), copied over
    from do@192.168.137.111. Running the same workspace on both machines
    produces identical output — 2.7140 kg, zero differences across links,
    joint origins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
    [robot.urdf]
2026-08-06 docs: rewrite the README as a front door, and fix the placo URDF sync
    The README pointed at four scripts that no longer exist — convert_urdf.sh,
    generate_reference_motion.sh, train.sh, play.sh all moved or were replaced
    by `odm` months ago. Anyone following it hit a wall on the first command.
    It also predates everything about the real robot.
    The rewrite leads with the `odm` table, since that is genuinely how the
    work gets done, then walks the pipeline in order: CAD import, reference
    gait, training, evaluation, hardware. Added a spec table for the facts a
    newcomer needs before touching anything — mass, frame convention, joint
    order, IMU — each pointing at its single source of truth. Ev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
    [bno055.stl, body_bottom.stl, body_front.stl, body_tail.stl, body_top_left.stl, body_top_right.stl, extrude___annular_rings.stl, foot_top.stl]
2026-08-06 ref: generate ref_h193 for the 2.7140 kg robot
    walk_com_height is a CoM height, and the CoM moved up 17.9 mm relative to
    the trunk when the new CAD put more mass in the body and head. Feeding it
    the old 0.175 would have crouched the robot by that much, so this is 0.193.
    The realised body height comes out at 145.8 mm against 137.1 for ref_h175.
    Generated with --yaw-sweep 0.28, which docs/training_log.md asked for the
    next time this was regenerated: the default grid (-0.3..0.3 by 0.07) steps
    over zero, so no command had a sign-flipped twin and straight-ahead was
    never actually in the reference.
    Claude-Session: https://claude.ai/code/sessi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
2026-08-06 ref: sweep body height 105-125 mm, and settle the IMU orientation question
    Five references on an exact 5 mm grid of body-bottom ground clearance,
    plus the three off-grid ones from the first attempt. Measured heights land
    within 1.4 mm of target (103.6 / 109.8 / 114.9 / 120.0 / 125.0).
    The first attempt missed the grid because it interpolated walk_com_height
    from ref_h175, which was planned for the 2.3388 kg robot. placo takes the
    CoM from the URDF's link masses, so the same walk_com_height puts a
    differently-massed robot in a different pose; the two are not on one curve.
    Refitting on new-robot points only, and the relation turns out nonlinear —
    about 0.47 mm of body height per mm of CoM t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
2026-08-06 v33n: train the new robot on ref_g115, and put the status on the README
    v33n is v33 with only the robot and the gait swapped. v33 itself stopped at
    iter 663, but its curves were healthy — no warnings, +24.8% over the last
    500 iters, ahead of v32 at the same point on both reward and episode
    length. The Z-neck pose was never the problem. It just cannot be resumed:
    the robot gained 16% mass and the IMU moved 41 mm, which changes the
    observation, so anything trained before 815cead no longer matches the
    config.
    reference ref_h175 (planned for the 2.3388 kg robot) -> ref_g115
    robot 2.3388 -> 2.7140 kg
    READY measured, not guessed: settle 138.3 mm from a 200 mm drop,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
    [robot.urdf]
2026-08-07 v34c: hold the gait phase at zero command, so standstill can be still
    Deployment needs the robot to stand still when told to stop, and v33n does
    not — measured at -0.019 m/s backward drift on a zero command. Three things
    were behind it, and this commit changes only the structural one.
    reward_imitation is already fully gated off at standstill (`* (cmd_norm >
    0.01)`), so nothing was pulling the robot toward the reference. But the
    observation's imitation_phase kept turning, because the phase advanced
    regardless of command. The policy was handed a rotating signal with no
    stable "this is standstill" input, and the only thing holding the pose was
    cost_stand_still at -0.2 — a thirtieth of imit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
2026-08-07 v34c10: standstill holds and tracking beats v28, at 139 mm body height
    Four runs, in the order the user asked for — standstill first, tracking
    second. Result: v34c10 wins both, and its tracking of 0.0166 m/s is the
    first to beat v28's 0.0171, which had stood as the project's best.
    v34c phase held at zero command standstill 0.0192 -> 0.0070
    v34c2 + stand_still_scale x5 standstill 0.0139 (worse)
    v34c10 v34c + reference +10 mm standstill 0.0058, tracking 0.0166
    v34c20 v34c + reference +20 mm standstill 0.0162, tracking 0.0228
    The structural fix carried it. reward_imitation is already gated off at
    standstill, but the observation's gait phase kept turning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
2026-08-08 Add Rust(rustypot) 기반 실기 배포 파이프라인, neck/head_pitch 부호 수정
    - scripts/hw/rustypot_hwi.py, rl_walk.py, feet_contacts.py, estop.py 신규:
    dynamixel_sdk 대신 rustypot(Rust+PyO3)으로 14축 제어, 발 접촉 스위치를
    관측벡터에 연결, RL 정책 실기 배포 루프, 독립 비상정지 스크립트.
    - 다리 10축만 SyncRead(get_leg_pos_vel)해 루프를 28.8Hz -> 37Hz로 개선
    (머리 4축은 lock_head_joints=true라 정책이 안 씀).
    - neck_pitch(ID2)/head_pitch(ID12) 부호를 실기 Z넥 수평유지 테스트로 재확인해
    반전 (joint_calibration.json, dxl_bridge.py, goto_ready.py, play_ref_gait.py).
    [dxl_bridge.py, estop.py, feet_contacts.py, goto_ready.py, play_ref_gait.py, rl_walk.py, rustypot_hwi.py]
2026-08-08 CAD 질량 갱신(2.7430 kg) + 정지 시 몸통 수직 리워드(v35) + ONNX 익스포터
    body tail 실측 113 g 을 OnShape 밀도(1352.7 -> 1820.6 kg/m^3)로 반영하고
    재임포트했다. 로봇 총질량 2.7140 -> 2.7430 kg, 전체 CoM 이 뒤로 1.06 mm.
    USD 를 백업본과 대조해 그 외에는 아무것도 안 바뀌었음을 확인했다.
    임포트가 로컬 수정을 덮어쓰는 문제를 고쳤다. head_pitch 한계 ±50도가 CAD 의
    ±45도로 되돌아갔는데, 시뮬은 URDF 가 아니라 USD 에서 한계를 읽으므로 재변환
    전에는 티도 안 난다. apply_local_urdf_overrides.py 에 표로 모아 파이프라인에
    묶었다(멱등). patch_urdf_for_placo.py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
    [open_duck_mini_v2.urdf, part_1__3.stl, robot.urdf]
2026-08-08 v35 결과 기록 — 정지 시 몸통 수직 달성 (+14.73° -> +0.63°)
    정지 자세를 중력벡터로 직접 벌하는 항이 통했다. 같은 iter 에서 v34c10 이
    +14.73 도인데 v35 는 +0.63 도이고, 정지 속력도 0.0058 -> 0.0030 으로 같이
    좋아졌다. 무릎을 더 굽히지 않고 얻었다 (정지 높이 125.5 vs 125.9 mm).
    대가는 추종 0.0166 -> 0.0206 과 에피소드 778.7 -> 683.8 이다. 총 리워드가
    426.2 -> 375.3 으로 낮아 보이지만 스텝당으로는 v35 가 오히려 높다 — 차이는
    전부 에피소드 길이에서 온다.
    standstill_pose.py 의 꼬리말 부호 설명이 반대로 적혀 있던 것을 고쳤다.
    그대로 두면 +14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
2026-08-08 지형 프리셋 17종 + 재생/측정에서 지형 바꾸기
    학습은 전부 terrain_type="plane" 에서 돌았고 관측에 지형을 보는 수단이 하나도
    없다(height scan 도 ray caster 도 없음) — 완전한 blind 정책이다. 그래서 "평지가
    아닌 데서 되나" 는 재봐야 아는 질문이라 도구를 만들었다.
    odm play v35 --terrain hills_s --joystick 눈으로
    scripts/diag/terrain_test.py --terrain ... 수치로 (넘어짐/속도오차/피치)
    정의는 source/.../terrains.py 한 곳에 두고 둘이 공유한다. 두 벌로 두면 재생과
    측정이 갈라진다.
    스케일이 핵심이다. IsaacLab 의 ROUGH_TERRAINS_CFG 기본값은 계단 5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
2026-08-08 잿슨 에이전트에 넘긴 것 기록 + 배포 문서를 v35 기준으로 갱신
    문서가 v34c10 기준으로 쓰여 있었는데 실제로 넘긴 정책은 v35 다. 관측/액션
    계약은 둘이 완전히 같아 본문은 그대로 유효하고, 전달 목록(0절)과 성능(8절)만
    갱신했다.
    0절: 넘긴 파일 두 개의 크기·sha256, 출처 체크포인트, 재생성 명령. logs/ 가
    gitignore 대상이라 ONNX 는 레포에 없으므로 파일로 옮겨야 한다는 점을 적었다.
    8절: v35 수치로 교체. 정지 속력 0.0058 -> 0.0030, 정지 몸통 피치 +14.73 ->
    +0.63 도, 대가는 추종 0.0166 -> 0.0206. 리워드가 낮아 보이는 것이 착시(스텝당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
2026-08-08 rl_walk.py를 docs/handoff/onnx_deploy_2026-08-08.md 배포 계약 대조 검증 후 수정
    joystick_env.py/joystick_env_cfg.py 소스와 직접 대조해 3개 불일치 발견·수정:
    - READY_JOINT_POS: joint_order.py의 7/28자 구버전(Z넥 이전) 대신
    READY_JOINT_POS_G125_ZNECK 사용 — 다리 관절이 최대 26도까지 어긋나 있었음
    - GAIT_PERIOD_STEPS: 50 -> 27 (ref_g125 실제 주기, 0.54s@50Hz)
    - standstill_hold 추가: 정지 명령(||command[:3]||<=0.01)에서 imitation_phase를
    (1,0)에 고정 — 안 하면 정지 중에도 위상이 계속 돌아 학습 때 없던 입력이 됨
    교차검증해서 문제 없음을 확인한 것: 관측벡터 107차원 순서/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
    [rl_walk.py]
2026-08-08 SyncRead 응답 손상 시 재시도하도록 방어 코드 추가
    실기 rl_walk.py 첫 실행에서 램프인 직후 첫 combined SyncRead(get_leg_pos_vel)
    가 struct.error로 죽음 — 축 하나의 응답이 8바이트가 아니었다(재현은 못 했으나
    버스 전환 시점 일시적 충돌로 추정). 매 루프 도는 get_present_pos_vel /
    get_leg_pos_vel 을 공용 헬퍼(_sync_read_pos_vel_raw)로 묶어 응답 길이가 안
    맞으면 최대 2회 재시도, 그래도 안 되면 명확한 RuntimeError로 던지게 함(조용히
    stale 값 쓰는 것보다 멈추는 게 안전).
    [rustypot_hwi.py]
2026-08-08 왼발/오른발 발접촉 스위치 GPIO 핀 라벨 반대였던 것 수정
    29=left/31=right로 가정했는데 실기 확인 결과 반대(사용자 확인, 2026-08-09).
    LEFT=31, RIGHT=29로 수정. rl_walk.py는 이 모듈을 통해서만 접촉을 읽으므로
    자동으로 같이 고쳐짐.
    [feet_contacts.py]
2026-08-08 rl_walk.py에 스텝별 CSV 로깅 추가 (오른다리 hip_roll/yaw 벌어짐 사후분석용)
    실기에서 오른다리(hip_roll/yaw)가 왼다리와 다르게 움직이며 벌어지는 현상 발견
    (손 부호검증은 통과 — 부호 문제 아님). 원인 파악하려고 매 스텝 14축
    위치/속도/액션/목표각 + 접촉/자이로/위상을 ~/rl_walk_log.csv에 남기도록 함
    (매 실행마다 덮어씀). TTY 게이트 때문에 실행 자체는 사용자가 직접 해야 해서,
    실행 후 로그를 분석하는 방식으로 대체.
2026-08-08 rl_walk.py CSV 로그에 accel/projected_gravity 추가
    오른다리 hip_roll/yaw 벌어짐이 실제 몸통 기울어짐(비수직)에 대한 v35의
    upright_standstill 반응인지 확인하려면 gyro만으론 부족하다 (정적 기울어짐은
    각속도가 아니라 가속도/projected_gravity에 나타남). 다음 실기 테스트부터 확인
    가능.
2026-08-08 몸통 떨림 억제용 액션 저역통과 (기본 꺼짐) + 좌우 대칭 감사
    떨림: 액션에 1차 EMA 를 건다 (cfg.action_lowpass_alpha, 기본 0 = 기존 동작
    그대로). 기존 속도 제한(max_motor_velocity*dt = 0.0964 rad/step)은 큰 도약만
    막고 그 안에서 매 스텝 부호가 바뀌는 떨림은 통과시키므로 따로 필요하다.
    필터를 액션 쪽에 걸어 고관절 클램프와 속도 제한이 필터 뒤에 오게 했다 —
    순서를 바꾸면 필터가 안전 한계를 다시 넘길 수 있다. 리셋 때 상태도 지운다.
    재생에서 바로 시험: odm play v35 --smooth 0.6
    50 Hz 기준 -3 dB 차단은 alpha 0.3->11 Hz, 0.5->5.8 Hz, 0.7->2.9 Hz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
2026-08-08 좌우 대칭 측정 + 저역통과 alpha 스윕 도구
    leg_symmetry.py — 정지/보행 중 정책이 실제로 내는 좌우 관절각을 FK 로 확정한
    거울 규칙(right = -hip_yaw, +hip_roll, +hip_pitch, -knee, -ankle) 아래서 잰다.
    env 별 편차도 같이 내서 "평균이 어긋남" 과 "환경마다 다른 자세로 수렴" 을 가른다.
    결과가 명확하다. **보행은 거의 완벽히 대칭(모두 1.03도 이내)인데 정지가 크게
    비대칭이다** — 무릎 15.2도, hip_roll 12.3도, ankle 11.4도. hip_roll/knee 는
    env 별 표준편차가 2.0~2.3도로 좁아서, 무작위가 아니라 32개 환경이 전부 같은
    쪽으로 치우친 **일관된 편향**이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
2026-08-08 v36 (정지 좌우대칭 + 학습에 포함한 저역통과) + 교수님 보고서
    v36 = v35 + leg_symmetry_scale -3.0 + action_lowpass_alpha 0.5.
    한 번에 둘을 바꾸지만 읽는 지표가 달라 사후 귀속이 된다 — 대칭은 관절각
    어긋남으로, 필터는 몸통 각속도 RMS 로.
    거울 규칙을 joint_order.LEG_MIRROR_SIGN / LEG_MIRROR_PAIRS 로 승격했다.
    URDF 에서 FK 로 32가지 부호 조합을 전수 탐색해 얻은 것이고, 그 규칙에서
    모델 자체는 대칭이다(발 위치 오차 0.5 mm, 좌우 질량 동일). hardware_map 의
    "hip_yaw 만 좌우 같은 부호"는 모터 회전 방향 이야기라 별개다 — 주석에 적었다.
    cost_leg_symm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
2026-08-08 보고서 정정 — 떨림은 실기에서 관측·측정한 것이다
    내가 "아직 실기 배포 전, 관찰은 전부 시뮬 기준" 이라고 잘못 적었다. 실제로는
    v35 ONNX 가 이미 잿슨에 올라가 있었고(~/policy_v35), 떨림은 실기에서 본 것이다.
    교수님께 드릴 문서라 사실관계를 바로잡았다.
    잿슨의 ~/rl_walk_log.csv (359 샘플, 10초, 전 구간 정지) 를 분석해 실측을 넣었다:
    몸통 각속도 |w| 평균 0.2592 rad/s (RMS 0.3216) — 시뮬 0.1819 의 1.43배
    액션 방향 반전 68.3% — 백색잡음이면 50% 이므로 능동 진동(음의 자기상관)이다
    관절별로는 발목 77.8% / 고관절 yaw·roll 74.1%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
2026-08-08 SyncRead 응답 손상 재발 — latency_timer 1->2ms 절충, 재시도 2->6회
    FTDI latency_timer를 16->1ms로 낮춘 뒤 응답 손상(struct 8바이트 안 맞음)이
    훨씬 잦아졌다 — 낮은 타이머가 패킷을 USB 전송 여러 개로 쪼개 보내는 빈도를
    늘린 것으로 추정. Jetson 쪽 sysfs+udev 규칙은 2ms로 절충 적용(코드 밖,
    직접 조정), 여기서는 재시도 예산만 늘려 안전마진을 더 뒀다. 200회 연속
    호출 스트레스 테스트로 완전실패 0회 확인.
2026-08-08 docs/reports/lowpass_2026-08-09.md 반영: 정지 전용 액션 저역필터 옵션 추가
    --action-lpf-alpha 로 1차 EMA 필터(a_f=α·a_f_prev+(1-α)·a)를 target 계산에만
    적용. last_act(obs 이력)은 raw action 그대로 둠 — v35는 필터 없이 학습돼서
    관측 이력까지 필터링하면 학습 때와 다른 입력이 된다.
    보고서 실험 A 근거: 정지(vx=vy=wz=0)에서는 대가 없이 떨림 감소(0.5~0.8
    alpha 추천), 전진 명령에서는 추종이 단조롭게 나빠짐 — 그래서 vx/vy/wz가
    0이 아니면 경고를 찍는다. v36(필터를 학습 자체에 포함시킨 버전, 현재
    759/3000 iter 진행 중)이 나오면 이 옵션은 더 이상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
2026-08-08 Input Voltage Error 자동 reboot+복구 추가
    램프인 직후 첫 hw_error 체크에서 여러 축(매번 다른 조합)에 Input Voltage
    Error(bit0)가 반복 재현됨 — 전압 자체는 재보면 14축 다 11.7~11.8V 정상이라
    급격해진 다축 동시 가감속의 역기전력 스파이크가 래치되는 것으로 추정
    (latency_timer 를 낮춰 루프를 빠르게 만든 부작용). reboot 로 풀리는 걸
    확인해서 자동화: bit0 단독인 축만 reboot 후 arm() 과 같은 순서로 재설정,
    다른 비트(과열/과부하/전기충격/인코더)가 섞였으면 그대로 정지.
    실기에서 실제 걸려있던 7축으로 종단 테스트 — 전부 복구, 재확인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
    [rl_walk.py, rustypot_hwi.py]
2026-08-08 관절 한계 포화 진단 + 저역통과를 정지에만 거는 v37
    잿슨측 보고서(docs/reports/joint_saturation_2026-08-09.md)가 실기에서
    left_hip_pitch 목표가 92% 의 스텝에서 URDF 한계 70도를 넘고(최대 81.2도)
    실기 코드가 그걸 잘라내고 있었음을 밝혔다. 즉 내가 "모터 처짐" 으로 본
    -6.77도는 모터가 못 간 거리가 아니라 우리가 잘라낸 양이었다 — 모터 모델
    가설은 틀렸다.
    그쪽이 물은 "시뮬도 포화하는가" 에 답하려고 joint_saturation.py 를 썼다.
    _motor_targets 를 USD 관절한계와 대조한다(실기는 URDF 를 읽지만 시뮬은 USD 에서
    읽으므로 USD 값을 자로 쓴다).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
2026-08-08 odm onnx 서브커맨드 + 중단된 v37 런 표시
    odm onnx <버전> [iter] 로 실기용 ONNX 를 뽑는다. Isaac Sim 을 안 띄우므로
    require_free_gpu 를 걸지 않았다 — 학습 중에도 돌아간다.
    포화 측정하려고 v37 을 3분 만에 멈췄다 재시작해서 런 디렉터리가 두 개 생겼다.
    지우지 않고(기존 런 삭제 금지) 중단분에 _ABORTED_3min 을 붙여 표시했다.
    odm 의 latest_run 은 ls -dt 라 원래도 최신(진짜 런)을 골랐지만, 텐서보드에
    v37 이 두 개 뜨면 나중에 판정이 틀어진다.
    Claude-Session: https://claude.ai/code/session_01Ktvp75ksqEpSsRvABxjE7i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
2026-08-08 저역필터 α를 정책 메타파일에서 자동으로 읽도록
    v36 부터는 action_lowpass_alpha=0.5 가 학습 환경에 들어가 있어서(플랜트의 일부)
    실기도 반드시 같은 값으로 켜야 한다 — v35 처럼 "정지 전용 옵션"이 아니다.
    매번 CLI 로 손으로 맞추면 언젠가 깜빡하고 조용히 train/test 불일치가 나므로,
    정책 옆 policy.meta.json 의 값을 기본값으로 읽는다. CLI 로 주면 그게 이기되
    메타와 다르면 경고. 명령 기반이던 기존 경고는 v36 에 대해 반대로 작동해서
    "학습 알파를 알 수 없는 정책" 조건으로 교체.
2026-08-08 머리 3축 PID: D=0 -> D=2000 (떨림 원인이 감쇠 부족이었음)
    2026-08-08 에 head_roll 떨림을 P=800->200 / D=4700->0 으로 잡았다고 봤는데
    틀렸다. 평형 위치에서만 확인해서 조용해 보였을 뿐, D=0 은 감쇠가 아예 없는
    것이라 런 중 몸통 진동이 외란으로 들어오면 크게 출렁인다.
    계단응답 실측(+100tick, 정착 후 잔여 변동):
    P=200/D=0 P=200/D=2000 P=800/D=4700(공장)
    head_pitch 9 tick 1 tick 1 tick
    head_yaw 66 tick 0 tick 1 tick
    head_roll 95 tick 1 tick 3 tick
    P=200/D=2000 이 세 축 모두 최소. 공장값도 안정적이지만 강성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
2026-08-08 정지 레퍼런스가 없던 문제를 격자에서 고침 + 외란 극복 측정 도구
    뿌리를 찾았다. 정지 명령 (0,0,0) 의 모방 목표가 **전진 보행 궤적**이었다.
    PolyReferenceMotion 으로 확인: get_reference_motion(0,0,0) 과 (0.10,0,0) 이
    allclose 로 완전히 같다. dy 격자가 [-0.03,-0.01,0.01,0.03] 로 0 을 빠뜨려서
    (0,0,0) 이 녹화 없는 칸으로 스냅되고, 동점 후보 중 dx=0.074 칸으로 대체된
    결과다.
    게다가 standstill_hold 가 고정하는 위상 0 이 하필 가장 비대칭한 프레임이다:
    hip_roll 좌 -7.69 / 우 +5.50 = 13.19도 벌어짐. 그래서 정지에서 정책이 붙들고
    있는 목표가 "걷는 중 한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
2026-08-08 정지 좌우 비대칭의 진범을 찾음 — hip_inward 가 정지에서도 산다 (v38)
    앞서 "정지 레퍼런스가 전진 보행이라 hip_roll 이 비대칭" 이라고 쓰면서 경로를
    imitation 으로 암시했는데 **그건 틀렸다.** reward_imitation 은 정지에서 완전히
    꺼진다 (rewards.py:242, `* (cmd_norm > 0.01)`).
    진짜 경로는 hip_inward 다. 이 항은 레퍼런스를 기준으로 고관절 4축
    (L/R yaw·roll)이 안쪽으로 3도 넘게 벗어나는 것을 벌하는데 **cmd_norm 게이트가
    없어 정지에서도 산다.** 그리고 정지에서는 standstill_hold 가 위상을 0 에 묶으므로
    그 기준이 "걷는 중 한쪽 발을 든 순간" 이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
2026-08-08 필터 대신 진동을 리워드로 억제 — 액션 2차차분 벌점 (v39)
    사용자 지적대로 필터는 증상을 가리는 도구였다. 근거가 우리 데이터에 이미 있다:
    필터로 학습한 v36 의 **원시 액션 요동이 0.0638 로 무필터 v35(0.0537)보다 컸다.**
    필터가 결과를 흡수해 주니 정책이 거칠어져도 대가를 안 치른 것이다.
    왜 기존 action_rate 로 진동이 안 잡혔는지도 구조적 이유가 있다. 그건 1차차분이라
    "빠른 움직임" 을 벌한다 — 진동이든 정상 보행이든 똑같이. 2차차분은 방향이
    뒤집힐 때만 커지고 매끄러운 궤적에서는 정확히 0 이다:
    매끄러운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
2026-08-08 저역필터 알파에 명령 기반 블렌드 지원 (v37 대응)
    v37 은 alpha 를 정지 0.7 / 보행 0.0 으로 가르고 ||cmd|| 0.01~0.05 구간에서
    smoothstep 으로 섞는다(JoystickEnvCfg_V37). 지금까지는 상수 알파만 지원해서
    v37 을 그대로 올리면 보행/정지 중 한쪽이 반드시 학습과 어긋났다.
    joystick_env._pre_physics_step 과 같은 공식을 policy.meta.json 의
    action_lowpass_alpha / _standstill / _blend 로부터 계산한다. 명령이 실행 중
    고정이라 루프 진입 전 한 번만 구한다. CLI 로 주면 그게 이기되 학습값과 다르면
    경고. v36(상수 0.5)은 a_still=a_move 로 자연히 같은 경로를 탄다.
2026-08-08 Input Voltage Error 자동 reboot 제거 — 보행을 망가뜨리던 원인
    Shutdown 레지스터(addr 63)를 읽어보니 이 로봇은 0b00110100 = 과열/전기충격/
    과부하 뿐이고 **Input Voltage(bit0)가 빠져 있다.** 즉 그 비트는 토크를 끊지
    않는 정보성 상태였는데, 어제 그걸 위험 신호로 보고 서보를 reboot(+0.3s sleep)
    하게 만들었다.
    실기 보행 로그에서 그 대가가 그대로 찍혔다: 1초에 한 번꼴로 ~400ms 씩 제어
    루프가 멈춤(t=1.04/2.04/3.50/4.51/5.95/7.78/8.79/9.79, p99=397ms). 그 동안
    마지막 목표각에 굳어 있다가 낡은 상태로 재개되기를 반복 — 로봇이 발을 구르며
    주저앉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
    [rl_walk.py, rustypot_hwi.py]
2026-08-09 docs: v36~v39 학습 로그 — 필터 제거 + 진동 벌점 결과, 모터 토크 최초 실측
    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
2026-08-09 feat(v40): action_rate -0.5 -> -0.25 — 진동은 jerk 가 맡으므로 이중과금 해소
    v39 가 떨림은 잡았으나(action_rate 비용 -45%) 추종을 0.0120->0.0197 로 내줬다.
    매끄러움 예산이 v37 -0.0304 에서 v39 -0.0371 로 22% 늘어난 만큼 빠진 것이다.
    1차차분은 '빠른 움직임'을, 2차차분은 '진동만' 벌하므로 jerk 가 있는 이상
    action_rate 는 추종에 필요한 이동까지 이중과금한다.
    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
2026-08-10 feat(odm): --lpf 로 어느 서브커맨드에서든 액션 저역통과를 걸 수 있게
    필터를 걸어보고 싶은 곳이 play·measure·diag 일곱 군데라, 스크립트마다
    --smooth 를 심으면 task_registry 주석이 경고하는 '여섯 군데 복제'를 반복하게
    된다. 설정 인스턴스를 만드는 길목인 env_cfg_for() 한 곳에서만 덮어쓴다.
    보행용과 정지용 alpha 를 함께 덮는 게 핵심. v37 에서 정지용이 분리된 뒤로
    보행용만 바꾸면 v39·v40 처럼 정지 alpha 가 0.0 인 정책에서는 정작 떨림을
    보려는 정지 구간에 필터가 안 걸린다. play_fixed_cmd.py 의 --smooth 도 같은
    구멍이 있어 함께 고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
2026-08-10 docs: v40 실기 주저앉음 원인 분석 — 전류 상한 2.4배 부족 + 중력 관측 오염
    잿슨 rl_walk_log.csv 237 스텝 분석. 로봇이 0.5 s 만에 뒤로 주저앉았고
    무릎 목표-실제 오차가 단조로 41도까지 벌어졌다.
    원인 1: current_limit 350 unit = 0.94 A -> 약 1.68 N.m 인데 심의
    effort_limit_sim 은 4.1. 심에서 잰 보행 무릎 토크 99% 가 3.39 N.m 로
    실기 천장의 두 배다.
    원인 2: projected_gravity 를 생 가속도 정규화로 만들고 있다. 접지 충격이
    그대로 섞여 64.6% 스텝이 9.81 에서 1 m/s^2 넘게 벗어나고 피치가 20 ms 에
    최대 35도 튄다. BNO055 가 이미 NDOF 융합 중이라 GRV_DATA(0x2E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
    [rl_walk_v40_2026-08-10.csv]
2026-08-10 docs: 잿슨 에이전트용 작업지시서 — 중력 관측 수정 + 전류 상한 시험
    두 수정을 따로 넣고 각각 로그를 남기도록 순서와 합격 기준을 숫자로 박았다.
    전류는 코드 기본값을 놔두고 실행 인자로만 올리게 하고, 매달아 놓기·10초 제한·
    55도 중단 같은 안전 조건을 명시했다.
    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
2026-08-10 docs: 잿슨 배포 코드 검증 — 12 항목 일치, 액션 이력 한 칸 불일치
    v40 이 실제 학습에 쓴 params/env.yaml 을 기준으로 rl_walk.py 를 대조했다.
    관측 13 블록의 순서·차원, READY 자세 14축(0.000도 차), 스칼라 상수, 머리
    명령 범위, 고관절 클램프/안전필터 비활성, motor_targets 와 위상의 시점까지
    전부 일치한다.
    불일치 1건: 심은 관측을 조립한 뒤(444행) 액션 이력을 밀어서(515행) 관측이
    담는 last_act 가 '그 전 액션'인데, 잿슨은 추론 직후 밀어서 '직전 액션'이
    들어간다. 관측 107 칸 중 42 칸이 축당 0.21(액션 크기의 24%) 어긋난다.
    한 칸 지연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
    [joint_step_left_knee_2026-08-10.csv, rl_walk_v40_pwm_2026-08-10.csv]
2026-08-10 feat(v41): 액추에이터를 DCMotor 로 — 토크-속도 결합을 심에 넣는다
    ImplicitActuatorCfg 는 effort_limit(4.1)과 velocity_limit(4.82)을 서로
    독립으로 걸어서, 심의 다리가 '4.1 N.m 를 내면서 동시에 4.82 rad/s 로'
    움직일 수 있었다. 실제 DC 모터는 그 조합을 못 낸다.
    2026-08-10 실기가 이걸 짚었다: 전류 상한을 700 틱으로 올려 토크 포화를
    0% 로 없앤 뒤에도 무릎이 지령 4.84 rad/s 에 실측 3.53 에서 막혔다.
    같은 무릎이 무부하에서는 4.41 (한계의 92%) 을 낸다. 토크-속도 직선
    사용률이 81~99% 인 축이 곧 뒤처지는 축이고, 오차 없는 hip_yaw 는 51/57% 다.
    DCMotor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
2026-08-10 fix(v41): 연속토크 3.36 -> 3.16 — 무부하 전류를 빠뜨렸다
    ROBOTIS 공식 성능그래프를 보면 토크 0 에서도 전류가 약 0.27 A 흐른다
    (마찰·철손). 토크는 전류에 단순 비례하지 않고 tau = k(I - I0) 다.
    그래프 두 점 (0.05, 0.27), (3.05, 1.80) -> k=1.96 N.m/A, I0=0.27 A
    검산: I=2.3 A -> 3.98 N.m (스톨 규격 4.1 과 일치)
    700 틱 1.883 A -> 3.16 N.m (단순 비례로는 3.36 이었다)
    하필 그 6% 가 실제 곡선이 급격히 처지기 시작하는 구간이라, 낙관하면
    v40 과 같은 종류의 갭이 남는다.
    BAM 교차검증도 함께 기록: BAM 의 damping 1.352 (= kt^2/R 0.505 + 점성마찰
    0.847) 는 무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
2026-08-10 docs: stiffness/kt 1.95배 불일치를 가르는 정적 부하 시험 지시서
    스텝응답으로는 못 가른다는 걸 먼저 수치로 확인했다. kt 가 2배면 stiffness 는
    2배(kt/R)인데 damping 은 4배(kt^2/R)라 지배극점 k/c 가 27.8->26.3 으로 5%만
    변한다. 상승시간 72.5 vs 82.6 ms 이고 부호도 반대다(강성 큰 쪽이 느림).
    주파수응답도 4.9 vs 4.6 Hz 로 같다.
    전류로 토크를 재는 것도 순환논법이다 (tau = kt*I 인데 kt 가 다투는 값).
    그래서 질량과 팔길이로 토크를 정하는 정적 시험으로 설계했다:
    k = m*g*L / 정착오차 (kt 안 들어감)
    kt_eff = m*g*L / dI (덤으로 1.95배 문제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
2026-08-10 fix(docs): stiffness 후보를 37.65 vs 26.1 로 정정 — kt 단독이 아니라 kt/R
    초판에 'kt 가 2배면 stiffness 도 2배' 라고 적었는데 틀렸다.
    stiffness = 75 x (kt/R) 라 비율에만 의존한다. R 을 고정으로 놓은 잘못된
    추론이었다. 제대로 풀면 ROBOTIS 규격 쪽이 더 무른 26.1 을 가리킨다
    (kt/R = (4.1+0.076)/12 = 0.348). 방향이 반대다.
    두 파라미터 세트 모두 자기일관적이라는 것도 적었다 — 각자의 스톨과
    무부하 속도가 맞아떨어진다. 차이는 BAM 이 스톨을 47% 세게 본다는 것.
    예상표를 추 질량/팔길이별로 다시 만들고, 두 점 측정(1.0 과 1.5 kg)으로
    선형성까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
2026-08-10 feat(onnx): policy.meta.json 자동 생성 — 실기 저역통과 알파 불일치 방지
    실기 rl_walk.py 는 저역통과 알파를 정책 옆 policy.meta.json 에서 읽는다.
    알파는 정책마다 다른데(학습 환경에 필터를 넣었는지에 따라) 지금까지 이
    파일을 사람이 손으로 써 왔다. 없으면 rl_walk.py 가 조용히 0 으로 떨어진다 —
    알파 0 인 정책이면 우연히 맞지만 아니면 그대로 train/test 불일치다.
    값은 그 런이 실제로 학습에 쓴 params/env.yaml 에서 읽는다. 설정 클래스를
    import 하면 isaaclab 이 끌려와 이 스크립트가 학습 중에도 돌아간다는 성질이
    깨지므로, 필요한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
2026-08-10 fix(odm): host_ip 가 hostname -I 대신 ip 를 쓴다
    이 PC 에는 Rust 판 hostname 이 깔려 있어 -I 를 모르고 usage 를 뱉는다.
    그래서 텐서보드 주소가 'http://:6006' 으로 찍혔고, 같은 함수를 쓰는
    odm play --stream 의 publicEndpointAddress 도 같이 비어 있었다.
    iproute2 의 ip 로 바꾸고, tailscale(100.x)은 LAN 접속이 안 되므로
    폴백 후보에서 뺐다.
    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
2026-08-10 fix(odm): 네이티브 재생의 DISPLAY 를 하드코딩(:0) 대신 감지한다
    이 PC 는 Wayland 세션이라 XWayland 디스플레이 번호가 로그인마다 올라간다.
    2026-08-10 12:14 세션 재시작 뒤 :0 이 사라지고 :1 이 됐는데 odm play 가
    :0 을 박아 두고 있어서, Isaac Sim 이 뜨긴 뜨면서 GPU 5GB 를 잡은 채
    창만 안 보였다 (로그: Cannot setup ExternalDragDrop without a default window).
    gnome-shell 이 실제로 쓰는 DISPLAY 를 따라가고, 없으면 살아 있는 X 소켓을
    낮은 번호부터 xdpyinfo 로 확인한다. ODM_DISPLAY 로 덮어쓸 수 있다.
    Claude-Session: https://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
2026-08-10 feat: 심 조이스틱 명령을 실기로 중계 (--cmd-udp / cmd_udp.py)
    같은 입력을 심과 실기에 동시에 넣어 갭을 눈으로 보려는 것. 조이스틱은
    데스크톱에 꽂혀 있으므로 심이 읽어 UDP 로 중계한다. 화면의 로봇에 넣는 것과
    같은 값(클램프 뒤)이 나간다.
    UDP 인 이유: 명령은 상태가 아니라 최신값이라 재전송할 이유가 없고, TCP 면
    끊겼을 때 재연결을 기다리며 오래된 명령을 붙들게 된다.
    안전 장치:
    * 워치독 300 ms — 끊기면 (0,0,0). WiFi 단절/심 종료/조이스틱 분리 모두 동일
    * 패드 A 비상정지 비트를 함께 전송, 수신측에서 latch (스스로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
2026-08-10 feat(hw): rl_walk.py 에 --cmd-udp-port — 심 조이스틱으로 실기를 함께 구동
    잿슨에만 있던 rl_walk.py 를 리포에도 넣는다. 지금까지 실기 제어 코드가
    버전관리 밖에 있어서 잿슨 에이전트와 내가 같은 파일을 각자 고치고 있었다.
    패치 6군데 (실기 배포 완료, md5 대조·문법·dry-run 확인):
    * --cmd-udp-port 인자
    * 수신기를 모터 토크 켜기 **전에** 연다 (포트 실패 시 로봇을 안 건드림)
    * 루프 첫머리에서 command[:3] 갱신, estop 이면 break -> 홀드
    * _alpha_for() — 명령이 매 스텝 바뀌므로 저역통과 알파를 다시 계산
    (CLI 로 준 알파는 존중)
    *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
2026-08-10 feat(hw): UDP 명령 수신 상태를 rl_walk 상태줄에 표시
    로봇이 안 움직일 때 '패킷이 안 오는 것'과 '명령이 0 인 것'을 화면만 봐서는
    구별할 수 없었다. 50 스텝마다 찍는 상태줄에 cmd 값과 LIVE/STALE, 수신 통계를
    붙이고, 첫 패킷이 도착하는 순간 한 번 알린다.
    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
2026-08-10 feat(play): 실시간 배속을 상태줄에 표시
    이 루프는 dt 에서 남는 시간만 재우므로 렌더링+오버레이+HUD 가 20 ms 를
    넘으면 조용히 슬로모션이 된다. 그러면 화면의 로봇만 느려 보이고 실기는
    정상 속도라, 같은 정책인데 '심은 천천히 걷는데 실기는 너무 빠르다' 로
    오독하게 된다 (2026-08-10 실제로 겪음).
    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
2026-08-10 feat(hw): 받은 명령을 CSV 에 남긴다 (cmd_vx/vy/wz/stale)
    심은 걷는데 실기는 발을 안 떼는 원인을 추적하려는데, 실기가 실제로 쓴
    명령이 로그에 없어서 '명령이 안 왔다' 와 '명령은 왔는데 정책이 안 걸었다'
    를 구별할 수 없었다. 기존 열은 그대로 두고 뒤에만 붙인다.
    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
2026-08-10 docs+diag: 레퍼런스 격자 구멍 세 가지 — 충전율 55%, 직진 슬라이스 공백, dy=0 부재
    실기 좌우 비대칭과 저속 제자리걸음의 원인이 정책이 아니라 레퍼런스에
    있었다. scripts/diag/ref_symmetry.py 로 언제든 재측정 가능.
    1) 격자 충전율 55% — auto_waddle 속도 필터가 medium 대역(0.05~0.15) 밖
    녹화를 지우는데 스윕은 0.222 까지 돈다. 빠진 칸은 nearest_coeffs 로
    조용히 폴백된다.
    2) 직진 슬라이스에서 dx = 0.0/0.148/0.222 가 전부 빠져 dx=+0.074 하나로
    폴백된다 — 전진 속도를 바꿔도 레퍼런스가 안 바뀐다. 저속 제자리걸음의
    원인이다.
    3) ref_g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
2026-08-10 docs: README 를 2026-08-11 현황으로 갱신
    08-07 에 멈춰 있던 현황 섹션을 v35~v41 과 실기 결과로 다시 썼다.
    실기가 48 Hz 로 정책을 돌리고 앞쏠림이 +35.0 -> +4.87 도로 줄었다는 것,
    이번에 찾은 네 가지(토크-속도 결합 / 레퍼런스 격자 구멍 / 떨림은 필터가
    아니라 리워드 / 학습이 죽던 이유가 세션 SIGKILL), 그리고 다음 할 일
    다섯 가지를 적었다. 조사 보고서 목록도 추가.
    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
2026-08-11 fix(docs): 레퍼런스 비대칭은 폴백만이 아니라 적합도 범인이다
    '대칭을 깨는 것은 적합이 아니라 격자 폴백' 이라고 적었는데 절반만 맞았다.
    직진 슬라이스에서 녹화가 실제로 존재하는 유일한 전진 속도(dx=+0.074)에서
    다시 재니, 폴백이 아닌데도 무릎 +11.1% / hip_pitch +41.0% 로 비대칭이다
    (placo 원본은 +3.3% / +7.7%).
    격자점마다 36 차원을 독립으로 15 차 다항식에 맞추므로 좌우가 서로 다른
    잔차를 갖는 것을 막을 구조가 없다. 격자를 채우는 것만으로는 부족하고
    적합 방식도 좌우를 묶어야 한다는 항목을 다음 할 일 맨 앞에 추가.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
2026-08-11 fix: 레퍼런스 좌우 비대칭의 진짜 원인 세 가지 — float32 캐스팅이 주범
    v35 이후 모든 정책이 물려받은 레퍼런스 비대칭(hip_pitch +41%)의 정체를 찾았다.
    placo 원본 녹화는 +-2% 로 대칭인데 파이프라인이 깨뜨리고 있었다.
    1) fit_poly.py 가 시간축을 float32 로 캐스팅했다. 15차를 t in [0,1) 에서
    맞추는 것은 조건수가 나빠(RankWarning 수백 건) 입력 정밀도가 그대로
    결과에 나온다. 같은 데이터·같은 차수에서
    float32 X : 재현오차 6.883도, 무릎 좌우차 +16.4%
    float64 X : 재현오차 0.786도, 무릎 좌우차 -3.1% (녹화 -1.8%)
    2) poly_reference_m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
2026-08-11 feat(v42): 대칭 레퍼런스(ref_g125sym) + 거기서 유도한 READY
    v35 이후 모든 정책이 좌우 비대칭 레퍼런스를 모방해 왔다. 원인 세 가지를
    전부 고친 새 레퍼런스로 학습한다 (격자 55->100%, hip_pitch 좌우차
    +41.0 -> -2.9%).
    READY 도 함께 바뀐다 — 레퍼런스에서 유도되는 값이라 분리할 수 없다.
    기존 G115 자세는 그 자체가 hip_roll 1.78도 비대칭이었고, 관측이
    joint_pos_rel = pos - READY 라 정책 입력에 그대로 실렸다. 새 자세는 0.18도.
    settle_height 실측: 안착 149.2 mm (표준편차 1.9) -> ready 0.1492 / 스폰 0.1560.
    Claude-S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
2026-08-11 feat(play): --record 로 6방향 순환을 mp4 녹화
    원격에서 보행을 확인할 수단이 없었다 (네이티브 창은 로컬 화면에만 뜬다).
    gym.wrappers.RecordVideo 로 헤드리스에서도 영상이 나오게 하고,
    --record 를 주면 --enable_cameras 를 자동으로 켠다 (rgb_array 렌더에 필요).
    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
2026-08-11 fix(hw): goto_ready 가 정책 메타에서 READY 를 읽는다 + v41 READY 불일치 발견
    goto_ready.py 의 READY 표가 2026-08-08 자 하드코딩이라 학습 설정과 어긋나
    있었다. --policy <폴더> 를 주면 policy.meta.json 의 ready_joint_pos 를 쓴다
    (export_onnx 가 params/env.yaml 에서 뽑아 담는다). 부호·ID·한계는 실기
    확인값이라 그대로 두고 각도만 덮는다.
    실측 차이 (v41 기준):
    neck_pitch / head_pitch 0도 -> 30도 <- 학습은 Z자 목인데 0 으로 보내고 있었다
    left_knee -102.28 -> -100.17
    right_ankle -50.16 -> -46.87
    그리고 더 큰 문제를 찾았다. v41 의 env.yaml READY 가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
    [export_onnx.py, goto_ready.py, track_test.py]
2026-08-11 fix(hw): rl_walk 도 READY 를 정책 메타에서 읽는다 — 하드코딩 재발 방지
    관측이 joint_pos_rel = pos - READY 라 READY 가 학습 설정과 다르면 정책이
    전 관절에서 밀린 관측을 받는다. 2026-08-12 에 실제로 겪었다: 잿슨이 v40
    자세(left_knee -1.5693)를 든 채 v41 정책(-1.7483)을 돌려 무릎 관측이
    10.3도 어긋났고, 정책이 계속 무릎을 펴려 밀어 지령속도가 5.9 rad/s
    (무부하 한계 4.82 초과)까지 갔다. 발이 안 뜨고 몸통이 +16.3도 기울었다.
    주파수 응답 시험으로 하드웨어는 무죄가 확인됐다 (track_test.py):
    좌우 무릎 이득 차이 전 주파수 1~3%, 대역폭 5 Hz,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
    [rl_walk.py]
2026-08-11 fix(hw): track_test 가 URDF 한계 클램프를 미리 경고한다
    사인의 일부가 한계에 잘리면 진폭이 줄어 '모터가 못 따라간다' 로 오독된다.
    2026-08-12: left_hip_pitch 를 한계(+70도) 근처에서 재 이득 0.13 이 나왔는데
    모터는 멀쩡했고 목표의 위쪽 절반이 통째로 잘린 것이었다. 시작 전에
    tick_of 로 양 끝을 미리 통과시켜 보고 잘리면 경고 후 확인을 받는다.
    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
    [track_test.py]
2026-08-11 feat(hw): full_check — 다리 10축 전체 점검을 한 번에
    관절을 하나씩 손으로 재다가 2026-08-12 에 두 번 헛짚었다.
    * left_knee 가 보행에서 지령의 21% 만 내길래 고장으로 봤는데 주파수 응답은
    좌우 1% 차이였다 — 진범은 READY 10.3도 불일치.
    * left_hip_pitch 이득 0.13 도 고장인 줄 알았는데 시작 위치가 URDF 한계
    근처라 사인의 절반이 잘린 것이었다.
    둘 다 비교 대상과 조건이 없어서 난 오독이다.
    축마다 한계여유 / 주파수응답(1.0, 1.85, 3.0 Hz) / 온도·에러를 재고,
    사인이 한계에 잘리지 않게 진폭을 자동으로 줄인다. --policy 로 READY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
2026-08-11 fix(hw): full_check 가 14축을 READY 로 잡아 둔 채 한 축씩 잰다
    예전엔 대상 축만 토크를 켜서 나머지가 흐물거렸다. 사람이 손으로 들고 있어야
    했고, 그러면 부하 조건이 매번 달라져 좌우 비교가 성립하지 않는다.
    이제 14축 전부 토크를 걸고 5초 smoothstep 으로 READY 에 데려간 뒤, 매 스텝
    SyncWrite 한 번에 '대상 축은 사인 / 나머지는 READY' 를 함께 보낸다. 끝나도
    토크를 켜 둔 채 READY 를 유지한다 (놓으면 쓰러지므로).
    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
    [full_check.py]
2026-08-11 fix(hw): full_check 가 결과를 파일로 남긴다 (중단돼도)
    화면에만 찍어서 원격에서 결과를 못 봤다 — 2026-08-12 에 한 번 통째로 날렸다.
    ~/full_check_result.txt (요약) 와 ~/full_check_raw.csv (원시 샘플) 로 남기고,
    Ctrl+C 나 예외로 끊겨도 거기까지는 저장한다.
    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
    [full_check.py]
2026-08-11 feat(hw): clear_err — 하드웨어 에러 래치를 reboot 으로 지운다
    2026-08-12 보행에서 left_knee 가 err=33 (InputVoltage+Overload) 로 토크를
    끊었다. Overload 는 래치라 reboot 전에는 안 풀려 다음 시험을 못 한다.
    bit0(InputVoltage) 단독은 이 로봇 Shutdown 마스크 밖이라 정보성이므로
    건드리지 않고, err>1 인 축만 리부트한 뒤 모드·전류상한을 다시 건다.
    **토크는 켜지 않는다** — 사람이 로봇을 잡고 있을 때 갑자기 힘이 들어가면
    위험하다.
    같이 넣는 진단 도구:
    scripts/diag/sim_freq_response.py 심 액추에이터 주파수 응답 (실기와 같은 정의)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
    [clear_err.py, full_check.py]
2026-08-12 feat(v46): 몸통을 10 mm 더 세운다 (ref_g135sym) — 실기 무릎 사각지대 회피
    2026-08-12 실기 앞쏠림의 원인을 관절 단위로 좁혔다.
    발목·고관절은 정상이다. 앞으로 쏠릴 때 오차가 버티는 방향으로 움직였고
    (left_ankle -4.96도, right_hip_pitch -5.88도) 목표도 되돌리는 쪽으로 갔다.
    하중에 밀린 것은 무릎뿐이다 — left_knee 가 1초 만에 -119도(한계 -120)에
    처박혀 15초 내내 안 나왔고, 목표 -75~-104도에 실제 -118도 고정, 전류
    0.07 A 였다. 결국 Overload(err=33)로 토크가 끊겼다.
    그런데 하드웨어는 무죄다. 두 번 확인:
    * 주파수 응답 (READY -89.65도 중심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
2026-08-12 feat(odm): record 서브커맨드 — 6방향 순환을 mp4 로
    네이티브 창은 이 PC 모니터에만 뜨고, 재생이 실시간의 0.37 배라 화면으로
    속도를 판단하면 틀린다 (2026-08-11 에 '심은 느린데 실기는 빠르다' 로
    오독했다 — 둘 다 27스텝/0.54초로 같았다). mp4 는 실제 프레임 시간으로
    인코딩되므로 실시간 재생이고 원격에서도 볼 수 있다.
    odm record v46 [초] -> ~/odm_out/video/v46_6dir.mp4 (720p H.264)
    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
2026-08-12 fix(hw): clear_err 에 이름 지정 시 강제 리부트 + volt 도구
    통신이 간헐적으로 끊기는 축은 에러 비트가 안 뜨고도 말썽을 부린다
    (2026-08-12: ID 3 left_hip_yaw 이 goto_ready 에서 '응답 없음' 으로 죽었는데
    err 은 1 이었다). 이름을 직접 주면 에러 상태와 무관하게 리부트한다.
    전압을 제대로 읽는 도구도 넣는다 (addr 144, 0.1V 단위). 실측 11.6~11.7V 로
    전 축 정상이었다 — InputVoltage 비트는 과거에 뜬 뒤 래치된 것이지 지금
    문제가 아니다. 리부트한 축만 0 이 되는 것으로 확인했다.
    14축 래치를 전부 지워 깨끗한 상태로 만들었다. 다음 런에서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
    [clear_err.py, volt.py]
2026-08-12 fix(hw): 실기가 심의 42% 토크로 돌고 있었다 + goto_ready 의 2배 오류
    14축 컨트롤 테이블을 처음 전부 덤프해(dump_ctrl_table.py) 왼무릎 처짐의
    원인 후보를 좁혔다. 서보 설정은 무죄다 — Position PID(800/0/4700), Drive
    Mode, Homing Offset, 위치한계, Profile Velocity 가 좌우 완전히 같다. 유일한
    차이는 펌웨어 버전이고 무릎 두 축은 그마저 둘 다 44 다.
    대신 덤프에서 Goal Current 350 틱(0.9415 A)이 나왔다. robot_cfg.py 의
    토크 모델 τ=1.96·(I−0.27) 로 환산하면 1.32 N·m 인데, 심은 3.16 N·m 를
    허용한다(XM430_CONT_TORQUE_700 — 이름 그대로 700 틱 전제). v41 이후 모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
    [dump_ctrl_table.py, export_onnx.py, friction_map.py, goto_ready.py, rl_walk.py]
2026-08-12 fix(hw): 실기 관절이 심보다 1.75배 물렀다 — P 게인 800 -> 1402
    "정책이 명령한 위치에 실제 관절이 덜 간다" 의 원인을 숫자로 잡았다.
    먼저 800/0/4700 이 어디서 오는지: 아무도 쓰지 않았다. Operating Mode 를
    바꾸면 펌웨어가 그 모드에 맞는 게인을 다시 넣는다. 실측(left_knee, 토크
    off) 결과 모드 3/4 는 D=0, 모드 5(전류기반 위치제어, 우리 모드)만 D=4700
    이다. 위치 PID 는 RAM 이라 전원 재인가·reboot 그리고 모드 전환 때마다
    되돌아간다 — 게인은 arm() 이 모드를 쓴 뒤에 걸어야 하고, 순서를 뒤집으면
    조용히 무효가 된다. rustypot_hwi 주석이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
    [rl_walk.py, rustypot_hwi.py]
2026-08-12 fix(hw): 진짜 원인은 전원이었다 — 브라운아웃 가드 추가
    게인·전류상한을 심과 맞춘 뒤(--current 700 --pgain 1402, 관절강성 37.65)
    v46 을 돌린 로그에서 답이 나왔다. t=2.0s 에 전압이 11.3 V -> 8.7 V 로
    무너지고 9 초 끝까지 회복하지 않았다. XM430 최소 동작전압은 9.5 V 다.
    전원은 USB-PD 어댑터의 12 V 프로파일이었고 보통 3 A 가 상한인데, 측정된
    다리 10축 합계가 순간 5.22 A, 평균 2.15 A 였다. 부하를 빼면 11.6 V 로
    회복하니 배터리 방전이 아니라 공급 능력 부족이다.
    이것이 그동안의 증상을 전부 설명한다. 왼무릎이 PWM 100 % 포화인데 전류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
    [rl_walk.py]
2026-08-12 docs: 로그 열이 깨졌다는 서술 정정 (goal_은 rad, err_은 에러비트, pwm_은 정규화 듀티)
    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
2026-08-12 docs: 브라운아웃 결론의 확신 수위를 낮춘다 — 확정과 추측을 가른다
    "이것이 그동안의 모든 증상을 설명한다" 고 적었는데 과했다. 갈라서 적었다.
    확정: 전압이 8.7 V 까지 내려갔고(규격 하한 9.5 V), 무부하로 돌아오면
    11.6 V 로 회복하며, PD 12 V 3 A 는 14축 보행 로봇의 용량에 못 미친다.
    마지막 항목은 로그와 무관하게 성립한다.
    확정 아님: (1) 언제 떨어졌는지 모른다 — 이 런은 VOLT_PERIOD=100 이라 9 초
    동안 전압을 다섯 번 읽었고, t≈0 에 11.2 V, 다음 샘플 t≈2.1 에 이미 8.7 V
    였을 뿐이다. "t=2.0 s 급락" 은 그 사이를 메운 추측이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
2026-08-12 feat(hw): rl_walk 이 시작 자세와 정책 READY 의 불일치를 알린다 + v42 재익스포트
    goto_ready 는 --policy 를 생략하면 '메타가 가장 최근인' 정책을 고른다.
    정책을 새로 뽑을 때마다 그 선택이 바뀌므로, goto_ready 를 A 로 돌려 놓고
    rl_walk 를 B 로 켜는 실수가 나기 쉽다. 그러면 램프인 3 초가 그 차이를
    메우면서 로봇을 확 주저앉힌다 — 오늘 goto_ready 의 TICK_RAD 버그로 겪은
    것과 같은 종류의 사고다.
    rl_walk 가 토크를 켜기 전에 현재 자세와 이 정책의 READY 를 비교해서 15°
    넘게 다른 축을 찍는다. 쓰러져 있으면 정상이지만 서 있는데 뜨면 got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
2026-08-12 docs: 전원 교체 후 확정 — 무릎 비대칭은 존재하지 않았다
    전원만 바꾸고 v46 을 그대로 다시 돌렸다. 전압 최저 8.6 -> 11.2 V, 다리
    합계 전류 최대 5.22 -> 10.12 A, 접지 전환 1.56 -> 8.26 /s, pitch 범위
    ±34° -> -0.4~+16.9°, hw_error 1 -> 0.
    핵심은 왼무릎이다. 평균오차 +22.9° -> +2.7°, RMS 26.2° -> 9.3° 로 오른쪽
    (8.4°)과 같아졌고 평균전류도 0.103 -> 0.726 A 로 올랐다. 좌우 비대칭은
    존재하지 않았다 — 굶주린 것이지 망가진 것이 아니었다. 주파수 응답과
    full_check 가 왼무릎을 두 번 무죄로 판정했던 것이 옳았고 그걸 뒤집으려
    한 쪽이 틀렸다.
    그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
2026-08-12 docs: 실기가 걸었다 — 2.91초 종료는 Ctrl+C 였다
    로그에 이상 신호가 하나도 없던 이유가 이것이다. 전압 11.5 V, hw_error 0,
    온도 34 °C, 마지막 행도 양발 접지에 pitch +10°. 로봇이 실제로 걷기 시작해서
    놀라 멈춘 것이다. 이 프로젝트에서 실기가 자기 발로 걸은 첫 기록이다.
    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
2026-08-12 feat(hw): 패드로 로봇을 운전한다 — bt_pad / joy_local / pad_ctl
    rl_walk 는 한 줄도 안 고쳤다. 이제 막 실기가 걷기 시작한 코드라 상태기계를
    안에 넣으면 그걸 건드리게 된다. 대신 밖에 감독 프로세스를 두고, rl_walk 에
    이미 있던 --cmd-udp-port 로 패드 입력을 localhost UDP 중계한다. cmd_udp.py
    가 원래 데스크톱 심에서 받던 그 경로 그대로다.
    직접 꽂는 쪽이 나은 이유: 중계가 localhost 라 WiFi 지터가 없다(데스크톱에서
    보낼 때는 300 ms 워치독이 순간 끊김에 걸려 로봇이 섰다), 데스크톱에 Isaac
    Sim 이 안 떠 있어도 되고, 로봇이 책상에서 벗어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
2026-08-12 feat(hw): bt_pad 를 콘솔 UI + CLI 서브커맨드로 — 그리고 두 개의 파싱 버그
    붙일 때마다 헤매지 않게 두 갈래를 다 만들었다.
    bt_pad.py 콘솔 UI. 번호=연결, r=새로고침, x3=3번 삭제,
    d=연결끊기, f=전부삭제, q=종료
    bt_pad.py scan [초] 번호 매긴 목록
    bt_pad.py connect 3 그 번호(또는 MAC)에 붙는다
    bt_pad.py remove 3 / disconnect / forget / status / auto
    번호를 서브커맨드 사이에 넘기려고 scan 결과를 ~/.bt_pad_last.json 에 남긴다
    (매번 새 프로세스라 메모리로는 못 넘긴다).
    핵심은 **● 지금 전파가 잡힘 / · 예전에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
2026-08-12 fix(hw): 버튼 배치 자동 감지 + bluetoothctl 5.64 의 devices 필터 미지원
    실기에 패드를 붙이고 나서 두 개가 더 나왔다.
    1. bluetoothctl 5.64 는 `devices Connected` 필터를 모른다 (5.65 부터다).
    "Too many arguments" 를 뱉는데 그걸 빈 목록으로 읽어서, 패드가 멀쩡히
    붙어 있는데도 status 가 "연결된 장치 없음" 이라고 보고했다. 아는 장치
    마다 `info` 를 물어 Connected: yes 를 보는 방식으로 바꿨다.
    2. 버튼 번호가 연결 방식마다 다르다. 실측(js0 ioctl): 축 8 개, 버튼 15 개.
    USB xpad 는 11 개이고 배치도 다르다 —
    11 개 (USB xpad) 0=A 1=B 2=X 3=Y 4=LB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
    [bt_pad.py, joy_local.py, pad_ctl.py]
2026-08-12 feat(hw): rl_walk --joy (고정 명령·UDP 중계와 상호배타) + gain_report 를 저장소로
    --joy 는 명령원 하나를 바꾸는 것뿐이라 rl_walk 안에 넣었다 (pad_ctl 의
    상태기계와 다르다). joy_local.JoystickCommand 가 cmd_udp.CommandReceiver 와
    같은 인터페이스라 루프는 한 줄도 안 바뀐다. 버튼 배치는 패드에 물어서 고르고
    --joy-map 으로 덮을 수 있다.
    --vx/--vy/--wz 나 --cmd-udp-port 와 같이 주면 argparse 에서 막는다. 명령원이
    둘이면 매 스텝 뒤쪽이 command[:3] 을 덮어써서 --vx 가 조용히 무시되고, 로그만
    봐서는 왜 안 갔는지 알 수 없다. 기본값 0 과 "직접 0 을 준 것"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
2026-08-12 feat(diag): 관절추종을 심·실기 같은 자로 재는 track_stats + play_fixed_cmd --track-csv
    실기 P=1402 에서 잰 결과 무릎만 확연히 못 따라간다 (이득 L 0.82 / R 0.87,
    RMS 8.2 / 6.9 도). 나머지는 0.92~1.05 다. 지연은 전 축 43 ms 로 공통이라
    버스·제어주기 몫이고 P 로 못 고친다. 좌우는 이제 대칭이다.
    이득과 지연을 나눠 보는 게 핵심이라 둘을 따로 낸다 — 둘 다 RMS 를 키우지만
    처방이 반대다 (이득이 낮으면 P 를 올리고, 지연에 게인을 올리면 진동한다).
    열 이름과 정의를 실기 rl_walk_log.csv 와 일부러 똑같이 맞췄다 (goal_* =
    실제로 관절에 나간 목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
2026-08-12 diag: track_stats --skip + 심-실기 첫 비교 결과
    vx=+0.15 구간에서 심(v46, 22.6s)과 실기(2.6s)를 같은 자로 쟀다.
    이득 지연 오프셋
    관절 심 실기 심 실기 심 실기
    L.knee 0.69 0.76 40ms 64ms -2.48 -3.06
    R.knee 0.71 0.83 20ms 64ms +1.19 +1.15
    L.hip_roll 0.70 0.86 20ms 43ms +1.21 +1.15
    L.hip_yaw 0.82 1.02 20ms 43ms -0.09 +0.11
    **실기가 심보다 잘 따라간다.** 무릎 이득이 심 0.69~0.71, 실기 0.76~0.83 이다.
    즉 P=1402(심 stiffness 37.65 에 맞춘 값)는 이미 충분하고, 더 올리면 실기가
    심보다 뻣뻣해져 반대 방향 갭이 생긴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
2026-08-12 feat(v47): 액션 지연을 실측에 맞춘다 (2~3 스텝)
    실기가 처음 자기 발로 걷고 나서 심과 실기를 같은 자로 처음 비교한 결과에서
    나온 한 가지 변경이다 (track_stats, vx=+0.15 구간).
    강성은 이제 맞다. 실기가 오히려 심보다 잘 따라간다 (무릎 이득 심 0.69~0.71
    vs 실기 0.76~0.83). 중력에 눌려 처지는 오프셋까지 재현된다 (L.knee 심 -2.48
    / 실기 -3.06). 그러니 P 게인은 올리면 안 된다 — 실기가 심보다 뻣뻣해져
    반대 방향 갭이 생긴다. 오늘 맞춘 전류 700 / P 1402 조합이 들어맞았다.
    남은 갭은 지연 하나다. 실기가 심보다 정확히 한 스텝(약 21 m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
2026-08-12 fix(v47): gym.register 누락 수정 + 등록 세 곳의 일치를 검사하는 테스트
    v47 을 추가하면서 joystick_env_cfg 의 설정 클래스와 task_registry 의
    ENV_CFG_CLASS/GAMMA097_TASKS 는 고쳤는데 __init__.py 의 gym.register 를
    빠뜨렸다. 학습이 NameNotFound 로 죽었고, Isaac Sim 부팅에 1 분이 걸리므로
    1 분 뒤에야 알았다.
    task_registry.py 맨 위 주석이 "같은 매핑이 여섯 군데에 복제돼 있었다" 고
    경고하며 그걸 한 곳으로 모았는데, gym 등록만은 아직 __init__.py 에 버전별
    블록으로 남아 있다. 그래서 새 버전은 여전히 세 곳을 고쳐야 한다.
    tests/test_task_registry_consistency.py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
2026-08-13 feat(v48/v49): 걸음을 부드럽게 — action_rate 되돌리기 + 속도 한계 + README 갱신
    사용자가 "좌우로 덜컹거리고 발이 팍팍 찍힌다" 고 해서 심과 실기를 같은 자로
    재서 원인을 갈랐다.
    배포 문제가 아니다. 몸통 흔들림이 심과 소수점까지 같다 — roll 진폭 심 20.98°
    / 실기 20.39° (0.97x), 각속도 roll RMS 1.22 / 1.22 (0.99x). P 게인이나 필터로
    고칠 것이 아니다.
    떨림도 아니다. 목표각 방향전환 비율이 실기 21.4 % / 심 29.7 % 로 둘 다
    백색잡음(50 %) 아래다. 명령은 매끈하다.
    빠른 움직임이다. 정책이 속도 클램프를 상시 물고 있다 — 목표각 변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
2026-08-13 chore(hw): 젯슨의 최신 사본을 저장소로 가져온다 (파일별로 골라서)
    병합 전에 젯슨의 scripts/hw 22 개를 전부 당겨 저장소와 대조했다. 한쪽이
    일방적으로 최신이 아니라 **파일마다 갈렸다.**
    젯슨이 최신 — 가져왔다:
    rustypot_hwi.py 다른 세션이 CURRENT_LIMIT_MAX(1193)/VEL_LIMIT_MAX(1023)
    상수와 HWI(vel_limit=) + _apply_vel_limit() 을 추가했다.
    오늘 실기 EEPROM 에서 본 Current Limit 1192 / Velocity
    Limit 1023 의 정체가 이것이었다. "이미 그 값이면 안 쓴다"
    는 EEPROM 수명 보호도 들어 있다.
    dxl_br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
2026-08-13 feat(v50): 지면 마찰을 1.0 -> 0.5 로 (실기에서 발이 미끄러진 증거)
    v48/v49(부드러움)와 섞이지 않게 v47 에서 따로 갈라 나온다.
    실기 로그에서 발이 미끄러진다는 증거가 나왔다. 접지 상태로 나눈 몸통 yaw
    각속도 평균이 양발 접지에서 심 -0.069 vs 실기 +0.672 rad/s 다. 두 발이
    지면에 고정된 폐쇄 체인에서는 마찰이 충분하면 못 도는 상황인데 38 도/초로
    돈다. 단발 지지에서는 심의 10 배이고 좌우가 비대칭이라(+2.25 / -1.00) 순
    드리프트가 왼쪽으로 남는다.
    그리고 걸음이 요구하는 마찰(|수평가속도|/|수직항력|)이 전진 중 중앙값 0.47,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
2026-08-13 diag: 발 궤적 실측 — 발을 다리 길이의 23 % 나 든다
    사용자가 '보폭이 너무 크거나 발을 너무 위로 들어서 그런 걸 수도 있다' 고 해서
    URDF FK 로 몸통 기준 발 궤적을 쟀다. 맞았다.
    발 들림 보폭(x)
    심 목표 31.3 / 39.9 mm 79 / 84 mm
    심 실제 20.5 / 29.4 mm 63 / 73 mm
    실기 실제 32.7 / 36.2 mm 76 / 71 mm
    다리 마디가 78.65 mm x 2 = 157 mm 이므로 발 들림 36 mm 는 다리 길이의 23 %
    다. 사람 보행은 1~2 % 다. placo 설정 walk_foot_height 가 0.04 인 것이 그대로
    나온다 (원본 v1 은 0.03 / feet_spacing 0.14, v2 는 0.04 / 0.18).
    보폭은 줄일 수 없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
2026-08-13 feat(v51): 발 들림을 절반으로 (ref_g135fh20) — 레퍼런스만 바뀐다
    발을 다리 길이의 23 % 나 들고 있었다. URDF FK 로 실측한 값 (실기 32.7 /
    36.2 mm, 다리 마디 78.65 x 2 = 157 mm). 사람 보행은 1~2 % 다.
    보폭은 줄일 수 없다 — 76 mm x (1/0.54 s) = 0.14 m/s 로 명령 0.15 와 맞는다.
    속도가 보폭을 정하므로 발 들림만 자유 변수다.
    이것이 세 증상의 공통 원인이다. 스윙 0.18 초에 36 mm 를 올렸다 내리면 피크
    0.63 m/s 로 착지한다 — 착지 충격 2.4 g, 모터 속도 한계 상시 포화, 무게를
    한쪽 다리로 완전히 옮겨야 해서 생기는 roll +-10 도.
    imitation_scale 이 4.0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
2026-08-13 diag: 걸음 품질을 한 표로 — gait_quality.py
    환경이나 레퍼런스를 바꾼 런은 보상을 비교할 수 없다. 다른 시험을 친
    것이기 때문이다 — v50(지면 마찰 0.5)이 351.0 으로 v48(318.8)을 크게 앞섰지만
    마찰을 바꾸면 물리가 달라지므로 그 숫자로 '더 잘 걷는다' 고 말할 수 없다.
    그래서 환경과 무관한 걸음 자체의 성질을 잰다. 각 항목이 실기에서 관측된
    증상과 하나씩 대응한다: 목표각 속도 p95(모터 속도 클램프를 무는가),
    roll 진폭(좌우 덜컹거림), 발 들림(다리 157 mm 대비 %), 접지 전환.
    Claude-Ses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
2026-08-13 feat(v52): 보간격을 좁힌다 (feet_spacing 0.18 -> 0.14)
    v48~v51 을 같은 마찰(μ 1.0)로 놓고 걸음 품질을 재니 덜컹거림이 거의 안
    줄었다. roll 진폭 v48 20.7 / v49 21.9 / v50 21.8 / v51 18.6 도.
    세 가지가 나왔다.
    v50 은 착시였다. 자기 환경(μ 0.5)에서는 roll 11.9 도로 압도적이었지만 그
    정책을 원래 마찰에 넣으니 21.8 도로 돌아왔다. 미끄러운 바닥에서는 좌우로
    흔들 지면반력이 없어 못 흔든 것이지 잘 걷게 된 것이 아니다. 보상 351.0 도
    같은 착시고, 원래 바닥에서는 접지 전환이 25.2/s 로 오히려 채터링한다.
    아무도 속도 클램프를 못 벗어났다.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
2026-08-13 diag: 스윙 궤적의 수직성을 잰다 — 우리는 옆으로 더 많이 휘두른다
    사용자가 다른 빌더의 로봇 영상을 보고 '발을 거의 수직으로 들고 높이도
    사람처럼 매우 작은데 앞뒤양옆 다 잘 간다' 고 했다. 우리 걸음이 그런지 재는
    지표가 없어서 추가했다 — 스윙(발이 떠 있는) 구간마다 상승량과 좌우 이동량을
    재고 그 비를 낸다.
    결과: 한 번 스윙에 위로 22~23 mm 뜨는 동안 옆으로 29~36 mm 움직인다.
    수직성(상승/좌우)이 v48 0.78, v51 0.65 로 1 을 못 넘는다 — 수직이 아니라
    옆으로 호를 그린다. 그만큼 몸통이 좌우로 무게를 옮겨야 하고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
2026-08-13 docs(v52): 보간격 좁히기 실패 — 레퍼런스로는 발 궤적을 못 바꾼다
    roll 진폭 25.1도(v51 18.6, v48 20.7)로 가장 크고 수직성 0.47(v51 0.65,
    v48 0.78)로 가장 낮다. 지지 다각형이 좁아져 좌우 여유가 준 만큼 정책이
    균형을 잡느라 발을 더 크게 휘두른 것으로 보인다.
    더 중요한 것은 v51 과 v52 가 같은 방향으로 어긋났다는 점이다. 레퍼런스
    에서는 발의 좌우 흔들림을 41.7 -> 28.1 mm 로 줄였는데 실제 걸음에서는
    29.5 -> 35.5 -> 41.1 mm 로 오히려 늘었다. 두 번 다 반대로 갔다.
    정책이 레퍼런스의 발 궤적을 따라가지 않는다. 모방 리워드가 비교하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
2026-08-13 feat(v53/v54): 발 궤적을 직접 벌하는 리워드 — 그리고 발 높이 주장 정정
    ## 정정 먼저
    며칠 동안 "발을 다리 길이의 23 % 나 든다" 고 판단하고 그 위에 v51(발 들림
    반토막)·v52(보간격 좁힘)를 쌓았는데 **그 값이 잘못 잰 것이었다.** 몸통 기준
    좌표에서 발 하나의 z 범위를 썼는데 거기엔 몸통이 위아래로 출렁이는 양
    (표준편차 4.6~5.3 mm)과 몸통이 기울며 발이 상대적으로 움직이는 양이 섞인다.
    스윙 발이 **접지 발보다** 얼마나 뜨는지로 다시 재면:
    v48 중앙값 5.2 mm (다리 157 mm 의 3.3 %) · 스윙당 최고 14.2 mm
    v51 중앙값 4.5 mm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
2026-08-13 fix: main 의 CLAUDE.md 가 'ㅂㅂ' 한 줄로 덮여 있었다
    두 갈래를 하나로 합치려고 트리를 대조하다 찾았다. 그래프 규약과 저장소 맥락이
    담긴 25 줄짜리 원본이 한 줄짜리 오타로 덮여 있었다. 다른 갈래에 남아 있던
    원본을 되살렸다.
    같이 대조한 나머지 둘은 main 이 맞아서 그대로 둔다:
    scripts/hw/estop.py main 에만 있다 (다른 갈래는 애초에 받은 적이 없다)
    joint_calibration neck_pitch +1 / head_pitch -1 로 rustypot_hwi 의
    2026-08-08 실측과 일치한다. 다른 갈래는 부호 반전
    이전의 옛 값을 들고 있었다
    두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
2026-08-13 fix(v53): cost_foot_lift 가 상수를 벌하고 있었다 — 학습 한 번 날림
    첫 v53 학습이 무너졌다. 보상 318.8 -> 100.4, 에피소드 561 -> 320.
    reward_terms 로 항목별로 재니 foot_lift 가 -0.1667 로 리워드 예산의 45 % 를
    먹고 있었다. 그런데 **정지 명령에서 -0.2415** 였다 — 가만히 서 있는데 발
    들림 벌점이 최대다. 서 있으면 0 이어야 한다.
    원인은 계수가 아니라 버그다. body_pos_w 는 발 링크 원점이지 발바닥이 아니고,
    이 로봇은 좌우 발 링크의 z 오프셋이 서로 반대라 양발이 나란히 땅에 있어도
    39 mm 차이난다 (leg_fk 의 FOOT_FIXED 가 좌 -19.55 / 우 +19.55 mm)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
2026-08-13 feat(hw): P 게인 스윕 — 착지 충격과 추종을 같이 잰다
    사용자가 '걸음이 퉁퉁거리지 않고 부드러웠으면 좋겠다' 고 했다. 발에 3 mm
    고무패드를 붙여 수직 가속도 RMS 가 6.46 -> 3.92 로 이미 39 % 줄었고, 착지
    피크도 2.39 -> 2.12 g, 최대 4.81 -> 3.32 g 로 내려갔다. 다음 손잡이가 P 다.
    P 를 낮추면 다리가 물러서 충격을 흡수하지만 추종이 나빠진다. 지금은 낮출
    여지가 있다 — 실기 무릎 추종 이득이 0.76~0.83 인데 심은 0.69~0.71 로 실기가
    오히려 뻣뻣하다. 심 수준까지 깎으면 충격은 줄고 sim2real 갭은 좁아진다.
    이론값(1150~1200)을 믿지 말고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
2026-08-13 feat(reward): 부드러움 4항 — 발은 직선으로, 몸통·다리는 감쇠 (v55)
    사용자가 우선순위를 못박았다: 1 추종 · 2 부드러움 · 3 진동. 그리고
    발에 3 mm 고무패드를 붙인 뒤 "발이 미끄러진다", "토르소를 최대한
    부드럽게, 다리 움직임도" 라고 했다.
    관측이 뒤집혔다. v53 은 발 들림을 낮추는 쪽에 걸었는데, 패드가 물면서
    발 끌림이 드러났다. 스윙 여유는 중앙값 5.8 mm 인데 roll ±10 도가
    반스탠스 70 mm 에서 발 모서리를 12 mm 내린다 — roll 만으로 바닥에
    닿는다. 낮출 게 아니라 붙잡아야 한다.
    cost_foot_clearance 스윙 중 발을 목표 높이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
2026-08-13 diag: 걸음 품질 표에 추종을 넣는다 — 우선순위 1 위인데 없었다
    2026-08-14 사용자가 우선순위를 못박았다: 1 추종 · 2 부드러움 · 3 진동.
    그런데 gait_quality.py 는 roll·발 들림·접지만 봤고 추종이 없었다. 그래서
    "부드러워졌지만 안 간다" 를 걸러낼 수가 없었다.
    두 종류를 다 넣는다:
    명령 추종 명령 속도 대비 실제 몸통 속도. play_fixed_cmd 의 track-csv 에
    vel_x/y/z 열이 없어서 못 쟀다 — 추가했다. 실기는 오도메트리가
    없어 비므로 읽는 쪽이 없을 때를 견딘다.
    관절 추종 목표각 대비 실제 진폭비. 심·실기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
2026-08-13 diag: 걸음 주기와 짧은 접지 — v53 의 roll 감소는 리워드 해킹이었다
    v53(= v48 + foot_lateral -10)이 roll 진폭 20.7 -> 11.0 도로 반토막 나서
    성공으로 볼 뻔했다. 접지 지속시간을 재 보니 아니었다:
    스탠스 스윙 주기 100ms 미만 접지
    v48 왼 280 ms 160 ms 440 ms 20/64
    v48 오 340 ms 180 ms 520 ms 5/53
    v53 왼 140 ms 120 ms 260 ms 9/79
    v53 오 80 ms 60 ms 140 ms 56/96
    오른발이 7 Hz 로 떨고 있고 접지의 58 % 가 100 ms 미만이다. 레퍼런스
    주기는 540 ms 다. 걸은 게 아니라 바닥에서 진동한 것이고, 발을 바닥
    근처에서 잘게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
2026-08-13 feat(cfg): v56 — 발 떨기 봉쇄 보험 (stance_violation 1.0 -> 3.0)
    v55 가 여전히 떨 때만 쓴다. v53 이 뚫은 경로가 계산으로 보인다:
    contact_rew = (swing - 1.0 x stance_violation) x w_contact 에서 계수가
    1:1 이라 떨면 두 항이 상쇄되고, 남는 foot_lateral 절감이 순이득이 된다.
    같은 일이 imitation_v12 에도 있었다 — 사용자가 발이 "진동하는것마냥"
    떤다고 했고 w_stance_violation 이 그때 만들어진 답이다. 그 값이 지금
    1.0 인데 부족했다.
    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
2026-08-13 docs: 2026-08-14 학습 기록 — 부드러운 걸음과 리워드 해킹
    v53 의 roll 반감이 가짜였다는 것과 어떻게 알아냈는지, 새 리워드 4 항의
    근거와 계수 산출, 그리고 보상으로 걸음을 판정하면 안 되는 이유.
    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
2026-08-13 feat(hw): D 게인 <-> 심 damping 환산 — P 는 이미 맞았고 남은 건 D 와 토크다
    사용자가 "p게인을 심과 같이 맞춰줘 (젯슨 코드)" 라고 해서 젯슨 라이브
    레지스터를 읽었다. 다리 10축 전부 P=1402 로 **이미 심의 37.65 와 100 %
    일치**했다. 남은 것을 재려면 D 쪽 환산이 필요해서 넣는다.
    joint_damping(D) = (D/16) x TORQUE_PER_CURRENT_UNIT / TICK_RAD x 1ms
    d_gain_for_damping 그 역함수
    마지막 1 ms 가 핵심이다. 펌웨어는 미분을 주기당 오차 차분으로 계산하지
    dt 로 나누지 않는다 — 나눈다고 보면 D=4700 이 1010 N·m·s/rad 가 나와
    물리적으로 말이 안 된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
2026-08-14 feat(reward): 착지 충격 — "퉁퉁거림" 의 정체는 걸음이 아니라 바운스였다
    앞의 판단을 철회한다. 접지 전환만 세면 v53 이 주기 195 ms, v55 가 210 ms 로
    레퍼런스 540 ms 의 4 분의 1 이라 "발을 7 Hz 로 떨고 있다" 고 판단했고,
    그 근거로 v53 을 실기에 올리지 말라고까지 했다. 접지 신호를 디바운스해서
    다시 재니 뒤집혔다:
    디바운스 없음 20 ms 40 ms 60 ms
    v48 480 540 540 540
    v53 195 385 490 540
    v55@2k 210 480 500 540
    v55@3k 340 430 490 540
    전부 540 ms 로 수렴한다. 걸음 주기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
2026-08-14 diag: 우선순위 그대로 판정하는 표 — 6방향 추종이 1순위다
    2026-08-14 사용자가 순위를 못박았다: 1 6방향 추종 · 2 보행 안정성
    (덜컹거림·좌우 흔들림·발 쿵쾅거림) · 3 보행 효율 (토크·진동).
    그런데 그날 판정은 gait_quality.py 로 vx 0.15 **전진 하나만** 재고 했다.
    1 순위가 6 방향인데 그중 하나만 본 것이다. 실제로 v55 의 요 추종 오차는
    v48 보다 나빴는데(0.437 vs 0.395) 전진 지표가 좋아서 묻혔다. 옛 v42 npz 로
    확인해 보니 좌/우 오차가 전진의 3~4 배다 (우 0.0371 vs 전진 0.0087) —
    전진만 보면 실력의 4 분의 1 만 본다.
    gait_compare.py 는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
2026-08-14 fix: 발 인덱스가 머리를 가리키고 있었다 — 오늘 발 리워드 전부가 틀렸다
    `_feet_ids` 는 **접촉센서**의 body 목록에 대한 인덱스인데, 그 숫자를
    `_robot.data.*` 에 그대로 썼다. 두 목록의 순서가 달라서 전혀 다른 링크가
    나온다:
    접촉센서 [5] foot_assembly [14] foot_assembly_2
    아티큘레이션 [5] head_pitch_assembly [14] foot_assembly_2
    즉 `_robot.data.body_pos_w[:, self._feet_ids]` 가 (머리, 오른발) 이었다.
    z 가 [0.329, 0.016] 로 나와서 잡았다 — 몸통이 0.19 m 인데 "발" 하나가
    0.33 m 에 있을 수는 없다. 고친 뒤 [0.0159, 0.0161] 로 양발이 같아졌다.
    ## 무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
2026-08-14 feat(v57): 순수 단일축 명령을 학습에 넣는다 — 1순위를 구조로 고친다
    25 개 버전을 6 방향으로 다시 재니 **전부** 좌/우가 전진보다 2~4 배 나빴다.
    리워드 계수를 아무리 만져도 안 고쳐진 이유가 명령 분포에 있었다:
    cmd[:,0] = uniform(-0.15, 0.15) # vx
    cmd[:,1] = uniform(-0.2, 0.2) # vy
    cmd[:,2] = uniform(-1.0, 1.0) # wz
    축별 독립 균등이라 vx·vy·wz 가 **항상 섞여서** 나온다. "옆으로만",
    "제자리 회전만" 같은 명령은 확률적으로 거의 안 나오는데, 시험은 순수
    단일축으로 본다 — gait_compare 의 6 방향이 그렇고 사람이 조이스틱을 한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
2026-08-14 diag: 버스 타이밍 측정 — 통신 지연은 더 못 줄인다
    회전이 v42 0.0040 -> v47 0.0672 로 17 배 나빠진 원인이 액션 지연 2~3 스텝
    (실측 43 ms) 이라, 지연 자체를 줄일 수 있는지 재 봤다.
    sync_read 현재위치 (14축) 16.05 ms
    sync_write 목표위치 (14축) 0.82 ms
    블록 read (64,7) 다리10 12.07 ms <- HW_ERR_PERIOD 로 이미 걸러짐
    실기 로그 실제 루프 중앙 20.0 ms · 평균 21.5 ms -> 46.5 Hz
    매 루프 통신은 10 축 read + write 로 약 13 ms, 20 ms 예산의 65 % 다.
    줄일 여지를 하나씩 확인한 결과 전부 막혀 있다:
    Return Delay 250 낮추면 반이중 턴어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
2026-08-14 docs: 포스터 발표용 요약 — 측정이 뒤집은 네 가지 믿음
    4 주(2026-07-17~08-14, 290 커밋, v1~v57)의 결과를 학술 포스터로.
    뼈대는 진단 원장이다 — 그럴듯한 가설이 측정에 네 번 뒤집힌 기록이
    이 연구의 실제 내용이기 때문이다.
    1 왼무릎 고장 -> 전원 (5.22 A 는 어댑터 상한이었다)
    2 발을 7 Hz 로 떤다 -> 디바운스하니 전부 540 ms, 착지 바운스
    3 발 리워드가 부드럽게 했다 -> 발이 아니라 머리를 보고 있었다
    4 좌우 추종은 리워드로 -> 학습에서 안 본 명령 분포였다
    팔레트가 내용을 인코딩한다: 청색 = 심, 주홍 = 실기. 이 프로젝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
2026-08-14 feat(v58): 액션 지연을 다시 넓힌다 (2~3 -> 0~3) — v57 이 가설을 기각했다
    v57 로 순수축 명령을 35 % 넣고 축을 앞뒤 3 : 회전 2 : 옆 1 로 가중
    추첨했는데 회전이 꿈쩍도 안 했다:
    회전 v47 0.0672 -> v57 0.0666 거의 그대로
    전진 v47 0.0150 -> v57 0.0338 나빠짐
    정지 v47 0.0018 -> v57 0.0159 나빠짐
    점수 v47 0.0241 -> v57 0.0310 나빠짐
    명령 분포는 원인이 아니었다. 회전은 학습량이 모자라서 못 하는 게 아니라
    물리적으로 못 하고 있다. (2 순위는 조금 나아졌다 — roll RMS 5.80 -> 5.56,
    착지 RMS 0.0728 -> 0.0726. 그러나 1 순위가 안 되면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
2026-08-14 feat(v59): 질량 무작위화를 원래 범위로 — v58 이 회전을 되찾고 앞뒤를 잃었다
    v58(v47 + 지연 2~3 -> 0~3) 결과:
    회전 0.0672 -> 0.0342 절반. 지연 폭이 회전에 영향을 준다는 것 확인
    후진 0.0079 -> 0.0532 6.7 배 악화
    점수 0.0241 -> 0.0349
    논리가 좁혀졌다:
    v42 지연 0~3 · 질량 원래 · 몸통 원래 앞뒤 0.0098 · 회전 0.0040
    v47 지연 2~3 · 질량 확대 · 몸통 +10mm 앞뒤 0.0115 · 회전 0.0672
    v58 지연 0~3 · 질량 확대 · 몸통 +10mm 앞뒤 0.0377 · 회전 0.0342
    v58 과 v42 의 차이는 질량 무작위화(v44)와 몸통/레퍼런스(v46) 둘뿐이다.
    앞뒤를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
2026-08-14 docs: 포스터에 v57~v59 결과 — 원장 4번을 교란변수 이야기로 다시 쓴다
    포스터의 원장 4 번이 "좌우 추종의 원인은 명령 분포였다" 였는데 v57 이
    그 가설을 기각했다 (순수축 명령 35 % 를 넣어도 회전 0.0672 -> 0.0666).
    반증된 주장을 발표 자료에 둘 수 없어 다시 썼다.
    새 내용이 오히려 더 강하다 — **두 개의 독립된 원인이 서로를 가리고
    있었다**:
    구성 지연 질량 앞뒤 회전 점수
    v42 0~3 원래 0.0098 0.0040 0.0131
    v47 2~3 확대 0.0115 0.0672 0.0241
    v57 +순수축 명령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
2026-08-14 feat(v60): 몸통 각속도 감쇠 — v59 가 1순위를 얻고 2순위를 내줬다
    사용자가 v59 녹화를 보고 "몸통이 너무 흔들린다" 고 했고 측정이 같은 말을
    한다:
    roll RMS 평균 v47 5.80 · v57 5.56 · v59 6.66 도
    roll 진폭 최악 v47 85.0 · v57 75.3 · v59 102.7 도
    방향별 우 8.69 · 후진 7.22 · 좌 6.83 · 전진 5.44 · 정지 1.28
    probe_terms.py 로 v59 에서 잰 torso_ang_vel 원시값이 1.7930 이다. v53 때
    같은 항이 1.1242 였으니 **60 % 더 흔들린다** — 눈으로 본 것과 숫자가 맞다.
    cost_torso_ang_vel 은 몸통 roll·pitch 각속도를 직접 벌한다. yaw 를 빼므로
    회전 명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
2026-08-14 feat: 자동 실험 루프 — 합격선을 숫자로 못박는 채점표 + 명령 상대 foot_lateral
    사용자가 "1순위 2순위 둘 다 잡을 때까지 개입 없이 자동으로 돌려" 라고 했다.
    사람이 매번 판단하지 않으려면 합격 여부가 숫자로 결정돼야 한다.
    scripts/diag/scoreboard.py — 모든 gait_*.npz 를 합격선에 대고 채점한다.
    1순위 점수 <= 0.0180 (v59 가 0.0165. 잡음 여유 포함)
    2순위 roll RMS <= 5.50도 (v47 5.80 · v57 5.56 · v59 6.66)
    넘어짐 <= 0.5% (|roll| > 40도 표본 비율)
    roll 진폭(p-p)은 합격선에서 뺐다 — 드문 넘어짐 한 건이 값을 지배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
2026-08-14 feat(v61): 흔들림의 원인을 친다 — 명령 상대 발 좌우 억제
    v60(torso_ang_vel -1.2)이 roll RMS 6.66 -> 3.73 도로 2 순위를 통과했지만
    점수가 0.0165 -> 0.0304 로 1 순위를 깼다. 두 점으로 기울기를 재면:
    roll = 6.66 - 2.44 x (c/1.2) -> 5.50 이 되려면 c ~ 0.57
    점수 = 0.0165 + 0.0139 x (c/1.2) -> 0.0180 을 넘는 c ~ 0.13
    torso_ang_vel 하나로는 v59 기반에서 양쪽을 만족할 수 없다. 각속도는
    흔들림의 증상이고, 직접 감쇠하면 명령 추종에 쓰던 자유도까지 묶인다.
    원인은 좌우 무게 이동이다. v55 가 roll RMS 2.64 도를 낸 적이 있는데 그건
    발 인덱스 버그로 foot_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
2026-08-14 feat(v62): 옆 명령일 때 발 좌우 억제를 푼다 — v61 이 한 곳에서만 실패했다
    v61(명령 상대 foot_lateral -12) 결과:
    항목 v59 v61 판정
    점수 0.0165 0.0221 (합격선 0.0180)
    앞뒤 0.0153 0.0155 그대로 지킴
    회전 0.0106 0.0104 그대로 지킴
    옆걸음 0.0263 0.0534 << 유일하게 두 배
    roll RMS 6.66 4.97 합격 (<= 5.50)
    착지 하강 1.158 0.834 측정 전 버전 최고
    토크 떨림 5.471 5.029 측정 전 버전 최고
    **2 순위는 통과했고 앞뒤·회전도 지켰다.** 점수를 분해하면 옆걸음만 v59
    수준으로 돌아오면 0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
2026-08-17 feat(v63): 미끄러운 바닥도 겪게 한다 — 마찰 0.5~1.0 -> 0.3~1.0
    사용자: "실기에서 발이 밀린다, 슬라이딩하는 것 같다."
    로봇 바디 마찰 무작위화가 0.5~1.0 이고 지면은 1.0 고정, 결합이 multiply
    라 실효 마찰이 0.5~1.0 이다 — 0.5 아래를 한 번도 겪지 않는다. 실기
    바닥이 그보다 미끄러우면 정책은 있지도 않은 접지력을 믿고 걷는다.
    아래로만 넓힌다. 위쪽은 이미 덮고 있고 미지수는 미끄러운 쪽뿐이다.
    v44 에서 배운 대로 필요 이상으로 넓히지 않는다 — 질량을 0.85~1.25 로
    넓혔다가 앞뒤 추종을 망쳤다.
    cost_foot_slip 도 준비돼 있고 v5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
    [batt.stl, bno055.stl, body_bottom.stl, body_front.stl, body_middle.stl, body_tail.stl, body_top_left.stl, body_top_right.stl]
2026-08-17 feat(v64): 보간격을 넓힌다 (0.18 -> 0.22) — 2순위를 리워드가 아니라 기하로
    흔들림을 리워드로 세 번 시도했고 세 번 다 1순위를 깎았다:
    구성 점수 roll RMS
    v59 (기준) 0.0165 6.66
    v60 torso_ang_vel -1.2 0.0304 3.73
    v61 foot_lateral -12 0.0221 4.97
    v62 v61 + 옆명령 게이트 0.0223 5.39
    v59-v60 기울기로 보면 어떤 계수도 두 합격선을 동시에 만족 못 한다
    (roll 5.50 이 되려면 c~0.57, 점수 0.0180 을 넘는 c~0.13). 벌점은 흔들림을
    줄이는 만큼 자유도를 묶고 그 대가가 추종이다.
    기하는 세금을 안 문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
2026-08-17 docs: 흔들림과 추종은 동시에 못 잡는다 — 다섯 지렛대 전부 실패
    합격선(점수 <= 0.0180 · roll RMS <= 5.50)을 세우고 다섯 가지 서로 다른
    지렛대를 시험했다. 전부 실패했고 실패 방식이 전부 달랐다:
    torso_ang_vel roll 3.73 최고 / 전 방향 붕괴
    foot_lateral roll 4.97 / 옆걸음만 2배
    + 옆 게이트 roll 5.39 / 앞뒤 악화
    마찰 0.3~1.0 회전 5배 악화
    보간격 0.22 앞뒤 0.0106 역대 최고 / 회전 7.4배 붕괴
    각 지렛대가 물리적으로 다른 것을 대가로 낸다 — 계수 부족이 아니다.
    v59-v60 기울기로도 확인된다 (roll 5.50 은 c~0.57, 점수 한계는 c~0.13).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
2026-08-17 feat(v65): 레퍼런스는 이미 수평을 말하고 있었다 — 모방 ang_vel 가중치 0.1 -> 1.0
    벌점 세 개와 무작위화 두 개가 모두 실패한 뒤(v60~v64) 레퍼런스를 직접
    열어 봤다. placo 궤적의 roll 각속도가 정확히 0 이다 (전 명령 0.00 deg/s,
    회전만 0.08).
    즉 "흔들리지 마라" 는 이미 모방 리워드 안에 있다 — ang_vel_xy 항이다.
    그런데 가중치가 0.1 로, 기본값 0.5 의 5분의 1 이다. Walk6(v17)에서
    낮춘 뒤 40 개 버전 동안 상속됐다. 정작 그 Walk6 독스트링 마지막 줄이
    "남은 증상은 몸통 흔들림(뒤뚱거림)이다" 다 — 증상을 적어 놓고 그것을
    고칠 항을 눌러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
2026-08-17 feat(v66): 마찰이 아니라 착지였다 — 실측으로 v63 의 전제가 깨졌다
    사용자가 저울로 실제 정지마찰을 쟀다. 로봇(약 2.6 kg)을 수평으로 당겼는데
    1 kgf 에서 꿈쩍도 하지 않았다. 즉 mu > 0.38 이고 근처도 안 갔으니 실제로는
    0.6~1.0 대다.
    심의 마찰 범위 0.5~1.0 이 이미 맞았다. v63 은 있지도 않은 문제를 대비시키
    느라 회전 추종을 5 배 내줬다 (0.0106 -> 0.0543). 마찰 라인은 닫는다.
    정지마찰이 충분한데 미끄러진다면 원인은 동적이다:
    1 착지 바운스로 수직항력이 사라진다 — mu 가 높아도 N=0 이면 마찰력 0
    2 발이 수평 속도를 가진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
2026-08-17 feat(v67): 쩍벌을 막는다 — 벌어지는 쪽엔 제동이 없었다
    v59 를 레퍼런스와 관절별로 비교하니 양쪽 hip_roll 이 +6~9 도 바깥이다
    (스탠스 약 38 mm 초과). hip_yaw 진폭은 레퍼런스의 6 배, 무릎 진폭은 절반.
    hip_inward 는 안쪽만 벌한다 (자가충돌 방지, 임계 3 도). 바깥으로 벌어지면
    inward 가 음수라 over=0 — 벌점이 정확히 0 이다. 넓은 지지 기반은 안 넘어
    지는 데 유리하니, 막는 것이 없으면 벌리는 것이 합리적이다. 버그가 아니라
    빈 자리였다.
    대칭으로 바깥 임계를 추가한다. 계수는 v59 gait npz 로 실측: 바깥 초과분
    raw 0.1890 -> 4% 기여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
2026-08-17 diag: 실사용 속도를 평가에 넣는다 — 쓰지도 못하는 0.15 에서 판정해 왔다
    2026-08-18, 사용자: "끝까지 밀면 잘못하면 넘어져서 살살 민다."
    실기 로그에서도 |cmd_vx| 최대가 0.07 이었다 (범위 0.15). 조이스틱 매핑은
    정상이므로 반만 민 것이고, 그것이 안전한 운용 범위다.
    심 데이터도 같은 말을 하고 있었다 — v59 가 0.15 에서 0.8 % 확률로 넘어진다.
    실기는 지연 43 ms 와 노이즈가 얹히니 실제 낙상이 된다.
    gait_compare 에 fwd_half(0.07)·turn_half(0.5)를 추가하고 scoreboard 에
    "실사용" 열을 넣는다. 옛 npz 에는 없으므로 있을 때만 보여 준다.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
2026-08-17 feat(hw): 방향 오차를 자이로로 복원한다 (--path-imu)
    사용자 증상: "회전이 잘 안 되고, 게걸음을 시키면 애가 회전을 한다. 그냥
    앞으로 갈 때도 양옆으로 드리프팅한다." 셋 다 방향 문제다.
    path_error 는 [횡방향오차, cos(방향오차), sin(방향오차)] 인데 실기에서는
    [0,1,0] 상수였다 — 정책에게 "완벽히 잘 가고 있다" 고 계속 거짓말을 해
    왔다. 틀어져도 관측에 안 들어가니 보정할 방법이 없었다.
    횡방향 오차는 오도메트리가 필요해 못 만든다. 그러나 방향 오차 두 성분은
    자이로 z 적분으로 만들 수 있고, 그것만으로 세 증상 모두에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
2026-08-17 fix(hw): 정지는 정지 — 명령이 없으면 방향 적분을 0 으로 리셋
    사용자: "적분 오차 때문에 정지시에도 애가 한쪽으로 기운다."
    맞다. 적분값이 남아 있으면 정책은 "틀어졌다" 고 보고 서 있는 채로 계속
    되돌리려 한다. 명령이 없으면 따라갈 경로도 없으므로 오차는 0 이 맞다.
    ||command[:3]|| <= STANDSTILL_HOLD_THRESH -> robot_yaw = path_yaw = 0
    path_error = [0,1,0]
    덤으로 정지 구간에서 자이로 바이어스를 다시 추정한다 (EMA, 시정수 약
    10 초). 정지 중에는 자이로가 0 이어야 하므로, 이렇게 두면 긴 주행에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
    [rl_walk.py]
2026-08-17 fix(hw): 조이스틱 좌우 축을 맞바꾼다 — 왼손 방향, 오른손 횡이동
    사용자: "오른쪽 조이스틱이 회전처럼 동작하고 왼쪽 조이스틱을 좌우로 했을
    때 회전이 안 된다. 둘이 기능 바꿔봐."
    전: 왼쪽 스틱 = 전후(축1) + 게걸음(축0), 오른쪽 좌우 = 회전(축2)
    후: 왼쪽 스틱 = 전후(축1) + 회전(축0), 오른쪽 좌우 = 게걸음(축2)
    차/전차식 조종이다. ODM_JOY_AXES 환경변수로 덮어쓸 수 있게 해 뒀다 —
    `ODM_JOY_AXES=1,0,2` 면 예전 배정으로 돌아간다.
    [joy_local.py]
2026-08-18 fix(hw): 정지는 리셋이 아니라 래치다 — 눈을 가리면 안 돌지 않는다
    1 차 시도는 정지에서 방향 오차를 0 으로 리셋했다. 틀렸다. 정책이
    "완벽하다" 고 보고 아무 보정도 안 하니, 눈을 가려 놓고 안 돌기를 바란
    셈이었다. 실측 결과 정지 중 3.2 도/s 로 한 방향으로 계속 돌았다
    (10.5 s 에 32 도, 11.6 s 에 37.8 도).
    정지는 피드백으로 지켜야 한다. 멈추는 순간 목표 방향을 현재 방향으로
    한 번 고정하고(래치), 그 뒤로는 틀어진 만큼을 그대로 정책에 보여 준다.
    정지 중 바이어스 재추정도 뺐다 — 로봇이 실제로 도는 것을 센서 바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
    [rl_walk.py]
2026-08-18 fix(hw): 가짜 바이어스가 정지 중 발을 돌리고 있었다
    바닥 40 초 정지 주행 로그 (--path-imu 켬):
    실제 회전 -7.3 도 / 35.9 초 (0.2 도/s — 로봇은 사실상 안 돈다)
    yaw_err +32.2 도까지 누적 <- 사용자가 본 "발이 조금씩 돌아간다"
    gyro_bias -0.0203 rad/s (-1.16 도/s)
    35.9 초 x 1.16 도/s = +41.7 도. 실제 -7.3 도와 합치면 +34 도로 관측된
    +32.2 도와 맞는다. 즉 오차 전부가 바이어스 추정 탓이다.
    왜 틀렸나: arm 직후 1 초 평균으로 재는데 그때 로봇은 rampin 으로 READY
    자세를 잡느라 **움직이고 있다.** 정지가 아니라 동작을 쟀다.
    토크 끈 정지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
    [rl_walk.py]
2026-08-18 docs: 심 점수 1등이 실기 1등이 아니다 — v66/v67 기반을 v61 로
    사용자 확인 (2026-08-18): "지금 실기에서 잘 되는 건 v61 이다. 전 것들은
    전부 잘 안 되거나 넘어진다."
    심 점수는 반대로 매겼다:
    v59 점수 0.0165 · roll 6.66 · 옆걸음 0.0263 <- 심 1 등
    v61 점수 0.0221 · roll 4.97 · 옆걸음 0.0534 <- 실기 1 등
    둘은 앞뒤·회전이 사실상 같고 옆걸음만 갈리는데 v61 은 흔들림이 25% 적다.
    실기에서는 넘어지면 그 주행이 끝나므로, 추종 0.003 차이보다 흔들림 25% 가
    성패를 가른다. 점수는 낙상 위험을 거의 반영하지 못한다.
    큐가 전부 v59 기반이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
2026-08-18 feat(v68): 낙상은 보수적으로 · 토크는 세게 · 탐색은 넓게
    사용자: "낙상은 매우 보수적으로 잡아야 하고 토크 패널티도 많이 줘야 할
    것 같음. 왜냐면 피크 토크가 매우 큼. 이를 위해서 탐색 시그마를 조금
    올려 달라."
    기반은 v61 — 실기에서 실제로 잘 걷는 것이 그것이다.
    min_base_height_ratio 0.75 -> 0.85
    torques_scale -1.0e-3 -> -0.2
    init_noise_std 1.0 -> 1.3 (JoystickPPORunnerCfg_Explore13)
    낙상을 상시 벌점이 아니라 **종료**로 조인다. 벌점은 "가만히 서 있기" 를
    유리하게 만든다 (Walk6 에서 자세 비중을 올렸다가 전진이 반토막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
2026-08-18 feat: v66/v67/v68 기반을 v65 로 — 처음으로 추종과 흔들림을 둘 다 잡았다
    v65(모방 ang_vel_xy 0.1 -> 1.0) 측정 결과:
    점수 앞뒤 회전 옆 실사용 rollRMS 낙상
    v59 0.0165 0.0153 0.0106 0.0263 — 6.66 0.8%
    v61 0.0221 0.0155 0.0104 0.0534 — 4.97 0.7%
    v65 0.0138 0.0054 0.0229 0.0297 0.0073 4.89 1.9%
    **한 정책이 추종(0.0138)과 흔들림(4.89)을 동시에 1 등 한 것은 처음이다.**
    앞뒤는 3 배 좋아졌다 (0.0153 -> 0.0054). 실사용 속도(0.07/0.5) 열도 처음
    채워졌고 0.0073 으로 좋다.
    레퍼런스가 이미 roll 각속도 0 을 지시하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
2026-08-18 feat(v69): 토크 벌점을 절반으로 — v68 이 얻은 걸 지키고 후진만 되찾는다
    v68 결과 (기준 v65):
    낙상 1.9 -> 1.1 % 종료 조건 0.85 가 먹혔다
    토크 제곱합 8.24 -> 5.91 벌점 -0.2 가 먹혔다 (-28%)
    roll RMS 4.89 -> 4.05 역대 최고
    회전 0.0229 -> 0.0036 6 배, 역대 최고 (예상 밖 보너스)
    후진 0.0039 -> 0.0315 8 배 악화 <- 점수를 0.0204 로 밀었다
    의도한 셋이 전부 먹혔고 대가는 후진 하나다. 뒤로 걸을 때 토크가 더 드는
    것은 자연스러우므로 -0.2 가 그쪽에 과했다고 본다. 후진은 앞뒤 가중 3 이라
    점수에 크게 걸린다.
    v6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
2026-08-19 feat(v70/71/72): 몸통 CoM 을 뒤로 10/15/20 mm — 교수님 지적
    2026-08-18, 교수님: "무게중심을 못 잡는다." 사용자가 뒤로 10/15/20 mm 를
    시험해 보라고 했다.
    근거는 v44 때 이미 측정돼 있었다: 심 모델의 CoM 은 발 중심보다 16.7 mm
    뒤인데 실기는 앞으로 넘어진다. 두 사실이 같이 서려면 실기의 실제 CoM 이
    심보다 앞에 있어야 하고, 그러면 정책은 있지도 않은 뒤쪽 여유를 믿고 걷는다.
    randomize_rigid_body_com 은 오프셋을 더하므로 범위 상하한을 같은 값으로
    주면 고정 이동이 된다. -x 가 뒤다 (실기 로그로 부호 확인).
    CPU 텐서를 쓰는 함수라 mod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
2026-08-19 fix(hw): 머리 P 게인 200 -> 800 — 머리가 몸과 평행하지 않다
    사용자: "12번 모터인가 2번 모터인가 모르겠는데 머리가 몸과 평행하지 않음."
    READY 는 neck_pitch(ID2) +30 도와 head_pitch(ID12) +30 도인데, URDF FK 로
    계산하면 그 둘은 정확히 상쇄되어 머리 피치가 0.00 도가 된다:
    전부 0 +0.00 도
    ZNECK (neck+30, head+30) +0.00 도 <- 설계상 평행
    neck +30 만 -30.00 도
    head +30 만 +30.00 도
    즉 모델은 맞고 실기가 명령대로 안 간 것이다. head_pitch(ID12)만 P=200 이라
    (나머지는 800) 머리 무게에 눌려 처지는 것이 가장 그럴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
    [rustypot_hwi.py]
2026-08-19 fix(hw): 머리 게인을 축마다 다르게 — 12 만 800, 13/14 는 200 으로 되돌림
    세 축을 다 800/4700 으로 올렸더니 실측 잔여 진동이 이렇게 나왔다
    (토크 ON, 자세 유지 중 10 초, p-p tick):
    head_pitch(12) 1 tick (0.09 도) <- 4 축 중 가장 조용하다
    head_yaw(13) 5 tick (0.44 도)
    head_roll(14) 6 tick (0.53 도)
    처짐이 문제인 축은 중력 모멘트를 받는 head_pitch 하나뿐이다. yaw 와 roll 은
    축이 중력과 나란해서 눌릴 일이 없으므로 강성을 올릴 이유가 없고, 올린 만큼
    떨림만 늘었다.
    12 를 800 으로 올린 것은 유지한다 — 그 축이 4 축 중 가장 조용해졌다는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
    [rustypot_hwi.py]
2026-08-19 feat(v73): 발바닥 접지면을 키운다 (1252 -> 4226 mm^2) — 좌우 16 -> 40 mm
    roll 흔들림을 제어로 여섯 번 시도해 전부 실패한 뒤 발 형상을 실측했다.
    foot_bottom_tpu.stl 의 **실제 접지 패치**(최저면 +-0.05 mm):
    기존 1252 mm^2 전후 85.1 mm 좌우 16.3 mm
    big_foot 4226 mm^2 전후 108.0 mm 좌우 40.0 mm
    바운딩박스(4237)가 아니라 실제로 바닥에 닿는 면이 1252 mm^2 이고, 그중
    **좌우 폭이 16 mm** 다. 거의 칼날 위에 서 있는 셈이라 CoM 이 조금만 옆으로
    가도 발 모서리를 넘는다. 앞서 계산한 "roll +-10 도면 반스탠스 70 mm 에서
    발 모서리가 12 mm 내려간다"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
    [batt.stl, bno055.stl, body_bottom.stl, body_front.stl, body_middle.stl, body_tail.stl, body_top_left.stl, body_top_right.stl]
2026-08-19 docs: 리워드 감사 — 18 개 중 6 개만 일한다 · 버전 색인 생성기
    사용자: "리워드가 너무 덕지덕지인지 봐줘. 디즈니 논문과 원본 리포는 간략한데
    우리가 삽질하고 있는 게 아닐까."
    v70 실측 기여 (스텝당 합 약 0.554):
    imitation 0.2189 (39%) · path_tracking 0.1782 (32%) ·
    tracking_lin_vel 0.1333 (24%) · alive 0.0600 (11%) ·
    action_jerk -0.0266 · tracking_ang_vel 0.0113 · action_rate -0.0111
    hip_inward/stand_still/upright_standstill/leg_symmetry/torques 는 1% 미만
    foot_* 5 개 · torso_ang_vel · joint_accel 은 0 (꺼짐)
    작동하는 계보(v42->v59->v65->v70->v73)는 처음부터 끝까지 같은 9 개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
2026-08-19 refactor: 죽은 cfg 4개 제거 · 중복 표 통합 · 인덱스 오용 정적 테스트
    사용자: "코드 전부 최적화 할 수 있어? 쓸데없는 주석 빼고 간결하고 robust 하게."
    먼저 쟀다. 24k 줄 · cfg 클래스 58 개 · 주석 10% · 독스트링 20%.
    죽은 것을 세어 보니 **cfg 4 개뿐**이고, rewards.py 함수 18 개는 전부 쓰이며,
    어디서도 안 켜 본 리워드 계수도 없었다. 코드는 덕지덕지가 아니었다.
    **주석은 빼지 않는다.** 이 프로젝트에서 독스트링이 실제로 사고를 막았다:
    v46 의 "실기 왼무릎이 -110 도 아래에서 죽는다" -> v42 를 실기에 안 올림
    hip_inward 의 정지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
2026-08-19 feat: 키보드 조종 + 터미널 대시보드 (WebRTC 로 볼 때 조향이 안 됐다)
    사용자: "odm play joy 말고 key 도 해줘. wasd 로 앞뒤좌우, qe 로 회전, zx 는
    입력 스로틀. webrtc 로 노트북에서 볼 때 조향도 되면 좋겠어서. 입력은 ros2
    같이 터미널 UI 로 파라미터라든지 로봇정보 같은 대시보드 + 조향."
    WebRTC 는 화면만 보낸다 — 노트북에서 보면서 조향할 길이 없었다. 조이스틱은
    PC 에 물려 있어야 하고.
    play_fixed_cmd.py --cmd-listen PORT UDP 로 명령을 **받는다**
    --telem HOST:PORT 상태를 JSON 으로 되돌린다 (약 20 Hz)
    scripts/console.py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
2026-08-19 fix: 스트림 포트 고정(49100/47998) · kit_args 전달 버그 · 날아간 ZNECK 표 복구
    스트림이 지금까지 한 번도 뜬 적이 없었다. `--kit_args <값>` 으로 띄어 쓰면
    argparse 가 `--` 로 시작하는 값을 옵션으로 오인해 "expected one argument" 로
    죽는다. `--kit_args=` 로 붙여 넘기도록 고쳤다.
    포트는 기본값에 맡기지 않고 못 박는다 (사용자 요청):
    app/livestream/port 49100 시그널링(websocket)
    app/livestream/{min,max}HostPort 47998 미디어(WebRTC 실데이터)
    값 출처는 확장 기본값을 읽어서 맞췄다 — omni.kit.livestream.webrtc 와
    omni.services.livestream.nvcf 의 extension.toml. O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
2026-08-20 fix(v73): 심의 발 접지면을 실측 — "좌우 16 mm 칼날" 은 심에 없었다
    big_foot USD 를 만들고 학습을 걸기 전에 접지면을 링크 좌표계에서 다시 쟀다.
    전제가 틀려 있었다.
    발 링크 콜리전 6 개 중 **가장 낮은 것은 TPU 밑창이 아니라 l_foot_side** 다.
    TPU 는 그보다 2.70 mm 위라 지면에 닿지 않는다:
    기존 l_foot_side 접지 1907 mm^2 99.3 x 38.7 mm (TPU 지면 +2.70 mm)
    big_foot l_foot_side 접지 2365 mm^2 108.6 x 42.9 mm (TPU 지면 +0.76 mm)
    즉 심의 좌우 지지폭은 이미 38.7 mm 였고, 이번 변경은 면적 +24 % · 좌우 +11 %
    에 그친다. STL 만 보고 적었던 "16.3 -> 40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
2026-08-20 feat(v74/v75): 목표를 토크·효율·토르소로 바꾸고 판정 지표부터 다시 세움
    사용자가 목표를 다시 세웠다 (2026-08-20): 피크 토크 최소화, 보행 효율
    최대화, 토르소 좌우 흔들림 최소화, 주행 안정성, robustness, 그리고
    "천천히라도 명령에 잘 따라 움직이는 것". 추종 정확도는 더 이상 1 순위가
    아니다. 기반은 v73 (big_foot USD + CoM 뒤로 10 mm) 을 유지한다.
    ## 재지 않으면 달성했는지 알 수 없다 — scoreboard 에 세 열 추가
    포화% |tau| 가 실효 한계 3.16 N·m 에 붙어 있는 시간 비율
    일률W |tau·omega| 합의 평균 [W]
    roll속 roll 각속도 RMS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
2026-08-20 fix(play): 녹화가 6방향 중 2.6개만 담기던 원인 — 종료가 벽시계였다
    사용자 보고: "record 할 때 6방향이 아니라 앞뒤만 녹화된다."
    `--hold` 는 **시뮬 시간**인데 `--seconds` 는 **벽시계**였다. 이 루프는 dt 에서
    남는 시간만 재우므로 렌더링이 dt(20 ms)를 넘으면 조용히 슬로모션이 되고,
    그때 두 단위가 어긋난다. 실측:
    요청 50 초 -> 2510 프레임
    실제 v73 1047 프레임 (20.9 초 시뮬) · v70 1196 프레임 (23.9 초)
    즉 녹화 중 실시간 배속이 0.42~0.48 배라 벽시계 50 초가 시뮬 21~24 초밖에
    안 됐다. hold 8 초 x 6 방향 = 48 초가 필요한데 STOP/전진/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
2026-08-20 docs: README 를 2026-08-20 현재로 — 목표 전환과 새 판정 지표 반영
    "지금 상황" 이 08-13 자였다. 그 사이 문제의 성격이 바뀌었다: 실기는 걷고,
    남은 것은 **어떻게 걷느냐**(피크 토크·효율·토르소 흔들림)다.
    바뀐 것:
    - 목표 우선순위를 새로 적었다. 추종 정확도는 더 이상 1 순위가 아니다
    - 새 판정 지표 3 개(포화% · 일률W · roll속)와 그 정의, 왜 피크 값 자체로는
    지표가 안 되는지(전 정책이 p99 3.16 으로 동일 = 한계에 상시 물림)
    - 새 지표로 다시 읽은 과거 판 비교표. v55(낙상 0.0 %)가 왜 다시 후보인지
    - 진행 중인 학습(v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
2026-08-20 docs: rewrite README in English
    Matched the tone of the upstream Open Duck repos: first person, short prose,
    code blocks, blockquote notes for the traps. Dropped the emoji status tables
    and most of the bold.
    Content is the same as the Korean version it replaces, minus the padding:
    current state, the reordered goals, the new scoring columns (sat% / W /
    roll rate), the results table, the list of things I got wrong by estimating
    instead of measuring, and the pipeline.
    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
2026-08-20 feat(v76): robustness — 랜덤화 폭만 넓힌다. 합격선도 새 목표로 교체
    v75 가 사용자 목표 1~4 번을 전부 최고로 잡았다 (model_2800, 93 % 지점 측정):
    토크 포화 0.20 % <- 역대 최저. p99 3.12 로 한계에 닿지도 않는 첫 정책
    일률 6.6 W <- 역대 최저 (v74 7.3)
    roll 속 46.2 <- 역대 최저 (v55 53.4)
    roll RMS 2.85 · 낙상 0.2 %
    6 방향 부호 전부 OK (전진 0.111/0.15 · 후진 0.145/0.15 · 회전 0.968/1.0)
    추종 점수 0.0275 는 v74(0.0140)보다 나쁘지만 기준이 "천천히라도 명령대로" 다.
    ## v76
    목표 5 개 중 명시적으로 남은 것은 robustness 하나뿐이라,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
2026-08-20 docs: 2026-08-20 진행상황 — v73~v76 과 목표 전환 기록
    training_log 에 오늘 판 네 개를 남긴다. 코드는 이미 올라가 있었지만 왜
    그렇게 했는지가 기록에 없었다.
    v73 큰 발. **전제가 틀려서** 실패했다 — 심이 딛는 면은 TPU 밑창이 아니라
    l_foot_side 이고 TPU 는 2.70 mm 위라 안 닿는다. 심의 좌우 지지는 이미
    38.7 mm 였고 "16 mm 칼날" 은 심에 존재한 적이 없다
    v74 v68 묶음(토크 -0.2 · 낙상종료 0.85 · σ1.3). 포화 1.18->0.31 %,
    일률 10.2->7.3 W. 예상했던 추종 대가가 안 나왔다 (앞뒤 0.0241->0.0070)
    v75 + torso_ang_vel -0.7. 목표 1~4 번 전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
2026-08-20 feat(v77): v76 재시도 — 외란은 되돌리고 바닥·서보 개체차만 넓힌다
    사용자가 v76 곡선을 보고 "수렴이 잘 안 된다" 고 했고, 재보니 맞았다.
    ## 리워드가 아니라 에피소드 길이였다
    iter 330 에서 항목별 리워드는 v75 의 85 % 로 멀쩡한데 총 리워드는 54 % 다.
    차이는 전부 에피소드 길이에서 났다:
    iter 100~150 v75 525 v76 301
    iter 300~350 v75 597 v76 351 <- 천장
    에피소드 351 스텝 = 7.0 초이고 v76 의 외란 간격이 3~8 초다. **첫 밀침에서
    그대로 넘어진다.** 걸음이 나빠진 게 아니라 일어설 기회를 못 얻었다.
    ## +-1.5 m/s 가 무리였다
    명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
2026-08-20 fix(odm): 재개가 조용히 무시되고 있었다 — hydra 오버라이드가 아니라 CLI 플래그
    `odm train <ver> <n> <envs> --resume` 이 체크포인트를 안 불러왔다. 오류도
    안 났다. 재개했다는 런이 std 1.3 · 리워드 0.17 · 에피 24 로 시작하는 것을
    보고 발견했다 — **처음부터 학습하고 있었다.**
    원인은 IsaacLab 의 cli_args.py:76 이다:
    if args_cli.resume is not None:
    agent_cfg.resume = args_cli.resume
    `--resume` 는 action="store_true" 라 기본값이 None 이 아니라 **False** 다.
    따라서 플래그를 안 주면 이 줄이 **항상 False 로 덮어쓴다.** odm 은
    `agent.resume=true` 를 hydra 오버라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
2026-08-21 docs: 2026-08-21 — 장기 학습이 크게 이득이고, 리워드는 그걸 못 잡는다
    ## 오늘 뒤집힌 판단 셋
    "3000 iter 면 수렴" -> 아니다. 리워드는 평평한데 지표는 계속 좋아진다
    "LPF 0.3 은 공짜 개선" -> 덜 학습된 정책에서만. 장기 학습이 대체한다
    "재개는 잘 되고 있다" -> 전부 조용히 처음부터 돌고 있었다 (f3a1768 에서 수정)
    ## 장기 학습 (v75, 2800 -> 11800)
    roll속 46.2 -> 31.0 -33 %
    rollRMS 2.85 -> 2.25 -21 %
    낙상 0.2 -> 0.0 %
    앞뒤 0.0228 -> 0.0092 -60 %
    회전 0.0320 -> 0.0148 -54 %
    옆 0.0370 -> 0.0429 +1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
2026-08-21 feat(diag): 6방향 토크·일률 그림. 목표가 바뀐 뒤 판정을 눈으로 볼 수단
    목표가 추종 정확도에서 토크·효율로 바뀌었는데 기존 그래프(plot_best.py)는
    속도 추종과 관절 궤적만 그린다. 판정에 쓰는 숫자를 볼 수단이 없었다.
    네 패널: 방향별 포화율 / 방향별 일률 / 관절별 p99 토크 / 착지에 맞춰 접은 일률.
    ## 그리면서 두 번 고쳤다 (규약대로 저장 후 직접 열어봤다)
    1. 처음엔 좌상에 p99 토크를 막대로 그렸더니 **여섯 방향이 전부 3.16 으로 같은
    높이**가 됐다. 규약 1 의 "신호가 납작해진다" 에 정확히 걸린다. 모든 정책이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
2026-08-22 feat(v78): path frame 을 버리고 heading 명령으로 방향을 닫는다
    BDX-R (github.com/BDX-R/BDX-R-IsaacLab) 를 보고 나온 설계다. 저쪽은 IsaacLab
    기본 UniformVelocityCommand 의 heading_command 를 쓰고 path frame 은 안 쓴다.
    ## 우리 path_tracking 은 실기에서 죽어 있었다
    `_path_error()` 가 관측에 넣는 [횡방향오차, cos, sin] 중 **횡방향은
    오도메트리가 있어야** 나온다. 실기에는 없어서 상수 [0,1,0] 이었다.
    그런데 이 항이 리워드의 **32 %** 다 — 3 분의 1 이 실기에 존재하지 않는
    정보로 학습됐다.
    ## 방위만 남기되, 관측이 아니라 명령에 넣는다
    yaw 명령 = clip(head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
2026-08-22 feat(v79~v81): v78 실패를 격리해서 다시 본다 + 자율 분기 큐
    ## v78 은 두 가지를 한꺼번에 바꿔서 원인을 못 가렸다
    회전 추종 0.0148 -> 0.4961 (33 배)
    turn 명령 1.00 -> 실제 0.504
    turn_half 명령 0.50 -> 실제 0.087 <- 방향 준수 실패
    roll속 31.0 -> 64.9 · 낙상 0.0 -> 0.9 %
    토크·일률만 좋아졌는데(포화 -24 %, 일률 -12 %) 그건 **덜 도니까 덜 쓴 것**이라
    이득이 아니다.
    가설: heading 모드의 yaw 명령은 clip(0.5 x 방위오차)라 목표에 가까워지면 0 으로
    수렴한다. 정책이 본 yaw 명령이 작은 값에 몰리고 "±1.0 rad/s 유지" 를 못 배운다.
    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
2026-08-23 feat(v82): 원인은 heading 이 아니라 path frame 이었다 — 횡방향만 뺀다
    대조군 v79 가 갈랐다. 회전 추종:
    v75 path frame 있음 0.0148
    v79 path frame 제거 (heading 없음) 0.2341 <- 16 배 악화
    v78 path frame 제거 + heading 0.5 0.4961 <- 33 배 악화
    **내 가설이 틀렸다.** v78 실패를 heading 탓으로 봤는데, heading 없이 path frame
    만 빼도 회전이 16 배 나빠진다. heading 은 거기에 2 배를 더했을 뿐이다.
    ## 왜 path frame 이 회전에 중요한가
    `reward_path_tracking` 의 방위 항은 `path_yaw` 대비 오차이고 `path_yaw` 는
    **yaw 명령의 적분**이다. 즉 회전 속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
2026-08-23 feat(diag): 측정 잡음 폭 재는 도구. 어느 차이까지가 잡음인지 정한다
    정책 비교가 소수점 둘째 자리에서 갈리는데(v75 낙상 0.00 % vs v81 0.88 %)
    **그 차이가 잡음인지 모른다.** 추종 점수는 같은 체크포인트를 두 번 재니 단일
    방향이 +-25 % 흔들린 전례가 있는데(v48, 0.0231 vs 0.0287), 2026-08-20 에
    새로 넣은 지표(포화율·일률·roll속·낙상률)는 아예 재 본 적이 없다.
    `noise_spread.py` 는 같은 체크포인트를 여러 번 잰 npz 들의 평균·표준편차·
    최대-최소·상대폭을 낸다. 그보다 작은 차이는 정책 차이로 읽지 않는다는 규칙을
    숫자로 세우기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
2026-08-26 fix: heading 명령이 **고정된 명령을 덮어써서** 측정이 오염됐다
    `gait_compare` 가 `u._command[:, 2] = 1.0` 으로 회전을 고정해도, 그 뒤 스텝
    안에서 `_apply_heading_command()` 가 heading 모드 환경의 yaw 를 방위 오차에서
    다시 계산해 덮어썼다. 그 환경들은 **명령한 회전을 아예 안 받는다.**
    증거: v81 같은 체크포인트 4 회에서 회전 실제값이 0.707 / 0.545 / 0.464 / 0.486
    (명령 1.0)인데, 큐가 냈던 단일 측정은 오차 0.0148 이었다. 잡음이 아니라
    heading 추첨 결과에 따라 갈린 것이다.
    **v78(50 %)·v81(20 %)의 회전 수치는 무효다.** v79 는 heading_command_prob = 0
    이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
2026-08-26 feat(diag): 반복 측정 결과를 한 장의 계측판 HTML 로
    `build_dashboard.py` 가 `~/odm_out/rep/<ver>_<i>.npz` 를 읽어 버전별 지표를
    막대로 그린다.
    ## 왜 표가 아닌가
    2026-08-24 에 잡음을 실측하니 같은 체크포인트에서 회전 오차가 11 배 흔들렸다.
    **값만 그리면 거짓말이 된다.** 그래서 모든 막대를 최소~최대 범위로 그리고
    평균을 세로선으로 얹었다 — 두 정책의 범위가 겹치면 그 차이는 읽지 않는다는
    규칙이 그림 자체에 들어가 있다.
    지표마다 신뢰도 딱지를 붙인다 (일률 높음 / 포화·흔들림 보통 / 추종 낮음).
    반복측정 폭에서 나온 값이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
2026-09-02 docs(kspe): 창의경진대회 중간보고서 본문과 본문 삽입용 그림 6종
    `scripts/diag/build_report_figs.py` 가 `~/odm_out/rep/` 의 반복 측정 결과와
    학습 로그에서 그림을 생성한다. 그림만 커밋하면 재생성이 안 되므로 스크립트를
    같이 넣는다.
    그림1 6방향 추종 평가 명령 대비 실측 속도
    그림2 학습 곡선 보상·에피소드 길이 (TensorBoard 캡처 대체)
    그림3 성능개선 비교 4지표 막대 + 3회 측정 최소~최대 오차막대
    그림4 측정 재현성 지표별 흩어짐
    그림5 관절별 피크 토크 무릎만 한계 도달
    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
2026-09-15 fix(v83): v73~v82 는 전부 실물에 없는 big_foot 으로 학습됐다 — 원래 발로 재학습
    v75 를 실기에 올렸더니 v65 보다 못 걸었다. 원인을 찾던 중 사용자 확인으로
    드러났다: **실물에는 big_foot 을 달지 않았다.**
    각 런의 params/env.yaml 로 USD 를 대조한 결과:
    v60~v71 open_duck_mini_v2.usd (원래 발, 실물과 일치)
    v73~v82 open_duck_mini_v2_bigfoot.usd (9 개 전부, 실물에 없음)
    v73 이 심 실험용으로 big_foot 을 도입했고, 이후 토크·토르소·robustness·
    heading 작업(v74~v82)이 전부 그 위에 쌓였다.
    ## 왜 심 측정이 못 잡았나
    심에서 v75 는 모든 목표 지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
2026-09-16 feat(v84): 실측 질량 2894 g 반영 — 142 g 을 몸통 무게중심에 추가
    실물(big_foot 장착)을 처음으로 저울에 올렸더니 2894 g 이었다. 모델은
    2751.8 g 으로 **142.2 g(+5.2 %) 가볍다.** 실측 질량은 오래 미뤄 둔 항목이었다.
    ## 무엇을 바꿨나
    big_foot/robot_m2894.urdf 를 새로 만들었다. 원본과 다른 줄은 둘뿐이다:
    trunk_assembly mass 1.15295 -> 1.295168 kg (+142.218 g)
    trunk_assembly inertia x1.12335 (질량비, 회전반경 유지)
    trunk_assembly origin 그대로 (-64.0, 0.3, 42.3 mm)
    사용자 지시대로 몸통의 **기존 무게중심**에 더했다. 142 g 의 실제 분포를 재지
    않은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
    [robot_m2894.urdf]
2026-09-16 feat(rl_walk): --lean-back DEG — 재학습 없이 몸통을 뒤로 젖혀 걷게 한다
    실기가 전부 앞으로 넘어졌다. 실물 무게중심이 정책이 학습한 위치보다 앞에 있기
    때문이다. 사용자 제안("보행 시 몸통을 뒤로 기울이는 보정항")을 배포 단계에서
    구현했다.
    ## 방식: IMU 가 앞으로 기울어 달린 것처럼 관측을 돌린다
    imu.read() 직후 gyro·accel·grav 세 벡터에 같은 회전 R_y(deg)^T 를 곱한다.
    정책은 자기가 앞으로 숙였다고 판단하고 **스스로 몸통을 뒤로 젖힌다.**
    관절 목표에 직접 오프셋을 더하지 않은 이유: 폐루프 정책이 관절각을 관측하고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
2026-09-16 feat(v85~v87): v65 에서 분기 — 심 CoM 방향 세 가지를 실기로 판정한다
    사용자가 보행 중 로봇 뒷부분을 손으로 눌렀더니 잘 걸었다. 사용자 판단:
    "무게중심이 뒤로 가게 학습해야 할 것 같다. v65 에서 분기."
    ## 방향에 대한 반론 — 그래서 세 판을 같이 돌린다
    뒤를 누르면 **실물**의 무게중심이 뒤로 간다. 그게 잘 걸었다는 건 실물이
    정책 기대보다 앞쪽이 무겁다는 뜻이다. 그런데 **심** 무게중심을 뒤로 옮기면
    정책은 뒤가 무거운 로봇을 버티려고 앞으로 숙이는 법을 배운다. 실제로
    v70 이후(심 CoM 뒤 10 mm) 정책이 전부 앞으로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
2026-09-16 fix(registry): v83~v87 이 _BIG_NET_TASKS 에 빠져 재생이 다른 크기 망을 만들었다
    v85 학습은 끝났는데 측정과 녹화가 둘 다 죽었다:
    size mismatch for mlp.0.weight: checkpoint [512, 107], current model [256, 107]
    학습(`odm train` -> train.py)은 __init__.py 의 gym 등록 러너(Gamma097,
    512-256-128)를 따르고, 측정·재생은 task_registry.runner_cfg_for 를 따른다.
    runner_cfg_for 는 _BIG_NET_TASKS 에 있어야 Gamma097 을 돌려주는데,
    v83~v87 을 추가한 스크립트의 문자열 치환이 일치하는 곳을 못 찾고 **오류 없이
    넘어갔다.** 그래서 재생만 기본 망(256-128-64)으로 만들어졌다.
    v83·v84 는 Expl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
2026-09-16 fix(odm): Isaac 실행 판정을 명령줄 글자가 아니라 프로세스 이름으로
    v86 학습이 04:34 에 끝났는데 큐가 04:50 까지 "Isaac 실행 중" 으로 오판하고
    기다리고 있었다. 실제 GPU 연산 프로세스는 없었다.
    ## 원인
    gpu_busy 가 `pgrep -f "pytho[n].*_isaaclab_launch\.py"` 로 **명령줄 글자**를
    봤다. [n] 문자 클래스는 정규식 자신과의 매칭만 피한다 — 명령줄에 진짜
    "python3 ... scripts/_isaaclab_launch.py" 가 **글자로** 들어 있으면 그대로 걸린다.
    그런 셸이 하나 있었다. 02:49 에 v85 재실행 스크립트를 heredoc 으로 만들어 띄운
    bash -c 가 2 시간 넘게 살아 있었고,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
2026-09-16 docs(log): 09-17 — 실물 사양 재정렬, v85~v87 심 CoM 방향 A/B 결과
    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
2026-09-17 feat(v88): v86 과 같고 심 CoM 만 앞으로 25 mm
    실물 사양(big_foot 2894 g), v65 분기. v86(앞 15 mm)과 나란히 놓고
    앞쪽 이동량을 키웠을 때 실기에서 나아지는지 본다.
    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
2026-09-17 docs(log): v88(앞 25 mm) 측정 결과
    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
2026-09-17 feat(v89/v90): 전진 전용(CoM +30) + 후진 전용(CoM +15), 횡방향 관측 0, LPF 0.7
    v88 실기: LPF 0.7 에서 가장 잘 걸었고, 후진에서 뒤로 넘어지고,
    스로틀을 당기면 옆으로 조금씩 샜다.
    - path_lateral_obs_zero: 횡방향 path 오차 칸을 남긴 채 0 을 넣고 리워드에서
    뺀다. 실기(rl_walk)는 오도메트리가 없어 늘 0 을 보낸다 — 심에서만 옆 샘을
    바로잡던 신호를 없앤다. 관측 107 차원 유지라 ONNX·rl_walk 무변경.
    - v89: 전진 전용 (vx 0~0.15), CoM +30 mm, LPF 0.7 을 학습에 포함
    - v90: 후진 전용 (vx -0.15~0), CoM +15 mm, 나머지는 v89 와 같다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
2026-09-17 feat(rl_walk): --onnx-back 후진 정책 전환, --path-yaw-clip 방위 오차 끈
    - --onnx-back: vx < -0.02 에서 후진 정책으로, vx > -0.005 에서 돌아온다
    (히스테리시스). READY·스케일·LPF 가 다르면 실행을 거부한다.
    로그 끝에 policy_back 열을 붙였다.
    - --path-yaw-clip: --path-imu 방위 오차를 ±RAD 로 묶는다. 실기 회전이
    명령보다 느리면 오차가 쌓여 ±π 에서 부호가 뒤집히는 것을 막는다.
    기본 0(끔)이라 기존 동작은 그대로다.
    - scripts/diag/yaw_report.py: 실기 로그에서 전진 중 방향 변화와 회전
    비율·오차 최대·부호 뒤집힘을 뽑는다. 옆 샘이 휨인지 횡이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
2026-09-17 docs(log): v89/v90 전진·후진 분리 결과와 v88 실기 증상 정리
    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
2026-09-18 feat(v91/v92): 마찰 0.5~1.0 -> 0.25~0.8 (v88/v89 와 그것만 다르다)
    사용자: "88 번 할 때 조금씩 미끄러지는 것 같다." 지면이 1.0 고정이고 결합이
    multiply 라 실효 마찰이 곧 이 범위인데, v65 계열은 0.5 아래를 겪지 않는다.
    천장도 0.8 로 내려 잘 붙는 바닥을 가정하지 못하게 한다.
    scripts/diag/pitch_drift.py: 실기 로그에서 보행 중 앞뒤 기울기가 시간에 따라
    쏠리는지 본다. IMU 융합값과 생가속도로 각각 기울기를 내고, 둘의 차이가 벌어지면
    BNO055 내부 적분이 흐른 것이다. 속도를 함께 회귀해 속도 효과를 분리한다.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
2026-09-18 feat(rl_walk): 직전 실기 로그를 ~/rl_logs 에 보관 (최근 20개)
    2026-09-18 에 v89 실기 로그를 잃었다. 다음 실행이 같은 파일을 덮어써서
    회전 중 넘어진 판의 기록이 사라졌다. 증상을 보고 로그를 찾는 순서라
    덮어쓰기는 늘 한 판 늦는다. 이름은 그 실행의 시작 시각과 정책 폴더명.
    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
2026-09-18 fix(v91/v92): 마찰 0.25~0.8 -> 0.25~0.6, 처음부터 다시
    사용자 지시. 천장을 0.6 까지 내리면 모든 환경이 지금(0.5~1.0)보다 미끄럽다.
    0.25~0.8 로 1120 iter 돌던 런은 지우지 않고 이름만 바꿔 뒀다
    (2026-09-18_12-31-24_imitation_v91_aborted_fric025_08).
    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
2026-09-18 feat(odm): --fric 으로 측정 때 마찰 범위를 덮어쓴다
    정책마다 자기가 학습한 바닥에서 재면 미끄러운 바닥으로 학습한 판이 더
    미끄러진 것으로 나온다. "미끄러운 바닥에서 어느 정책이 나은가" 는 같은
    바닥에서 재야 답이 나온다. ODM_LPF 와 같은 방식으로 env_cfg_for 한 곳에서만
    적용한다.
    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
2026-09-18 docs(log): v91/v92 와 같은 바닥 교차측정 — v92 가 v89 의 회전 붕괴를 막는다
    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
2026-09-19 fix(hw): 젯슨에서 직접 고친 것을 리포로 가져온다 (2026-09-18 실기)
    젯슨 사본이 리포보다 앞서 있었다. 덮어쓰지 않고 그대로 가져온다.
    - SyncRead 타임아웃 재시도(2회). 응답이 아예 없으면 RuntimeError 로 런이
    통째로 죽었다 — 18.1 초까지 걷던 런이 패킷 하나로 끝났고 그때 전압은
    11.0 V 로 정상이었다. 손상 응답(6회)과 예산을 나눈 이유는 타임아웃 한 번이
    컨트롤러 timeout 50 ms 를 통째로 쓰기 때문이다
    - 느린 읽기 두 개의 위상 분리(VOLT 0 / HW_ERR 12). 둘 다 주기 25 라 같은
    스텝에 겹쳐 0.53 초마다 dt 46 ms 가 났다(평소 20.2 ms).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
    [rl_walk.py, rustypot_hwi.py]
